zhaoyunfengntzx-maker/fpga-smr-encoder/deliverables/submission/photos/README.md

# 作品实物照片（报名系统第 6 / 7 项）

- **拍摄**：2026-11-03 20:02（Asia/Shanghai），手机直出；原图在仓库根目录 `照片/`。
- **处理**：按 EXIF 方向转正（`04` 原图为横向存储 + 方向标签 6，已转成 6048×8064 竖幅）、
  去除全部元数据（无 GPS / 机型 / 时间戳等）、JPEG 质量 90 重编码；四张均保留原分辨率，均 ≤ 10 MB。
- **匿名**：画面内无学校、院系、姓名、学号等信息；「正点原子 / ALIENTEK / HSEDA / NAN YA」
  为器件与开发板丝印，属技术描述。
- **用途**：报名系统第 6 项「作品全貌图（JPG/PNG，≤10 MB，×1）」、第 7 项
  「开发板重要角度照片（JPG/PNG，≤10 MB，≤4 张）」。

| 文件 | 拍的是什么 | 分辨率 | 大小 | 对应表单 | SHA-256 |
|---|---|---|---|---|---|
| `01_overview_full.jpg` | **作品全貌**：转台夹具（电机 + 联轴器 + SMR 传感头）、模拟前端与驱动板、AD9238 扩展板 + FPGA 板、7 英寸屏、示波器、上位机；桌面整体一景 | 8064×6048 | 7,222,120 B / 6.89 MB | 第 6 项 | `F6A81D40E63537F802C36E7D8EA9781AE0E28D6D3E759FB11FD3573F5005B7B9` |
| `02_board_adc_frontend.jpg` | **ADC / 模拟前端**：AD9238 双通道 12-bit 扩展板（SMA `CH1` / `CH2`、AD8130 差分放大、2.0 V 基准与去耦），叠插在 FPGA 板上，可见 `J6` 排针与 5 V 供电 | 4032×3024 | 2,346,047 B / 2.24 MB | 第 7 项 ① | `AC152A91AAE1D8A08DE3BFBF29F463F2F030487DF8F7769E14C130B4BBF6582F` |
| `03_board_front.jpg` | **FPGA 板正面**：「达芬奇_Lite」丝印、`RGB_LCD` 排线座、`J5` / `J6` 排针、`JTAG`、`USB_UART`、SD 卡座、以太网口（ATK91131A）、NAN YA DDR3 | 4032×3024 | 1,974,279 B / 1.88 MB | 第 7 项 ② | `C673B01C8EED0D9B58C3C8125B8E3833688FA4285391FB1B8CACD225A268D446` |
| `04_board_screen.jpg` | **屏与触摸**：7 英寸 1024×600 面板与板卡同框，屏上为 **P1 总览** 实时页面（读数见下） | 6048×8064 | 9,238,822 B / 8.81 MB | 第 7 项 ③ | `B5C65D8A6B158C1BF400CDA201EDA9C603385E8691513DD0F899C4A209F331EF` |

四张即第 7 项要求的全部角度（正面 / ADC 与模拟前端 / 屏与触摸），名额上限 4 张已满足，
不再补拍其他角度。

## 屏上读数（`04` 现场快照，P1 总览）

| 字段 | 读数 |
|---|---|
| 输入频率 | 22.30 kHz（正常） |
| 倍频分频 | ×64 ÷1（等效倍率，正常） |
| 转速 | 653.1 RPM（正常） |
| 角度 | −32.6 DEG |
| 方向 / 累计转数 | CCW / 3015 REV |
| ABZ / UVW 指示 | A 有效、B / Z 未点亮，状态正常 |
| POS | 0X 14DA25DA |

自洽性检查：22.30 kHz ÷ 2048（电周期/圈）× 60 = **653.3 RPM**，与屏上 653.1 RPM 相差 0.03%，
说明频率与转速出自同一路 sin/cos 计数，不是分别写死的数。

> 口径提醒：以上只是拍摄当天的**屏上快照**，用来证明照片是真实上电现场；报告里的转速指标
> 以 v90 的 Z 频率判据为准（**457–459 rpm**），既不引用旧版电周期折算读数，也不把这张照片的 653.1 RPM 当指标。

## 报告里怎么用

`deliverables/figures/` 下另有四张按报告版面缩放的同源图（`photo_overview.jpg`、
`photo_adc_frontend.jpg`、`photo_board_front.jpg`、`photo_screen_p1.jpg`），供
`design_report.docx/pdf` 正文 3.1 与 3.2.2 的照片引用；上传报名系统时用本目录的原分辨率版本。
