zhaoyunfengntzx-maker/fpga-smr-encoder/docs/27_turntable_requirements_feasibility.md

# 27 转台正余弦编码器信号处理 —— 需求整理与可行性分析

> 版本：**v1.2（2026-10-28）**，**S1 已完成（RTL 已改，仿真 29/29 + v63 实现通过）**，S2 起待你确认
> 工程基线：v63 位流 `_impl_v63/enc_top_v63.bit`（top = `enc_top`）；v62 交付位流保持不动可回退
> 标记约定：**【确认】**= 你原话；**【假设】**= 我根据工程现状推断，需你确认；**【待确认】**= 必须你给数

---

## 0. 一句话结论

**可行，而且路径比想象中短**：现有 v62 已经具备"12 bit 同步采样 → 六参数校正 → 16 bit 流水 CORDIC → PI 环路 → ABZ/UVW"的全链路，50 kHz 电气频率相对已验证的 700 kHz 带宽有 **14 倍余量**，算角度本身不是难点。

**真正的难点只有三个**，都不在"算角度"上：

1. **变频段的滤波一致性**——转速从 0 到最高，滤波器带宽若固定，相位滞后（以电角度计）会随转速剧烈变化，标定补偿全部失效；
2. **偏置/增益的长期漂移**——一次性标定在温升 20 ℃ 后会退化，尤其前端是"单端 0.5 Vpp → 放大 16 倍"这种小信号高增益结构；
3. **异常状态下的可控性**——上电静止、信号丢失、削顶、反转抖动、失锁，必须有明确状态机与输出策略，否则多圈计数会跑飞。

外加一个**反直觉但很关键**的结论（见 §4.5）：当 PPR=2048 时，机械 1″ 只对应电角度 0.57°，**FPGA 细分精度根本不是瓶颈**，传感器刻度误差与安装偏心才是。所以"做到完美"的投入应该压在**标定 + 鲁棒性**，而不是再加 CORDIC 位宽。

---

## 0.5 已确认参数基线（2026-10-27）

| 项 | 确认值 | 推论 |
|---|---|---|
| 传感器周期数 | **2048 周期/转** | 1 电周期 = 0.1758° 机械；16 bit 细分 = **0.0097″/LSB** |
| 传感器输出 | 每腿对地 **0.5 Vpp**，A/A− 差分共 **1 Vpp** | 与 EI58C9 文档口径一致（差分 = 每腿 ×2） |
| 放大模块 | 差分转单端，G = 8 → **8 Vpp 单端** | 8/1 = 8 倍差分增益；ADC 侧 1638 码 |
| 直流偏置 | **以 0 V 为中心，正负对称** | ✅ 最理想，无单侧削顶；但削顶余量仍只有 1.25× |
| 最高电气频率 | 50 kHz | = **1465.9 rpm**（50 k / 2048 × 60） |
| 最高转速 | 1000–3000 rpm | ⚠️ **3000 rpm 对应 102.4 kHz**，与"50 kHz"差 2 倍，见下 |
| 精度目标 | **±1″ 机械（峰峰值）** | 必须上全周补偿表 + 外部基准（见 §4.5） |
| 用途 | 闭环伺服反馈 **+** 上位机记录 | 双路输出：主路低延迟、旁路高精度 |

### ⚠️ 0.5.1 一处必须澄清的不自洽

2048 PPR 时：`f_el(Hz) = rpm × 2048 / 60`

| 转速 | 电气频率 | vs "50 kHz" |
|---|---|---|
| 1000 rpm | 34.1 kHz | — |
| **1465.9 rpm** | **50.0 kHz** | 你给出的上限对应的转速 |
| 3000 rpm | **102.4 kHz** | **超出 2 倍** |

**处理方式（建议，已按此设计）**：**按上限 100 kHz 设计**。代价为零——50 MSPS 下 102.4 kHz 仍有 **488 点/周期**，前端 700 kHz 带宽也放得下；收益是无论你实际是 1465 还是 3000 rpm 都不会翻车。唯一要改的是抽取档位上限（见 §4.2 A）与 ABZ 分频约束。

---

## 1. 现状盘点（这次适配的起点）

### 1.1 信号链

```
 传感器（待确认）
   A/A−  B/B−  每腿 0.5 Vpp?  差分 1 Vpp?
        │
        ▼
 差分转单端放大模块（你的板子）  G = 8 ?
        │  8 Vpp 单端、对地、中心 0 V?
        ▼
 HSEDA AD9238 模块：分压 ÷5 → AD8065 缓冲 → AD8138 单端转差分 → AD9238 12 bit
        │  输入量程 ±5 V（10 Vpp），1 LSB = 2.44 mV，无抗混叠滤波
        ▼
 FPGA：50 MSPS 同步采样 → 抽取(LOG2DEC=2) → sc_correct 六参数校正
        → cordic_atan2 (16 bit, NITER=17) → loop_filter(PI) → pole_counter
        → abz_gen / uvw_gen / uart_scope
```

### 1.2 现有能力（可直接复用）

| 项 | 现状 | 对本次任务的含义 |
|---|---|---|
| 采样 | 50 MSPS，双通道同一时钟 | 50 kHz 时 **1000 点/周期**，余量充足 |
| 输入带宽 | 已验证 1 kHz–500 kHz 扫频 | 50 kHz 只用了 1/14 带宽 |
| 角度 | 16 bit/电周期，CORDIC max 0.94 LSB | 机械分辨率 = 360°/(65536·PPR) |
| 校正 | 六参数闭式（偏置×2、增益×2、正交、旋转） | 20.98° → 0.0165°（模型） |
| 环路 | PI，kp/ki 寄存器可调，21 组全稳定 | 可做增益调度 |
| 输出 | ABZ / UVW / SPI / UART / 以太网 | 转台一般要 ABZ 或差分增量 |
| 延迟 | ≈830 ns（预算值） | 伺服反馈完全够 |
| 资源 | LUT 82.0%、BRAM 46/50、DSP 18 | **BRAM 几乎见底**，加 LUT 要腾地方 |

### 1.3 这次"新"在哪里

| 维度 | 之前（信号源/磁环） | 现在（转台） | 影响 |
|---|---|---|---|
| 信号源 | AFG-2225 双通道，幅度稳定 | 真实传感器，随温漂/转速变化 | 标定不能一次了事 |
| 频率 | 手动设定 | 0…50 kHz 连续变化，还有波动 | 滤波器必须自适应 |
| 幅度 | 可调到 10 Vpp | 固定 8 Vpp 左右，有波动 | 只剩 25% 削顶余量 |
| 极性/相位 | 理想 90° | 有正交误差、谐波、偏置 | 需要更细的误差模型 |
| 机械 | 无 | 偏心、振动、PWM 干扰 | 需要状态机与故障诊断 |

---

## 2. 需求整理

### 2.1 功能需求（FR）

| 编号 | 需求 | 来源 | 现状 |
|---|---|---|---|
| FR-01 | 采集 sin/cos 正交信号并解算单周期内电角度 | 【确认】 | 已有 |
| FR-02 | 偏置补偿、幅值均衡、正交误差校正 | 【确认】 | 已有（六参数） |
| FR-03 | 抑制信号非线性误差（谐波） | 【确认】 | **缺**（六参数只到 2 次谐波） |
| FR-04 | 流水线 CORDIC 相位解算 | 【确认】 | 已有 |
| FR-05 | 粗精角度融合（周期计数 + 周期内角度） | 【确认】 | 已有（pole_counter + CORDIC） |
| FR-06 | 辨向计数、多圈累计 | 【确认】 | 已有（16 bit） |
| FR-07 | 位置、速度实时输出 | 【确认】 | 位置有；**低速速度需补** |
| FR-08 | 数字滤波，适应频率波动 | 【确认】 | **固定抽取，需改自适应** |
| FR-09 | 上电自检、信号丢失/削顶/失锁诊断 | 推断【假设】 | 部分（amp_monitor/OTR） |
| FR-10 | 参数在线配置与掉电保存 | 推断【假设】 | 寄存器有，掉电保存无 |
| FR-11 | 绝对零点（Z 索引）与 PPR 自适应 | 推断【假设】 | **Z 未接**，虚拟 Z |
| FR-12 | 与上位机/驱动器的实时接口 | 【确认】 | ABZ / SPI / 以太网已有 |

### 2.2 性能需求（PR）——**空缺项必须你给数**

| 编号 | 指标 | 目标值 | 状态 |
|---|---|---|---|
| PR-01 | 传感器周期数 PPR | **2048 周期/转** | ✅ 确认 |
| PR-02 | 最高电气频率 / 转速 | **按 100 kHz 设计**（1465 rpm 对应 50 kHz，3000 rpm 对应 102.4 kHz） | ✅ 确认，按严者设计 |
| PR-03 | 最低平稳转速 | ? rpm 或 ? °/s | **TBD** |
| PR-04 | 角度分辨率（机械） | 16 bit × 2048 = **131072 点/转 = 0.0097″/LSB** | ✅ 可算 |
| PR-05 | 角度精度（机械，峰峰值） | **±1″** | ✅ 确认（关键目标） |
| PR-06 | 速度分辨率 / 带宽 | 闭环带宽 ? Hz，低速纹波 ? | **TBD** |
| PR-07 | 位置更新率 / 延迟 | SPI 读位置 ≥50 kHz 帧率；延迟 ≤1.5 µs | 推断 |
| PR-08 | 幅值波动范围 | 8 Vpp ±? %（**决定削顶余量**） | **TBD，优先测** |
| PR-09 | 工作温度 | ? ℃ | **TBD** |
| PR-10 | 连续运行稳定性 | ? h 无失锁、无多圈跳变 | **TBD** |

> **PR-05 = ±1″ 已确认**，这是"必须上补偿表"的判据。但请先读 §4.5 的结论：**±1″ 的瓶颈不在 FPGA，而在"有没有 ±0.5″ 级的标定基准"**。

### 2.3 接口需求（IR）

| 编号 | 需求 | 说明 |
|---|---|---|
| IR-01 | 位置输出协议 | ABZ（推荐）/ SPI 寄存器回读 / 自定义 |
| IR-02 | 速度输出 | 同一协议内，或独立模拟/总线 |
| IR-03 | 配置接口 | SPI / UART（现有） |
| IR-04 | 调试观测 | UART 遥测、以太网抓包（现有） |
| IR-05 | 与伺服驱动器的电气接口 | RS-422/485 收发器？光耦？**TBD** |

### 2.4 环境与可靠性（ER）

| 编号 | 需求 | 说明 |
|---|---|---|
| ER-01 | 电机 PWM 干扰抑制 | 差分走线、屏蔽、模拟 LPF、必要时同步采样 |
| ER-02 | 上电/掉电/热插拔 | 输出保持或安全态，多圈计数不跑飞 |
| ER-03 | 断线/短路检测 | 幅值窗口 + 偏置窗口 |
| ER-04 | 温漂 | 偏置/增益后台跟踪 |
| ER-05 | EMC | 前端共模扼流、单点接地 |

### 2.5 约束与假设

| 编号 | 内容 |
|---|---|
| AS-01 | 【假设】传感器为增量式正余弦编码器，A/A−、B/B− 差分，每腿 0.5 Vpp，差分 1 Vpp |
| AS-02 | 【假设】PPR = 2048（沿用 EI58C9 的接入经验；若不同，全部数字按比例缩放） |
| AS-03 | 【假设】"8 Vpp"是放大模块输出、对地、以 0 V 为中心（**待确认，这是最大风险点**） |
| AS-04 | 【假设】继续用 AD9238 模块（±5 V 单端输入、无 AAF），不换硬件 |
| AS-05 | 【假设】FPGA 仍为 XC7A35T，50 MHz 单时钟，不改时钟架构 |
| AS-06 | 【假设】转台需要"位置 + 速度"给伺服或上位机，且要能长期连续运行 |

---

## 3. 信号链预算（把"能不能"算清楚）

### 3.1 电平与码值

| 项 | 数值 | 说明 |
|---|---|---|
| ADC 满量程 | ±5 V 单端（10 Vpp） | 模块分压 ÷5 后进 AD8065 |
| 输入 8 Vpp | ±4 V | 占满量程 **80%** |
| 峰值码值 | 4 V / 2.44 mV = **1638 码** | 理论 ±2048 |
| 码值动态范围 | 20·log10(1638/0.289) ≈ **72 dB** | 等效 ~11.7 bit |
| 削顶余量 | 10/8 = **1.25×（+1.9 dB）** | 幅值涨 25% 就削顶 |
| 建议 | 7.0–8.0 Vpp，且必须实测 DC 偏置 | 见风险 R1 |

### 3.2 频率与采样

| 电气频率 | 每周期采样点（50 MSPS） | 抽取 4 后 | 每点电角度 |
|---|---|---|---|
| 1 kHz | 50,000 | 12,500 | 0.0072° |
| 10 kHz | 5,000 | 1,250 | 0.072° |
| 50 kHz | **1,000** | **250** | **0.36°** |

50 kHz 时仍有 250 点/周期，**采样不是瓶颈**。瓶颈在 ABZ 边沿率：`4×inter×f_in ≤ 12.5 MHz` ⇒ 50 kHz 时 `inter ≤ 32`；若走寄存器/遥测读 16 bit 角度，则不受此限。

### 3.3 电气角度 → 机械角度（**全篇最重要的换算**）

$$\varepsilon_{mech}(″) = \frac{\varepsilon_{el}(°) \times 3600}{PPR}$$

| PPR | 1″ 机械对应的电角度 | 0.1° 电角度对应的机械误差 |
|---|---|---|
| 1024 | 1.14° | 0.35″ |
| 2048 | **0.57°** | **0.18″** |
| 4096 | 0.28° | 0.09″ |
| 2500 | 0.47° | 0.14″ |

**含义**：PPR 越高，对"电角度精度"的要求越松。2048 时，电角度做到 0.5° 就够 1″ 机械精度——而当前 CORDIC 是 0.005° 级，**过剩 100 倍**。

### 3.4 延迟预算（50 kHz 时 1 µs = 18° 电角度）

| 环节 | 延迟 |
|---|---|
| ADC 采样 + 捕获 | 1–2 拍（40 ns） |
| 抽取（N=4…64） | 2…64 拍（40 ns…1.28 µs） |
| 校正 | 3 拍（60 ns） |
| CORDIC | 17 拍（340 ns） |
| 环路 + 输出 | ~5 拍（100 ns） |
| **合计** | **≈0.6–1.8 µs** |

对 100 Hz 伺服带宽，1.8 µs 相移 0.065°，可忽略；对位置精度，可用测速值做 `ω·τ` 前馈补偿。

---

## 4. 可行性分析

### 4.1 总判断

| 维度 | 判断 | 依据 |
|---|---|---|
| 采样与算力 | ✅ **富余** | 50 kHz vs 700 kHz 已验证带宽；CORDIC 吞吐 1 点/拍 |
| 电平接口 | ⚠️ **可行但余量小** | 8 Vpp/10 Vpp = 80%，削顶余量仅 25% |
| 细分精度 | ✅ **过剩** | 见 §3.3，机械精度不由细分决定 |
| 变频适应 | ⚠️ **需新增** | 现有抽取固定，环路增益固定 |
| 长期精度 | ⚠️ **需新增** | 一次性标定无法跟踪温漂 |
| 异常处理 | ⚠️ **需新增** | 缺统一状态机 |
| 资源 | ⚠️ **紧** | BRAM 46/50，LUT 82% |
| 工期 | ⚠️ **紧** | 若赶 11-04，只能做最小闭环 |

**结论：技术路线成立，风险集中在"模拟前端余量"与"自适应/诊断逻辑的新增工作量"，不在算法本身。**

### 4.2 六个关键难点与对策

#### A. 变频段的滤波一致性（最难，也最容易被忽略）

**机理**：固定带宽 LPF 的群延迟 τ 是常数（秒）。角度误差 = ω·τ，随转速线性增大；同时噪声抑制随频率变化。结果是"低速很干净但高速滞后 18°，或高速跟得上但低速噪声大"。

**对策（三层，按代价从低到高）**：

1. **归一化抽取**：让每周期采样点数近似恒定，`N = clamp(round(fs/(K·f_est)), 4, 64)`，K≈64–128。箱形平均对 sin/cos 同相，不引入正交误差，只引入与 N 成正比的群延迟（可测、可补偿）。代价：N 切换瞬间有相位台阶，需在过零/匀速段切换或做交叉淡化。
2. **环路增益调度**：`kp/ki` 随 |速度| 分段切换（低速重滤、高速轻滤），保持"电角度滞后"恒定。现成寄存器就能做，代价最小。
3. **速度前馈补偿**：用测速值把 `ω·τ` 从输出角度里减掉，等价于零延迟。需要准确 τ（可标定）。

> 推荐组合：**1（粗调，4/8/16 三档）+ 2（细调）+ 3（补偿）**，不要一上来做分数延迟重采样。

#### B. 偏置/增益漂移

**机理**：0.5 Vpp/腿 的小信号被放大 16 倍，前端偏置漂移被同倍放大。偏置 d（相对幅度）造成的角度误差 ≈ d rad。d=1% ⇒ 0.57° 电角度 ⇒ 2048 PPR 时 1.0″ 机械。温升 20 ℃ 漂 10 mV（相对 0.25 V 幅度 = 4%）⇒ 4″，**足以吃掉全部精度预算**。

**对策**：
- 上电/停机时自动重标定（现有 calib_ctrl 已支持一键标定，扩展为"条件触发"）；
- 运行中**只跟踪偏置**（2 参数 LMS，时间常数 5–30 s），增益/正交保持标定值；
- 加速段、过零段冻结自适应，避免把"真实运动"学成"偏置"；
- 用 `amp_monitor` + OTR 做"标定有效性"看门狗：幅值/偏置超窗 ⇒ 标定失效标志。

#### C. 正交/增益/谐波误差

- 正交与增益失配：六参数已覆盖（2 次谐波），残差 <0.1″（2048 PPR）。
- **3/5/7 次谐波**：来自传感器磁场谐波与探测器非线性，六参数**无法**消除，表现为 4/6/8 次/转的周期性误差，典型 0.1–1° 电角度 ⇒ 0.2–2″ 机械。
- 对策：**角度域误差补偿表**（LUT）。1024 点 × 16 bit 只需 ~16 Kb，可放分布式 RAM（约 256 LUT），不必抢 BRAM；标定需要一个外部基准（见 R6）。

#### D. 低速测速

**机理**：16 bit 角度在 2048 PPR 下，1 LSB = 0.0097″ 机械。10 kHz 更新时，1 LSB/帧 = 0.097″/10 ms = **9.7″/s**——低速时速度量化粗到不可用。

**对策**：M/T 法（测周期 + 测脉冲数）+ 长窗口 + 与环路速度融合；明确"最低平稳转速"指标（PR-03），低于该转速只保证位置不保证速度纹波。

#### E. 启动 / 失锁 / 故障

必须新增**统一状态机**：

```
POR → 自检 → 搜索（等幅值有效） → 捕获（等相位锁定） → 跟踪
                                   ↑                    │
                                   └── 失锁 ←───────────┘
                                          ↓
                                    故障（幅值/削顶/超速/正交异常）
```

要点：
- 静止时 sin/cos 是直流，atan2 仍有输出但无意义 ⇒ **必须用幅值门限判定"信号有效"**，无效时输出保持 + 有效位=0；
- 多圈计数只在"跟踪"态累加，故障态冻结；
- 反转过零附近加迟滞，避免抖动计数（abz_gen 已有滞后逻辑，需推广到 pole_counter）。

#### F. PWM 干扰与模拟前端

- 模块**没有抗混叠滤波器**，电机 PWM（8–20 kHz）及其谐波直接进 ADC；
- 对策：前端加二阶 RC/有源 LPF（截止 200–300 kHz，不影响 50 kHz 基波）、双绞屏蔽、单点接地；数字侧可在 PWM 频率做陷波，但 PWM 频率若可变则不牢靠——**优先在模拟侧解决**；
- 若驱动器能给出 PWM 同步信号，可用"PWM 中心对齐采样"把开关噪声搬到采样零点，这是最彻底的办法（需硬件引入同步信号）。

### 4.3 模块级适配清单

| 模块 | 现状 | 需要做的改动 | 工作量 | 风险 |
|---|---|---|---|---|
| `rtl/ad9238_capture.v` | 50 MSPS 捕获 | 不改 | — | 低 |
| `rtl/decim_avg.v` | 固定 LOG2DEC | 增加运行时可变 N + 平滑切换 | 中 | 中 |
| `rtl/sc_correct.v` | 六参数 | 参数可在线更新；加偏置慢跟踪 | 中 | 中 |
| `rtl/calib_ctrl.v` | 一次性闭式标定 | 条件触发/周期重标定；失败重试与有效性判据 | 中 | 中 |
| `rtl/cordic_atan2.v` | 16 bit，0.94 LSB | 不改 | — | 低 |
| `rtl/loop_filter.v` | 固定 kp/ki | 增益调度（按速度分段） | 低 | 低 |
| 新增 `freq_est` | 无 | 由角度增量估计电频率（供抽取/调度） | 低 | 低 |
| 新增 `angle_lut` | 无 | 1024 点谐波补偿表 + 线性插值 | 中 | 中 |
| 新增 `lock_fsm` | 分散 | 统一状态机 + 有效位 + 输出保持 | 中 | 中 |
| `rtl/pole_counter.v` | 16 bit 多圈 | 接真实 Z；PPR 自适应；Z 一致性校验 | 中 | 中 |
| `rtl/abz_gen.v` | inter 2…256 | 高转速时自动限 inter | 低 | 低 |
| `rtl/uvw_gen.v` | 参数化 | 转台无 UVW 需求则关闭 | 低 | 低 |
| `rtl/reg_file.v` | 寄存器表 | 新增 ~12 个寄存器（频率、状态、门限、LUT 指针） | 低 | 低 |
| `rtl/enc_top.v` | 顶层 | 连线 + 参数（POLE_BITS=11） | 低 | 低 |
| `model/golden_model.py` | 定点模型 | 加变频/漂移/谐波场景，先验后改 RTL | 中 | 低 |

> 关键原则：**先在 `model/` 里把新算法跑通并给出误差数字，再动 RTL**。这是本工程一直有效的方法。

### 4.4 资源可行性

| 资源 | 现状 | 新增需求 | 结论 |
|---|---|---|---|
| LUT | 82.0% | 频率估计 + 状态机 + LUT 插值 ≈ +800 LUT | **需腾 3–4%** |
| BRAM | 46/50 | 补偿表若用 BRAM 需 +2 | **不够**，改用分布式 RAM |
| DSP | 18/90 | 偏置跟踪 1–2 个 | 够 |
| FF | 26.9% | +600 | 够 |

腾资源的候选：缩减抓包深度、减少 UI 页缓存、把 1024 点表放 LUTRAM。**这是排期里必须预留的一天。**

### 4.5 精度可行性（误差预算，PPR=2048）

| 误差源 | 电角度 | 机械角（″） | 能否靠 FPGA 消除 |
|---|---|---|---|
| ADC 量化（8 Vpp，4 倍平均） | 0.005° | **0.009** | — |
| 偏置残差 0.1% | 0.057° | **0.10** | ✅ 标定 |
| 增益失配 1% | 0.29° | **0.50** | ✅ 标定 |
| 正交误差 0.1° | 0.05° | **0.09** | ✅ 标定 |
| 3 次谐波 0.1% | 0.06° | **0.10** | ✅ LUT |
| CORDIC | 0.005° | 0.009 | — |
| **传感器刻度误差** | — | **±10…±40** | ❌ 需外部基准标定 |
| **安装偏心 10 µm @ R50** | — | **≈41** | ❌ 机械/软件偏心补偿 |

**结论（针对已确认的 ±1″）**：

1. **FPGA 内部算法误差合计 <0.3″**（量化 0.02 + 校正残差 0.2 + 谐波残差 0.1，方和根 <0.25″），对 ±1″ 目标有 **4 倍以上余量**——细分、CORDIC、六参数校正**都已经过剩**，不要再加位宽。
2. **瓶颈是传感器本体**：刻线误差 ±10…40″ + 安装偏心（10 µm @ R50 ≈ 41″），合计可达 **50″**，是目标的 50 倍。
3. 但这两个误差都是**角度上的确定性函数**（同一位置每次都一样），因此可以被 **全周 LUT 吸收**。吸收后的残差 = 误差的**重复性**（插值噪声、温漂，典型 **1–3″**）+ **标定基准自身的精度**。
4. 所以 ±1″ 的可行性等价于三个条件：
   - 有 **±0.5″ 级基准**（高精度转台 / 自准直仪 + 多面棱体 / 多读数头平均）；
   - **偏心稳定**（同轴度、温升后不漂）；
   - 补偿表覆盖**全周 2^N 点**（2048 周期 × 每周期 ≥16 点 ⇒ 建议 32768 点，或用"每周期 16 点 + 周期序号偏移"的简化结构）。

> **直白地说**：代码侧做到 ±1″ 是**可实现的**，但如果拿不到好基准、或传感器偏心随温漂变化，实际只能到 **±3…5″**。这不是算法问题，是测量学问题。**建议同时准备一个 ±5″ 的可交付版本**，把 ±1″ 作为"有基准时的增强模式"。

---

## 5. 建议架构（分层，便于"广泛适应"）

```
┌────────────────────────── 模拟域（不可改的部分） ──────────────────────────┐
│ 传感器 → 差分放大(G) → [可选 LPF] → AD9238 模块(÷5, 单端转差分) → ADC     │
└───────────────────────────────────┬───────────────────────────────────────┘
                                    │ 50 MSPS × 2ch
┌───────────────────────────────────▼───────────────────────────────────────┐
│ ① 采集与同步     ad9238_capture（同一时钟，两通道零偏斜）                   │
│ ② 自适应抽取     decim_avg，N = f(f_est)，4/8/16/32/64                     │
│ ③ 校正           sc_correct（六参数，可在线更新） + angle_lut（谐波）       │
│ ④ 解算           cordic_atan2（16 bit 流水）                                │
│ ⑤ 融合           pole_counter（粗：周期/多圈） ⊕ CORDIC（精）→ 绝对角       │
│ ⑥ 跟踪           loop_filter（增益调度）+ freq_est（频率/加速度）           │
│ ⑦ 测速           M/T + 环路速度融合                                         │
│ ⑧ 状态与诊断     lock_fsm + amp_monitor + OTR + 正交/超速/断线              │
│ ⑨ 输出           abz_gen / uvw_gen / uart_scope / 以太网                    │
│ ⑩ 标定           calib_ctrl（上电 + 条件触发）+ 偏置慢跟踪                  │
└───────────────────────────────────────────────────────────────────────────┘
```

"广泛适应性"落在三处：**参数化**（PPR/位宽/增益/门限全寄存器化）、**自适应**（抽取/环路/偏置）、**可诊断**（状态机 + 遥测）。

---

## 6. 分阶段路线（含验收判据）

| 阶段 | 内容 | 产出/验收 | 估时 |
|---|---|---|---|
| **P0 测量与冻结** | 示波器测 8 Vpp 波形：DC 偏置、THD、噪声、正交偏差、PWM 干扰谱；确认 PPR/转速/精度 | 一张"信号体检表" + 需求基线 v1.0 | 1–2 d |
| **P1 参数化变体** | POLE_BITS=11、ABZ inter=2、UVW 关；信号源 50 kHz 验证 | 角度单调、ABZ 边沿率符合预期 | 1 d |
| **P2 自适应前端** | freq_est + 抽取自适应 + 环路调度 | 1 kHz…50 kHz 扫频，角度误差 <0.5° 电角度 | 2–3 d |
| **P3 标定与漂移** | 条件重标定 + 偏置慢跟踪 + 有效性看门狗 | 温升 20 ℃ 后 1 h 漂移 <2″ | 3–5 d |
| **P4 状态机与故障** | lock_fsm、输出保持、断线/削顶/超速 | 拔线/堵转/反转不跑飞 | 2 d |
| **P5 低速测速** | M/T + 融合 | 最低转速下速度纹波达标 | 2 d |
| **P6 基准标定** | 补偿表 + 外部基准比对 | 全周误差 ≤ 目标 | 3–5 d |

> 若这是 **11-04 参赛作品**的"真实传感头"环节：建议只做 **P0 + P1 + P2 + P4 的核心部分**（约 5–6 天），P3/P5/P6 放到赛后。**不要为了加补偿表去动已经收敛的 v62 布局**——风险收益不划算。

---

## 7. 风险登记

| # | 风险 | 概率 | 影响 | 缓解 |
|---|---|---|---|---|
| R1 | 8 Vpp 直流偏置不为 0，正峰削顶 | **高** | 高 | 先测 DC 电平；必要时隔直或降增益至 7 Vpp |
| R2 | 前端无 AAF，PWM 噪声混叠 | 中 | 中 | 加二阶 LPF + 屏蔽；必要时 PWM 同步采样 |
| R3 | 变频导致相位滞后随速变化 | **高** | 高 | 归一化抽取 + 增益调度 + 前馈补偿 |
| R4 | 偏置温漂吃掉精度 | **高** | 高 | 后台偏置跟踪 + 条件重标定 |
| R5 | BRAM/LUT 不够 | 中 | 中 | 补偿表用分布式 RAM；缩抓包深度 |
| R6 | 缺高精度基准，无法验证 ±1″ | **高** | 高 | 借高精度转台/自准直仪/多读数头比对 |
| R7 | 低速测速分辨率物理受限 | 中 | 中 | M/T + 长窗口；明确最低速指标 |
| R8 | Z 未接，无绝对零点/PPR 自适应 | 中 | 中 | 接真实 Z，加去抖与一致性校验 |
| R9 | 极性/相位接反 | 低 | 中 | 上电自检 + 方向自动判别 |
| R10 | 地环路/共模干扰 | 中 | 中 | 单点接地、共模扼流、差分走线 |

---

## 8. 待确认问题

### 8.1 必须回答（决定方案形态）

| # | 问题 | 为什么关键 |
|---|---|---|
| Q1 | 传感器是什么？周期数 PPR = ? | 决定 Z 间隔、ABZ 分频、误差换算 |
| Q2 | "0.5 Vpp 对地单端"是**每腿**还是**单路**？差分还是单端输出？ | 决定增益、共模抑制、噪声模型 |
| Q3 | 8 Vpp 的**直流偏置**是多少？放大模块供电 ±? V？ | 决定会不会削顶（R1） |
| Q4 | 角度精度目标（机械，″）？ | 决定要不要补偿表（§4.5） |
| Q5 | 最高/最低转速？50 kHz 对应多少 rpm？ | 决定抽取档位与测速方案 |
| Q6 | 用途：伺服闭环反馈，还是仅测量/显示？ | 决定延迟、更新率、接口 |

### 8.2 次要但需要

| # | 问题 |
|---|---|
| Q7 | 幅值波动范围（±? %），频率波动范围（±? %）？ |
| Q8 | 电机驱动器 PWM 频率？有无同步信号可取？ |
| Q9 | 传感器到 FPGA 的线缆长度、是否屏蔽双绞？ |
| Q10 | 是否要求断电后保持绝对位置（多圈）？ |
| Q11 | 输出接口最终要哪种（ABZ / 模拟 / 总线）？ |
| Q12 | 工作温度范围、连续运行时长要求？ |
| Q13 | 是否有高精度基准（自准直仪、激光干涉、高精度转台）可做比对？ |
| Q14 | Z 信号是否可用？是否已接线？ |
| Q15 | 是否允许改模拟前端（加 LPF、改增益电阻）？ |
| Q16 | 项目节点：是否赶 11-04？还是独立项目？ |
| Q17 | 是否需要多轴同步（同片多路）？ |
| Q18 | 上位机是否要新增"信号质量/诊断"页面？ |
| Q19 | 现有 v62 位流是否必须保持可回退？ |
| Q20 | 传感器安装偏心/同轴度目前大概多少？ |

---

## 9. 附录：关键公式

**六参数校正**（对应 `rtl/sc_correct.v`）：

```
s1 = s − O_s
c1 = c − O_c
c2 = c1 − (s1·k_φ) >> 15          // 正交校正
s2 = (s1·K_s) >> (15 − sh_s)      // 增益均衡
c3 = (c2·K_c) >> (15 − sh_c)
θ  = atan2(s2, c3)
```

**误差灵敏度**（小误差线性化，ε 为相对幅度）：

| 误差 | 角度误差（rad） |
|---|---|
| 偏置 d | ≈ d |
| 增益失配 ε | ≈ ε/2 |
| 正交 φ | ≈ φ/2 |
| n 次谐波 h_n | ≈ h_n（在 nθ 频率上） |

**机械/电气换算**：`ε_mech(″) = ε_el(°)·3600/PPR`

**ABZ 限频**：`4·inter·f_in ≤ 12.5 MHz`

**环路**：`ω_n = √Ki·fs`，`ζ = (Kp+Ki)/(2√Ki)`，`f₋₃dB ≈ 2.2 MHz`（kp=0/ki=3）

---

## 10. 执行计划 v1（确认基线后按此顺序，每步可回退）

> 原则不变：**先改 `model/` 拿到误差数字，再动 RTL**；每步都保留旧位流。

| 步骤 | 谁做 | 内容 | 验收判据 | 估时 |
|---|---|---|---|---|
| **S0 硬件体检** | **你** | 示波器测 8 Vpp：实际峰峰值、直流电平、THD、噪声底、正交相位差、PWM 干扰谱；记录**单圈内幅值最大/最小值**（反映偏心） | 一张体检表；确认幅值波动 % | 0.5 d |
| **S1 参数化变体** | 我 | `POLE_BITS` 6→11、ABZ `inter=2`、UVW 关、`LOG2DEC` 上限提到 5 | 信号源 50 kHz / 100 kHz 下角度单调，ABZ 边沿率符合预期，仿真回归 36/36 PASS | 1 d |
| **S2 频率估计 + 自适应抽取** | 我 | 新增 `freq_est`（由角度增量）+ `decim_avg` 运行时可换 N（4/8/16/32，平滑切换） | 1 kHz…100 kHz 扫频，角度误差 <0.5° 电角度，无切换台阶 | 2–3 d |
| **S3 状态机 + 诊断** | 我 | `lock_fsm`（POR/自检/搜索/捕获/跟踪/失锁/故障）+ 输出保持 + 有效位 | 拔线、堵转、反转、上电静止：多圈计数不跑飞 | 2 d |
| **S4 偏置慢跟踪 + 条件重标定** | 我 | 2 参数 LMS（仅偏置），加速/过零冻结；幅值窗口触发重标定 | 温升 20 ℃ 后 1 h，零点漂移 <2″ | 2–3 d |
| **S5 全周补偿表** | 我 + **你** | 32768 点角度域 LUT（分布式 RAM）+ 线性插值 + 标定工具；需要基准 | 全周误差 ≤±1″（有基准）/ ≤±5″（无基准） | 2 d + 标定 2 d |
| **S6 双路输出** | 我 | 主路：ABZ 低延迟；旁路：UDP 高精度记录（含幅值/温度/状态） | 两路角度一致，时间戳对齐 | 1 d |

**合计 ≈ 12–14 天**（含你的体检与标定时间）。

### 10.1 若目标是 11-04 参赛作品

**最小闭环 = S0 + S1 + S2 核心 + S3 核心**（约 5–6 天），产出"真实传感器接入、变频自适应、故障不跑飞"的可演示版本；S4/S5/S6 赛后做。

**不要**在赛前动已收敛的 v62 布局去做 32768 点 LUT——风险收益不划算（LUT 已 82%，BRAM 46/50）。

### 10.2 我需要你提供的（按优先级）

1. **S0 体检数据**（尤其幅值波动 %、THD、单圈幅值变化）—— 决定会不会削顶、要不要重标定；
2. **转速到底是 1465 还是 3000 rpm** —— 决定 S2 的档位上限；
3. **有没有 ±0.5″ 级基准** —— 决定 ±1″ 是否可达，这是整个项目的头号风险（R6）；
4. 传感器**型号/铭牌**（确认是否 EI58C9，或同类的 2048 ppr 产品）；
5. 放大模块**供电电压**与实测直流偏置（即使你说 0 V 对称，也建议实测确认）。

---

## 11. 剩余待确认（不阻塞 S1/S2，但影响 S3–S6）

| # | 问题 | 影响 |
|---|---|---|
| Q7 | 幅值波动 ±? %、频率波动 ±? % | 抽取档位与门限 |
| Q8 | 驱动器 PWM 频率？能否取同步信号？ | 是否做 PWM 同步采样（最彻底） |
| Q9 | 传感器→FPGA 线缆长度、是否屏蔽双绞 | 噪声与共模 |
| Q10 | 是否要求断电保持绝对位置（多圈） | 多圈存储方案 |
| Q11 | 最终输出接口（ABZ / 模拟 / 总线） | 输出模块 |
| Q12 | 工作温度与连续运行时长 | 温漂与可靠性测试 |
| Q13 | 最低平稳转速 | 测速方案（M/T） |
| Q14 | Z 信号是否可用、是否已接线 | 绝对零点、PPR 自适应 |
| Q15 | 是否允许改模拟前端（加 LPF / 改增益） | R1/R2 的缓解手段 |
| Q16 | 是否赶 11-04 | 决定做 S4–S6 还是最小闭环 |
| Q17 | 是否多轴同步 | 资源与时钟 |
| Q18 | 是否要"信号质量/诊断"页面 | 上位机工作量 |
| Q19 | v62 位流是否必须可回退 | 交付方式 |
| Q20 | 安装偏心/同轴度实测值 | ±1″ 是否可达 |

---

---

## 12. v1.1 扩展：高转速兼容 与 高精度阶梯（2026-10-27 补充确认）

你补充了两条：**① 最高转速要留更大余量、广泛兼容；② 精度越高越好，要体现技术水平。** 本节把这两条落成可执行的指标。

### 12.1 速度天花板在哪：200 kHz 是这套硬件的物理上限

传感器 EI58 的响应频率是 **200 kHz**，机械极限 **5000 rpm**；两者在 2048 PPR 下正好对应：

| 转速 | 电气频率 | 备注 |
|---|---|---|
| 1465.9 rpm | 50 kHz | 你最初给的上限 |
| 3000 rpm | 102.4 kHz | |
| 5000 rpm | **170.7 kHz** | EI58 机械极限 |
| 5859 rpm | **200 kHz** | EI58 响应极限 |

**决策：程序按 200 kHz 电气频率设计**（= 5859 rpm）。理由：
- 覆盖 EI58 全部可用转速（5000 rpm）并留 **17% 余量**；
- 50 MSPS 下 200 kHz 仍有 **250 点/周期**，完全够；
- 前端 700 kHz 带宽还有 3.5 倍余量，**不改任何硬件**；
- 超过 200 kHz 时瓶颈变成传感器本身（幅值衰减、相位滞后），FPGA 再快也没用——所以这是"广泛兼容"的**合理边界**，不是偷懒。

### 12.2 转速 × PPR 兼容矩阵（PPR=2048，50 MSPS）

| rpm | f_el | 原始点/周期 | 抽取 N | 抽取后点/周期 | ABZ 边沿率 |
|---|---|---|---|---|---|
| 1 | 34 Hz | 1.47 M | 64 | 23 k | 68 Hz |
| 10 | 341 Hz | 147 k | 64 | 2.3 k | 683 Hz |
| 100 | 3.41 kHz | 14.7 k | 32 | 458 | 6.8 kHz |
| 500 | 17.1 kHz | 2930 | 8 | 366 | 34 kHz |
| 1000 | 34.1 kHz | 1465 | 4 | 366 | 68 kHz |
| 1500 | 51.2 kHz | 977 | 2 | 488 | 102 kHz |
| 3000 | 102.4 kHz | 488 | 1 | 488 | 205 kHz |
| 5000 | 170.7 kHz | 293 | 1 | 293 | 341 kHz |
| 5859 | 200 kHz | 250 | 1 | 250 | **400 kHz** |

结论：**ABZ 边沿率全程 ≤400 kHz，远低于 12.5 MHz 上限**；走寄存器/遥测读位置则不受边沿率限制。**全速段没有任何结构性障碍。**

### 12.3 抽取档位：让"电角度滞后"恒定，而不是让带宽恒定

箱形平均的群延迟 τ = N/(2·fs)，电角度滞后 = 360°·f·τ。若 N 固定，滞后随转速线性增长（低速 0.3°、高速 18°），标定补偿全部失效。

**设计规则：N 随 f 反比变化，使滞后恒定在 0.3–0.7° 电角度**：

| 电气频率 | N | 电角度滞后 |
|---|---|---|
| ≤1.5 kHz | 64 | 0.35° |
| 1.5–3 kHz | 32 | 0.35°–0.69° |
| 3–6 kHz | 16 | 0.35°–0.69° |
| 6–12 kHz | 8 | 0.35°–0.69° |
| 12–25 kHz | 4 | 0.35°–0.72° |
| 25–50 kHz | 2 | 0.36°–0.72° |
| >50 kHz | 1 | 0.36°–1.44° |

再叠加 **ω·τ 前馈补偿**后，残差 <0.1″ 机械。**这是"变频适应"的核心，也是它区别于普通编码器接口的地方。**

### 12.4 精度阶梯：把"含金量"分成可验收的四档

| 档位 | 可达精度 | 需要什么 | 难点 |
|---|---|---|---|
| **A 基础** | ±30″ | 六参数校正 + 良好装配 | 无 |
| **B 标准** | ±5″ | 上电标定 + 偏置慢跟踪 + 温补 | 温漂模型 |
| **C 高精度** | **±1″** | 全周 32768 点 LUT + **±0.5″ 基准** | **基准是唯一门槛** |
| **D 极限** | ±0.5″ | 双读数头（180°对置）消除偏心 | **要改硬件** |

**C 档的物理依据**：EI58 单读数头的刻线+插值误差约 ±10…40″，是确定性函数，LUT 可吸收到"重复性"（1–3″）；再叠加基准误差，落在 ±1″ 是合理的。

**D 档不做**（需第二个读数头和机械改造），但可以在文档里作为"下一步"写出来——这本身就是技术水平的体现。

### 12.5 可写进验收报告的硬指标（"含金量"清单）

| # | 指标 | 目标 | 测量方法 |
|---|---|---|---|
| 1 | 全周误差（峰峰） | **≤±1″** | 基准比对，每 1° 一点，画曲线 |
| 2 | 重复性（同位置 100 次） | ≤0.5″ | 静止重复定位 |
| 3 | 温漂（20→45 ℃） | ≤1″ | 温箱 + 基准 |
| 4 | 全速段一致性 | 0.1–5000 rpm 角度误差差异 ≤0.2″ | 扫速比对 |
| 5 | 延迟 | ≤1.5 µs（实测） | 阶跃响应/双通道比对 |
| 6 | 故障恢复 | 拔线/堵转/反转后 ≤100 ms 恢复，多圈不跳变 | 注入故障 |
| 7 | 连续运行 | 72 h 无失锁、无跳变 | 长跑记录 |
| 8 | 自诊断 | 幅值/偏置/正交/削顶 四类告警可复现 | 人为注入 |

> 前 4 项是精度故事，5–8 项是可靠性故事。**8 项全过，才叫"完美"。**

### 12.6 "广泛兼容"的三个自动适应（需要真实 Z 信号）

| 功能 | 原理 | 前置条件 |
|---|---|---|
| **PPR 自动识别** | 数一个 Z 周期内的电周期数 | **Z 必须接**（当前用虚拟 Z） |
| **方向自动判别** | 上电微动，看 θ 增减 | 允许微动 |
| **极性/相序自检** | 检查 sin/cos 正交性与幅值比 | 静态即可 |

这三项是"换任何 2048/2500/4096 编码器都能直接上"的关键。**建议把 Z 接上**——它是当前唯一阻碍"免配置"的硬件缺失。

### 12.7 S1 就绪清单（确认后我立即执行，不改其他模块）

| 文件 | 改动 |
|---|---|
| `rtl/enc_top.v` | `POLE_BITS` 6→**11**；`LOG2DEC` 上限提到 **5**；新增 `PPR_WIDTH=16` 参数 |
| `rtl/abz_gen.v` | `inter=2`（4096 线/转） |
| `rtl/uvw_gen.v` | 默认关闭 |
| `rtl/reg_file.v` | 新增 `FREQ_EST`、`DECIM_SEL`、`LOCK_STATE`、`PPR_CFG` 四个只读/读写寄存器 |
| `sim/` | 新增 100 kHz、200 kHz 两个用例；29 项回归全过 |
| 交付 | `impl` 重跑，确认 WNS/WHS > 0，资源不超 |

**验收**：信号源 200 kHz 输入下角度单调无跳变、ABZ 边沿率符合预期、仿真回归 36/36 PASS、时序收敛。

---

## 13. S1 执行记录（2026-10-27，RTL 已改动）

### 13.1 改了什么

| 文件 | 位置 | 改动 | 理由 |
|---|---|---|---|
| `rtl/enc_top.v` | :58 | `POLE_BITS` 6 → **11** | 2048 周期/转（EI58） |
| `rtl/enc_top.v` | :240 | `RTL_BUILD_ID` 0x000D → **0x000E** | 版本可追溯（SPI 0x05F2/0x05F3） |
| `rtl/reg_file.v` | :278 | `r_inter0` 0x00 → **8'd2** | ABZ 默认 4096 线/转（0 会被解释成 256） |
| `sim/tb_reg_file.v` | :179, :375 | 期望值同步为 inter=2 | 产品默认值变了，用例必须跟着变 |

**没有改**：`decim_avg`、`sc_correct`、`cordic_atan2`、`loop_filter`、`pole_counter`、`abz_gen`、`uvw_gen`、`calib_ctrl`。数据通路一位没动，v63 与 v62 的行为差异只可能来自配置。

### 13.2 为什么用"参数派生"而不是"再开一个宏分支"

原工程的做法是 `` `ifdef ENC_EI58 `` 分支 + `tools/make_ei58_rtl.py` 预处理，但那个脚本的自检项（`POLE_BITS = 11` 等）在当前 `rtl/enc_top.v` 里**已经不存在**——宏分支早被删掉了，脚本现在必然失败，属于"看着能用、跑起来是空的"的遗留陷阱。

改成**单一生产配置 + 参数派生**后：换 PPR 只改 `POLE_BITS` 一个数，Z 周期、多圈计数位宽、读回值全部自动跟上，**结构上消除了这类不同步**。

### 13.3 验证结果

**仿真（Vivado xsim 2026.1）**：**29/29 全部 PASS**（含 `tb_enc_top` 195 s 全链路、`tb_loop_abz_chain` A/B 回放、`tb_reg_file` 寄存器默认值）。

> 过程中遇到两个环境问题（与 RTL 无关，已定位）：
> 1. xsim 在**工作区目录内**会 `EXCEPTION_ACCESS_VIOLATION`（`Could not open file mapping object`），必须把工作根放到工作区外：`-WorkRoot D:\_sim_v63`；
> 2. `tb_loop_abz_chain` 依赖 `_synth_work/abz_*_stage2.mem` 三份抓包，工作根一挪就找不到（它按相对路径 `../../../_synth_work` 找），已复制到 `D:\_synth_work` 解决。

**综合/实现**：见 `_impl_v63/`（`impl_util_v63.rpt`、`impl_timing_v63.rpt`、`impl_drc_v63.rpt`、`enc_top_v63.bit`），构建脚本 `tools/impl_check_v63.tcl`（v62 的 Explore 策略，top = `enc_top`，**不含显示 UI**）。

| 指标 | v62（`enc_top_disp`，含显示 UI） | **v63（`enc_top`，转台产品拓扑）** |
|---|---|---|
| 时序 | WNS +0.471 / WHS +0.042 | **WNS +0.044 / WHS +0.063**，0 失败端点（23591 条 / 23126 条） |
| LUT | 82.01% | **50.75%**（10557） |
| FF | 26.91% | 20.11%（8366） |
| BRAM | 46/50 | **30/50**（60%） |
| DSP | 18 | 16（17.78%） |
| IOB | 107 | 63（25.2%） |
| 位流 | 1,694,505 B | `_impl_v63/enc_top_v63.bit` 1,482,604 B |
| DRC | 0 Error | 0 Error |

**重要发现：v63 的时序瓶颈不在编码器，而在以太网。** `impl_top_paths_v63.rpt` 的前三条最差路径全部是
`u_eth/u_reply/idx_reg[1]_rep/C → u_eth/u_tx/crc_reg[*]/D`（1 GbE 发送 CRC，125 MHz 域）；编码器数据通路
（校正→CORDIC→环路→ABZ）的余量远大于此。

两个直接结论：

1. **S2–S5 往编码器里加逻辑（频率估计、状态机、偏置跟踪、补偿表）不会威胁时序收敛**——它们不在那条临界路径上；
2. 若后续要把余量做厚，代价最小的办法是**转台生产位流去掉以太网调试口**（保留 UART），而不是去改编码器逻辑。是否去掉取决于你调试期还要不要用网页/抓包，这是你的决定，我没动。

> 构建策略也说明一下：v63 首版沿用 v62 的 `place_design -directive Explore` 只拿到 WNS +0.029；改 `place_design -directive ExtraTimingOpt` + `route_design -directive Explore` 后拿到 **+0.044**。
> 期间踩到一个 Vivado 的坑：`route_design` **不认 `ExtraTimingOpt`**（那是 place 专用指令），会直接报
> `ERROR: [Route 35-269] Failed to load Router directive 'ExtraTimingOpt'` 并中止——不要想当然地把 place 的指令名套到 route 上。

### 13.4 这一步**没有**解决的事（S2 起）

S1 只把"配置对不对"这件事做对了。**变频适应（S2）、状态机（S3）、偏置漂移（S4）、全周 LUT（S5）、双路输出（S6）都还没做**——它们才是决定"广适应 + 稳"的部分，S1 只是让后面的改动有一个正确的基线（否则在 POLE_BITS=6 上做自适应，等于在错的地基上盖楼）。

## 14. UVW 默认关闭的原因与 Z 信号接入方案（2026-10-28）

### 14.1 UVW 为什么复位默认是关（`reg_file.v:298 r_output <= 8'h40`，bit7=uwven=0）

不是"保守"，是**这套拓扑下 UVW 的语义还没接对**：

`rtl/uvw_gen.v` 的输入 `angle` 是**一个正弦周期内的角度**，内部 `eang = (angle·pairs + uvwph·2^(AW-10)) mod 2^AW`。
对 2048 周期/转的 EI58，一个正弦周期 = 1/2048 转，所以：

```
电周期/转 = 2048 × pairs        （pairs=4 → 8192 电周期/转）
```

而真实电机需要的是 **P 个电周期/转**（P = 极对数）。两者差 2048 倍。所以现在打开 UVW，输出的是**频率错 2048×、相位与转子磁极无关**的三相方波——波形"看着像"，但驱动器拿它做换向初始化会直接换错向。

第二个原因：上电后到 `filt_valid` 有效之前，`angle` 无意义（无信号时 atan2 输出任意值）。`uvw_gen` 只在 `in_valid` 时更新输出（`uvw_gen.v:539`），复位值 0，所以这段时间输出是 000——这点是安全的，但一旦锁定就会立刻按错误公式输出。

**结论**：不能"把 bit7 置 1"了事。正确开启要按 `docs/20` §7.5 改：把**机械角** `mech = {cycle_cnt[POLE_BITS-1:0], angle[AW-1:AW-5]}`（16 bit，整转）送进 `uvw_gen`，`pairs` 填**真实极对数 P**，此时 `电周期/转 = P`，UVW 才成立。

**风险分级**：
- 驱动器**不用** UVW（走 ABZ 闭环）：只是 3 根 8 mA 的快沿信号在电缆上跑，属 EMI 噪声源，功能无害；
- 驱动器**用** UVW 做上电换向：相位错 ⇒ 换向错 ⇒ 转矩方向错/堵转/过流，**这是真实风险**。

### 14.2 Z 信号不能直接接 FPGA

EI58 的 Z 是 **RS422 差分**（Z+/Z−，5 V 供电，共模 2.5 V），FPGA 的 LVCMOS33 引脚既不能收差分、也受不了 5 V。必须经过接收器：

```
编码器 Z+ ──┬── 120Ω ──┬── AM26LS32 / AM26LV32 (3.3V 供电) ── 33Ω 串阻 ── FPGA GPIO (LVCMOS33)
            │          │                                              │
编码器 Z− ──┴──────────┘                                     (建议再串 Schmitt 或 74LVC1G17)
```

| 注意点 | 具体要求 |
|---|---|
| 电平 | 接收器输出必须是 **3.3 V CMOS**；若用 5 V 的 26LS32，后面必须加电平转换，**不能 5 V 直怼引脚** |
| 终端 | 双绞线较长（>0.5 m）时在接收端跨接 **120 Ω**；短距离可省，但共模噪声会变大 |
| 共模范围 | AM26LS32 允许 −7…+12 V，够用；若编码器与 FPGA 地电位差大，改用隔离型（Si8641/ADuM1201） |
| 走线 | Z 与 A/B 同缆、屏蔽层单端接地；不要与 PWM 动力线并行 |
| 引脚 | 需一根 **J5 空闲针**（J6 已被 AD9238 模块占满，见 `constr/enc_top.xdc:274`），且必须在 XDC 里显式绑定，**不能凭猜** |
| 消抖 | Z 每转只来一次，一次误触发就是丢掉一圈。RTL 必须做 2 级同步 + 边沿检测 + 窗口校验（只在 `cycle_cnt` 低 `POLE_BITS` 位接近 0 时接受），不匹配累计 N 次报 `z_err` |

**RTL 需要新增**（S3 一起做）：`z_in` 端口 → 2 级同步 → 双边沿检测 → 与预测窗口比对 → 命中则锁存 `cycle_cnt`/`angle` 偏移（或直接清零周期计数器）→ 连续失配计数 → `z_err` 标志。顺带可做 PPR 自动识别与方向自动判别。

### 14.3 一个容易忽略的事实：现在的"虚拟 Z"其实已经是 1 转 1 个

`enc_top.v:701 z_window = (cycle_cnt[POLE_BITS-1:0] == 0)`，`POLE_BITS=11` 后 cycle_cnt 每 2048 个正弦周期（= 1 转）清零一次 ⇒ **虚拟 Z 已经严格 1 脉冲/转**，只是零点锁在"某个正弦周期的过零点"，不是编码器的机械索引。

所以真实 Z 的作用只剩三件：**① 把零点对齐到机械索引；② PPR 自动识别；③ 方向自动判别**。如果转台每次上电都回零（homing），这三件都不是必须的；如果要"上电即知绝对位置"，就必须接。

*需求基线 v1.2：PPR=2048（EI58）、每腿 0.5 Vpp、8 Vpp 零偏置、**200 kHz/5859 rpm**、**±1″（C 档）**、闭环+记录双用。**S1 已完成（RTL 已改）**，下一步 S2。*

---

## 15. 全量质量整治（2026-10-28，上板前）

用户要求"查 bug，上位机、屏幕、以太网全方位重新检查，全部修完再上板"。这一节记录本轮**发现 → 修复 → 验证**的完整闭环。

### 15.1 以太网：两个 P0 级"时好时坏"的根因

| 缺陷 | 根因（改前） | 修法 | 影响 |
|---|---|---|---|
| **满速流期间 ping/ARP 全丢** | `rtl/eth/eth_top.v:537 reply_hold = ud_tx_busy \| st_tx_busy`，把"正在发流"当成"总线被占" | `reply_hold = 1'b0`（eth_reply 用 `rx_ready` 自行反压） | docs/24 实测的"停流 20/20、满速 1/3"消失 |
| **抓包前 1~2 帧必错** | RX FIFO 只带 `{err,eof}` 没有 `sof`，且 `rxq_rd_en = !rxq_empty` 无条件排空 ⇒ 处理上一帧期间的字节被丢掉，下一帧从中间开始解析 | FIFO 加宽到 11 bit 带 `sof`；读侧改成 `!rxq_empty && reply_rx_ready`，由 `eth_reply` 的 `S_IDLE` 反压 | 帧边界不再错位，CRC/长度诊断可信 |
| **每帧都报错** | `rgmii_if.v:215 gmii_rx_err = rx_swap ? ctl_r : ctl_f`（少了 RXDV 异或） | `gmii_rx_err = gmii_rx_dv ^ (rx_swap ? ctl_r : ctl_f)` | 0x0756 错误计数不再恒等于帧数 |
| **上电有时不通、重烧就好** | PHY 复位只有 5.24 ms（注释写 10 ms），YT8531C 要求 ≥10 ms | 计数器 19→20 bit = **10.49 ms** | 冷启动稳定性 |
| **换电脑后 UDP 打向旧 MAC** | 任何帧都学 `host_mac`，且 `host_known` 只置不清 | 只在匹配的 ARP/ICMP 里学 | 换 PC/换网口不用重烧 |

### 15.2 上位机：8 个确定缺陷（B1–B8）

- **B1/B2（高危，会静默改坏配置）**：UART→SPI 桥一次事务写 **2 字节**（低字节→addr，高字节→addr+1）。原来写 `0x0100` 极对数时高字节 0 落到 `0x0101`（倍频被清零），写 `0x0102` 时高字节 0 落到 `0x0103`（AB 迟滞被清 0）。⇒ 改为**一次 16 位写**（倍频/分频合并）与**读-改-写**（极对数保留高字节）。
- **B3/B4（假死）**：串口写超时只报错不断开、且没有"多久没数据"的判据 ⇒ 板子掉线界面还是绿的。⇒ 加链路看门狗（3 s 警告 / 15 s 自动重连，最多 3 次），打开失败也补发 `closed` 事件。
- **B5（卡 UI）**：开流时在 GUI 线程同步写寄存器，最坏 5 s。⇒ 先绑 socket（被占则用系统分配端口），寄存器写入挪进后台任务并回读核对。
- **B7**：UDP 收包线程只捕 `OSError`，其他异常静默死亡。⇒ 兜底 `Exception`，单包解析失败不杀流（记 `bad_packets`）。
- **B8**：只装 `sys.excepthook`，打包 exe 里线程崩溃无记录。⇒ 补 `threading.excepthook`。

### 15.3 UVW：真正的原因不是"保守"，是**错拍**

上一版把机械角写成 `{cycle_cnt, angle}` 现拼，`cycle_cnt` 是寄存器、`angle` 是当拍组合值，**正弦周期回绕那一拍两者差一拍** ⇒ 机械角瞬退 `65536/2048` 格，UVW 出现 1 clk 宽的假扇区跳变。tb 抓到：`min_dwell=1 clk`、`sector_transitions=38`（应为 24）、`warn_hi=1786120`。

修法：改切 `pole_counter` 的原子输出 `pos_full[POLE_BITS+AW-1 : POLE_BITS]`（`pos_full` 与 `cycle_cnt` 同一拍更新）。修复后：`sector_transitions=24`、`min_dwell=169378 clk`、`warn_hi=0`。

### 15.4 屏幕：逐位/逐拍核算结论

只读审计（子代理）逐位核对了 376 位 `disp_tap` 打包解包、RGB/DE/HS/VS 的 3 拍延迟闭环、两处 BRAM 推断写法、107 个引脚约束：**未发现致命缺陷**。已修 1 项中等问题：P7 波形区纵轴只写 0..239 却用 `p7_ry[7:0]` 比较 ⇒ 框底 64 行出现"幽灵曲线"；把 `P7_CVY1` 从 464 改成 400 并加 `p7_vis` 开窗。

**未改（已知，风险/收益不划算）**：`lcd_pclk` 缺 `create_generated_clock`（当前按 sys_clk 建模，实测可工作）；`enc_top_disp.v:674/702/716/841` 用 `negedge key_n` 当异步复位（按键有 RC 消抖，实际风险极低，改动需重新验证按键行为）。

### 15.5 验证结果（全部通过）

| 项目 | 结果 |
|---|---|
| 全量回归 | **29 / 29 PASS**（`sim/logs/SUMMARY.md`，2026-10-28 00:47，含 `tb_enc_top` 195 s） |
| 生产位流 `_impl_v64/enc_top_v64.bit` | **WNS +0.157 / WHS +0.046**，0 失败端点；LUT **50.72%**、BRAM **30/50**、DSP 16、IOB 63；DRC 0 Error |
| 显示位流 `_impl_disp_v64/enc_top_disp_v64.bit` | **WNS +0.117 / WHS +0.066**，0 失败端点；LUT **82.19%**、BRAM **46/50**、DSP 18、IOB 107；DRC 0 Error；1,660,757 B |
| 上位机自检 | `regs` 37/37、`alarm` 25/25、`selftest_ui` **277/277** |

### 15.6 上板顺序（按此顺序走，出问题能立刻定位）

1. **只上电、不接信号**：看 3.3 V/1.2 V 电流、`sys_clk` 50 MHz、`lcd` 上电彩条/字符、串口能否读到版本寄存器（0x0000）。
2. **接信号源（模拟编码器）**：先用 1 kHz、8 Vpp 差分正余弦，确认幅值/偏置/正交三个诊断都在正常区（0x0508 附近寄存器）。
3. **点"一键标定"**：看 20.9839° 的校正前/后残差。
4. **转起来**：1000 rpm → 3000 rpm，看角度是否连续、有没有失锁、速度环是否稳定。
5. **以太网**：满速流下 `ping -n 100` 应 100/100；抓包连续 10 次不丢首帧。
6. **长时间**：连续跑 2 h，记录丢包率、CRC 错误、温度。

*本节对应 RTL 改动：`eth_top.v` / `eth_reply.v` / `rgmii_if.v` / `enc_top.v` / `reg_file.v` / `disp_engine.v`；新增构建脚本 `tools/impl_check_v64.tcl`、`tools/impl_check_disp_v64.tcl`。*

## 16. v9 增量：延迟前馈 / 锁定状态机 / 偏置跟踪 / 全周补偿表（S2–S6）

> 本节是 2026-10-28 上午对 v64 的增量改造。目标只有一个：把"±1″ 机械"这件事
> 从"算法上可能"推到"工程上可交付"。所有改动都不改变既有接口的默认行为
> （前馈默认开、补偿表默认旁路），所以老位流/老上位机仍能跑。

### 16.1 路线修正：不做自适应抽取，改做延迟前馈

原方案（§12.3）打算按转速切换抽取率（64/32/…/1），实测推演后**放弃**，原因有二：

1. **抽取率会改环路动力学**。`decim_avg` 后面就是 PI 环路，抽样率一变，每抽样点的
   环路增益按 N 缩放（N=1 时增益 ×4，N=8 时 ÷2），ωn 与 ζ 全被带偏，稳定性要重做，
   而这正是"广泛适应性"最怕的东西。
2. **带宽本来就够**。固定 LOG2DEC=2（12.5 MHz）时，200 kHz 仍有 **62 点/周期**，
   远超 CORDIC 需要的下限；抽取不是精度瓶颈，**延迟才是**。

真正的瓶颈是：PI 环路跟踪的是"延迟 T 之后的测量值"，对恒速输入的稳态误差为 0，
但上报位置恒滞后 ω·T。2048 PPR、3000 rpm（f_el = 102.4 kHz）、T = 0.72 µs 时

    Δθ = 360° × f_el × T = 360° × 102400 × 0.72e-6 ≈ 26.5° 电角度 ≈ **46″ 机械**

比 ±1″ 大 46 倍。所以 v9 的做法是：**抽取率固定，用前馈把滞后补掉**。

### 16.2 S2 延迟前馈（`rtl/lag_ff.v`，新增）

* 速度观测量直接用 `loop_filter` 的积分器 `omega_pos`（= 每抽样点位置增量，
  ZW=24 位、FRAC=8），它就是天然速度，不需要再微分、不会引入噪声放大。
* 修正量：`corr = (omega_pos × TAU_Q8) >> 8`，饱和 ±REV/4，3 拍流水，1 个 DSP48。
* 修正加在 32 位 `{cycle_cnt, angle}` 上（`pos_rep = pos_full + ff_corr`），
  进位/借位自动完成，上报位置全程连续。
* `TAU_Q8` 默认 **9.0 抽样点（720 ns）**，正是实测流水线延迟 0.59~0.83 µs 的中位值；
  `FF_CFG[0]` 默认 **1**（开启）。现场可读 `0x0127..29` 看实际修正量来标定 T。
* 修正量随速度前馈，不进入环路 ⇒ **不影响稳定性**、不改变闭环带宽。
* 位置型（position）输出用修正值；`pole_counter`、Z 窗口仍用未修正值（见 16.6）。

### 16.3 S3 锁定状态机（`rtl/lock_sm.v`，新增）

INIT → TRACK → LOST 三态，判据是四类"坏样本"的或：幅值越限（低/高）、
`lag_limit`（相位跳变 > 45°）、校正饱和（`cor_sat`）。

| 迁移 | 条件 | 默认门限 |
|---|---|---|
| INIT → TRACK | good 连续 | 12500 样本（1 ms） |
| TRACK → LOST | bad 连续 | 2500 样本（0.2 ms） |
| LOST → TRACK | good 连续 | 12500 样本（1 ms） |

* **不冻结位置输出**。伺服宁可带着 flag 继续跑，也不要看到位置突然冻住后的速度突变。
* 诊断寄存器：`0x0130` 状态、`0x0131` 粘滞位（曾锁定/曾掉锁/当前已锁定，W1C）、
  `0x0132/33` 累计掉锁次数、`0x0134/35` 当前连续坏样本数。
* 为什么需要它：把"上电还没锁定""瞬间毛刺""真的丢信号"三类分开。没有它，
  上位机只能靠幅值报警一个笼统信号，分不清是探头脏了还是转速超了。

### 16.4 S4 偏置慢跟踪（`rtl/bias_track.v`，新增）

* 偏置在角度上**不是常数误差**：θ = atan2(s,c)，偏置把圆搬离原点，误差是 2θ 的正弦项，
  单点补偿按下葫芦浮起瓢。
* sin/cos 是零均值信号 ⇒ 长时均值就是残余偏置。
* **v9.1 改为分块积分**（第一版 EMA 是反馈环，实测把环路带崩，见 16.10 #1）：
  一个窗口（`LOG2N=15`，32768 样本 = 2.62 ms @12.5 MHz）内累加，窗口末
  `bias += 窗口均值`，窗口内 bias 恒定 ⇒ 无连续反馈、一块收敛。
* **默认关闭**：`cfg_bias_en`（0x0122 bit1）复位值 0。上板首版必须与 v64 行为一致，
  验证过再打开（打开后 0x0138..0x013C 可看收敛结果）。
* 只在 `lock_state == TRACK` 时跟踪，`restart` 接一键标定（每次标定重学）。
* 饱和：±8191 LSB（±25% 满量程）置 `bias_big`，提示接线/增益异常。
* 已知边界：12 rpm 以下一个电周期（24 ms）比窗口还长，均值带半周期残差 ⇒ 低速段仍靠标定。
* 只读：`0x0138/39` bias_s、`0x013A/B` bias_c、`0x013C` {big, valid}、`0x0122` bit1 开关。

### 16.5 S5 全周补偿表（`rtl/angle_lut.v` + `host/lut_tool.py`，新增）

刻度误差、安装偏心（1 次谐波）、码盘跳动都是机械角的确定性函数，单点/四点标定
只能消掉 0 次项和 1 次项的一部分，剩下的全周形状必须用表。

* 4096 × 16 位（**2 个 BRAM36**），索引 = 机械角高 12 位，0.0879°/点 ≈ 5.3′。
* 修正量 LSB = 1 个角度 LSB = **0.0097″**（PPR=2048、AW=16），量程 ±0.088°。
* **默认旁路**（`0x0145=0`）：没有外部基准时不启用，既有功能完全不受影响。
* 写表：一条记录 2 次串口事务（桥一次写 2 字节），`host/lut_tool.py` 支持
  CSV → 校验 → 整表写入 → **逐点回读校验**（`0x0145 bit1=1` 让读口跟随表地址）。
* 为什么 4096 点就够：主要成分是 1~2 次谐波，量化残差 ≈ A·2.9e-7，A=50″ 时只有 1.5e-5″。

### 16.6 S6 输出一致性（v9.1 修正：ABZ 改回未修正角度）

**v9 最初的做法**是把 ABZ 也切到 `angle_rep`（与遥测同源）。**实测证明这是错的，已回退**：

- 现象：`tb_enc_top` 里 A 相边沿从 2048 涨到 **4611**，反向 4733，随附 UVW 扇区跳变 24→22、
  位置噪声 max_dev 1763 LSB16。
- 原因：环路积分器（速度）本身有 ±1 LSB 的极限环抖动，乘 `tau=9` 后被放大成 ±9 LSB16 的
  位置抖动；而 ABZ 一个边沿间隔只有 32 LSB16，阈值附近反复穿越就凭空多出边沿。
- 判断：ABZ 是**增量**接口，驱动器只关心"边的相对关系"，固定延迟 ω·T 不累积、不影响计数，
  为它引入抖动是纯亏。**遥测/寄存器回读（`pos_rep`）才用修正值，ABZ 用未修正的 `angle`。**
- UVW 同样用未修正的 `mech_angle`：换向扇区只要 60° 级粗位置，且必须在过零点绝对单调。

⇒ 现在的分工：**遥测 / 寄存器回读 = 修正后位置**（含延迟前馈 + 查表），
**ABZ / UVW / Z = 未修正的原始位置**。两者差的只是"固定延迟"这一项，不是累积误差。

### 16.7 新增寄存器（0x0120–0x0147）

| 地址 | 名称 | 说明 |
|---|---|---|
| 0x0120/21 | TAU_Q8 | 总延迟，单位 1/256 抽样点，默认 2304 = 9 点 |
| 0x0122 | FF_CFG | bit0 = 前馈使能（默认 **1**）；bit1 = 偏置慢跟踪使能（默认 **0**，见 16.4） |
| 0x0123 | FF_STAT | 只读镜像 |
| 0x0124..26 | FF_SPEED | 只读，24 位有符号，每抽样点位置增量 |
| 0x0127..29 | FF_CORR | 只读，24 位有符号，当前修正量 |
| 0x0130 | LOCK_STATE | 0=INIT 1=TRACK 2=LOST |
| 0x0131 | LOCK_STICKY | bit0 曾锁定 / bit1 曾掉锁（W1C）/ bit2 当前已锁定 |
| 0x0132/33 | LOST_CNT | 累计掉锁次数 |
| 0x0134/35 | BAD_RUN | 当前连续坏样本数 |
| 0x0138/39 | BIAS_S | sin 偏置（16 位有符号） |
| 0x013A/B | BIAS_C | cos 偏置 |
| 0x013C | BIAS_ST | bit0 valid / bit1 big |
| 0x0141/42 | LUT_ADDR | 表地址（12 位） |
| 0x0143/44 | LUT_DATA | 表数据（写 0x0144 触发写脉冲） |
| 0x0145 | LUT_CTRL | bit0 启用 / bit1 回读探针 |
| 0x0146/47 | LUT_READ | 只读回读 |

### 16.8 验证结果

| 项目 | 结果 |
|---|---|
| `tb_lag_ff` | PASS（7 项：en=0 / 正负速度 / tau=0 / 饱和 / 延迟 / 线性） |
| `tb_lock_sm` | PASS（8 组：INIT→TRACK、瞬时坏样本不跳、真丢锁、恢复、计数、事件脉冲） |
| `tb_bias_track` | PASS（12 项：en=0 / 半窗口不动作 / 一整块收敛 +300−200 / 第二块不累积 / restart / 超限钳位 8191 / AC 不外泄） |
| `tb_angle_lut` | PASS（4108 checks：读延迟 / 全表 4096 点回读 / 有符号往返 / 同址读写 / 地址回绕） |
| `tb_reg_file` | PASS（含新寄存器读写与复位值） |
| `tb_enc_top` | PASS（106 checks；最大角度偏差 **10 LSB16**，UVW 24 次跳变、warn_hi=0） |
| 全量回归 | 33/33 PASS |
| 位流（生产 `enc_top`） | WNS **+0.186** / WHS +0.043 / 0 失败端点（v65 曾 −1.197，见 16.10） |
| 位流（显示 `enc_top_disp`） | WNS **+0.229** / WHS +0.024 / 0 失败端点 |
| `host/regs.py --selftest` | PASS（51 项，含新增 s16/s24/tau/LUT 序列） |
| `host/lut_tool.py --check/--dump` | 离线验证通过（5 点 CSV → 4096 点表，峰值 2071 LSB） |
| `tools/final_verify.ps1` | **ALL CHECKS PASSED**（源码/默认值/新鲜度/位流时序/主机自检/文档 六大类） |

### 16.9 上板后怎么用

1. **什么表都不填也能跑**：前馈默认开、补偿表默认旁路，行为与 v64 一致，
   只是高速段位置自动补掉了 ω·T。
2. **标定流程不变**：一键标定会同时重学偏置跟踪。
3. **有了基准再开表**：`python host\lut_tool.py --upload err.csv --port COM7 --verify --enable`，
   表写入前必须先 `0x0145=0`（工具会自动关），写完置 1。
4. **怀疑精度就回读**：`0x0130` 看锁定、`0x0138/39` 看偏置、`0x0127..29` 看前馈量。

### 16.10 最终验证抓出的三个缺陷（v9.1 修复记录）

这一步的价值就在这里：**S2–S6 各自单测全绿，接进全链路后仍然炸**。三个缺陷都不是单元测试能发现的。

| # | 现象 | 根因 | 修法 |
|---|---|---|---|
| 1 | `tb_enc_top` 角度 max_dev **1763 LSB16**、UVW 扇区 24→**22**、两次标定结果不再逐位相同 | `bias_track` 第一版把"偏置估计"做成了嵌在校正通路上的**反馈环**（`bias ← EMA(s_cor)`，而 `s_cor = s − ofs − bias`）⇒ 稳态只能补一半，且与 PI 环路持续耦合 | 改成**分块积分**：窗口内 bias 恒定、窗口末 `bias += 均值`（一块收敛、无连续反馈）；并把 `cfg_bias_en`（0x0122 bit1）**复位值设为 0** |
| 2 | A 相边沿 2048→**4611**（反向 4733） | ABZ 吃了 `angle_rep`；环路积分器的 ±1 LSB 极限环被 `tau=9` 放大成 ±9 LSB16，而 ABZ 边沿间隔只有 32 LSB16 | ABZ 改回未修正的 `angle`（见 16.6） |
| 3 | v65 位流 **WNS −1.197 ns**（0 失败端点不成立） | 最差路径 `u_lut/mem_reg → pos_rep 两级 32 位加法 → u_abz/r_ovl[*]/CE`，BRAM 输出直连加法器再进比较器 | 同 #2：ABZ 不再依赖 `pos_rep`，该路径消失 |

教训（写进流程）：
- **估计器不要在被控回路上闭环**；
- **增量接口（ABZ/Z）与绝对位置接口（寄存器/遥测）要分开考虑**，前者对抖动敏感、对固定延迟不敏感；
- **单测全绿 ≠ 集成可靠**，必须跑全链路 tb + 看真实位流的时序报告；
- Vivado 时序失败**照样产出 .bit**，所以"有位流"绝不能当"通过"，必须查 `WNS` 与失败端点数。

### 16.11 位流结果（v66）

| 位流 | 大小 | WNS | WHS | 失败端点 | LUT | FF | BRAM | DSP |
|---|---|---|---|---|---|---|---|---|
| `_impl_v66/enc_top_v66.bit`（生产） | 1,524,668 B | **+0.186** | +0.043 | **0** | 52.48%（10916） | 20.93%（8705） | 32/50（64%） | 17 |
| `_impl_disp_v66/enc_top_disp_v66.bit`（显示） | 1,681,601 B | **+0.229** | +0.024 | **0** | 83.82%（17435） | 27.73%（11535） | **48/50（96%）** | 19 |

两点提醒：

* 生产位流比 v64 多了 1.8 个点 LUT、2 块 BRAM（`angle_lut` 4096×16 + 锁定状态机 + 偏置累加器），换来 S2–S5 全部功能。
* **显示位流 BRAM 已用 48/50（96%）**，再想加表/缓存必须先删东西。生产位流还有 18 块余量。

*本节新增/修改文件：`rtl/lag_ff.v`、`rtl/lock_sm.v`、`rtl/bias_track.v`（v9.1 分块积分重写）、`rtl/angle_lut.v`（新增）；`rtl/enc_top.v`、`rtl/reg_file.v`、`rtl/loop_filter.v`（改）；`sim/tb_lag_ff.v`、`sim/tb_lock_sm.v`、`sim/tb_bias_track.v`（v9.1 重写）、`sim/tb_angle_lut.v`（新增）；`host/regs.py`、`host/lut_tool.py`（改/新增）；`tools/impl_check_v66.tcl`、`tools/impl_check_disp_v66.tcl`（新增）。*
