zhaoyunfengntzx-maker/fpga-smr-encoder/docs/20_EI58C9_encoder_integration.md

# EI58C9.25-2048SC5N4 正余弦编码器接入指南

> 适用工程：`C:\Users\zhaoy\Desktop\FPGA`（达芬奇-lite XC7A35T + AD9238 双通道模块）
> 编码器：EI58C9.25-2048SC5N4，5 V 供电、1 Vpp 正余弦（差分输出；**本机实测每腿 1 Vpp、差分 2 Vpp**）、2048 周期/转、每转一个 Z、C/D 磁极信号
> 目标：把编码器的 sin/cos 送进 AD9238 的 CH1/CH2，经 FPGA 细分后输出 ABZ，并给出可复现的配置与验收步骤

> **2026-10-20 修正（重要）**：本文早期版本写“每腿 0.5 Vpp → G=8”，这是**错的**。差分放大器看到的是 `A+−A−`，其 Vpp 是每腿 Vpp 的 **2 倍**：每腿 0.5 Vpp → 差分 1 Vpp → **G=4**；每腿 1 Vpp → 差分 2 Vpp → **G=2**；G=8 只适用于每腿 0.25 Vpp。以 §1.1 和 §4 的“实测后选增益”表为准。
>
> **2026-10-21 本机实测**：示波器 AC 档测得 **A 与 A− 各 1 Vpp**（反相），即**每腿 1 Vpp、差分 2 Vpp**。因此本机应使用 **G=2**（10 kΩ/20 kΩ），输出 2.5 V ± 2 V；**不要用 G=4 或 G=8**，否则削顶。AC 档看不到 2.5 V 直流偏置是正常的，请再用 DC 档确认共模约 2.5 V。

---

## 0. 结论速览

| 项目 | 结论 |
|---|---|
| 能不能直接接？ | 能“转”，但精度很差：单腿 0.5–1 Vpp → ADC 只有 ±102–204 码（约 7.7–8.7 bit 有效），角度噪声约 0.15–0.3°。只适合先验证接线/相位。 |
| 推荐前端 | 每通道一个 **5 V 单电源、2.5 V 基准的差分放大器**，输出 2.5 V ± 2 V（4 Vpp）直流耦合进 CH1/CH2。**本机实测每腿 1 Vpp → 用 G=2**（10 kΩ/20 kΩ）；若别的编码器每腿 0.5 Vpp 才用 G=4，每腿 0.25 Vpp 才用 G=8。约 819 码幅度（10.7 bit 有效），角度噪声可到 0.02–0.03°。 |
| 是否要改 RTL | **要**。2048 周期/转必须把 `POLE_BITS` 从 6 改成 11；否则 Z 每 1/32 转一次。本仓库已加 `ENC_EI58` 变体，默认 v13 构建不受影响。 |
| ABZ 配置 | `inter=2`（每正弦周期 8 个边沿，4096 线/转、16384 边沿/转），**不要用默认 256**（会触发限频）。 |
| UVW | **关闭**。现有 `uvw_gen` 的 `pairs` 是“每个正弦周期内的电周期数”，对 2048 周期/转的编码器无法表示电机极对数；本编码器不适合直接产生 UVW。 |
| 真实 Z / C / D | 暂不接。虚拟 Z 上电位置任意；需要绝对零点/换相时再加 GPIO 与 RTL。 |
| 供电 | 整板 5 V 只从 USB Type-C 串口口进；编码器 150 mA + ADC 模块约 400 mA + 板载，建议 **带电源的 USB Hub（5 V/2 A）**，不要用普通 USB2 口。 |

---

## 1. 编码器接口核对

### 1.1 说明书关键参数

| 参数 | 值 | 对本项目的影响 |
|---|---|---|
| 型号 | EI58C9.25-2048SC5N4 | 2048 个正弦周期/转 |
| 供电 | DC 5 V ±5%，≤150 mA | 与 FPGA 板同 5 V；加 PTC/去耦 |
| 输出 | 正余弦 A/A−、B/B−；零位 Z/Z−；磁极 C/C−、D/D− | A/B 进 ADC；Z/C/D 暂不接 |
| 幅值 | 1 Vpp±0.2（本机实测每腿 1 Vpp） | **本机 A、A− 各 1 Vpp → 差分 2 Vpp → 用 G=2** |
| 直流偏置 | 2.5 V ±0.2 V | 在 ADC ±5 V 量程内，可直接 DC 耦合 |
| 响应频率 | 200 kHz | 5000 r/min 时基波 170.7 kHz，前端带宽要 >1 MHz |
| 脉冲数 | 2048 p/r | 一个正弦周期 = 1/2048 转 |
| 轴孔 | Φ9.25 mm 锥形轴 1:10 | 电机轴需匹配锥度；M5 锁紧、M10 顶出 |
| 最高转速 | 5000 r/min | 对应 170.7 kHz；ABZ inter=2 时 1.36 MHz 边沿 |
| 工作温度 | −20…+120 °C | 光学器件，注意防尘/防油 |

> **1 Vpp 的口径**：同系列网页写的是 “1 Vpp differential”，但这张说明书只写“输出幅值 1 Vpp±0.2”“直流偏置 2.5±0.2 V”。**本机 2026-10-21 实测 A、A− 各 1 Vpp（AC 档、反相）**，说明这台机器的“1 Vpp”是**每腿幅值**，不是差分幅值；差分 A−A− 为 **2 Vpp**。因此用 **G=2**，不是 G=4/G=8。
> AC 档看不到直流偏置是正常的；请切到 **DC 档**确认 A、A− 的共模约 2.5 V（若为 0 V，见 §10 风险 1 的处理）。

### 1.2 接线表（以线色为准，针号仅作核对）

| 线色 | 插座针号 | 信号 | 接到 |
|---|---|---|---|
| 红 | 9 | +5 V | J5-1（经 0.5 A PTC） |
| 蓝 | 7 | 0 V | J5-2/4（GND） |
| 绿 | 5 | A（Sin+） | 调理板 CH1+ |
| 白/绿 | 6 | A−（Sin−） | 调理板 CH1− |
| 灰 | 8 | B（Cos+） | 调理板 CH2+ |
| 白/灰 | 1 | B−（Cos−） | 调理板 CH2− |
| 黄 | 3 | Z | 暂不接（可预留） |
| 白/黄 | 4 | Z− | 暂不接 |
| 棕 | 11 | C | 暂不接 |
| 白/棕 | 10 | C− | 暂不接 |
| 黑 | 12 | D | 暂不接 |
| 白/黑 | 13 | D− | 暂不接 |
| 壳 | — | Shield | 屏蔽层，FPGA 端单点接 GND |

> 针号来自说明书表格；如果电缆是 DB15/航空插头，先用万用表蜂鸣档把“线色—针号”对一遍。红/蓝之间应有几 kΩ～几十 kΩ（不是 0 Ω）；A/A−、B/B− 之间是两路运放输出，不要用电阻档去“找配对”。

---

## 2. 为什么不能直接接

AD9238 模块的 SMA 输入是 **±5 V（10 Vpp）**，1 LSB ≈ 2.44 mV：

| 接法 | 单腿幅度 | ADC 码幅度 | 有效位（相对 12 bit 满量程） | 角度量化噪声（1 个正弦周期内） |
|---|---|---|---|---|
| 直接单端（每腿 0.5 Vpp） | 0.5 Vpp（±0.25 V） | ±102 码 | 约 7.7 bit | 0.5/102 rad ≈ 0.28°，4 倍抽取后约 0.14–0.2° |
| 直接单端（每腿 1 Vpp） | 1 Vpp（±0.5 V） | ±204 码 | 约 8.7 bit | 0.5/204 rad ≈ 0.14°，4 倍抽取后约 0.07–0.1° |
| 差分放大 G=4（每腿 0.5 Vpp） | ±2 V（4 Vpp） | ±819 码 | 约 10.7 bit | 0.5/819 rad ≈ 0.035°，4 倍抽取后约 0.02° |
| 差分放大 G=2（每腿 1 Vpp） | ±2 V（4 Vpp） | ±819 码 | 约 10.7 bit | 同上 |

- 直接把 A 接 CH1、B 接 CH2、0 V 接 SMA 外壳，**能出角度**：2.5 V 偏置在 ADC 的 ±5 V 量程内，不需要隔直/搬移。但只用了一条腿，丢掉了差分共模抑制，幅度也只有满量程的 1/20。
- 把 A/A− 分别接 CH1/CH2 再数字相减，每腿仍只有 102–204 码，差值 204–408 码，还是 8–9 bit 量级，而且浪费一个通道，不推荐。
- 电机 PWM 干扰大时，单端接法的噪声会直接进 ADC；差分放大 + 双绞屏蔽线是必要的。

---

## 3. 方案 A：先验证（不焊板，10 分钟）

目的：确认编码器供电、相位、转向、ABZ 极性，不追求精度。

1. 断电，红→J5-1、蓝→J5-2/4；A→CH1 SMA 芯线、B→CH2 SMA 芯线、0 V→SMA 外壳；A−/B− 悬空（**不要短接到 0 V**）。
2. 上电（先 FPGA，后编码器 5 V），用手慢转电机，示波器看 CH1/CH2：
   - 直流约 2.5 V；
   - 交流约 1 Vpp/腿（本机实测；差分 2 Vpp）；
   - 两路相位差约 90°；
   - 转向改变时，A/B 的超前/滞后关系反转。
3. 烧默认 v13 位流，写 `0x0101=0x0002`、`0x0109=0x0040`，看 UART 角度是否随转动单调变化、ABZ 是否有输出。
4. 预期：角度能出，但抖动大、Z 每 1/32 转一次（v13 的 `POLE_BITS=6`）。**只用于验证接线，不作为最终精度**。

> 注意：不要用杜邦线把 SMA 芯线接到 5 V/2.5 V 电源；不要带电插拔编码器；A/A− 是输出，不能短接。

---

## 4. 方案 B：差分调理板（推荐）

### 4.1 指标

| 项 | 目标 |
|---|---|
| 输入 | 差分 ±1 V（每腿 1 Vpp，本机）；每腿 0.5 Vpp 时差分 ±0.5 V；每腿 0.25 Vpp 时差分 ±0.25 V |
| 增益 | **G=2（1 Vpp/腿，本机实测，默认）**；G=4（0.5 Vpp/腿）；G=8（0.25 Vpp/腿），换电阻 |
| 输出 | 2.5 V ± 2.0 V（4 Vpp），DC 耦合，源阻抗 <100 Ω |
| 带宽 | >1 MHz（170 kHz 基波 + 谐波） |
| 共模抑制 | >60 dB（DC–100 kHz） |
| 电源 | +5 V（J5-1），<20 mA |
| 基准 | 2.5 V（TL431），不需要负电源 |

### 4.2 电路（每通道，标准四电阻差分放大器）

```
                 +5V
                  │
        ┌─────────┴─────────┐
        │  U1A  OPA2350     │
 A+ ──R1──┬── (+)           │
          │                 │
         R2                 │
          │                 │
REF 2.5V ─┴─────────────────┤
                            │
 A− ──R3──┬── (−)           │
          │                 │
         R4                 │
          │                 │
          └──── OUT ────────┘── R5 100Ω ── CH1 SMA
```

- 连接关系：`A+ → R1 → 运放同相端`，`同相端 → R2 → REF 2.5V`；`A− → R3 → 运放反相端`，`反相端 → R4 → 输出`。
- `R1 = R3`，`R2 = R4`；`G = R2/R1`；`Vout = G·(A+ − A−) + 2.5V`。
- **G=2（每腿 1 Vpp，本机实测，默认）**：`R1=R3=10 kΩ`，`R2=R4=20 kΩ`（G=2.00），0.1%。
- G=4（每腿 0.5 Vpp）：`R1=R3=10 kΩ`，`R2=R4=40.2 kΩ`（G≈4.02），0.1%。
- G=8（每腿 0.25 Vpp，不常用）：`R1=R3=4.99 kΩ`，`R2=R4=39.2 kΩ`（G≈7.86），0.1%。
- **注意**：`A+−A−` 的 Vpp 是“每腿 Vpp”的 **2 倍**（两腿反相）；上面的 G 是对差分电压的增益，不要再把每腿 Vpp 直接乘 G。
- 第二通道把 A+/A− 换成 B+/B−，输出到 CH2；U1B 用同一片 OPA2350。
- `R5=100 Ω` 串联到 SMA，SMA 端可加 100 pF 到地（截止约 16 MHz），抑制高频噪声。

### 4.3 2.5 V 基准

```
+5V ── R7 1k ──┬── TL431 阴极 ── 2.5V（到 U1 的 REF）
               │
             100nF
               │
GND ───────────┴── TL431 阳极
```

- TL431 的 REF 脚接阴极，阴极电流约 2.5 mA（1 kΩ 从 5 V 拉）。
- 2.5 V 节点加 100 nF；如果 TL431 离运放远，再并 10 µF。
- 也可以用 LM4040-2.5、ADR4525 等；不要用 10 k/10 k 分压直接当基准（内阻 5 kΩ，会被 R2 的电流拉偏）。

### 4.4 BOM（两通道）

| 位号 | 值 | 数量 | 说明 |
|---|---|---|---|
| U1 | OPA2350UA | 1 | 双运放，RRIO，38 MHz，2.7–5.5 V；备选 OPA2320/AD8608 |
| R1,R3,R1',R3' | 10 kΩ 0.1% | 4 | G=2（本机）/G=4 共用；G=8 时换 4.99 kΩ |
| R2,R4,R2',R4' | 20 kΩ 0.1% | 4 | **G=2 本机默认**；G=4 换 40.2 kΩ；G=8 换 39.2 kΩ |
| R5,R6 | 100 Ω | 2 | 输出串联 |
| R7 | 1 kΩ | 1 | TL431 偏置 |
| D1 | TL431 | 1 | 2.5 V 基准 |
| C1–C4 | 100 nF | 4 | 运放/基准去耦 |
| C5,C6 | 10 µF | 2 | 5 V 去耦 |
| F1 | 0.5 A PTC | 1 | 编码器 5 V 保护 |
| J1,J2 | SMA 座 | 2 | 到 AD9238 CH1/CH2 |
| J3 | 2×3 排针 | 1 | +5 V/GND/两路输出 |

> 若想一块板兼容 G=2/4/8：R1/R3 用 10 kΩ（G=2/4）或 4.99 kΩ（G=8）；R2/R4 用 2×3 排针选 20 kΩ（G=2，本机）/40.2 kΩ（G=4）/39.2 kΩ（G=8）。

### 4.5 增益选择步骤

1. 先按方案 A 接好，电机 60 r/min，示波器测 A 对 0 V 的 Vpp。
2. Vpp ≈ 1.0 V → 装 G=2（本机）；Vpp ≈ 0.5 V → 装 G=4；Vpp ≈ 0.25 V → 装 G=8。
3. 上电测 CH1 输出：应为 2.5 V ±2 V（4 Vpp），无削顶；若只有 2 Vpp，检查电阻/焊接；若削顶，减小增益。
4. 想精确调到 4.0 Vpp：把 R2 换成 10 kΩ 电位器 + 固定电阻，调到 4.0 Vpp 后量出阻值换固定电阻；不要长期用电位器（温漂）。

### 4.6 装配/接地

- 调理板放在 FPGA 板旁边，SMA 短线（<30 cm）到 AD9238 模块；编码器线用双绞屏蔽线，A/A−、B/B− 各自双绞。
- 屏蔽层在编码器端接外壳；FPGA 端通过 100 nF + 1 MΩ 接 GND（高频接地、直流隔离），避免两端硬接形成地环路；若干扰大再在 FPGA 端直接接 GND。
- 调理板 +5 V 从 J5-1 取、GND 从 J5-2/4 取；不要从编码器端另拉电源。
- 编码器 5 V 端加 100 nF + 10 µF；PTC 0.5 A；可选 SMAJ5.0A TVS。
- 编码器 0 V、调理板 GND、FPGA GND 必须同一点；不要用电机驱动器的大电流功率地做参考。
- 电机相线/驱动器输出与编码器线分开走，交叉时 90°；编码器线加磁环。

### 4.7 现成的 AD8130 差分模块能不能直接用？

**结论：默认 10 倍不能直接接；输入勉强够，输出一定削顶。**

| 项 | AD8130 模块 | 你的编码器/ADC | 判断 |
|---|---|---|---|
| 输入 | 差分，范围 ±10.5 V / G；G=10 时 ±1.05 V | 差分 2 Vpp = ±1 V | 名义上刚好，余量只有 0.05 V；1 Vpp±0.2 的容差到 ±1.2 V 就超 |
| 增益 | 默认 **10 倍**（可定制） | 需要 **2 倍** | 大 5 倍 |
| 输出 | 最大 21 Vpp（±10.5 V），单端 | AD9238 输入 ±5 V（10 Vpp） | 2 Vpp×10=20 Vpp，超一倍；±5 V 供电时更早削顶 |
| 电源 | **±5 V～±12 V 双电源** | FPGA 板只有 +5 V | 还要另做 −5 V；两个通道要两个模块 |
| 输出偏置 | 模块 REF 决定，需实测 | ADC 可接受 0 V 或 2.5 V 中心 | 接之前必须量输出直流，确保在 ±5 V 内 |

> **2.5 V 直流偏置算不算进输入范围？** 不算“差模”，但算“共模”。AD8130 的输入共模范围是 **±10.5 V**、CMRR 94 dB（dc–100 kHz），2.5 V 共模既不会占用 ±1.05 V 的差模范围，也不会被放大到输出（只留很小的共模误差）。但它必须落在共模范围内——2.5 V 对 ±10.5 V 是够的。模块表里的“最大输入只能 ±2.5 V”应理解为**差模**上限，不是每脚对地电压；如果厂家实际把它定义成“每脚对地绝对电压 ≤2.5 V”，那 2.5 V 共模加 0.5 V 摆幅到 3.0 V 就超了，这时要 AC 耦合或把共模降到 2.5 V 以下，接之前用示波器/万用表确认输出不饱和。
>
> 对 **AD9238 单端输入**则不同：2.5 V 偏置会直接把码中心抬到约 **0xC00（3072）**，`sc_correct` 的偏置校准会把它减掉；只要 2.5 V±0.5 V 在 ±5 V 内就不会削顶。若用 §4 的差分放大器，2.5 V 是共模，被差分级抑制，输出中心由 REF 2.5 V 决定，与编码器偏置无关。

- **能用的情况**：让厂家把增益改成 **2 倍**（或自己改增益电阻），并用 **±5 V** 供电，输出 4 Vpp、偏置在 ±5 V 内——这时它可以当差分转单端前端，每通道一个模块。
- **不想改增益的临时办法**：在模块输入端加 **5:1 差分衰减**（2 Vpp→0.4 Vpp，×10→4 Vpp）。但衰减网络会引入失配/噪声，且仍要 ±5 V 双电源，不如直接按 §4 搭 G=2。
- **推荐**：还是用 §4 的 4 电阻 G=2 差分放大器（单 +5 V、2.5 V 基准、10 kΩ/20 kΩ），输出 2.5 V±2 V，正好进 AD9238；AD8130 模块留给别的宽带差分场景。

---

## 5. FPGA 侧硬件连接

| 连接 | 位置 | 说明 |
|---|---|---|
| 编码器 +5 V | J5-1（+5 V） | 经 0.5 A PTC；J5-1 与 J5-3（VCCIO_B15）不是同一网络，别接错 |
| 编码器 0 V | J5-2/4（GND） | 与调理板共地 |
| 调理板 +5 V/GND | J5-1 / J5-2/4 | 同上 |
| CH1 | AD9238 模块 J1 SMA | 模块插在 J6 |
| CH2 | AD9238 模块 J2 SMA | 模块插在 J6 |
| AD9238 模块 | J6（2×26） | 模块针 1=+5 V、2/4/5=GND；J6-1=+5 V、J6-3=VCCIO_B16 |
| ABZ 输出 | J5-5/6/7（H20/G20/M21） | 3.3 V LVCMOS；长线加 26LS31 差分驱动 |
| UVW 输出 | J5-8/9/10（L21/N22/M22） | 本方案关闭 |
| SPI/UART | J5 其余脚 / USB Type-C | 2 Mbaud 遥测与寄存器 |
| JTAG | 另一个 USB Type-C（FT232） | 烧录 |

- 上电前 **J9、J10 都拨到 3.3 V**；J5-3/J6-3 是 VCCIO，不是电源输出。
- AD9238 模块的模拟输入走 SMA，不要用杜邦线飞线到 SMA 芯线；万用表量 SMA 芯线对地约 4 kΩ（模块内部分压），不是 50 Ω。
- 整板 5 V 只从 USB Type-C 串口口进；编码器 150 mA + ADC 模块约 400 mA + 板载，普通 USB2 口 500 mA 不够，用带电源 Hub。

---

## 6. 寄存器配置

### 6.1 上电后的最小配置

| 地址 | 写入值 | 作用 |
|---|---|---|
| `0x0101` | `0x0002` | `inter=2`，同时写 `0x0102=0x00`（`div=1`） |
| `0x0109` | `0x0040` | `abzen=1`、`uvwen=0`；同时写 `0x010A=0`（Z 相位默认） |
| `0x0405` | `0x0001` | 清状态/OTR 锁存 |
| `0x0502` | `0x0001` | 启动一键标定；同时写 `0x0503=0`（`CALIB_N` 低字节 0 视为 64） |

命令示例（COM 口按实际改）：

```powershell
python tools/uart_spi.py --port COM7 write 0x0101 0x0002
python tools/uart_spi.py --port COM7 write 0x0109 0x0040
python tools/uart_spi.py --port COM7 write 0x0405 0x0001
python tools/uart_spi.py --port COM7 write 0x0502 0x0001
```

> SPI 包模式一次写 `addr` 和 `addr+1` 两个字节，低字节在 `addr`、高字节在 `addr+1`。所以：
> - 写 `0x0101=0x0002` 会自动把 `0x0102` 写成 0（正好是 div=1）。
> - 写 `0x0502=0x0001` 会把 `0x0503` 写成 0（`CALIB_N` 低字节 0 视为 64，没问题）。
> - 想同时设 Z 宽度和输出使能，可写 `0x0108=0x4001`（`0x0108=1`，`0x0109=0x40`），但默认 Z 宽度 4 也能用。
> - 这些寄存器是**易失**的，每次断电后要重写；`r_output` 复位值已经是 `0x40`（ABZ 开、UVW 关），只有 `inter` 复位是 256；不想每次手工写，可把 `reg_file.v` 的 `r_inter0/r_inter1` 复位值改成 `0x02/0x00`（只对 EI58 变体），或让上位机连接时自动写。

### 6.2 关键只读/状态寄存器

| 地址 | 含义 | 正常值/判据 |
|---|---|---|
| `0x0404` | 实时状态：bit0 OTR、bit2 lag_limit、bit3 inclim、bit5 amp_low\|amp_high | 标定后 `0x00` |
| `0x0405` | W1C 锁存状态 | 写 1 清除；bit0 同时清 ADC OTR |
| `0x0530–0x0533` | `STAT_AMP_SQ`（s²+c²，Q2.30） | 标定后约 `0x51EBxxxx`（0.8 幅度，约 1.37e9） |
| `0x0534–0x0535` | 周期计数 | 随转动递增，2048/转 |
| `0x0536–0x0539` | `STAT_POS`（`{cycle,angle}` 32 位小端） | 随转动单调（换向时递减） |
| `0x053A` | flags：bit0 lag_limit、bit1 amp_low、bit2 amp_high、bit3 OTR、bit4 calib_done、bit5 calib_busy（bit7:6 保留） | 标定后 bit4=1、bit5=0、bit1/2=0 |
| `0x05F2` | `RTL_BUILD_ID` | 默认 v13=`0x000D`；EI58 变体=`0x0100` |

### 6.3 标定前 `amp_low` 亮是正常的

- 前端输出调到 4 Vpp 时（本机每腿 1 Vpp 用 G=2），ADC 幅度 819 码 → 归一化 0.4。
- 默认 `AMP_LOW_SQ = 0.6²`，所以标定前 `amp_low` 会亮；一键标定会把数字增益归一到 0.8，标定后 `amp_low` 自动清除。
- 如果标定后仍亮：检查前端增益/接线；不要用“改低 `AMP_LOW_SQ`”来掩盖，除非只是临时调试。

---

## 7. RTL 适配：2048 周期/转

### 7.1 为什么必须改

| 参数 | 默认（64 周期/转磁环） | 2048 周期/转编码器 | 不改的后果 |
|---|---|---|---|
| `POLE_BITS` | 6 | **11** | 虚拟 Z 每 64 周期一次 = 1/32 转一次（每转 32 个 Z） |
| ABZ `inter` | 256（默认） | **2** | 边沿率 175 MHz，限频/丢步 |
| UVW `pairs` | 4 | 关闭 | 每个正弦周期 4 个电周期，完全错误 |

- 2048 周期/转 × 16 位角度 = **2²⁷ = 134,217,728 计数/转**，分辨率 0.0000027°；但实际精度由模拟前端/编码器决定，不是这个数字。
- 16 位周期计数器在 2048 周期/转时只能记 32 转，正好覆盖 16 位计数范围。

### 7.2 本仓库已做的改动（`ENC_EI58` 变体）

`rtl/enc_top.v`：

```verilog
`ifdef ENC_EI58
    parameter integer POLE_BITS = 11,
`else
    parameter integer POLE_BITS = 6,
`endif
...
localparam integer CYCLE_BITS = 16;
...
`ifdef ENC_EI58
    localparam [15:0] RTL_BUILD_ID = 16'h0100;
`else
    localparam [15:0] RTL_BUILD_ID = 16'h000D;
`endif
```

- 默认构建（不定义 `ENC_EI58`）仍然是 `POLE_BITS=6`、`RTL_BUILD_ID=0x000D`，与 v13 行为一致。
- EI58 变体（`ENC_EI58` 分支展开后）是 `POLE_BITS=11`、`0x0100`。

### 7.3 构建 EI58 变体位流

Vivado 2026.1 的非工程模式不支持 `read_verilog -define`（会报 `'-define' is only supported when is_compile_unit_mode is enabled`）。因此先用 Python 把 `ifdef` 展开成一份独立 RTL，再综合：

```powershell
python tools/make_ei58_rtl.py
$env:Path = 'D:\Vivado\2026.1\Vivado\bin;' + $env:Path
vivado -mode batch -nolog -nojournal -source tools/impl_check_ei58.tcl
```

- `make_ei58_rtl.py` 把 `rtl/*.v` 复制到 `_synth_work_ei58/rtl_ei58/`，并展开 `enc_top.v`、`reg_file.v` 里的 `ifdef`；脚本自带自检（POLE_BITS=11、0x0100）。
- `impl_check_ei58.tcl` 读这份预处理 RTL，不再需要 `-define`。
- 2026-10-20 已在本机 Vivado 2026.1 构建通过：`_synth_work_ei58/enc_top_ei58.bit`，1,463,572 B；时序约束全部满足；LUT 9755/20800、FF 7579、BRAM 34/50、DSP 16。
- 输出：`_synth_work_ei58/enc_top_ei58.bit`（不覆盖 v13 的 `_synth_work/enc_top.bit`）。
- 烧录后读 `0x05F2` 应为 `0x0100`；默认 v13 为 `0x000D`。
- 如果 Vivado 报 `.Xil` 无法创建（本机沙箱/完整性级别问题），在 `_synth_work_ei58` 之类的可写目录里运行，或参考 `tools/impl_check_ei58.tcl` 顶部注释设置 `HOME/APPDATA`。

### 7.4 如果不改 RTL

- ABZ 的 A/B 仍能输出（每个正弦周期 4×inter 个边沿），速度环/位置环可以用。
- Z 每 1/32 转一次（v13），不能当每转零点。
- 只适合“先转起来”的验证，不建议作为比赛最终方案。

### 7.5 UVW 为什么不能直接用

`uvw_gen` 的输入是 **一个正弦周期内的角度** `angle`，内部：

```verilog
eang = (angle * pairs + uvwph * 2^(AW-10)) mod 2^AW;
```

即 `pairs` 是“每个正弦周期内产生几个电周期”。对 2048 周期/转的编码器，一个正弦周期 = 1/2048 转；若电机有 P 对极，每转需要 P 个电周期，折算到每个正弦周期是 `P/2048`，不是整数。

正确改法（可选，本次未启用）：

1. 用完整位置 `pos_full = cycle_cnt*2^AW + angle`（整转 2^(POLE_BITS+AW)）。
2. 取机械角 `mech = pos_full[POLE_BITS+AW-1:POLE_BITS]`（16 位）。
3. 把 `mech` 送 `uvw_gen`，`pairs=P`（电机极对数）。

这会改变默认 64 周期/转 demo 的 UVW 行为，需同步改测试台；本方案先把 `uwven=0` 关掉，用 ABZ 给驱动器。

### 7.6 真实 Z（可选）

- 编码器 Z/Z− 是差分，先经 26LS32/AM26LV32 接收成 3.3 V，再进 FPGA 备用 GPIO。
- RTL 需要：同步器、边沿检测、在第一个 Z 上锁存 `cycle_cnt`/`angle` 偏移；或者用 Z 清零周期计数器。
- 本次不做；虚拟 Z 上电位置任意，驱动器回零时需要找零/回零动作。

---

## 8. 上电、标定、验收

### 8.1 上电顺序

1. 断电，检查 J9/J10=3.3 V；万用表测 J5-1 对 J5-2/4 不短路；SMA 芯线对地约 4 kΩ（模块）。
2. 只给 FPGA 上电（USB），确认 LED0/LED1 状态；再给编码器 5 V（编码器 5 V 最好串一个拨动开关/跳线，先上 FPGA 再合上；没有开关就整机一起上电，不要带电插拔）。
3. 示波器看 CH1/CH2：2.5 V ±0.1 V 直流、4 Vpp ±0.2 V、90°±2°、无削顶。
4. 电机低速匀速（60–300 r/min），按 KEY0 或写 `0x0502=0x0001`；等 LED3 灭，读 `0x053A` bit4=1、bit5=0。
5. 读 `0x0404=0x00`；读 `0x0530` 的 `amp_sq` 约 1.3–1.4e9。
6. 转一圈：ABZ 边沿 16384±2（inter=2），Z 1 个/转（EI58 变体），`STAT_POS` 单调。
7. 接驱动器：ABZ 经 26LS31 转差分。

### 8.2 验收表

| 项 | 判据 |
|---|---|
| 5 V 电流 | <0.9 A（含 ADC 模块/编码器） |
| CH1/CH2 直流 | 2.5 V ±0.1 V |
| CH1/CH2 幅度 | 4 Vpp ±0.2 V，无削顶 |
| 相位 | 90°±2° |
| `0x0404` | `0x00` |
| `0x053A` | bit4=1（done）、bit5=0（busy）、bit1/2=0（amp） |
| `amp_sq` | 1.3–1.4e9 |
| ABZ 边沿/转 | 16384±2（inter=2） |
| Z/转 | 1（EI58 变体） |
| 静态角度噪声 | <0.02°（读 `0x0536–39` 1 s，std <约 4 LSB） |

### 8.3 标定注意

- 标定必须在电机匀速转动时做；静止会 `truncated`/`win_bad`。
- 64 个周期 = 1/32 转；60 r/min 时约 31 ms，300 r/min 时约 6 ms，足够。
- 标定后数字增益归一到 0.8；如果模拟幅度只有 0.4，数字增益 ×2，量化噪声也 ×2，不会凭空增加有效位——所以前端增益仍要够。
- 标定后如果 `amp_low` 仍亮，先查前端/接线，不要只改门限。

---

## 9. 故障排查

| 现象 | 可能原因 | 处理 |
|---|---|---|
| 上电无角度/全 0 | 编码器没供电、A/B 没进 ADC、ADC 模块没插好 | 测 J5-1 5 V、CH1/CH2 2.5 V、J6 是否插紧 |
| 角度不随转动 | A/B 接反/只接了一路、SMA 芯线断 | 示波器看两路正弦；交换 A/B 试 |
| 角度方向反 | A/B 相位顺序反 | 交换 A/B，或设 `0x0109` bit3 `abzdir` |
| LED0 亮（OTR） | 前端削顶/过幅 | 减小增益，测输出是否超过 4.8 Vpp |
| LED1 亮（amp） | 幅度不在 0.6–1.2 | 标定前 0.4 属正常；标定后仍亮查增益/接线 |
| LED2 亮（limiter） | `inter` 太大 | 写 `0x0101=0x0002` |
| Z 每 1/32 转一次 | 用的 v13 默认位流（POLE_BITS=6） | 烧 EI58 变体（`0x05F2=0x0100`） |
| 标定 done 但不稳定 | 电机速度波动/振动 | 低速匀速，检查联轴器/锥轴锁紧 |
| 5 V 掉电/复位 | USB 供电不足 | 带电源 Hub/2 A 适配器 |

---

## 10. 风险与边界

1. **1 Vpp 口径**：本机实测每腿 1 Vpp → 用 **G=2**；G=4 用于 0.5 Vpp/腿，G=8 只用于 0.25 Vpp/腿。用错增益会削顶或浪费量程。
2. **单 5 V 运放摆幅**：输出最大约 0.1–4.9 V，即 2.5 V ±2.4 V；不要指望用满 ADC 的 ±5 V。想要更高有效位，需要 ±5 V 运放电源（如 A0505S-1W）和更大增益，但本编码器 10.7 bit 已够。
3. **5 V 电流**：编码器 150 mA + ADC 400 mA + 板载，普通 USB2 口不够；劣质 Hub 会掉压/复位。
4. **UVW 不可用**：不要拿 UVW 去驱动电机；用 ABZ 或驱动器自身的霍尔/编码器换相。
5. **虚拟 Z 不可重复**：上电位置任意；需要绝对零点必须加真实 Z 输入和 RTL。
6. **锥轴安装**：M5 锁紧、M10 顶出；不要敲击、不要拉电缆；轴向/径向负载 ≤20 N；连接片要柔性，避免轴承预紧。
7. **光学器件**：IP40，防尘/防油/防冷却液；电缆出口做应力释放。
9. **高速**：5000 r/min 时基波 170.7 kHz；前端带宽、线缆长度、驱动器输入滤波都要检查；ABZ inter=2 时 1.36 MHz 边沿，长线用差分驱动。
10. **构建风险**：EI58 变体只加 `ifdef`，默认 v13 不变；但烧录前先备份 v13 位流，确认 `0x05F2` 再上电机。

---

## 11. 附录

### 11.1 快速命令卡

```powershell
# 读 ID / 版本
python tools/uart_spi.py --port COM7 read 0x05F0
python tools/uart_spi.py --port COM7 read 0x05F2

# 配置：inter=2, ABZ on, UVW off
python tools/uart_spi.py --port COM7 write 0x0101 0x0002
python tools/uart_spi.py --port COM7 write 0x0109 0x0040

# 清状态 + 标定
python tools/uart_spi.py --port COM7 write 0x0405 0x0001
python tools/uart_spi.py --port COM7 write 0x0502 0x0001

# 看状态/幅度/位置
python tools/uart_spi.py --port COM7 read 0x0404
python tools/uart_spi.py --port COM7 read 0x0530
python tools/uart_spi.py --port COM7 read 0x0532
python tools/uart_spi.py --port COM7 read 0x0536
python tools/uart_spi.py --port COM7 read 0x0538
```

> `uart_spi.py read` 每次只读 16 位；32 位量（`amp_sq`、`STAT_POS`）要读 `addr` 和 `addr+2` 两次，低 16 位在 `addr`、高 16 位在 `addr+2`（小端）。

### 11.2 与默认 64 周期/转 demo 的差异

| 项 | 默认 demo | EI58 编码器 |
|---|---|---|
| 周期/转 | 64 | 2048 |
| `POLE_BITS` | 6 | 11 |
| 虚拟 Z | 1/转 | 1/转（改后） |
| ABZ `inter` | 256（演示） | 2（4096 线） |
| UVW | 可按每周期 pairs 演示 | 关闭/需改全位置算法 |
| 位流 ID | `0x000D` | `0x0100` |

### 11.3 参考资料

- 编码器同系列资料（写 1 Vpp differential、2048 cycles/rev、500 kHz；与你这张说明书的“1 Vpp”口径可能不同，以实测为准）：  
  https://www.sfencoder.com/lm5/ei58c9-25-2048-sa5n4t-weton-58mm-9-25mm-taper-hollow-shaft-sin-cos-encoder-elevator.html
- 工程内：`docs/04_wiring_checklist.md`、`docs/06_board_test_guide.md`、`docs/AD9238_module_digest.md`、`docs/01_technical_solution.md` §6.2、`rtl/SPEC_interface_contract.md`。

---

## 12. 上位机/主机适配（容易漏）

RTL 改成 2048 周期/转后，**上位机不能仍按 64 周期/转解析**：

| 位置 | 默认（64 周期/转） | EI58（2048 周期/转） | 不改的后果 |
|---|---|---|---|
| `host/encoder.py:44` `POS_BITS` | 22 | **27** | `pos_full` 每 64 周期被掩码回绕，转速/圈数尖峰 |
| `host/encoder.py:49` `Z_INDEX_PAIRS` | 64 | **2048** | Z 占空比/频率预测错 32 倍 |
| `host/abz.py:45` `Z_INDEX_PAIRS` | 64 | **2048** | ABZ 面板 Z 速率/占空比错 |
| 界面“极对数” | 4/64 | **2048** | RPM 差 512/32 倍 |

- 本工程上位机的“极对数”字段实际按 **每转正弦周期数** 使用：EI58 填 2048，才能得到机械 RPM；它不是电机极对数 P。
- 只想用外部驱动器/PLC 读 ABZ 时，可以不改上位机。
- 若要同时兼容默认 64 周期/转 demo 和 EI58，建议按 `0x05F2` 自动识别：`0x0100` → 27/2048，`0x000D` → 22/64；`host/selftest_s2.py` 里的期望值也要同步参数化。
- 本次只改了 RTL/位流，没有改 `host/`；用本项目 GUI 时先按上表改，或告诉我，我再加自动识别。

---

**一句话**：本机每腿 1 Vpp（差分 2 Vpp），焊 **G=2**（10 kΩ/20 kΩ）差分板把输出抬到 4 Vpp；烧 `ENC_EI58` 变体（`POLE_BITS=11`），写 `0x0101=0x0002`、`0x0109=0x0040`，低速标定；ABZ 4096 线/转，UVW 关闭。
