zhaoyunfengntzx-maker/fpga-smr-encoder/docs/29_lowsig_sensor_v67.md

# 29 · v67 小信号传感器适配版（200–300 mVpp / 64 周期每转）

> **状态口径**：`[构建签核]` + `[仿真]`；**未上板**。
> **构建号**：`RTL_BUILD_ID = 0x000F`；上板读 `0x0000` 应为 `0x000F`。
> **适用硬件**：手搓正交 sin/cos 传感器，200–300 mVpp、以 0 V 为中心、64 个电周期/机械圈；AD9238 模块按
> “方案 B”改造（去 ÷5.02 衰减 + AD8138 差分增益 4.16×）。
> **不适用**：v62/v66 的 ±5 V / EI58C9 前端；`rtl/` 原文件与 `deliverables/data/v62|v66/` 的位流 **均未改动**。
>
> 配套：`docs/28_board_bringup_checklist.md`（v66 上板清单）、`deliverables/data/v67/`（本版证据）、
> `deliverables/data/README.md` §2.0b（逐文件 SHA256）。

---

## 0. 一句话

传感器只有 200–300 mVpp，改造后前端把信号放大到 ADC 满量程的 **41.6%–62.5%**；旧版默认数字增益
1.0 会把 200 mVpp 判成 `amp_low`（< 0.60 FS），`lock_sm` 停在 INIT。v67 把默认增益预置为 **1.5**、
把极对数改为 **64 周期/转**、ABZ `inter` 改为 **32**，让板子上电即可进幅值窗、锁定、再一键标定到 0.8 FS。

---

## 1. 为什么必须单独一版

| 项 | 旧版（v62/v66） | 200 mVpp 时 | 300 mVpp 时 |
|---|---|---|---|
| ADC 差分幅度 | 2 Vpp 满量程 | 0.832 Vpp = **41.6% FS** | 1.248 Vpp = **62.4% FS** |
| `amp_monitor` 判据 | 默认窗 [0.60, 1.20] FS | 0.416 **< 0.60 ⇒ amp_low 恒真** | 0.624 在窗内 |
| `lock_sm` | 需要 `amp_ok` | 停在 **INIT**，不锁定 | 可进 TRACK |
| 标定 | 可启动（不受 lock 门控） | 算出的增益约 1.92 | 约 1.28 |

关键点：**标定累加的是校正前 `s_dec/c_dec`**，所以标定结果与默认增益无关；默认增益只决定“上电到标定之前”
能不能锁定。把默认增益设成 1.5 后：

- 200 mVpp → 0.416 × 1.5 = **0.624 FS**（> 0.60，可锁定）
- 300 mVpp → 0.625 × 1.5 = **0.9375 FS**（< 1.0，16 bit 不饱和）
- 取 1.6 时 300 mVpp 到 1.0 FS，再高 1% 就削顶；1.5 留 6% 余量。

---

## 2. 硬件前提（方案 B，用户已实施）

| 位置 | 旧值 | 改造后 | 作用 |
|---|---|---|---|
| R13 | 4.02 kΩ 串联 | **短接**（建议保留 49.9–100 Ω 串阻） | 去掉 ÷5.02 衰减 |
| R15 | 1 kΩ 对地 | **不焊** | 同上，第一级增益 = 1 |
| AD8138 `Rg`（两只，两通道共 4 只） | 499 Ω | **120 Ω**（0.1% 薄膜） | 差分增益 `Rf/Rg = 499/120 = 4.16×` |
| AD8138 `Rf` | 499 Ω | 不动 | — |

- 输入必须以 **0 V 为中心**；任何直流偏置都会被 4.16× 放大，直接吃掉量程甚至饱和。
- 不削顶最大输入：`2 Vpp / 4.16 = 481 mVpp`（对 300 mVpp 有 1.6× 余量）。
- 输出每臂围绕 1.65 V，约 1.03–2.27 V；输入共模 `VCOM/NG = 0.32 V`（AD8138 规格内）。
- 上电自检：短路输入 → 2048 ± 10 码；300 mVpp → 约 **2556 码峰峰**（62.4% FS）。
- 噪声预算：输出约 27 nV/√Hz、RTI ≈ 6.5 nV/√Hz；300 mVpp 预计 SNR 58–60 dB、ENOB ≈ 10.5；
  AD8065 `Vos` 约 1 mV × 5.16 ≈ 5 mV ≈ 10 码。
- 分辨率：ADC 1 LSB = 2 V / 4096 = **488 µV**（差分）；折合 SMA 端 **117 µV**。

---

## 3. 信号预算

ADC 差分满量程 2 Vpp = 4096 码；`amp_sq` 是校正后 `s²+c²` 的 Q30 值（1.0 FS ↔ `2^30`）。

| 输入 (mVpp) | ADC 差分 (mVpp) | %FS | ADC 码峰峰 | ×1.5 后 %FS | `amp_sq` (×2^30) | 上电锁定 | 标定后 |
|---:|---:|---:|---:|---:|---:|---|---|
| 200 | 832 | 41.6% | 1704 | **62.4%** | 0.39 | TRACK | 0.80 FS |
| 250 | 1040 | 52.0% | 2130 | **78.0%** | 0.61 | TRACK | 0.80 FS |
| 300 | 1248 | 62.4% | 2556 | **93.6%** | 0.88 | TRACK | 0.80 FS |

> 200 mVpp 是下限：默认 1.5 只比 `amp_low` 门限高 4%。若实测传感器低于约 195 mVpp，见 §7 的处置。

---

## 4. 与 v66 的 4 处 RTL 差异

生成器 `tools/make_lowsig_rtl.py` 把 `rtl/*.v`（25 个）与 `rtl/eth/*.v`（8 个）复制到
`_synth_work_lowsig/rtl_lowsig/`，**只在副本上**做 4 处替换；`rtl/` 原文件逐字节不变：

| # | 文件 | v66 | v67 | 为什么 |
|---|---|---|---|---|
| 1 | `enc_top.v` | `POLE_BITS = 11` | **`= 6`** | 64 电周期/机械圈；机械角取 `pos_full[21:6]`；Z 每 64 个电周期一个 |
| 2 | `enc_top.v` | `RTL_BUILD_ID = 0x000E` | **`0x000F`** | 独立构建号，主机/上板可区分 |
| 3 | `reg_file.v` | `GAIN_S/GAIN_C = 32768`（1.0） | **`49152`（1.5）** | 上电即落在默认幅值窗，见 §1 |
| 4 | `reg_file.v` | `INTER0 = 8'd2` | **`8'd32`** | 64 周期/转 × 2×32 = **4096 个 A 沿/圈**（2048 PPR），与 `sim/tb_enc_top.v` 的 `POLEBITS_TB=6` + `0x0101=0x0020` 配置一致；若沿用 2，A 沿/圈只有 256，ABZ 会粗 16 倍 |

**保持 v66 默认值不变**的项（因此上位机不用改）：

- `AMP_LOW_SQ = (0.60)²·2^30`、`AMP_HIGH_SQ = (1.20)²·2^30`（`0x0520–23` / `0x0524–27`）
- 标定目标 `REF = 0.80 FS`，标定窗口 `CALIB_N = 64` 个电周期（64 周期/转 ⇒ **1 整圈**），
  `ARM_TMO = 1 s`
- 滤波 `FILT_K = 0x1A`（kp=2 / ki=3）、`bias_track` 默认关（`0x0122` bit1=0）、LUT 默认旁路
- UVW `pairs = 4`（`0x0100` 默认 4；这是**电机极对数**，不是 64 周期/转；不用 UVW 就写 `0x0109 = 0x40` 关掉）
- Z 宽度 `z_width = 4`（实际 5 个边沿步）

---

## 5. 构建签核

> 重建：2026-10-29 10:32–10:36（`inter=32` 版）。Vivado 2026.1，`xc7a35tfgg484-2`。

| 项 | 结果 | 证据 |
|---|---|---|
| 位流 | `_impl_lowsig/enc_top_lowsig.bit` · **1,504,428 B** · @2026-10-29 10:36:27 · SHA256 `80842AC24266393B122A954B664509807B9FF35CCFF1A6AA23A6091EB3DED2AB` | `deliverables/data/v67/` |
| 时序 | **WNS +0.282** / TNS 0.000 / **0 失败 / 24,630 端点**；WHS **+0.046** / 0 失败 / 24,165；WPWS +0.264 / 0 失败 / 8,987；`All user specified timing constraints are met.` | `impl_timing_lowsig.rpt:141-144` |
| 资源 | LUT **10,924 / 20,800 = 52.52%**（logic 10,744 + mem 180）、FF **8,705 = 20.93%**、BRAM **32 / 50 = 64%**、DSP **17 / 90 = 18.89%**、IOB 63 = 25.20% | `impl_util_lowsig.rpt` |
| DRC | **0 Errors / 0 Critical Warnings**；45 条 Warning：DPIP-1×12、DPOP-1×16、DPOP-2×17（均为 DSP 未流水建议） | `impl_drc_lowsig.rpt` |
| 布线 | 18,584 条可布线网 **18,584 全部布通、0 routing errors** | `impl_route_lowsig.rpt` |
| 位流算术 | `Bitstream compression saved 5,502,336 bits`；17,537,696 − 5,502,336 = 12,035,360 bit = 1,504,420 B + 8 B 头 = **1,504,428 B**；偏移 260 处 sync word `AA 99 55 66` | 日志 + 字节检查 |

> ⚠ 构建日志仍停在 `Bitgen Completed Successfully`：Vivado 在收尾阶段不退出（v66 同款现象），
> 位流与全部报告已落盘、哈希/长度自洽，作业由外部终止。`tools/impl_check_lowsig.tcl` 末尾已有
> `puts "IMPL_CHECK_LOWSIG_DONE"` + `exit`，但本机 Vivado 2026.1 仍偶发不响应；**不要**把“作业还在跑”
> 当成“没构建完”，以位流时间戳/哈希和报告为准。

---

## 6. 仿真验证（`[仿真]`）

`sim/tb_lowsig.v` 对 **变体 RTL** 跑 5 组场景，**35 checks 全过**（`sim/logs/tb_lowsig.log`，15 s）：

| 场景 | 激励 | 关键结果 |
|---|---|---|
| T1 | 200 mVpp，默认 1.5 | `r_gain_s/c = 49152`、`r_inter0 = 32`、`cfg_inter = 32`、`amp_ok=1`、`amp_low=0`、`cor_sat=0`、`lock_state=TRACK`、`amp_sq ≈ 0.39·2^30` |
| T2 | 300 mVpp | TRACK、不饱和、`amp_sq ≈ 0.88·2^30` |
| T3 | 250 mVpp | TRACK、`amp_sq ≈ 0.61·2^30` |
| T4 | 200 mVpp 一键标定 | `calib_done=1`、`res_gain_s/c ≈ 63076`（1.925）、`res_shift_s/c = 0`、标定后 `amp_sq = 687,355,610`（0.64·2^30 = 0.8 FS）、TRACK |
| T5 | 强制 A/B：1.0 ↔ 标定值 | 1.0 时 `amp_sq = 185,493,776`、`amp_low=1`、非 TRACK；写回 63076 后 `amp_low=0`、TRACK |

说明：

1. **标定结果 63076 与默认 1.5 无关**：标定累加的是校正前信号（200 mVpp = 0.416 FS），
   `gain = 0.8 / 0.416 = 1.923`，Q1.15 即 63076；默认增益只影响标定前的锁定。
2. `[enc_top] ERROR: 速度为正但延迟修正量为负` 是 `lag_ff` 在仿真 24.4 kHz 电频率下的符号抖动
   （3 拍延迟 vs 速度估计），只影响上报位置（遥测），不影响 ABZ/UVW/锁定。目标手转 64–128 Hz
   时 ω 小 200–380 倍，预期不触发；上板低速复核（§7）。
3. T1 等 30 个电周期（> `GOOD_N = 12500` 抽样 = 1 ms）才判 TRACK；T5 释放 `force` 后显式写回标定值，
   因为 xsim 的 `release` 不会把“只由时序 always 偶尔赋值”的 reg 回填旧值（等价上位机重写系数）。

---

## 7. 上板步骤（建议顺序）

> 先按 `docs/28` 的通用步骤做电源/串口/网口，再接传感器。v67 没有单独的 `final_verify` 分支；
> 关键判据是 `0x0000 = 0x000F`、`0x0101 = 32`、`0x0130 = 1`。

1. **读版本**：`0x0000` 应为 **`0x000F`**；`0x0101` 应为 **32**（`inter`）。
2. **UVW 先关或核对**：读 `0x0100` = 4（默认 pairs）；若驱动器不用 UVW，写 `0x0109 = 0x40` 只留 ABZ；
   若用 UVW，必须把 `0x0100` 改成电机真实极对数。
3. **接传感器 / 短路自检**：输入短路时读 ADC 码应 2048 ± 10；接 300 mVpp、0 V 偏置时约 2556 码峰峰。
   - 若读回明显偏离 2048（例如 >2100 或 <1990），先查传感器直流偏置/隔直，不要急着标定。
4. **上电锁定**：`0x0130` 应为 **1（TRACK）**；`0x0131` 的 `amp_low/amp_high` 位应为 0；
   `0x0514/15` 默认 `0xC000`（49152）。
5. **一键标定**：先让传感器转起来（≥1 圈），再写 `0x0502`；`ARM_TMO = 1 s` 等第一个周期脉冲，
   窗口 64 个电周期（64 周期/转 ⇒ 1 圈）。手转 1 圈/秒时约 2 s 完成。
   - 完成后读 `0x0514/15`：在 **200 mVpp 标定**约 **63076**（1.925）、在 **250 mVpp** 约 **50400**（1.54）、
     在 **300 mVpp** 约 **41943**（1.28）；`0x051A` 的 shift 应为 0；`amp_sq` 约 0.64·2^30（0.8 FS）；`0x0130` 仍为 TRACK。
   - ⚠ **标定幅值决定增益，幅值变化会重新越窗**：一键标定把"当前幅值"归一到 0.8 FS。若在 200 mVpp 标定
     （gain≈1.92），之后信号升到 300 mVpp 就是 1.2 FS，会削顶/触发 `amp_high`；若在 300 mVpp 标定
     （gain≈1.28），降到 200 mVpp 会掉到 0.53 FS、触发 `amp_low`。传感器幅度随间隙/位置变化时，
     **在约 250 mVpp 的中位幅值标定**：200–300 mVpp 对应 0.64–0.96 FS，全窗可用；
     或者不跑一键标定、保留默认 1.5（不做偏置/相位校正，精度取决于传感器本身）。
6. **ABZ**：A 沿 **4096/圈**、Z **1 个/圈**（`inter=32`、64 周期/转、`div=1`）。
   - ⚠ 低速 Z 宽度：`Z_TIMEOUT = 4096 clk`，电周期频率低于 **59.6 Hz** 时 Z 脉宽会被截短；
     64 周期/转 ⇒ 低于约 **0.93 转/秒** 时出现。驱动器只取 Z 边沿则无影响；要保宽度需改大 `Z_TIMEOUT`
     （v67 未改，沿用 v66）。
7. **削顶/OTR**：输入超过 481 mVpp 会削顶；`0x0405` bit0 写 1 可清 sticky OTR。若 OTR 反复置位，
   先降输入，不要只清标志。
8. **200 mVpp 仍报 amp_low**：说明模拟增益偏低或传感器 <195 mVpp。可临时把 `0x0514/15` 写到
   **1.55–1.6**（例如 50790 / 52429）再锁定；**不要超过 1.6**，否则 300 mVpp 会削顶。
   长期方案是把 `AMP_LOW_SQ` 降到 0.55² 或复核 Rg 焊接。

---

## 8. 风险与限制（如实登记）

- **未上板**：本版只有构建签核 + 仿真，没有板级实测；`docs/28` 的验收步骤必须走一遍。
- **时序余量**：`inter=32` 重建版 WNS **+0.282** / WHS +0.046、0 失败；重建前（`inter=2` 版）WNS 仅 +0.060。
  两者实现策略相同，差异来自 RTL 改动后的布局布线；未逐路径归因。若后续再改 RTL，WNS 变负不得当交付。
- **模拟增益容差**：Rg/Rf 各 1%，加上传感器幅度离散；200 mVpp 默认 1.5 只有 4% 门限余量。
- **直流偏置**：DC 耦合，传感器若有 offset 会被 4.16× 放大；必要时隔直/AC 耦合或先做偏置标定。
- **小信号噪声/量化**：300 mVpp 预计 ENOB ≈ 10.5；200 mVpp 更低。模型工况 G（20% FS）残余
  0.3131° 是保守值，本版 41.6%–62.5% FS 应更好，但未实测。
- **`lag_ff` 高速告警**：仿真 24.4 kHz 下出现符号抖动；目标 64–128 Hz 预期不触发，上板需在 64/128 Hz
  各查一次 `0x0124–26` 与 `0x0127–29`，确认无 ERROR 刷屏。
- **UVW 默认开**：`pairs=4` 是 v66 默认，不是本传感器参数；不确认就先 `0x0109=0x40` 关掉。
- **只有生产位流**：v67 没有做显示版；需要屏上 UI 时再按 `disp/enc_top_disp.v` + `ENC_DISP_TAP` 复制一版，
  本轮不承诺。

---

## 9. 复现

```powershell
# 1) 生成变体 RTL（不改 rtl/ 原文件）
python tools\make_lowsig_rtl.py

# 2) 仿真（变体目录）
powershell -NoProfile -ExecutionPolicy Bypass -File tools\run_sim.ps1 `
  -Only tb_lowsig -RtlDir _synth_work_lowsig\rtl_lowsig

# 3) 综合/实现/位流（约 10 分钟；Tcl 末尾已加 exit）
powershell -NoProfile -ExecutionPolicy Bypass -File tools\run_vivado.ps1 `
  -Tcl tools/impl_check_lowsig.tcl -LogFile _impl_lowsig/vivado.log -Tail 60
```

产物：

- `_impl_lowsig/enc_top_lowsig.bit`
- `_impl_lowsig/impl_timing_lowsig.rpt` / `impl_util_lowsig.rpt` / `impl_drc_lowsig.rpt` / `impl_route_lowsig.rpt`
- `_synth_work_lowsig/VARIANT_INFO.txt`（源 git、生成时间、4 处补丁）
- 入库副本：`deliverables/data/v67/`

---

## 10. 变更记录

| 日期 | 变更 |
|---|---|
| 2026-10-29 | 新建。方案 B 硬件（4.16×）已由用户实施；v67 生成器 4 处补丁（POLE_BITS/ID/GAIN/INTER0）；`tb_lowsig` **35 checks PASS**；重建位流 1,504,428 B（SHA256 `80842AC2…D2AB`），WNS **+0.282**，LUT 52.52%，DRC 0 Error。 |
