zhaoyunfengntzx-maker/fpga-smr-encoder/deliverables/submission/intro_and_keywords.md

# 作品简介（提交系统可直接粘贴）

**作品名称：基于FPGA的细分编码器**

本作品面向伺服驱动、数控转台与机器人关节对高分辨、抗污染位置反馈的需求，用一片 AMD Artix-7 35T FPGA 独立完成正余弦细分全信号链：双通道 12 bit 同步采样（每通道 50 MSPS，片内 ÷4 抽取与数字滤波）→ 偏置/增益/正交相位/残余位移六参数闭式校正 → 17 级全流水 CORDIC 相位解算 → II 型 PI 跟踪与增量展开 → 16 位绝对角度（16 bit/电周期），再由同一片 FPGA 并行输出 ABZ+Z、UVW、SPI 从站、UART 2 Mbaud 遥测与 1 GbE UDP，并驱动 1024×600 触摸屏诊断界面。全链路 41.5 拍、约 830 ns 的确定性延迟（设计值），适合高刚性速度环。

关键设计：六参数由一阶/二阶矩一次解算，免迭代、免查找表、免上位机试凑；Z 索引发生器用 45° 布防窗口（出 Z 后撤防，离开 ≥1/8 圈重新布防），保证停位抖动下每转严格一个 Z；正反向 UVW 用对称宽基分支消除 0/5 扇区回绕吞并；多圈计数以无符号差分零扩展累加，消除跨半量程符号扩展死锁；细分比 2…256、分频、迟滞、限频、极对数、相序、极性与输出使能全部运行期寄存器可配。

验证口径：仿真两套共 57 个测试台全部通过（`sim/` 37/37、`disp/` 20/20）；真机以 2048 周期/转磁环闭环，Z 频率 7.62/7.65 Hz ⇒ **457–459 rpm**（每转 1 个 Z），UVW 六态计数均衡（5174/4761/4423/4776/4763/4786），`lock` 稳定于 0x0301；60 s 长跑 597,886 帧 / 9,964.8 fps 不丢帧；板级角度内部一致性 offset 1.76°、RMS 0.71°、max 2.88°（`angle_vs_sc`，与外部基准无关联，不作绝对精度主张）。资源 10,978 LUT（52.78%）、32/50 BRAM、17 DSP，WNS +0.199 ns / 0 失败端点；生产位流 1,504,220 B（SHA-256 `A89512A5…`，`BUILD 0x0019`），显示位流 1,688,245 B（17,090 LUT = 82.16%、WNS +0.221，已固化 Flash，冷启动通过）。全部结论以“建模—位精确仿真—构建签核—真机判据”的证据链交付，配套 323 条 SHA-256 证据与一条命令签核。

## 关键词（5–8 个）

**磁编码器**、**正余弦细分**、**CORDIC**、**六参数闭式校正**、**ABZ/UVW 输出**、**SPI 从站**、**FPGA**

## 三个创新点（供报名表“创新关键词”栏引用）

1. **闭式自校准**——六参数一阶/二阶矩一次解算（1 个窗口 ≈64 个电周期），椭圆→单位圆，免迭代、免查找表、免上位机试凑；20 轮一键标定 20/20 一致、参数幂等。
2. **多协议高速输出适配**——ABZ+Z（边沿率 ≤12.5 MHz、f_AB ≤3.125 MHz、最小边沿 80 ns）、UVW（1…32 极对）、SPI 从站（≤12.5 MHz，32 位数据包）、UART 2 Mbaud 遥测、1 GbE UDP（28,672 点抓包）并行输出，全部参数运行期可配。
3. **FPGA 正余弦高精度细分**——面向 SMR/TMR/AMR/光电/旋变等正交信号源的通用细分引擎；17 级全流水 CORDIC（max 0.9375 LSB / RMS 0.3229 LSB，`[仿真]`）＋六参数闭式校正（复合畸变 20.9839°→0.0165°，`[仿真]`）；16 bit/电周期（2048 周期/转下机械 LSB 0.0097″）。
