zhaoyunfengntzx-maker/fpga-smr-encoder/deliverables/figures/fig1_system_architecture.pdf

## a Sensor front end

### 2048 cycles/rev

b

## FPGA — one 50 MHz clock domain

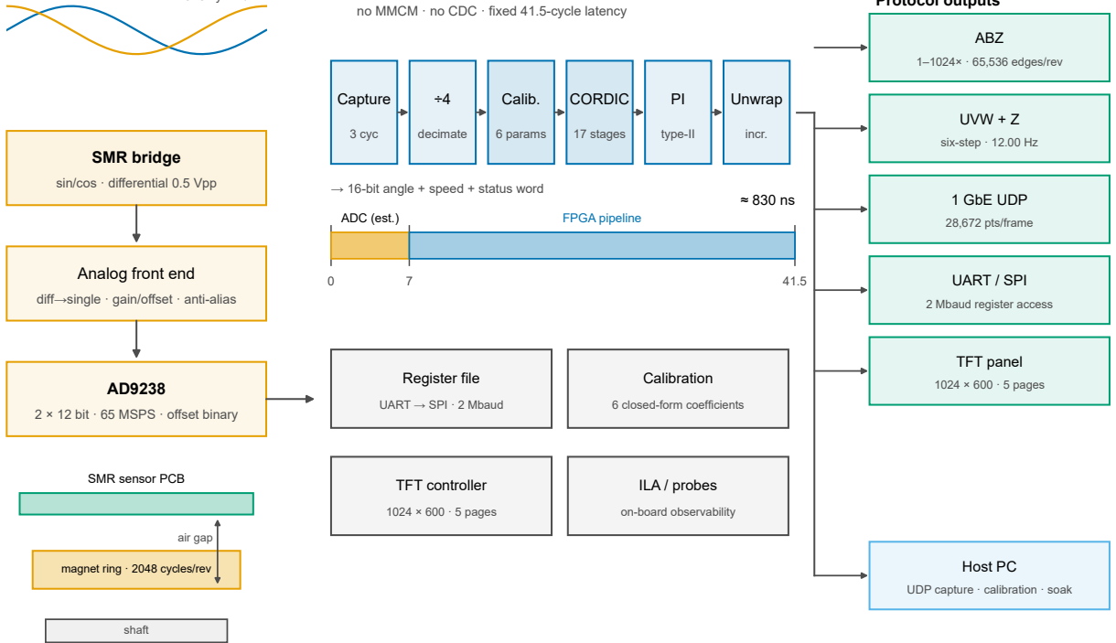
[picture p18: figure]
SMR bridge; sin/cos · differential 0.5 Vpp; Analog front end; diff→single · gain/offset · anti-alias; 2 × 12 bit · 65 MSPS · offset binary; SMR sensor PCB; magnet ring · 2048 cycles/rev; shaft; air gap; Capture; 3 cyc; decimate; Calib.; 6 params; CORDIC; 17 stages; type-II; Unwrap; incr.; → 16-bit angle + speed + status word; ADC (est.); FPGA pipeline; Register file; UART → SPI · 2 Mbaud; Calibration; 6 closed-form coefficients; TFT controller; 1024 × 600 · 5 pages; ILA / probes; on-board observability; ABZ; 1–1024× · 65,536 edges/rev; UVW + Z; six-step · 12.00 Hz; 1 GbE UDP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

### no MMCM · no CDC · fixed 41.5-cycle latency

c

## Protocol outputs
