zhaoyunfengntzx-maker/fpga-smr-encoder/deliverables/figures/fig_mech.pdf

stator (non-magnetic)

bearing | bearing

shaft

hub

magnet ring
2048 cycles/rev

SMR sensor PCB
SMR
air gap
