zhaoyunfengntzx-maker/fpga-smr-encoder/deliverables/figures/fig_pipeline.pdf

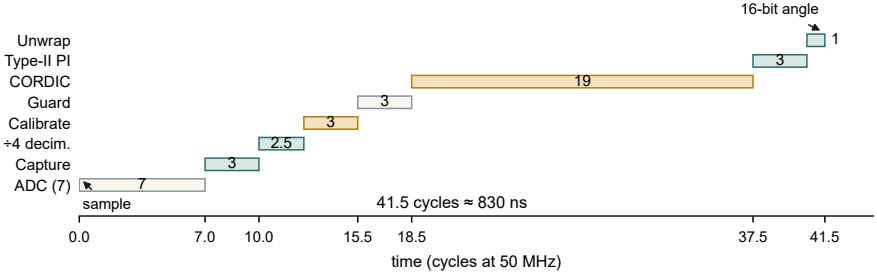
[picture p36: figure]
time (cycles at 50 MHz); ADC (7); Capture; ÷4 decim.; Calibrate; Guard; CORDIC; Type-II PI; Unwrap; sample; 16-bit angle; 41.5 cycles ≈ 830 ns
