zhaoyunfengntzx-maker/fpga-smr-encoder/deliverables/data/v90/README.md

# v90 · 交付归档（2026-11-04）

**当前交付基线**：Z 停位喘振修复（`z_index_gen`）+ 显示 UI 收敛（P2 中线预触发、三档/AUTO 时基；P7 页整页删除；P1 标定按钮删除）。

## 与 v74 的差异

| 项目 | v74 | v90 |
|---|---|---|
| `RTL_BUILD_ID` | v74 期构建号 | **`0x0019`** |
| Z 索引脉冲 | 一次出多沿（停位喘振可达 3 kHz） | `z_index_gen`：出 Z 撤防、离开 ≥1/8 圈重布防；板上严格 **1 个/转** |
| UVW | v74 版（板级验证） | **同 v74**（`e_uw`+`K=4` 去抖版在板上冻结，已回退） |
| 显示 | P7 标定页 + P1 标定按钮 | P7 整页删除、按钮删除（标定走 KEY0 / 串口 `0x0502`） |
| P2 波形 | 自由扫描 | 预触发环形缓冲 + 中线对齐 + `AUTO` 时基 |

## 构建签核

| | 生产 | 显示（带屏，**已固化 Flash**） |
|---|---|---|
| 位流 | `enc_top_v90.bit` 1,504,220 B | `enc_top_disp_v90.bit` 1,688,245 B |
| SHA256 | `A89512A506F9DE366863AC0C6BE2F740E453B32C35C6864D0D256D9C8F827125` | `69FE313C45C3F36D39307CE0948C6D0AB191183397E2408E694588FC5F81BAD4` |
| WNS / 失败端点 | +0.199 ns / 0（24,691） | +0.221 ns / 0（33,365） |
| WHS / 失败端点 | +0.017 ns / 0（24,226） | +0.049 ns / 0（32,900） |
| LUT | 10,978 = 52.78% | 17,090 = 82.16% |
| BRAM | 32/50 | 45.5/50 = 91% |

## 板上实测（2026-11-04）

- `check_v70.py COM4 3`：`RTL_BUILD=0x0019`、10.6 kfps、`r` 峰值 **0.845–0.850 FS**、UVW 六态 `{5174,4761,4423,4776,4763,4786}`（523 次/3 s）、`lock=0x0301`、`stat_flags=0x0000` ⇒ PASS
- `z_rate.py`：**7.62 / 7.65 Hz ⇒ 457–459 rpm**（每转 1 个 Z）
- `angle_vs_sc.py`：offset 1.76°、**RMS 0.71°**、max 2.88°、`|err|>5°` 0.03%
- Flash 固化 + 断电冷启动：屏正常进 P1、`RTL_BUILD=0x0019`、Z/UVW 正常
- 屏 4 页逐页人工核对（2026-11-04）：P1 四卡数值/单位不重叠且 `Z计数` 递增；P2 三档 + `AUTO` 波形左右连续、标记在中线；P4 上半 A/B 各 4 周期、下半 U/V/W 60° 台阶 + Z 竖标；P6 参数与 `S0C0` 回读一致；裸指触摸与 KEY1 翻页正常，P7 页确认不存在 ⇒ **通过**

## 验收判据

**唯一判据表**：`docs/39_acceptance_criteria_v90.md`（含 A/B/C/D/E 五类、实测值、免判项与口径说明）。

## 复现

```powershell
python tools\make_v90_rtl.py
vivado -mode batch -source tools\impl_check_v90.tcl
vivado -mode batch -source tools\impl_check_disp_v90.tcl
```
