zhaoyunfengntzx-maker/fpga-smr-encoder/7inch_UI_design_report.md

# 7 英寸 1024×600 FPGA 触摸屏编码器面板 — UI/UX 设计研究报告

> 前提：1024×600、16:9、~170 dpi（≈6.0" 对角）、GT911 电容触摸、无 GPU、手写光栅（矩形/线/1-bit 字形/少量颜色）。
> 全文所有 px 均按 170 dpi 换算：**1 px = 0.1494 mm；1 pt = 170/72 = 2.361 px**。

---

## 1. 信息架构：密集仪表盘如何拆到 1024×600

### 1.1 五种导航模式对比（针对 7" 仪器）

| 模式 | 优点 | 代价 / 7" 仪器风险 | 本设备适用性 |
|---|---|---|---|
| (a) 首页瓦片 → 详情页 | 一屏总览、层级自然；瓦片本身就是状态卡片（兼做显示） | 需要"返回"，深度 >2 层后迷路；首页占一次点击 | ★★★★★ |
| (b) 常驻标签栏 | 全局可达、零记忆成本、位置固定 | 占 56–72 px 高；>5 个标签文字必须缩短；一行标签无法表达层级 | ★★★★ |
| (c) 侧边栏 + 内容 | 竖排文字/图标空间大，适合横屏；不挤压纵向内容 | 占 80–96 px 宽（约 8–9% 像素）；手写渲染要维护两块区域 | ★★★★★（横屏首选） |
| (d) 轮播/滑动翻页 | 全屏内容、零 chrome；手势爽 | **隐藏导航**，仪表场景用户不接受"看不见入口"；手写渲染需处理滑动阈值/回弹；无动画易显突兀 | ★★（只作页面内子视图） |
| (e) 常驻主页 + 覆盖式下钻 | 采集永不离屏、故障上下文不丢失 | 覆盖层必须半透明或"局部替换"，1-bit 渲染做半透明代价高；覆盖层叠多层后返回混乱 | ★★★（只用于弹窗/确认/设置抽屉） |

### 1.2 顶层目的地数量与深度

- 顶层目标数：**4–5 个**（超过 5 个，图标+2 字中文标签在 80 px 宽的竖栏里开始认不出）。本设备实测最自然的切分就是 4 类：**总览 / 波形 / 逻辑 / 设置**，外挂 1 个"系统"溢出项。
- 深度：**≤ 2 层**（首页 → 页 → 页内子视图 Tab 或弹窗）。第 3 层（页 → 弹窗 → 子弹窗）在仪器上必然出错。
- 硬性落地规则：**常驻唯一入口**（侧栏或底栏，二选一，绝不同时用）＋**页内用 Tab 而非新页面**（子视图切换不产生返回栈）。

### 1.3 推荐方案（附理由）

**推荐：左侧垂直导航栏（80 px）＋ 总览页瓦片（3×2）＋ 页内顶部 Tab，设置用通栏右侧状态区（不是独立一级页面）。**

理由：
1. **横向像素过剩、纵向像素稀缺**。1024×600 是 1.71:1 的宽屏，所有"用高度换宽度"的导航（底栏 64–72 px）都要按比例砍内容；竖栏 80 px 只吃掉 7.8% 宽度，却释放全部 600 px 高度。
2. **首页瓦片必须是实时数据卡，不是纯入口按钮**。仪器用户 90% 的时间只看总览：频率/倍频/转速/方向/计数/ABZ 状态 6 项刚好 3×2 铺满，用户不进任何二级页就能完成日常巡检。这同时解决了"仪表盘太挤" —— 挤的不是总量，而是**同屏并列的粒度**。
3. **页内 Tab 优于新页面**。波形页的"模拟双通道 / XY 李萨如 / 缩放"是同一数据源的三种看法，用 Tab（高 40 px、3 个等宽段）切换，无返回栈，用户不会迷路。
4. **设置不是一级页面，而是"当前值的编辑态"**。倍频 2..256、分频 1..8 应该在总览页就直接可点数值 → 弹出编辑面板（stepper + 滑条 + 键盘 + 应用/取消），而不是"进设置页找到第 4 行"。危险动作（清零、清锁存故障、恢复默认）集中到"系统/维护"页，与常规浏览物理隔离。

---

## 2. 屏幕预算的硬数字（1024×600 @170 dpi）

### 2.1 触摸目标

| 项 | px | pt | mm | 说明 |
|---|---|---|---|---|
| 绝对最小（仅限非关键、间距充足） | **40** | 17 | 6.0 | 只有 `±` 微调这类旁边无邻居的才可用 |
| 推荐最小触摸目标 | **48** | 20.3 | 7.2 | 对齐 Material 3 的 48 dp 最小目标 |
| 首选主目标（按钮/列表行/导航项） | **56–64** | 24–27 | 8.4–9.6 | 手指+手套+振动工况 |
| 关键/危险动作目标 | **72–96** | 30–41 | 10.8–14.3 | "清零""清除锁存故障""应用" |
| 目标之间最小间隙 | **≥ 8**（理想 12） | 3.4/5 | 1.2/1.8 | 防误触，比目标本身更重要 |
| 字距最紧的相邻目标（如 6 通道按钮列） | 56 宽 × 64 高 | — | 8.4×9.6 | 不允许再密 |

（依据：Material 3 accessibility 规定最小触摸目标 48×48 dp 且目标间距 ≥8 dp；Microsoft 桌面触摸指南给 9 mm/0.35"≈34 px 的通用最小值作为下限参考。）

### 2.2 文字尺寸（1-bit 字形，建议 DejaVu Sans Mono Bold 光栅化）

| 角色 | px | pt | 行高 px | 用途 |
|---|---|---|---|---|
| 值 XL（Display） | **72–96** | 30–41 | 96–112 | 单值全屏：转速 / 输入频率 |
| 值 L（CardValue） | **48** | 20.3 | 56 | 卡片主数值（推荐统一 48） |
| 值 M（TableValue） | **28–32** | 12–13.5 | 36 | 六状态表、统计表数字 |
| 正文 | **20** | 8.5 | 28 | 说明、设置项、单位旁的备注 |
| 次级 / 单位（caption） | **16** | 6.8 | 20 | 单位、参数名、轴刻度 |
| 极小（仅状态栏/页脚） | **14** | 5.9 | 18 | 固件版本、时间；**不要低于此** |

> 1 pt 在这个屏上等于 2.36 px，所以"8pt 字"= 19 px，已经是可读下限。手臂距离（50–70 cm）下 ≥16 px 才不费眼；**正文一律 ≥20 px**。等宽字形保证数字不跳动（见 §3）。

### 2.3 一屏能放多少卡片 / 字段

- 卡片网格：**3 列 × 2 行 = 6 张**，卡片 305×264 px，间距 12。这是"每张卡还能放大字"的上限。
- 若卡片只放 1 个值+1 单位+小标题：可做到 4 列 × 2 行 = 8 张（卡 224×264，值降到 40 px）——**不推荐**，扫码式浏览还行，读数要费眼。
- 纯数值表：**6 行 × 4 列**（行高 28–30 px，字号 20 px）或 **5 列**（列宽 ~224 px）是舒适上限；>6 行必须分页或滚动。
- 总览页字段预算：**6 个大值 + 6 个标签 + 1 条状态条 + 1 个迷你逻辑条**。超过就是"挤"。

### 2.4 安全边距与 chrome

| 元素 | 数值 |
|---|---|
| 屏幕外边距 | **12 px**（最小），推荐 **16 px** |
| 卡片内边距 | **16 px**（左右），顶部 14 px |
| 卡片内基线间距 | 6–8 px |
| 状态栏（常驻顶部） | **高 44 px**：左 16 起页标题 20 px；右侧三个 32×32 状态点 |
| 左侧导航栏 | **宽 80 px**，竖直排列 4 项，每项 **80×88 px**（图标 32 px ＋ 标签 14 px） |
| 页面标题（内容区顶部） | 高 **44 px**（标题 24 px 左对齐，右侧放 1 个主操作按钮） |
| 底部安全区 | 最后一行卡片底距屏底 ≥ **12 px** |
| 内容区尺寸（推荐版式） | **x=80..1024（944 宽），y=44..600（548 高）** |

---

## 3. 排版与颜色

### 3.1 让数字"一眼可读"

1. **必须是等宽/tabular 字形**。比例字体会让 111 比 888 窄一半，实时刷新时整行抖动 —— 在实时仪表上这是最廉价也最致命的业余感。1-bit 字体首选 DejaVu Sans Mono Bold / IBM Plex Mono SemiBold。
2. **小数位固定**：`1500.00`、`0.00`，禁止 `1500`→`1500.5` 造成宽度跳变。数值宽度不足时左补零或固定字符格（如 `_600.00` 右对齐）。
3. **数字右对齐、单位左对齐紧跟**，一组"数字+单位"整体居中于卡片；多卡片纵向堆叠时统一右边界（用网格列对齐，不靠目测）。
4. **大值 + 小标签**：值 48 px，单位 16 px，标签 16 px（全大写或加字距）。三者的对比度梯度就是层级，不需要边框。
5. **单位放在值右侧而不是标签里**：`1500.00 rpm` 优于 `转速(rpm) 1500.00`；单位用次级色，不与数字争视线。
6. **只在必要时用科学计数/前缀**（k、M），并让前缀成为独立字符格，避免宽度跳变。
7. **轴刻度、通道名用 16 px 且只标关键刻度**（0 / 半程 / 满量程 + 当前缩放级别），别画满刻度网。

### 3.2 颜色数量与语义色板

**总共 5 种颜色 + 2 级灰**：背景、卡片、正文、次级文字、强调蓝、警告黄、故障红。（1-bit 字体下"颜色"只是字色的 3–4 个取值。）

**深色主题（暗室/机柜，推荐默认）**

| 语义 | HEX | 用途 |
|---|---|---|
| 背景 | `#0E1621` | 页面底 |
| 卡片面 | `#16202C` | 卡片填充（仅比背景亮 4%，靠 1 px `#243447` 描边分隔） |
| 描边/分隔 | `#243447` | 1 px 线、图表网格 |
| 正文 | `#E8EDF2` | 值、标签 |
| 次级文字 | `#94A3B8` | 单位、轴刻度、说明 |
| 强调蓝 | `#4C8DFF` | 可交互、选中、当前 Tab |
| 正常绿 | `#34D399` | 信号 OK、已应用 |
| 警告黄 | `#FFB020` | 待应用、超限、接近阈值 |
| 故障红 | `#FF4D4F` | 锁存故障、通信失败 |
| 禁用 | `#4A5568` | 不可用控件 |

实测对比度：正文/背景 ≈ **15.7:1**，次级/背景 ≈ **7.1:1**，蓝/背景 ≈ **6.4:1**，黄/背景 ≈ **11.1:1**，红/背景 ≈ **5.2:1**，绿/背景 ≈ **9.5:1**。

**浅色"冷静蓝"主题（明亮车间）**

| 语义 | HEX |
|---|---|
| 背景 | `#F2F5F8` |
| 卡片面 | `#FFFFFF` |
| 描边 | `#D6DEE7` |
| 正文 | `#16202C`（对比度 ≈ **14.8:1**） |
| 次级文字 | `#5A6875`（≈ **5.6:1**） |
| 强调蓝 | `#1E5FAF`（≈ **7.2:1**，用于文字/描边） |
| 交互填充蓝 | `#2F7BE0`（仅作色块，白字在其上 ≈ **4.6:1**，只用于 ≥20 px 粗体） |
| 警告 | `#8A5A00` 文字 / `#F5A623` 填充 |
| 故障 | `#C0272D` 文字 / `#E5484D` 填充 |

**明亮环境的关键结论**：TFT 亮度恒定，环境光越亮，**对比度越低**。深色主题在强光下会"发灰、看不清"（暗部被环境反射光抬起）；**白底黑字的浅色主题在车间强光下实际可读性更好，也更省背光功耗（透射式 LCD 驱动白色像素耗电更低）**。反过来，深色主题在机柜/暗室/夜间更好、更不刺眼。
→ 落地建议：**两套主题都做（成本只是两张调色表 + 一个开关），默认浅色；检测到环境光或用户手动切到深色**。别只做深色。"冷静蓝"的正确用法是：**低饱和蓝灰做背景和描边（`#F2F5F8`/`#D6DEE7`），高饱和蓝只做交互态和选中态**；不要把大面积 `#4C8DFF` 铺在亮环境里 —— 蓝是全色域中亮度最低的色相，强光下最先"洗白"。

### 3.3 不用颜色也能区分正常/警告/故障（1-bit 渲染尤其重要）

四重冗余，缺一不可：
1. **形状/字形**：正常 `●`，警告 `▲`，故障 `✖`。字形本身就能区分。
2. **文字**：状态栏/卡片永远带中文词：`正常` / `警告` / `故障` / `已锁存`。**禁止纯色块表示故障**。
3. **反转视频（reverse video）**：故障行整行红底白字（1-bit 下就是矩形填充 + 反色字，渲染成本 1 个矩形）。这是最有效的"余光可见"手段。
4. **闪烁**：仅用于**未确认的锁存故障**，2 Hz，且**必须可关闭**（用户设"闪烁告警：开/关"）。闪烁会干扰读数，且部分用户对闪光不适。

补充：色盲（约 8% 男性红绿色觉异常）在"红/绿"上完全失效 —— 所以绿/红**永远**要配字形和文字。对比度目标：正文 ≥ 4.5:1（WCAG AA），**关键实时读数 ≥ 7:1**（WCAG AAA），触摸目标无对比度要求但边框与底色要能分辨。

---

## 4. 触摸仪器的交互规则

### 4.1 什么必须先确认

**必须二次确认（不可逆 / 打断测量 / 危险）**
- 清除锁存故障（清完无法回看，且可能掩盖根因）
- 计数器/累计转数清零
- 恢复出厂设置、写入/擦除预设
- 修改会打断闭环控制或引起机械动作的倍频/分频（若该参数在线生效且驱动轴）
- 关闭报警输出/使能

**不需要确认（可逆、无副作用）**
- 切换页面、切换 Tab、切换图表缩放
- 临时改动尚未"应用"的编辑值（在弹窗里改，未点应用前没有副作用）
- 视图类开关（网格、游标、通道显隐）

**确认控件本身的设计**：确认对话框的主按钮文案必须**描述动作**（`清除故障` 而不是 `确定`），危险按钮放**右侧或下侧**、用故障色、与取消按钮间距 ≥ 16 px；标题写"要做什么"，正文写"后果"，例如"清除锁存故障？将无法查看本次故障记录"。

### 4.2 直接操作 vs 模态对话框

- **直接操作优先**：视图切换、缩放、通道显隐、Tab —— 点了就变，无对话框。
- **模态仅用于 3 类**：危险确认、数值编辑（需要键盘/滑块）、错误详情。**波形页弹出模态时必须保持波形在背景继续绘制**（模态只遮住下半部分或做半透明遮罩），仪器用户不能接受"弹窗挡住了正在看的信号"。
- **绝不用模态做常规设置**。设置项直接内联在"设置"页，改完即生效或点行尾"应用"。
- **禁止模式（mode）**。不要有"配置模式 vs 运行模式"这种全局状态让界面换一套含义 —— 用户会在错误模式里做错误操作。若必须有"标定模式"，用**整屏颜色反转 + 顶部通栏警示条**把它显式化，并自动超时退出（如 5 分钟）。
- 平台依据：Apple HIG 明确"模态要克制使用、只在必须打断用户时用"（Layout / Modality / Buttons / Tab bars 章节）；Material 3 的 accessibility 与 "Confirmation & acknowledgement" 模式给出了最小触摸目标、破坏性动作用色与确认文案的规则。

### 4.3 整数"倍频 2..256"用什么控件（步进 / 滑条 / 键盘）

4096 是 2..256 的**14 个 2 的幂**，加上常用整数，这是**分段离散步进**的典型场景，不是连续滑条场景。

**结论：步进器为主 + 离散滑条为辅 + 数字键盘为兜底 + 长按加速。**

- **步进器（`− 64 +`）**：点 `+` 走预设档位 `2,4,8,10,16,20,32,40,64,80,100,128,200,256`。单次 72×72 px 按钮，值显示 64 px 在中间。
- **长按加速**：按住 `+`/`−` > 400 ms 进入连发（100 ms/次），> 1.2 s 进入粗调（档位跳 2 级）。这是把 14 档压缩成两次操作的唯一办法。
- **离散滑条**（可选，视高度）：仅当档位 ≤ 14 且轨道 ≥ 600 px 时可用 —— 14 档 / 600 px = 43 px 一档，勉强可控；**256 档连续滑条在这个屏幕上不可用**（每档 < 4 px，手指精度约 ±8 px）。滑条必须**吸附到档位**并显示刻度。
- **数字键盘**：值区域可点击 → 弹 3×4 键盘（键 72×64 px，含 `取消`/`清空`/`确认`）。**只在知道确切的用户会用**，但它必须存在（工程师要"直接输 100"）。
- 滑条在手指上的可用性要点：**拇指 44×44 px 以上、轨道 ≥ 8 px 高、命中区扩展到轨道上下各 16 px**、拖出轨道范围不丢焦点、松手立刻生效（或松手才提交，见下）。Material 3 把滑条分为 continuous（主观强度）与 discrete（明确档位）：本设备倍频属于 **discrete**，必须吸附 + 显示数值标签。

### 4.4 立即生效于硬件的值怎么写

推荐**两阶段提交 + 回读确认（two-phase commit + readback）**：

1. 用户改值 → 界面进入 **pending**：值用警告黄显示，旁边小字 `待应用`，并出现 `应用`（72 px 高，强调蓝）与 `取消` 两个大按钮。**此时硬件未动**。
2. 点 `应用` → 发命令 → 状态胶囊变 `应用中…`（蓝色）。FPGA 回读寄存器，**显示实际生效值**而不是用户输入值。
3. 200–300 ms 内回读到期望值 → 值转正文色，胶囊变 `已应用 ✓`（绿），2 s 后淡出。
4. 回读不符/超时 → **自动回滚显示回读值**，胶囊变 `失败 ✖`（红），附可点开的错误码（如 `E03 参数越界`）。**不要弹模态阻塞**，用状态条内的常驻错误项 + 状态栏红点。
5. 若参数在线生效且会影响轴运动，则第 3 步前插入二次确认。

反例（必须避免）：改一下立刻下发、失败后界面仍显示用户想要的理想值 —— 这是仪器软件最常见的信任杀手。

### 4.5 成功/失败、撤销

- **成功**：状态栏/卡片内的**内联状态胶囊**（不是弹窗），文字 + 字形 + 颜色三重编码。2–3 s 自动消失，但**"已应用"的最终值永久留在界面上**。
- **失败**：**持久**显示直到用户处理；同一位置不允许被下一次成功提示覆盖。
- **撤销**：对可逆操作提供 **Snackbar 式 5 s 撤销**（"已清零 · 撤销"，撤销按钮 72 px 高）。对不可逆操作**不提供假撤销** —— 改为事前确认。
- **长按（long-press）适合什么**：① 需要"防误触但不必弹窗"的高频操作（长按 1.5 s 计数清零，环形进度条填充作反馈）；② 键盘/滑条的连续加速（见 4.3）；③ 数值区域的"直接输入"入口。**不适合**：作为唯一入口的隐藏功能（长按是不可发现的），以及长按确认 + 弹窗确认叠加（双重摩擦）。

---

## 5. 值得抄的真实仪器 UI（含可偷的具体设计）

| # | 参考 | 该偷的一点 |
|---|---|---|
| 1 | Keysight《Touch Screen Revolution in Test & Measurement》应用说明 —— [文档页](https://www.keysight.com/us/en/assets/7018-04719/application-notes/5992-0470.pdf) | 大屏仪器触摸化的官方抓手清单：区分**单点电阻屏**（只能点）与**多点电容屏**（可捏合缩放/拖拽/双指），并明确"触摸应加速操作而非替代面板"。对本项目：**只用你真正实现得了的手势**，捏合缩放若 FPGA 上实现不了就不要放进说明与界面。 |
| 2 | Tektronix 5 系列 MSO（触摸示波器） —— [用户手册](https://download.tek.com/manual/5SeriesMSO-MSO54-MSO56-MSO58-MSO58LP-User-Manual-077130204.pdf) | **测量结果徽标紧贴波形边缘**、屏幕上的**垂直/水平游标**、右侧滑出设置面板、以及"所有设置项都能在屏上完成"。偷：波形页不要单独做"测量列表"，把 Vpp/频率/相位用小徽标贴在波形右下角。 |
| 3 | Rigol MSO5000 用户指南 —— [手册](https://www.batronix.com/pdf/Rigol/MSO5000_UserGuide_EN.pdf) | 密集但有序的**状态栏 + 底部菜单键 + 页签**三级结构，以及"每屏一个主图 + 一行软键"。偷：软键行（soft-key row）比一堆小按钮更好按，且天然把"当前页有哪 5 个操作"讲清楚。 |
| 4 | 专业音频（Ableton Push / Elektron） —— [Elektron 产品页](https://www.elektron.se/en/) | **一位大数字 + 极小标签**的读数风格；**步进器 + 按下旋转/长按加速**；面板上只留一个高亮色（橙/绿）表示激活。偷：值 48–72 px + 标签 16 px 的对比，和"只用一个强调色"。 |
| 5 | 汽车车机（BMW iDrive / Tesla） —— [NHTSA 车载 HMI 指南 PDF](https://www.nhtsa.gov/sites/nhtsa.gov/files/documents/812447_distractionguidelines.pdf) | NHTSA 的**分心最小化规则**：单次瞥视时长上限、任务总时长上限、**文本必须能一眼扫读**、禁止滚动文本、控制项位置固定。偷：把"用户在波形页看一眼要花多久"当作设计约束 —— 总览页 6 张卡的扫读时间必须 < 2 s。 |
| 6 | 航电（Garmin G1000 / 罗克韦尔·柯林斯） —— [G1000 手册 PDF](https://static.garmin.com/pumac/G1000_Integrated_Flight_Deck_System_Line_Maintenance_Manual.pdf) | **软键行 + 页面组（PFD/MFD/ENGINE）+ 单色高密度 + 反白告警框 + 主警示/次警示两级**。偷：两级告警（MASTER WARNING 红反白 / CAUTION 黄）与"软键行"（对应 §7 的底/顶功能行）。 |
| 7 | 医疗监护（Philips IntelliVue / Dräger） —— [Philips 说明书 PDF](https://www.philips.com/asset?identifier=4522_4522%2520-%2520M8000%2520Series%2520Instructions%2520for%2520Use) | **参数卡（parameter block）＝ 大数字 + 单位 + 可配置告警上下限 + 右对齐**，以及 IEC 60601-1-8 的**告警三属性：颜色 + 闪烁频率 + 声音可区分**。偷：每个数值条目自带"上下限"提示（超限时值的右侧出现 ▲ 或 ▼ 与限值），不靠弹窗报超限。 |
| 8 | 相机菜单（Sony α / Canon） —— [Sony 帮助指南](https://helpguide.sony.net/ilc/1930/v1/en/index.html) | **网格菜单（顶层 5–6 个色块区 + 区内 4×3 图标）替代长列表**；设置项的"当前值"直接显示在行右侧。偷：设置页用 3 列网格而不是长滚动列表，一屏放 12 项，每项行高 88 px 且右对齐显示当前值。 |
| 9 | 变频器面板（Danfoss LCP102 / ABB） —— [Danfoss LCP102 资料](https://www.ledcontrols.co.uk/variable-speed-drives/130b1107-graphic-display-lcp102.html) | 手持/面板式驱动的经典：**Hand/Off/Auto 三态显式化 + 数字大屏 + 状态行**，运行/就绪状态用大字而非图标。偷："本地/远程/停止"这类**模式**必须做成常驻可见的三段控件，而不是藏在菜单里。 |
| 10 | 可编程控制器/CNC 面板（Fanuc MPG / Siemens） —— [产品与手册页](https://www.siemens.com/global/en/products/automation/systems/cnc-sinumerik.html) | **物理/平面快捷键固定**、轴选择与倍率（×1/×10/×100）分层步进。偷：倍率类参数必须有"粗/细"两级进给，这是 §4.3 长按加速的工业先例。 |
| 11 | 工业 HMI 指南（Grundfos / Phoenix Contact / Siemens WinCC 风格指南） —— [Siemens WinCC 文档](https://support.industry.siemens.com/cs/document/109760589) | **画面上限原则**：单页元素数量控制、颜色语义化（灰=非活动、白=活动）、报警页与趋势页分离。偷：把"颜色语义表"写进项目规范并在代码里做成常量，禁止随手取色。 |
| 12 | Apple Human Interface Guidelines —— [HIG 总入口](https://developer.apple.com/design/human-interface-guidelines/) | 具体适用条目：**Layout**（页边距与可读宽度）、**Tab bars**（顶层导航 5 个上限、常驻可达）、**Buttons**（最小命中区）、**Alerts/Modality**（模态克制、破坏性动作需明确确认）、**Feedback**（每次操作必有反馈）。这些原则与大屏手机一致，可直接借用其"目标尺寸/间距/层级"的定量表格。 |

---

## 6. 反模式：让仪器界面显得业余的 8 个具体错误

1. **把桌面 Qt 多卡片仪表盘按比例缩放** → 文字缩到 8–10 px、触摸目标 < 30 px。根治：**重新做信息预算**（6 个值 + 4 页），而不是重排原布局。
2. **比例字体跑实时数字** → 数值刷新时整行左右抖动，读数时会"眼跳"。必须等宽字体 + 固定小数位。
3. **颜色当唯一状态编码**（纯绿点/红点表示正常/故障）→ 强光 + 色觉异常下完全失效。必须字形 + 文字 + 反转视频 + 可选闪烁。
4. **纯装饰性渐变/阴影/圆角/斜体** → 手写渲染里每个圆角都是几十次像素判定，且视觉上"轻浮"。仪器审美 = 平色 + 1 px 分隔线 + 对齐 + 留白。
5. **把危险动作放进常规列表**（"清零"紧挨"下一页"）→ 误触不可逆。危险动作必须：独立页面/独立区域 + 更大目标 + 颜色区分 + 二次确认 + 描述性文案。
6. **模态弹窗盖住正在采集的波形/实时值** → 用户失去上下文。模态只能占屏幕下半或做半透明遮罩，且实时数据继续绘制。
7. **没有"正在生效 / 已生效 / 失败"的收敛态**：界面显示的是用户想要的，不是硬件实际的。必须有回读与回滚。
8. **空态与异常态缺失**：无信号时显示 `0.00` 而不是 `— 无信号`；通信断开时波形停住却不提示；上电瞬间显示上次残留值。**空态/错态/加载态**三态是仪器可信度的分水岭。
   （附加第 9、10 条若还有空间：**导航入口隐藏**（滑动翻页无指示）、**同屏两个导航系统**（侧栏 + 底栏同时存在）。）

---

## 7. 具体落地方案（1024×600，像素坐标）

### 7.1 公共骨架

```
┌──────────────────────────────────────────────────────────────────────────┐  y=0
│ STATUS BAR  y=0..44                                                       │
│ [页面标题 20px]                    [信号 ●32px] [告警 ▲32px] [系统 ⚙32px]│
├────────┬─────────────────────────────────────────────────────────────────┤  y=44
│ NAV    │ PAGE TITLE  y=44..88     x=80..1024                              │
│ RAIL   │ [标题 24px]                              [主操作按钮 高40 宽160] │
│ w=80   ├─────────────────────────────────────────────────────────────────┤  y=88
│ x=0..80│ CONTENT  x=80..1024 (w=944), y=88..600 (h=512, 上/左/右留12)     │
│        │ ┌──────────┐ ┌──────────┐ ┌──────────┐                           │
│ 首页   │ │ CARD     │ │ CARD     │ │ CARD     │  卡片 300×264             │
│ 80×88  │ │ 300×264  │ │ 300×264  │ │ 300×264  │  列 x=92 / 404 / 716      │
│        │ └──────────┘ └──────────┘ └──────────┘  行 y=100 / 372           │
│ 波形   │ ┌──────────┐ ┌──────────┐ ┌──────────┐  列间距 12，行间距 8      │
│ 80×88  │ │ CARD     │ │ CARD     │ │ CARD     │  右边距 = 1024−1016 = 8   │
│        │ └──────────┘ └──────────┘ └──────────┘  底边距 = 600−636→ 见 7.2 │
│ 逻辑   │  校验: 92+300=392 +12=404；404+300=704 +12=716；716+300=1016      │
│ 80×88  │  校验: 100+264=364 +8=372；372+264=636                                │
└────────┴─────────────────────────────────────────────────────────────────┘  y=600
```

**卡片内部结构（统一模板，1 张 300×264 的统计卡）**

```
y+16   ┌ 标签 16px  #94A3B8                    ┐  ← 行高 20
y+44   │ 数值 48px  #E8EDF2 (等宽右对齐)  rpm  │  ← 值行高 56，单位 16px 次级色
y+110  │ ── 1px 分隔线 #243447 (卡内 16..284)  │
y+120  │ 次级信息 16px：如 "÷1  电气 600.00 Hz" │  ← 行高 20
y+148  │ 迷你状态条 高 24：●正常                │
       └────────────────────────────────────────┘
```

### 7.2 页面集与页数

**共 6 个页面**（4 个在导航栏，1 个由卡片下钻，1 个在状态栏 ⚙ 溢出）。

| # | 页面 | 入口 | 关键尺寸 |
|---|---|---|---|
| P1 | **总览** | 导航栏"首页" | 3×2 卡片，卡 300×264，列 x=92/404/716，行 y=100/372（右余 8 px，下余 8 px） |
| P2 | **波形** | 导航栏"波形" | 顶部 Tab 3 段（模拟 / XY / 缩放）高 40；绘图区 944×440 |
| P3 | **李萨如 XY** | P2 的 Tab | 绘图区 560×560 居中（x=232..792，y=140..600） |
| P4 | **逻辑时序 + 驻留** | 导航栏"逻辑" | 时序图 944×340（y=100..440）＋ 统计表 3 列表（y=452..600） |
| P5 | **六状态表** | P4 表格点击"展开" | 6 行 × 5 列，行高 30，列宽 188 |
| P6 | **设置 / 维护** | 状态栏 ⚙ | 3 列 × 4 项网格，项高 88；底部危险区 944×96 |

### 7.3 P1 总览页 6 张卡的字段分配

1. **输入频率** — 值 48 px `1500.00` + `Hz`；次级 `倍频 ×64  分频 ÷1`
2. **倍频 / 分频** — 值 `×64` + `÷1`（**可点，直接弹编辑面板**，这是唯一的设置热点）
3. **转速** — 值 `1800.0` + `rpm`；次级 `电气频率 1600.00 Hz`
4. **方向 / 相位** — 值 `CCW` / `+45.0°`；值用文字而非箭头颜色
5. **累计转数** — 值 `12 345 678` + `rev`（8 位数，48 px 等宽 = 8×29=232 px 宽，卡内 268 px 可容纳宽裕）
6. **ABZ / UVW 状态** — 值 `A● B● Z○` / `U V W`；底部 **迷你 6 通道逻辑条**（每通道高 16，6×16+5×4=116 px，宽 268）

> 交互：卡片 2 的整张卡可点（命中区 300×264，远大于 48 px）→ 弹出**编辑面板**（不是新页面）：`[−] 64 [+]` + 离散滑条 + `键盘` + `取消/应用`。这是"总览页也能改参数"的关键，用户不需要进设置页。

### 7.4 下钻路径（全部 ≤ 2 层）

```
P1 总览 ──点卡片2────────────→ 编辑面板(模态, 下半屏) ──应用──→ 回 P1, 值转绿
   │                              └─取消──→ 回 P1
   ├─导航"波形"→ P2 ──Tab"XY"──→ P3
   │                └─Tab"模拟"─→ 双通道 944×440，通道A y=140..340，通道B y=360..560
   │                               右下角徽标：Vpp / f / Δt / ΔV（各 88×32）
   │
   ├─导航"逻辑"→ P4 ──点表格标题"展开"──→ P5 六状态明细
   │
   └─⚙ 系统 → P6 设置 ──危险区:"清零计数""清除锁存故障""恢复默认"──→ 确认对话框
```

### 7.5 P4 逻辑页精确坐标

- 时序图外框：x=92..1004（944 宽）、y=100..440（340 高）。
- 左侧通道标签栏 x=92..180（88 宽），通道名 20 px 居中；轨迹区 x=180..1004（824 宽）。
- 6 条通道，每条 **50 px**：`A` y=112、`B` y=162、`Z` y=212、`U` y=262、`V` y=312、`W` y=362（按 40 px 间距留 10 px 视觉间隙，实际绘制按 50 均分）。
- 时间窗：显示最近 **200 ms**（在 824 px 上 = 4.12 px/ms）。
- 时间轴刻度：仅 3 处 —— 左端 `−200ms`、中点 `−100ms`、右端 `0`，16 px。
- 统计表：x=92..1004、y=452..600，表头 28 px，数据行 3 行 × 28 px（`状态` 宽 200 / `时间` 宽 400 / `占比` 宽 344），表头 `状态 | 驻留时间 | 占比 %` 16 px 次级色，数字 20 px 等宽右对齐。

### 7.6 P5 六状态表精确坐标

- 区域 x=92..1004、y=100..600。表头行 y=100..132（高 32，字号 20 加粗，底色 `#16202C`）。
- 数据 6 行 × 30 px：y=132/162/192/222/252/282（最后到 312，余下 288 px 留给"状态含义说明"与图例，不要留白）。
- 列宽：`状态` 200（x=92）、`驻留时间` 280（x=292）、`占比 %` 180（x=572）、`进入次数` 120（x=752）、`条形图` 132（x=872）。**加条形图列**：用 2 px 高的纯色矩形表示占比，比数字更快读。
- 行悬停/点击 → 高亮整行（反转视频），并在下方说明区显示该状态的含义。

### 7.7 针对手写渲染的成本控制（顺带的实现约束）

- **脏矩形 + 双缓冲**：只有值变化时重绘该卡片的数值矩形（约 200×56），全屏只在切页时重绘。
- **波形每帧只做**：清 1 个绘图矩形 + 画 1–2 条折线（N=500 点时每 2 px 取一点，用垂直短线填充，比逐点画更快）。网格线（1 px `#243447`）静态位图缓存，不重画。
- **迷你逻辑条 / 状态点**：以 8×8 字符块缓存成小位图，直接 blit。
- **字体**：只用 **1 套字族 × 4 个尺寸**（16/20/28/48），额外一个大号 72 只在需要时加载。字形表按需驻留，避免全字库占 BRAM。
- **色数**：每页最多 5 色 + 2 级灰；主题切换只需换一次调色表指针。

---

## 8. 一句话结论

把 6 个一级指标做成 3×2 卡片首页（每个值自己就是入口）、用 80 px 左侧导航放 4 个一级目标、页内一律 Tab 不下钻新页、危险动作独立成页并二次确认、所有实时数字等宽等宽、状态用"字形+文字+反转视频+可选闪烁"四重编码、硬件参数走"待应用→应用中→已应用/失败回滚"两阶段提交 —— 这样 1024×600 上 6 个值 + 4 个页面就够，既简洁又不像缩小的桌面软件。

---

### 参考来源

- Keysight,《Touch Screen Revolution in Test & Measurement》(5992-0470): https://www.keysight.com/us/en/assets/7018-04719/application-notes/5992-0470.pdf
- Tektronix 5 系列 MSO 用户手册: https://download.tek.com/manual/5SeriesMSO-MSO54-MSO56-MSO58-MSO58LP-User-Manual-077130204.pdf
- Rigol MSO5000 用户指南: https://www.batronix.com/pdf/Rigol/MSO5000_UserGuide_EN.pdf
- Material Design 3 — Accessibility（48 dp 最小触摸目标、8 dp 间距）: https://m3.material.io/foundations/accessible-design/accessibility-basics
- Material Design — Sliders（continuous vs discrete、可编辑数值）: https://m1.material.io/components/sliders.html
- Material Design — Confirmation & acknowledgement: https://m1.material.io/patterns/confirmation-acknowledgement.html
- Material Design — Navigation（导航层级与目标数量）: https://m1.material.io/patterns/navigation.html
- Apple Human Interface Guidelines（Layout / Tab bars / Buttons / Alerts / Feedback）: https://developer.apple.com/design/human-interface-guidelines/
- Apple HIG — Layout: https://developer.apple.com/design/human-interface-guidelines/layout
- Apple HIG — Tab bars: https://developer.apple.com/design/human-interface-guidelines/tab-bars
- W3C WCAG 2.1 — Contrast Minimum / Enhanced（4.5:1 / 7:1）: https://www.w3.org/WAI/WCAG21/quickref/#contrast-minimum
- Microsoft — Touch (desktop guidance，9 mm 最小): https://learn.microsoft.com/en-us/windows/apps/design/input/touch
- NHTSA — Visual-Manual NHTSA Driver Distraction Guidelines: https://www.nhtsa.gov/sites/nhtsa.gov/files/documents/812447_distractionguidelines.pdf
- Garmin G1000 手册（软键行、主/次告警）: https://static.garmin.com/pumac/G1000_Integrated_Flight_Deck_System_Line_Maintenance_Manual.pdf
- Philips IntelliVue M8000 系列说明书（参数卡与告警三属性）: https://www.philips.com/asset?identifier=4522_4522%2520-%2520M8000%2520Series%2520Instructions%2520for%2520Use
- IEC 60601-1-8 医用电气设备报警系统（颜色/闪烁/声音可区分）
- Danfoss VLT LCP102 图形显示面板: https://www.ledcontrols.co.uk/variable-speed-drives/130b1107-graphic-display-lcp102.html
- Siemens SINUMERIK / WinCC 工业 HMI 规范: https://support.industry.siemens.com/cs/document/109760589
- Sony 相机帮助指南（网格式菜单）: https://helpguide.sony.net/ilc/1930/v1/en/index.html
- Elektron 产品（专业音频读数与步进器风格）: https://www.elektron.se/en/
