zhaoyunfengntzx-maker/fpga-smr-encoder/deliverables/figures/block_diagram.png

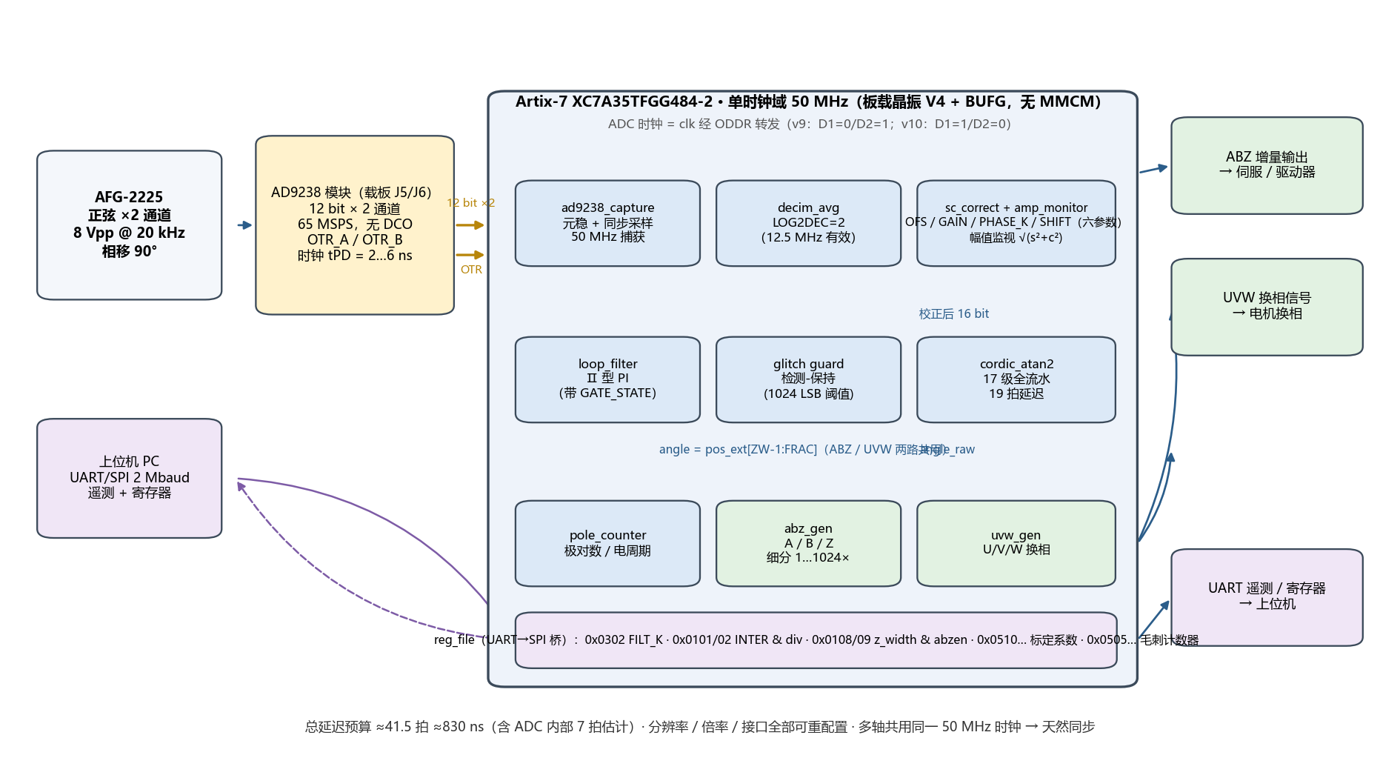
deliverables/figures/block_diagram.png
