zhaoyunfengntzx-maker/fpga-smr-encoder/deliverables/figures/capture_envelope.png

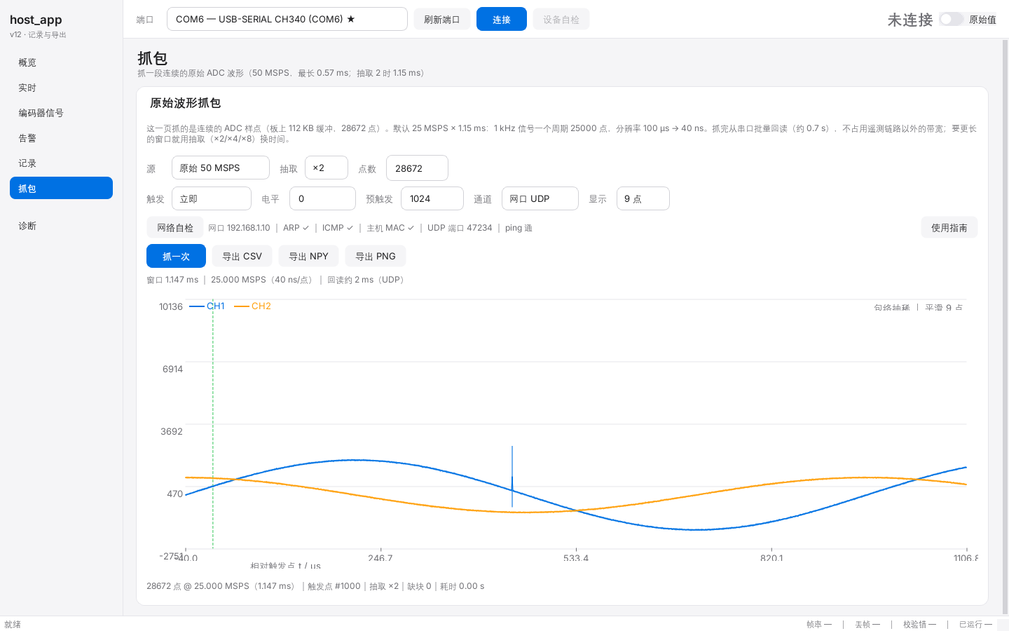
deliverables/figures/capture_envelope.png
