zhaoyunfengntzx-maker/fpga-smr-encoder/deliverables/figures/fig_abz_timing.png

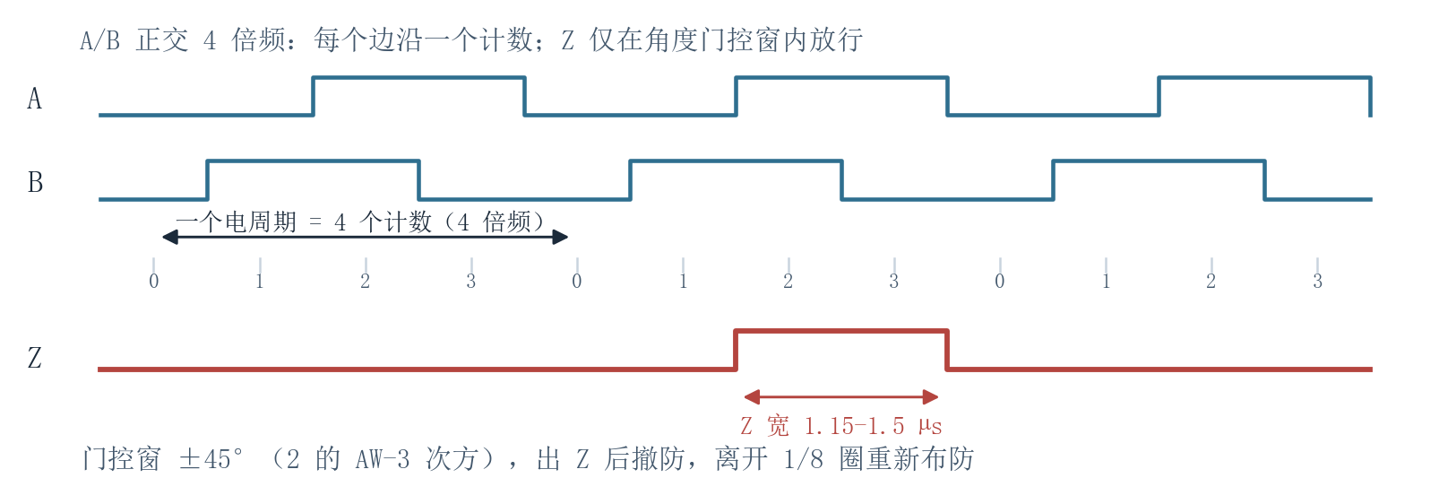
deliverables/figures/fig_abz_timing.png
