zhaoyunfengntzx-maker/fpga-smr-encoder/deliverables/figures/fig_abz_uvw.png

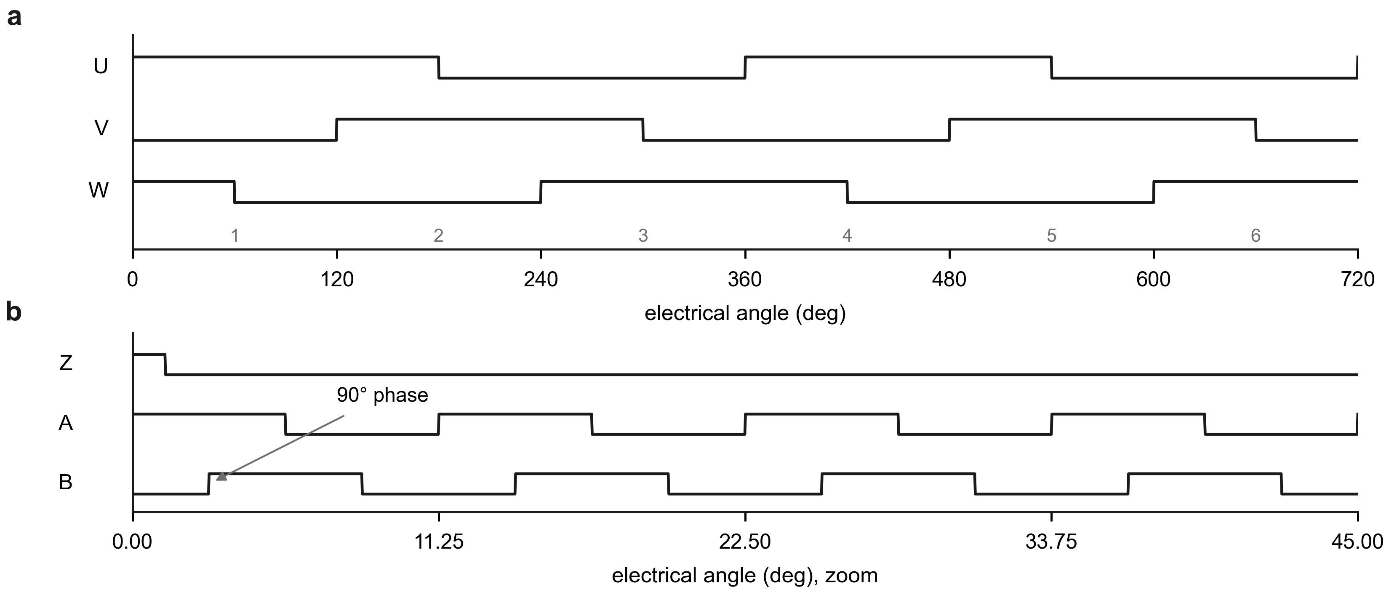
deliverables/figures/fig_abz_uvw.png
