zhaoyunfengntzx-maker/fpga-smr-encoder/deliverables/figures/fig_calib_geometry.png

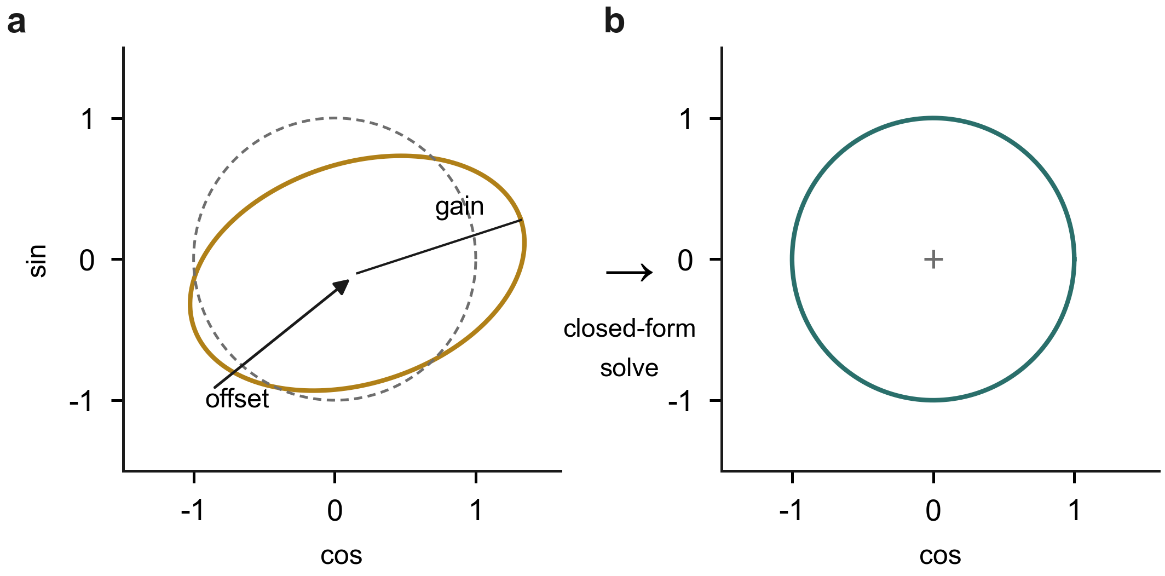
deliverables/figures/fig_calib_geometry.png
