zhaoyunfengntzx-maker/fpga-smr-encoder/deliverables/figures/fig_chain_v2.png

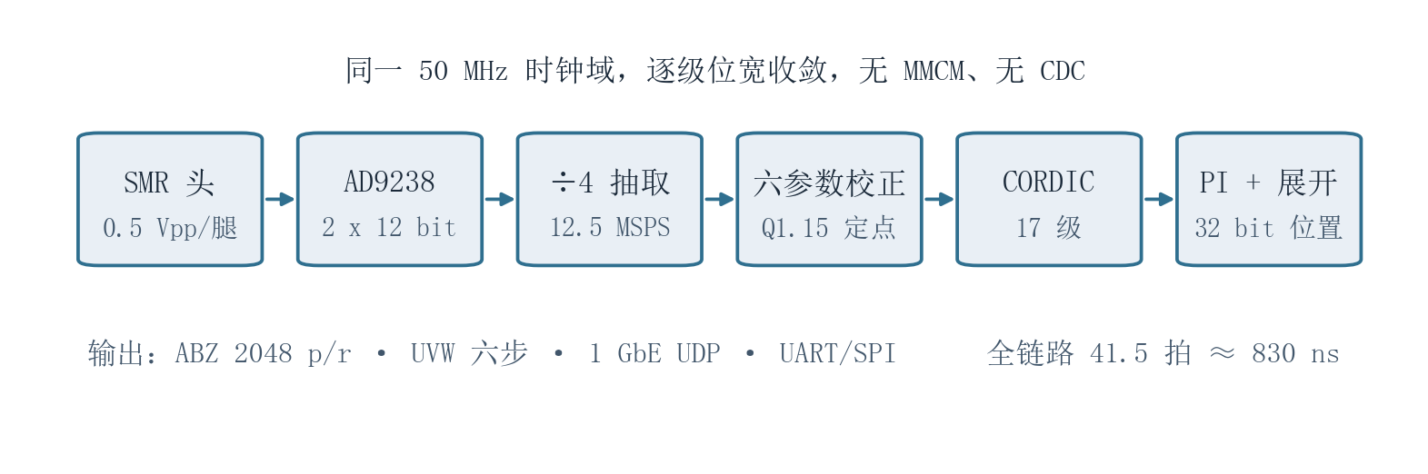
deliverables/figures/fig_chain_v2.png
