zhaoyunfengntzx-maker/fpga-smr-encoder/deliverables/figures/fig_cordic.png

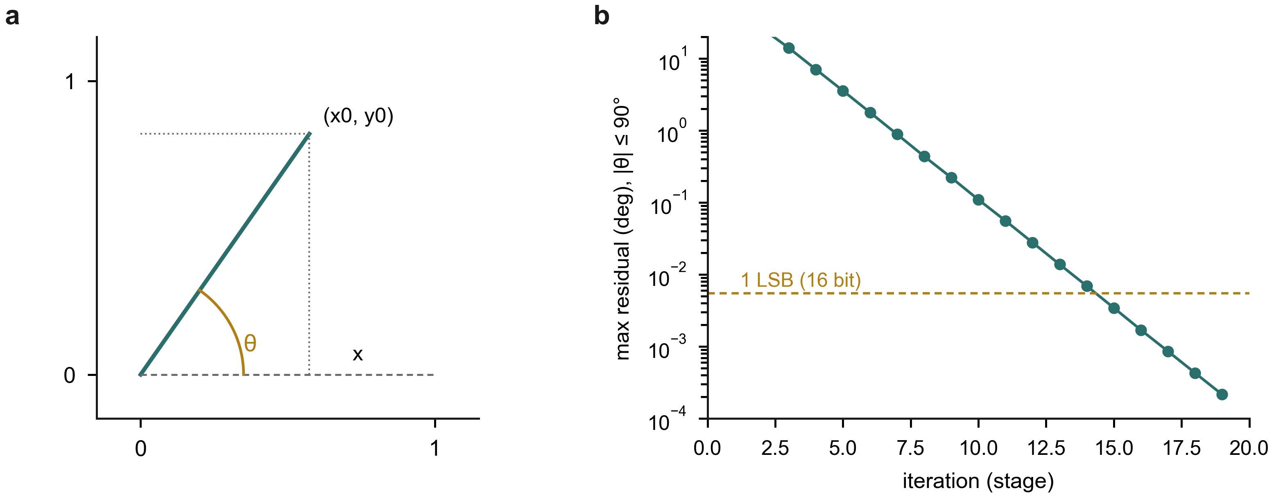
deliverables/figures/fig_cordic.png
