zhaoyunfengntzx-maker/fpga-smr-encoder/deliverables/figures/fig_cordic_pipeline.png

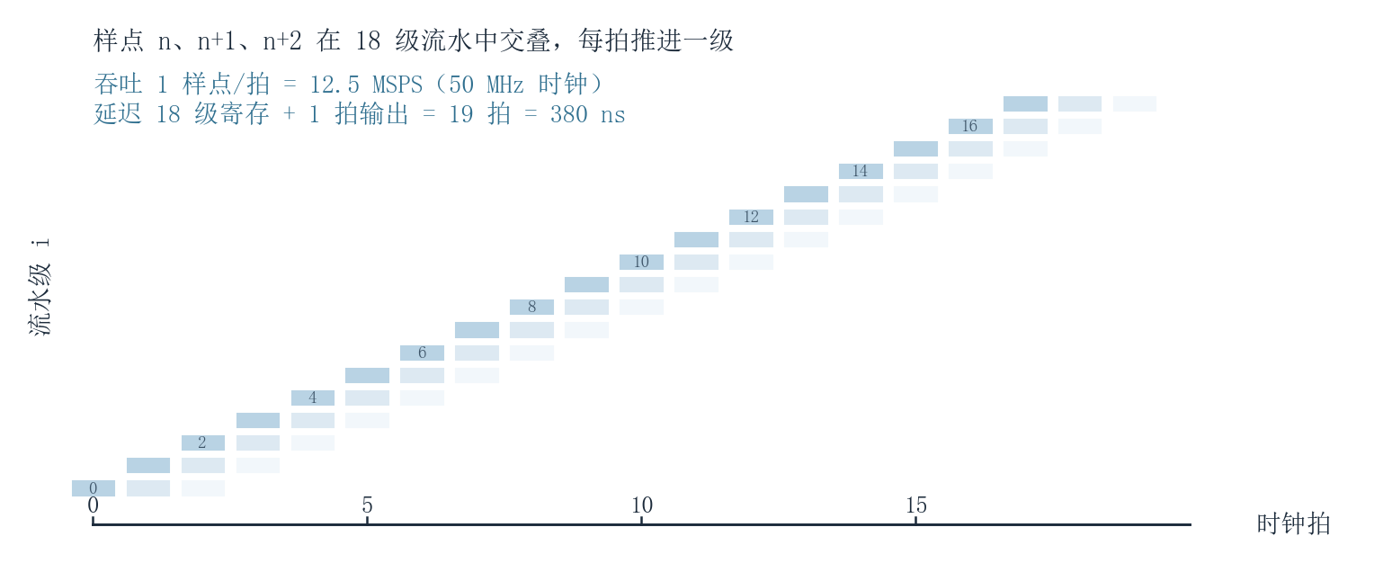
deliverables/figures/fig_cordic_pipeline.png
