zhaoyunfengntzx-maker/fpga-smr-encoder/deliverables/figures/fig_cordic_stage.png

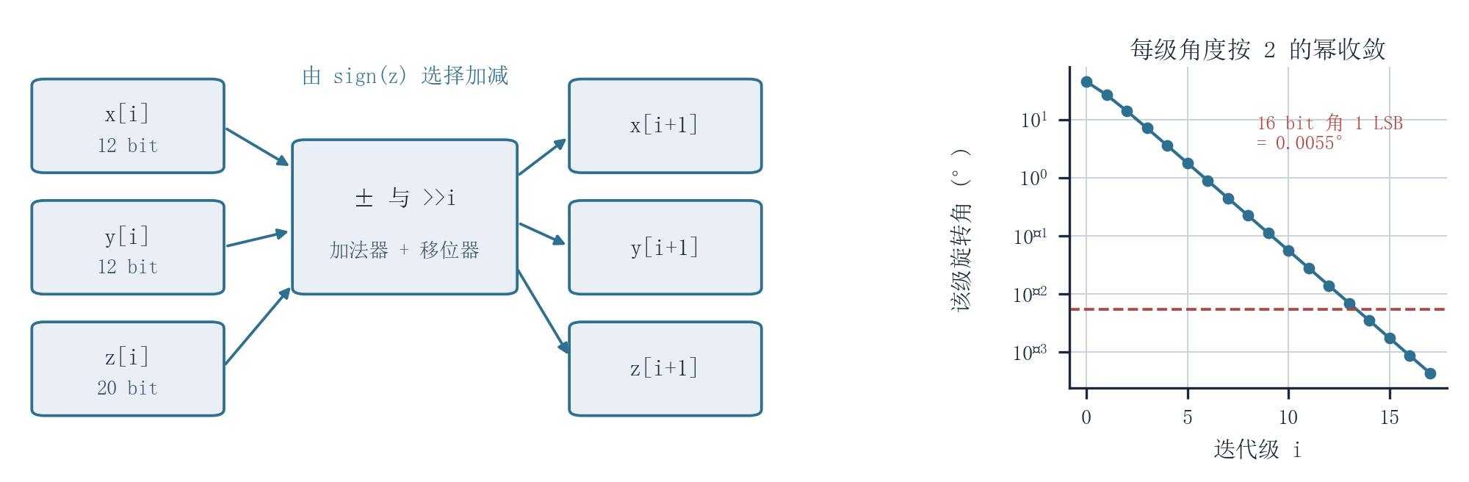
deliverables/figures/fig_cordic_stage.png
