zhaoyunfengntzx-maker/fpga-smr-encoder/deliverables/figures/fig_glitch_time.png

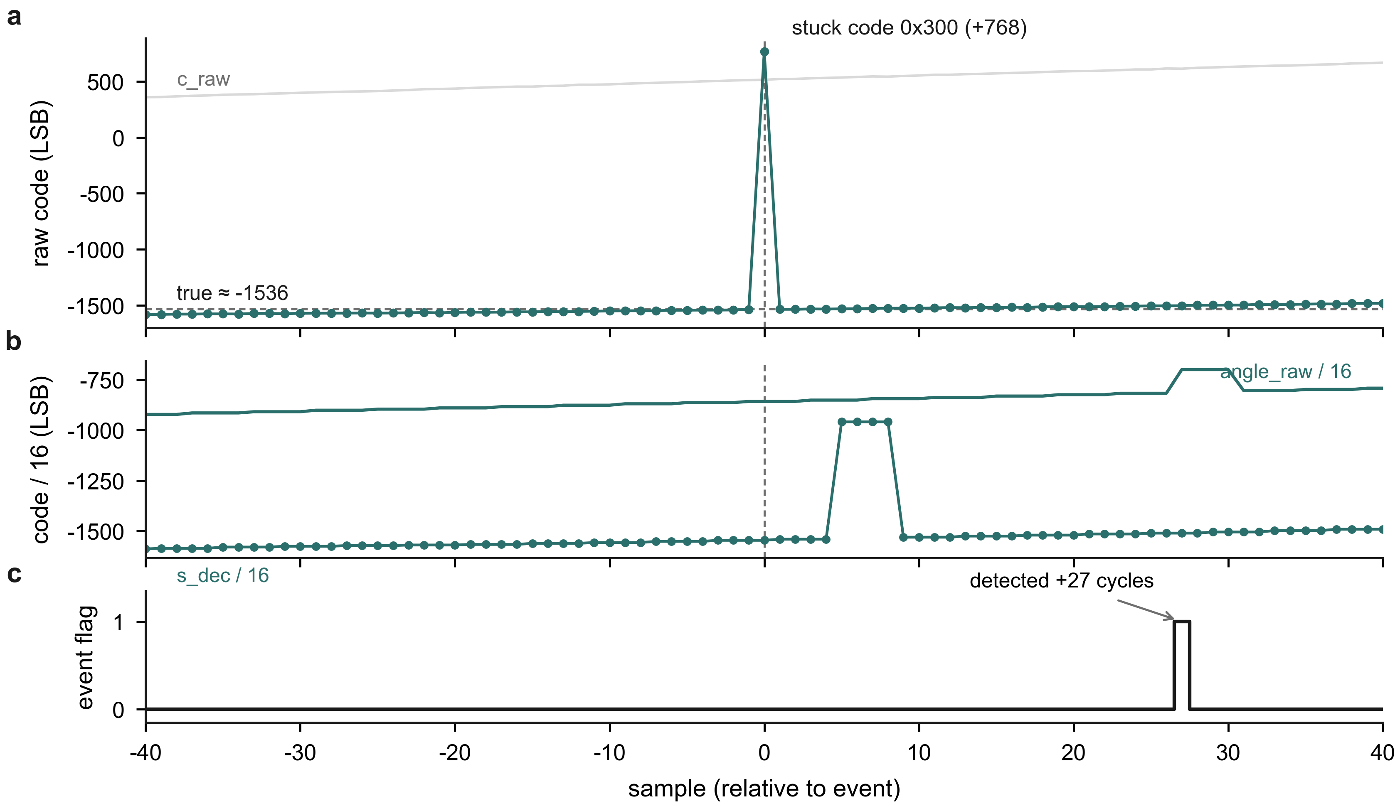
deliverables/figures/fig_glitch_time.png
