zhaoyunfengntzx-maker/fpga-smr-encoder/deliverables/figures/fig_io_topology.png

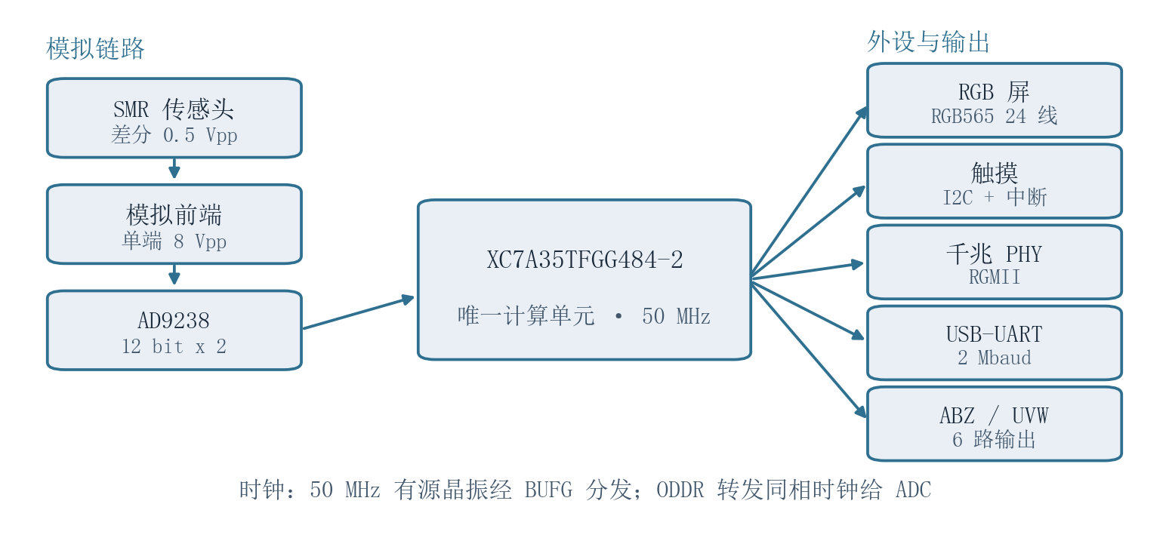
deliverables/figures/fig_io_topology.png
