zhaoyunfengntzx-maker/fpga-smr-encoder/deliverables/figures/fig_lattice.png

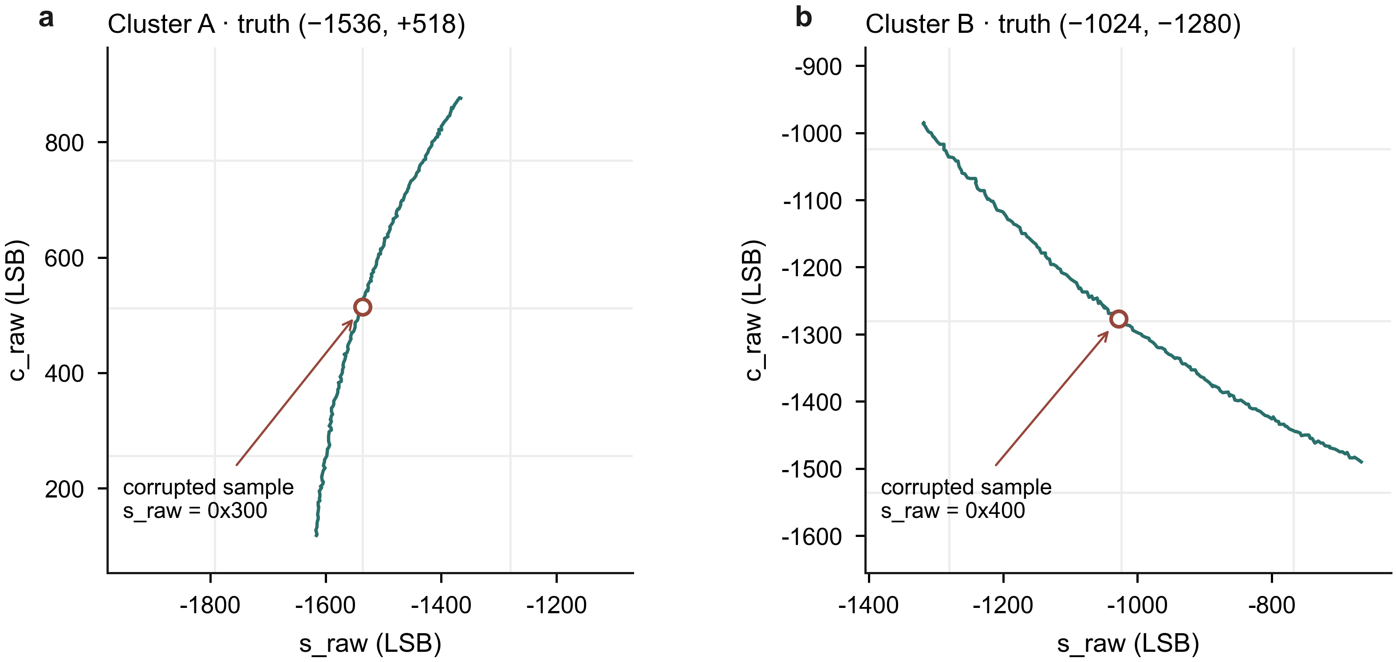
deliverables/figures/fig_lattice.png
