zhaoyunfengntzx-maker/fpga-smr-encoder/deliverables/figures/fig_loop_stability.png

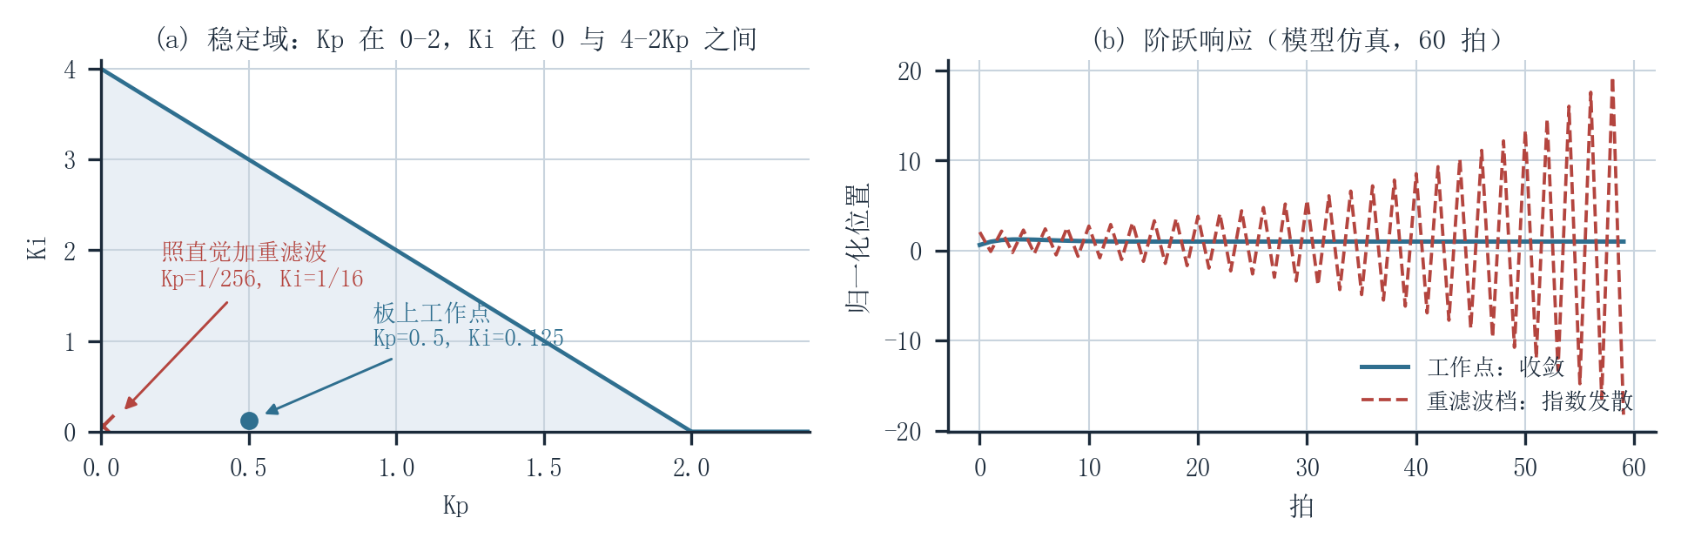
deliverables/figures/fig_loop_stability.png
