zhaoyunfengntzx-maker/fpga-smr-encoder/deliverables/figures/fig_ui_map.png

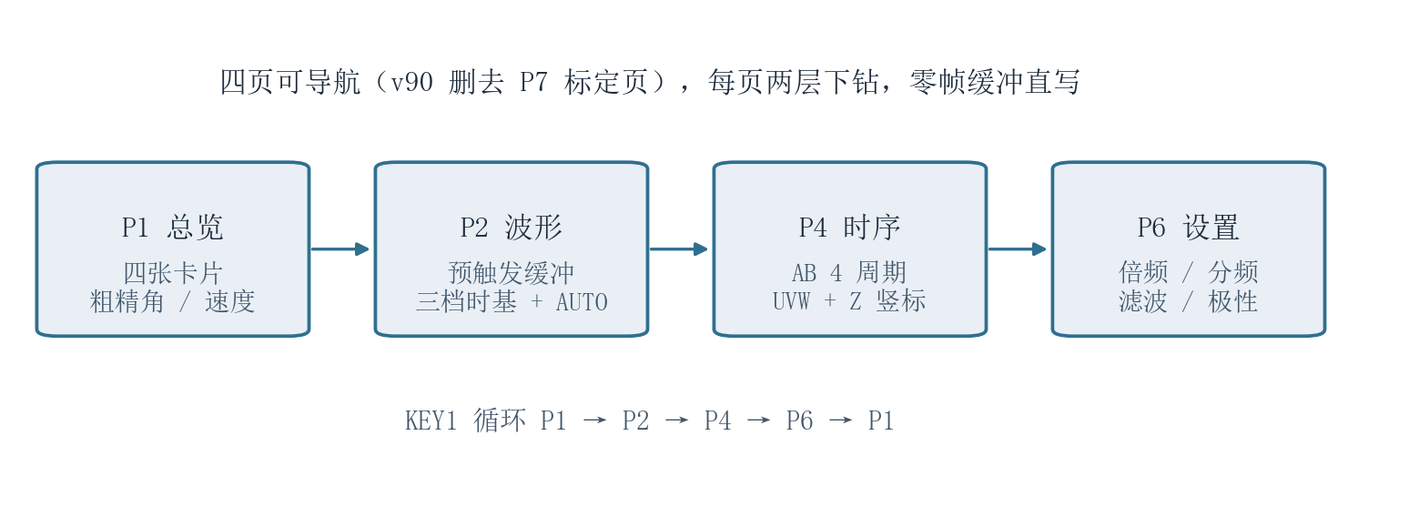
deliverables/figures/fig_ui_map.png
