zhaoyunfengntzx-maker/fpga-smr-encoder/deliverables/figures/fig_uvw_sectors.png

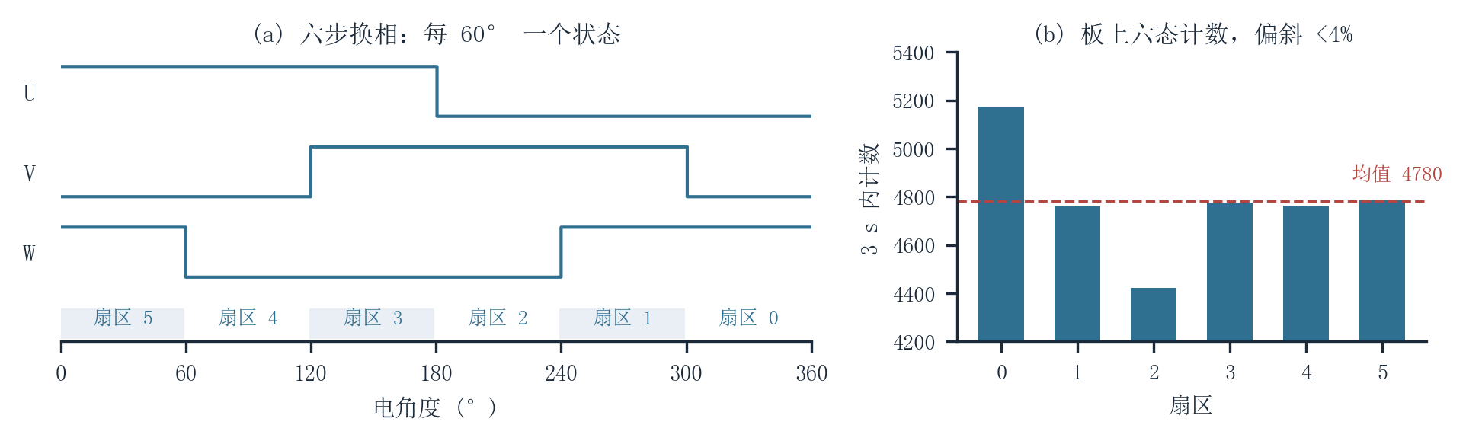
deliverables/figures/fig_uvw_sectors.png
