zhaoyunfengntzx-maker/fpga-smr-encoder/deliverables/figures/freq_1k.png

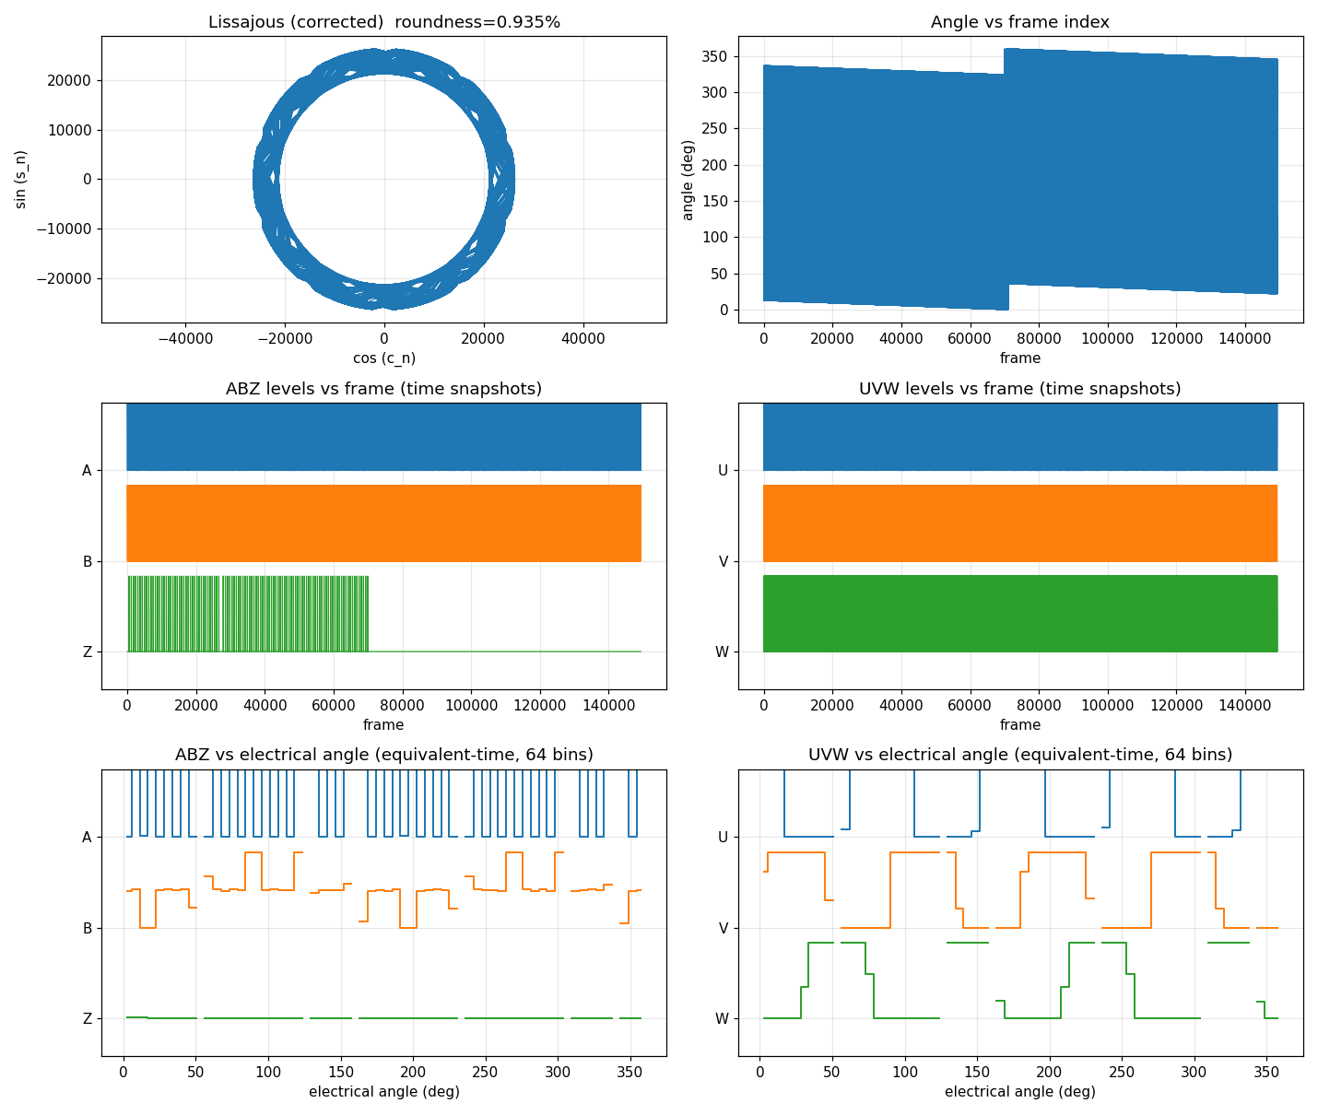
deliverables/figures/freq_1k.png
