zhaoyunfengntzx-maker/fpga-smr-encoder/deliverables/figures/freq_10k.png

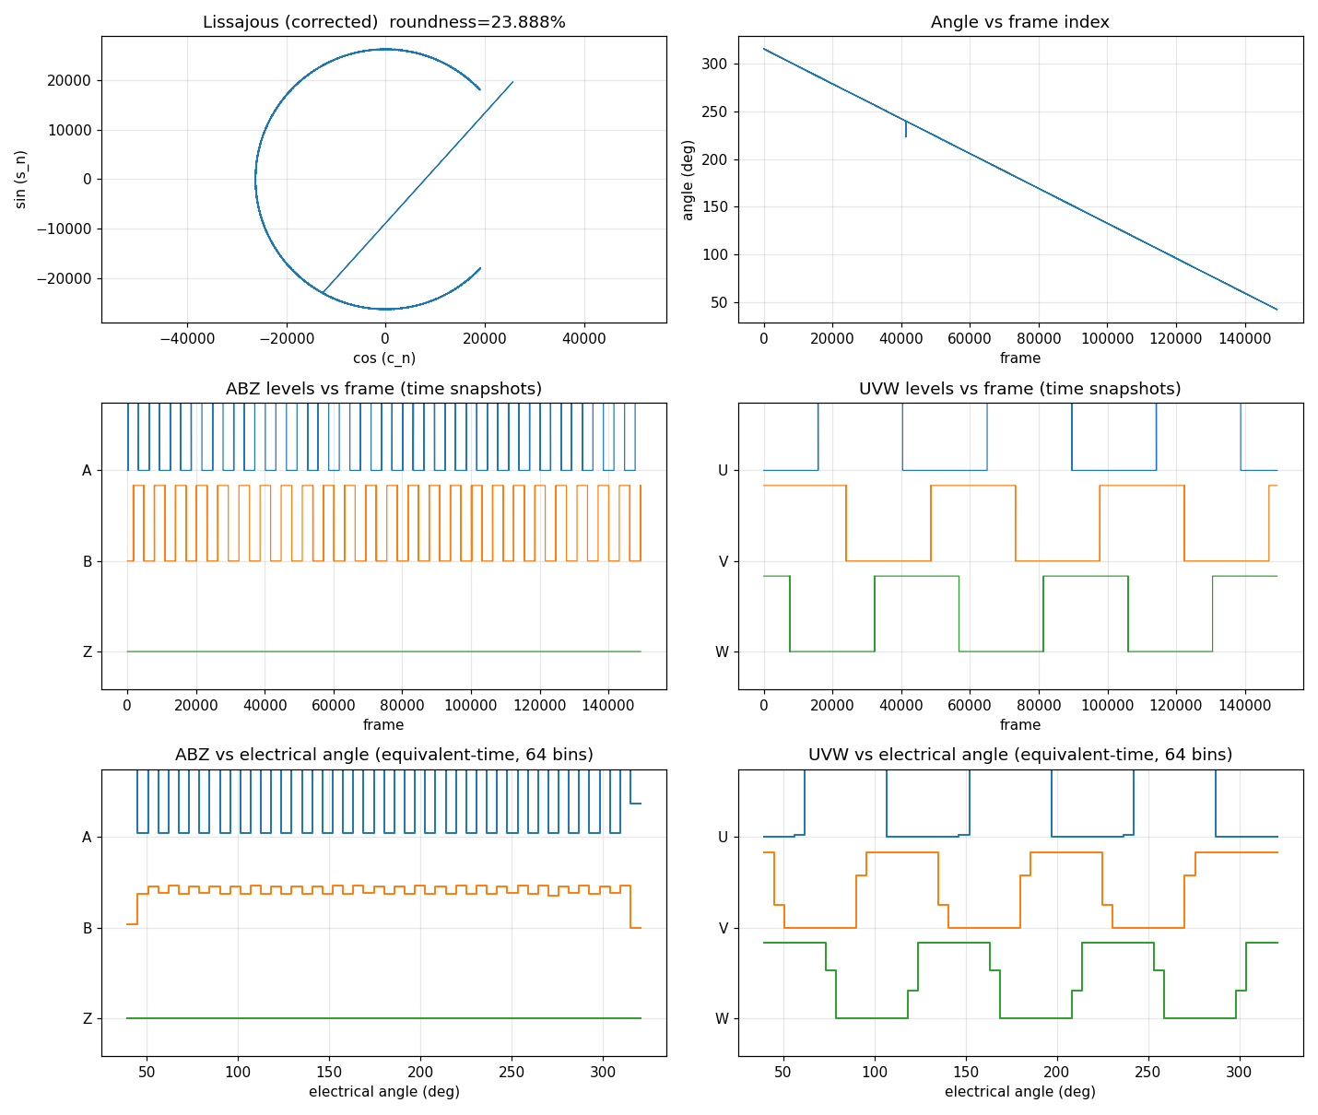
deliverables/figures/freq_10k.png
