zhaoyunfengntzx-maker/fpga-smr-encoder/deliverables/figures/freq_50k.png

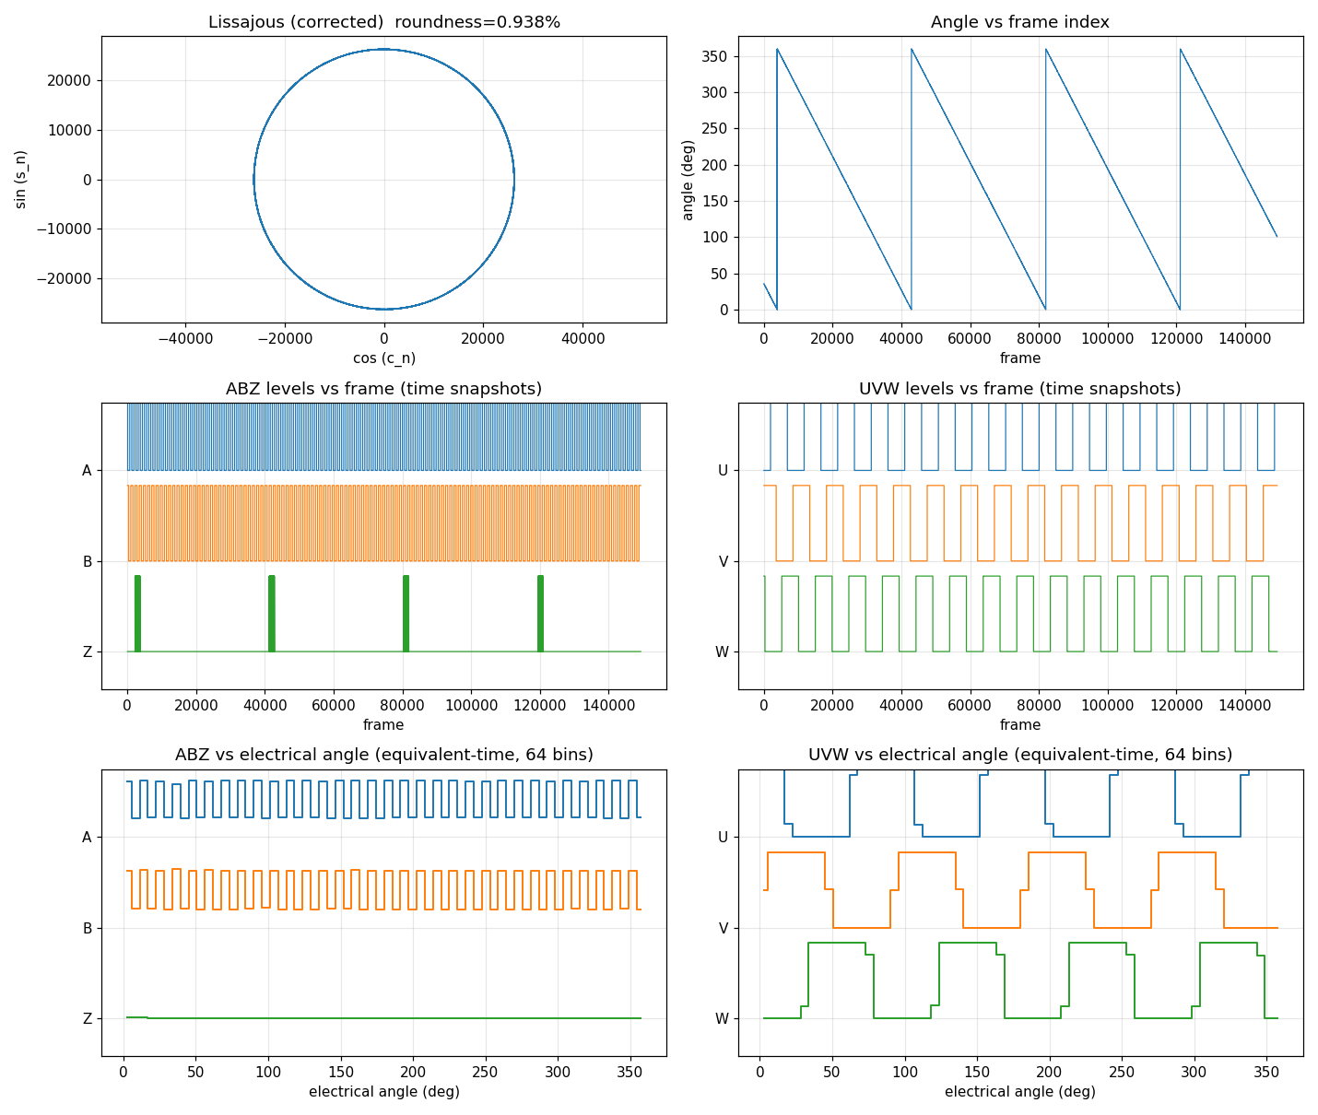
deliverables/figures/freq_50k.png
