zhaoyunfengntzx-maker/fpga-smr-encoder/deliverables/figures/freq_100k.png

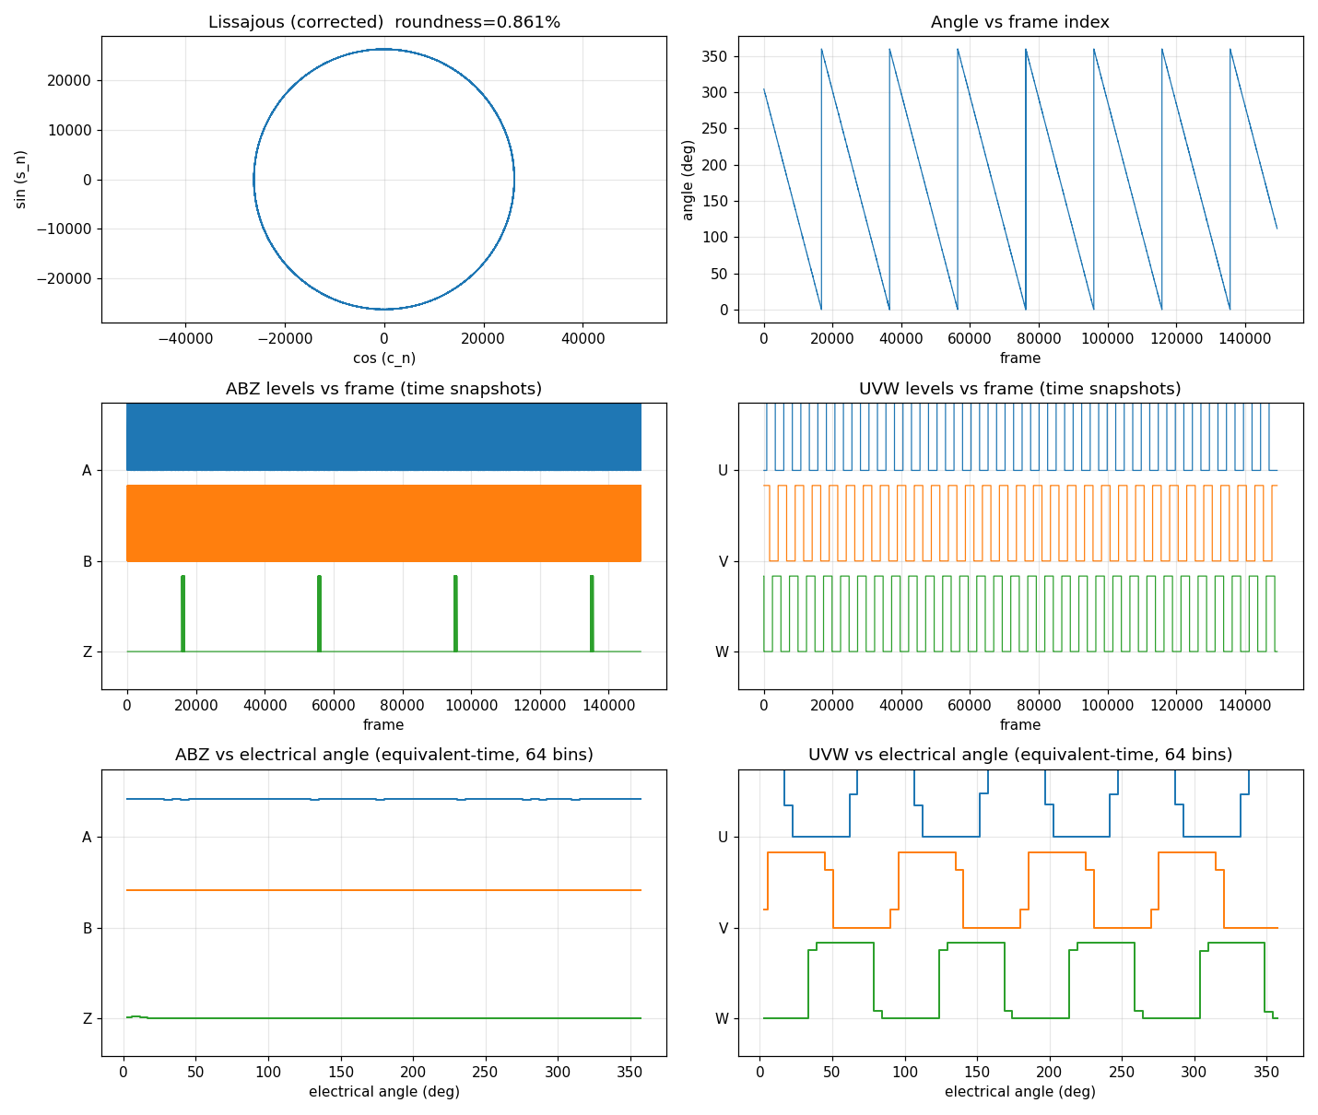
deliverables/figures/freq_100k.png
