zhaoyunfengntzx-maker/fpga-smr-encoder/deliverables/figures/freq_200k.png

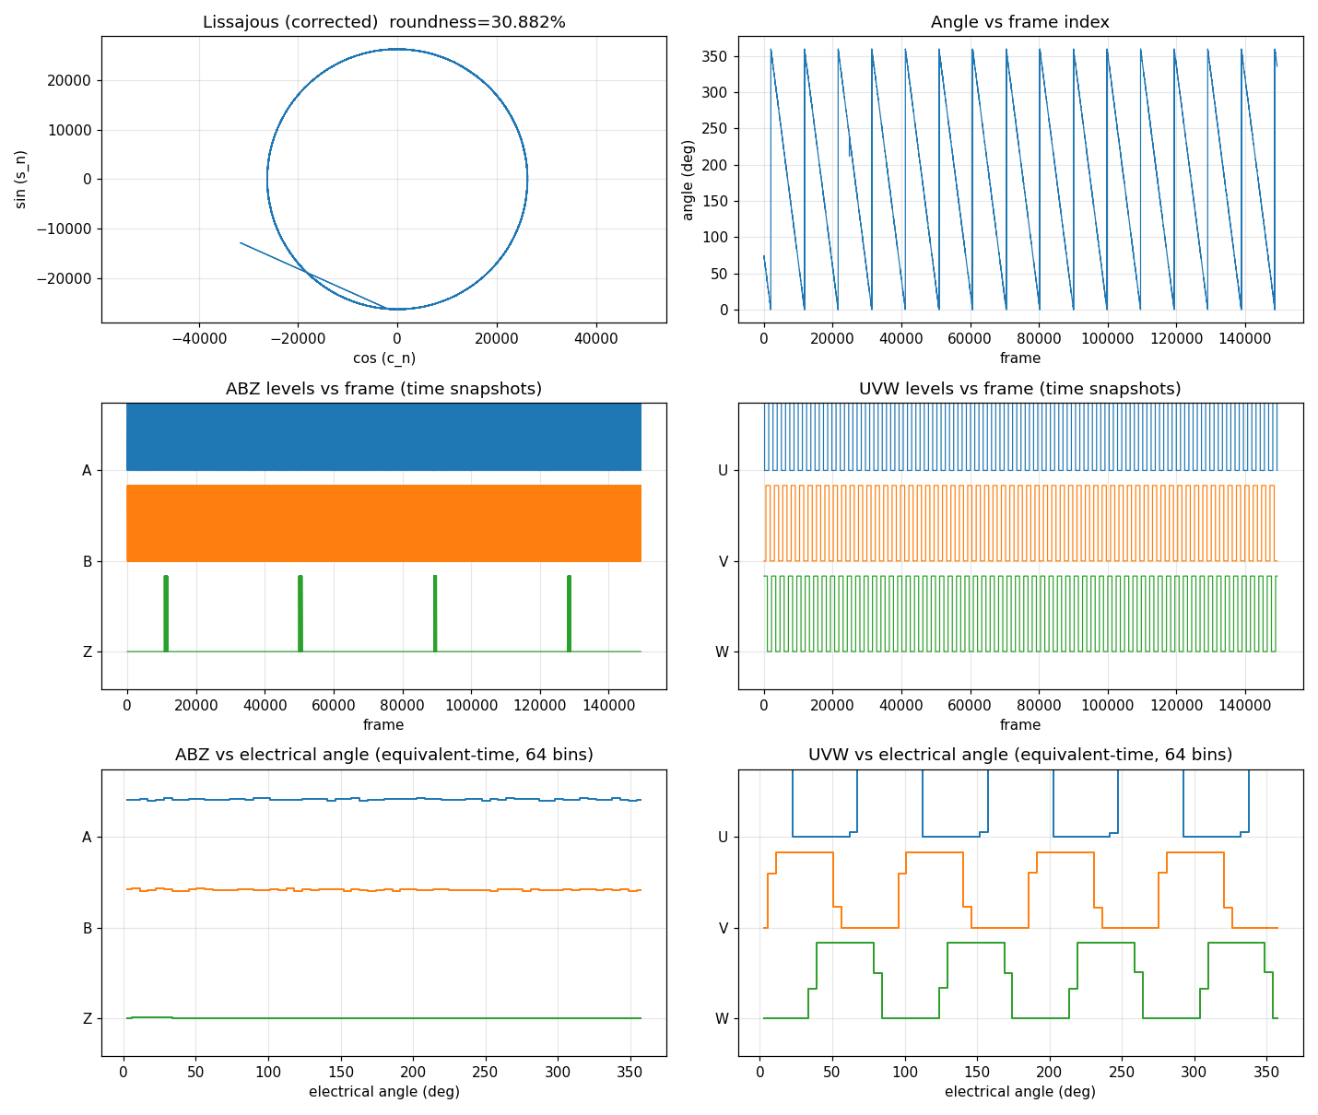
deliverables/figures/freq_200k.png
