zhaoyunfengntzx-maker/fpga-smr-encoder/deliverables/figures/freq_500k.png

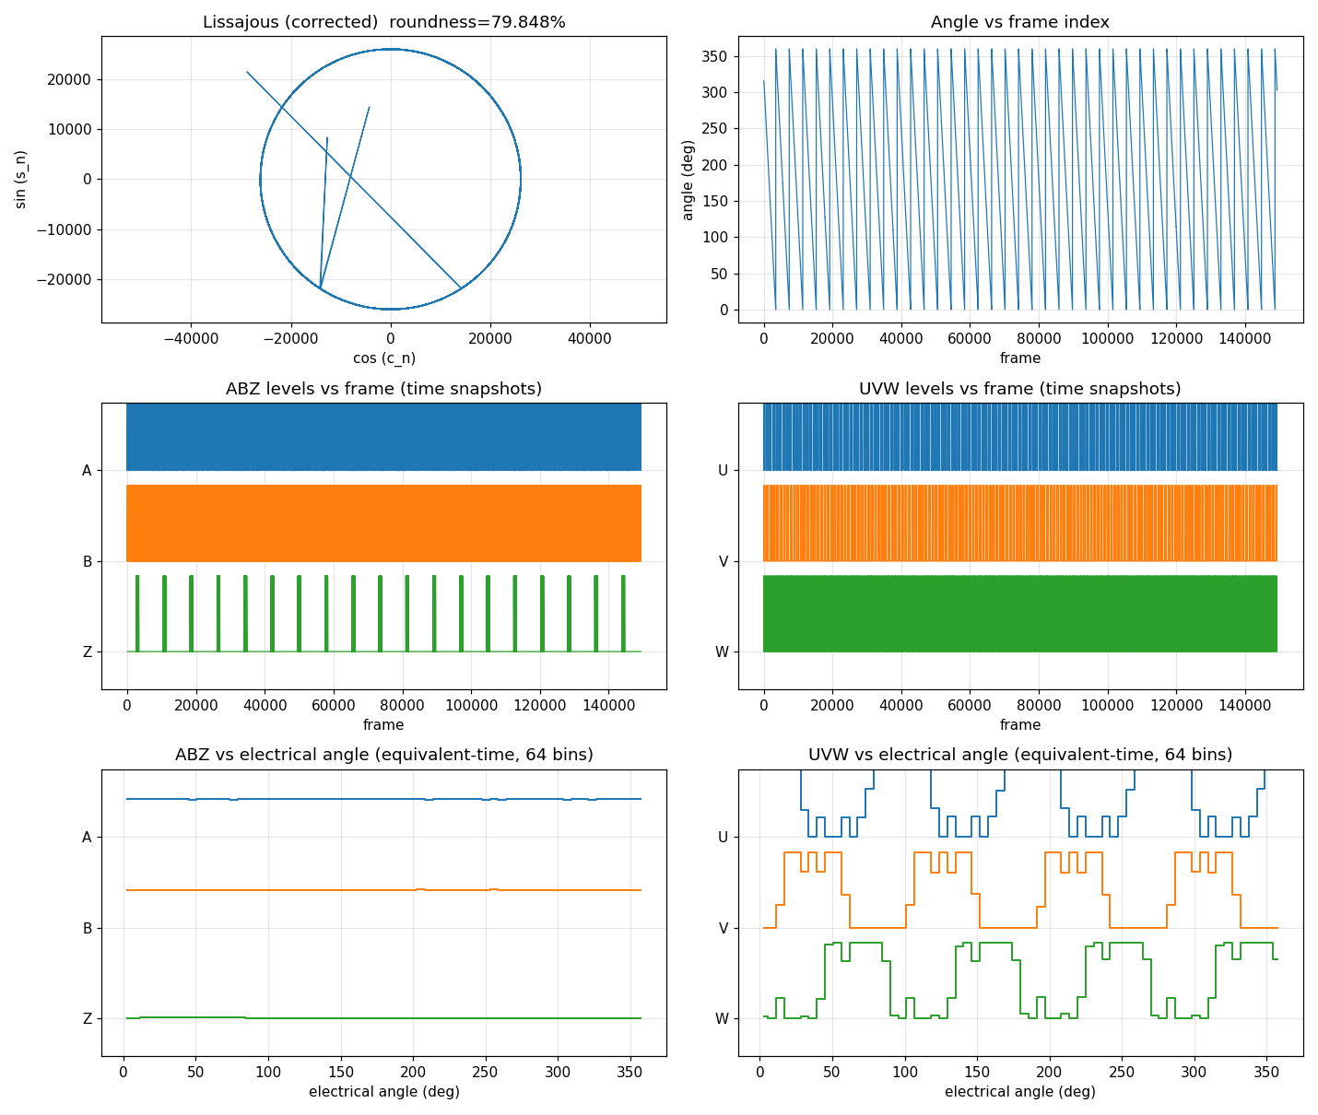
deliverables/figures/freq_500k.png
