zhaoyunfengntzx-maker/fpga-smr-encoder/deliverables/figures/ila_glitch.png

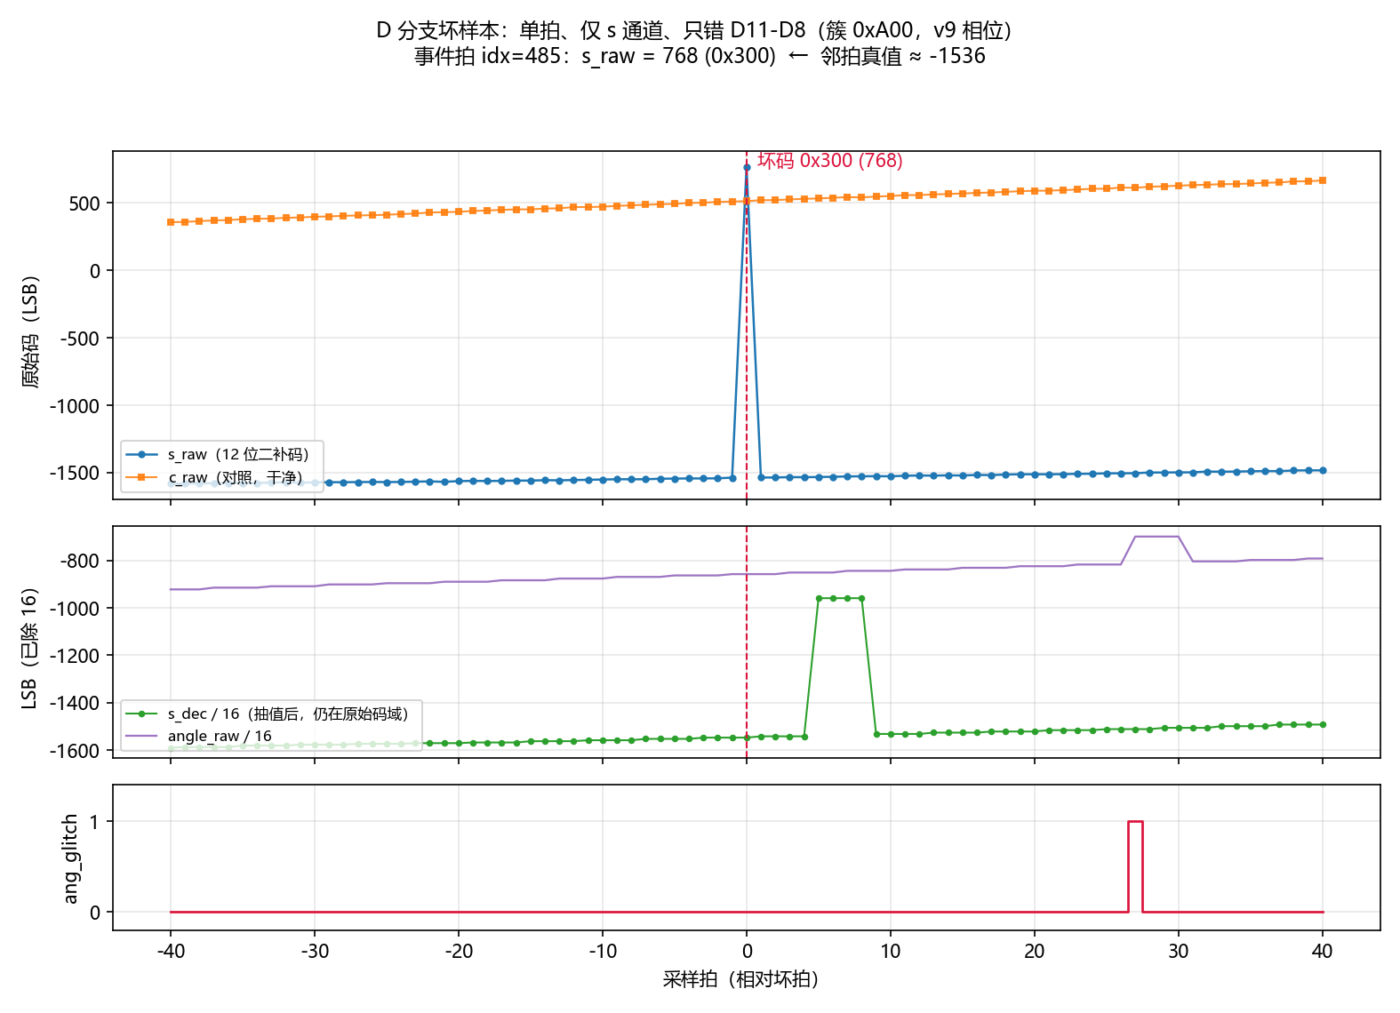
deliverables/figures/ila_glitch.png
