zhaoyunfengntzx-maker/fpga-smr-encoder/deliverables/figures/ila_glitch_g82.png

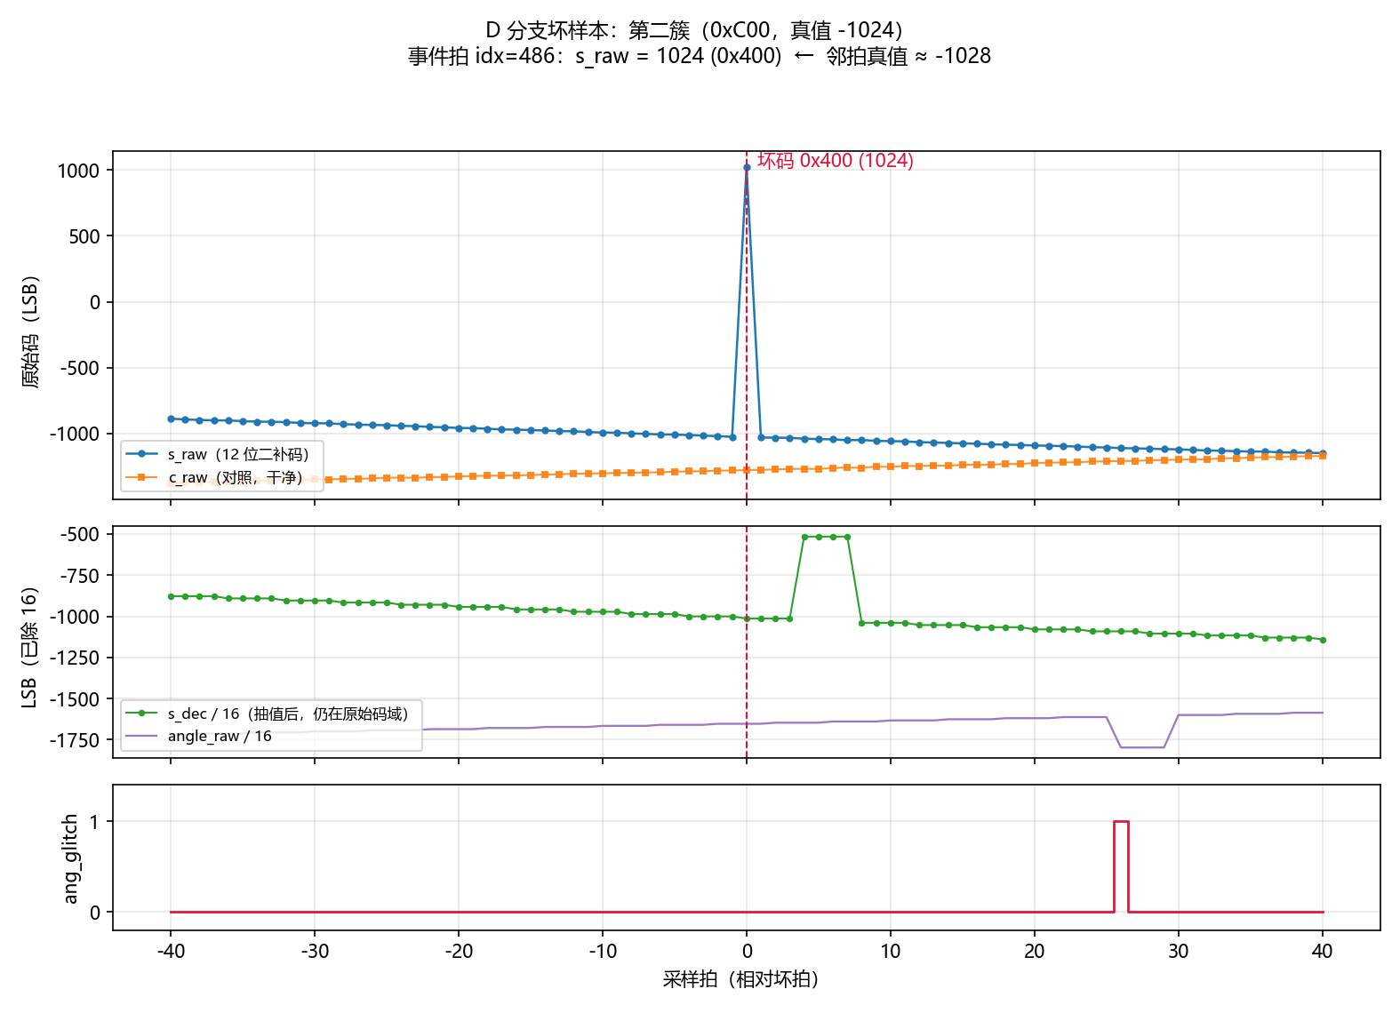
deliverables/figures/ila_glitch_g82.png
