zhaoyunfengntzx-maker/fpga-smr-encoder/deliverables/figures/ila_glitch_v9_vs_v11.png

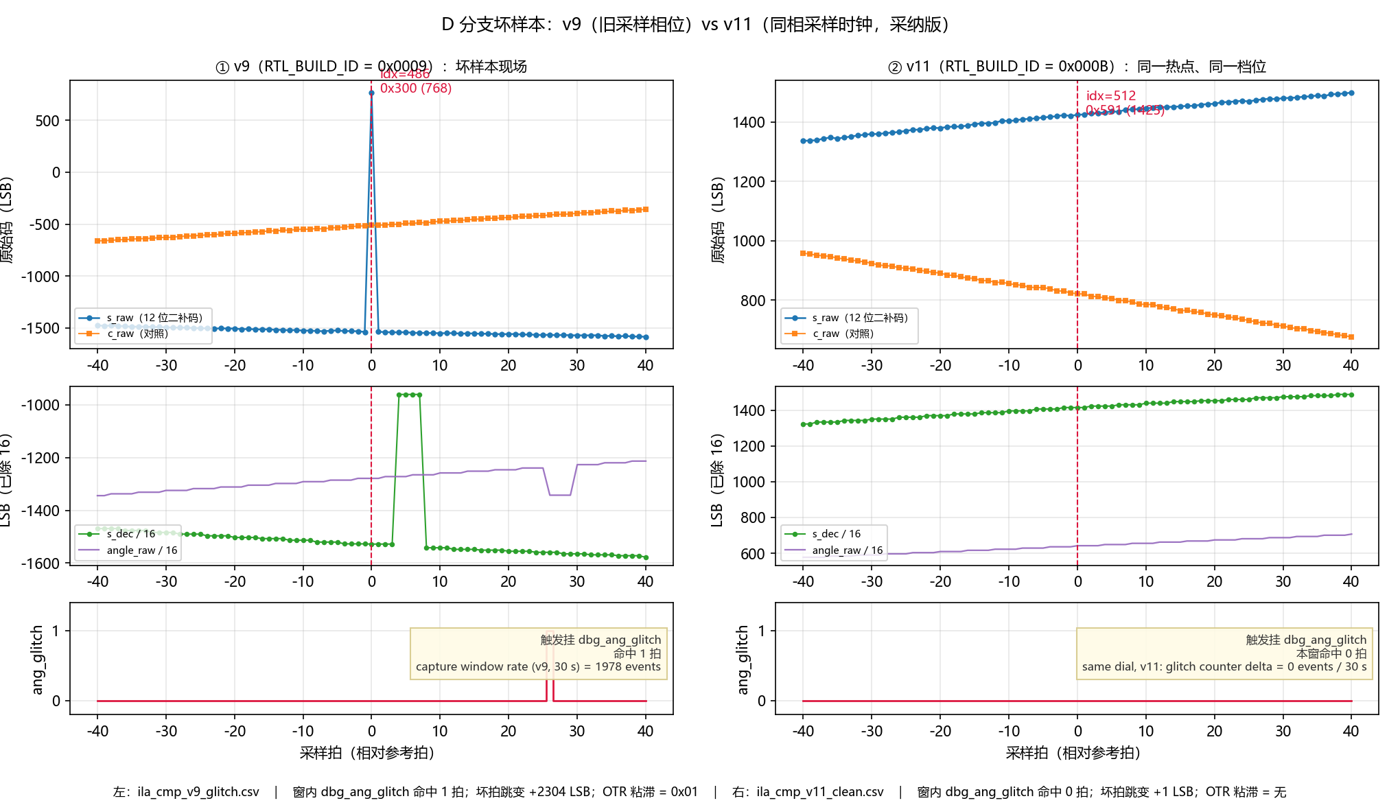
deliverables/figures/ila_glitch_v9_vs_v11.png
