zhaoyunfengntzx-maker/fpga-smr-encoder/deliverables/figures/lattice_event.png

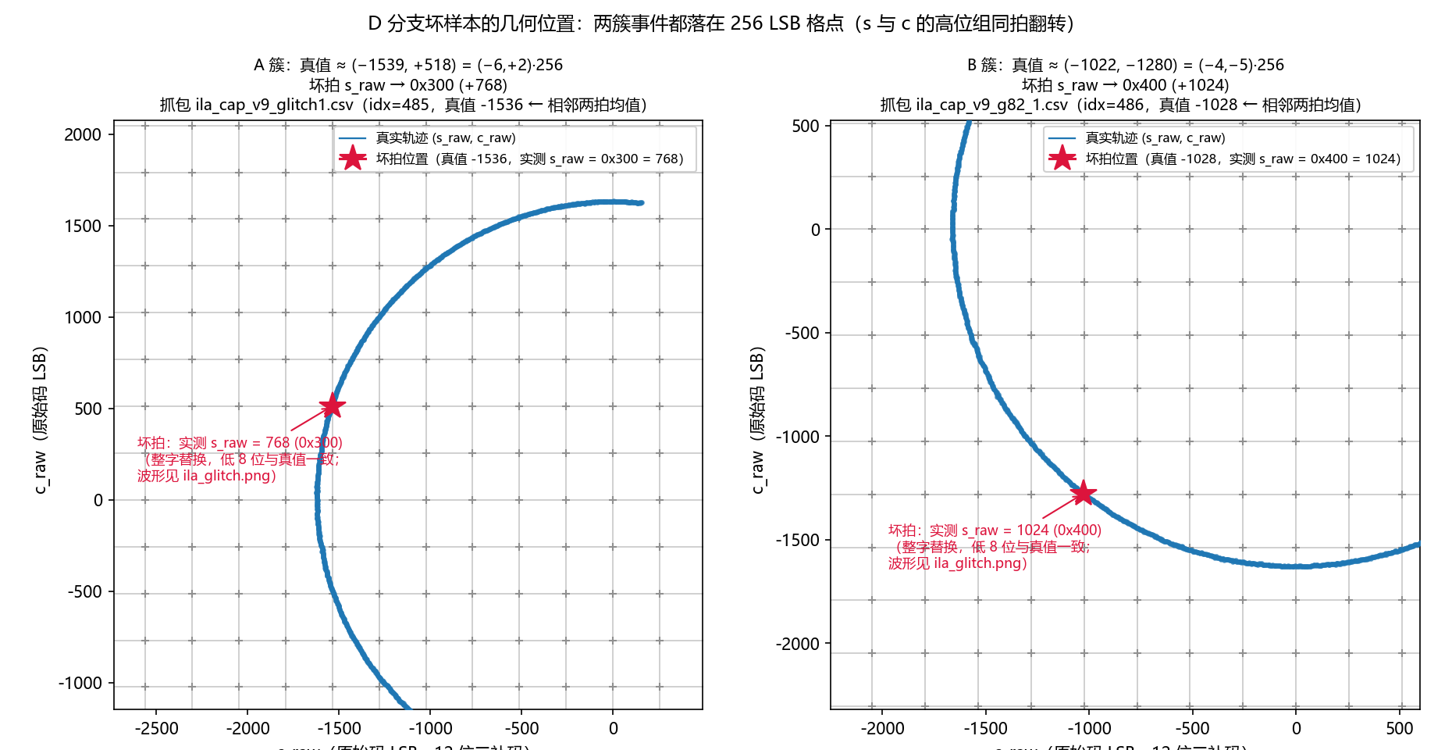
deliverables/figures/lattice_event.png
