zhaoyunfengntzx-maker/fpga-smr-encoder/deliverables/figures/lissajous_after.png

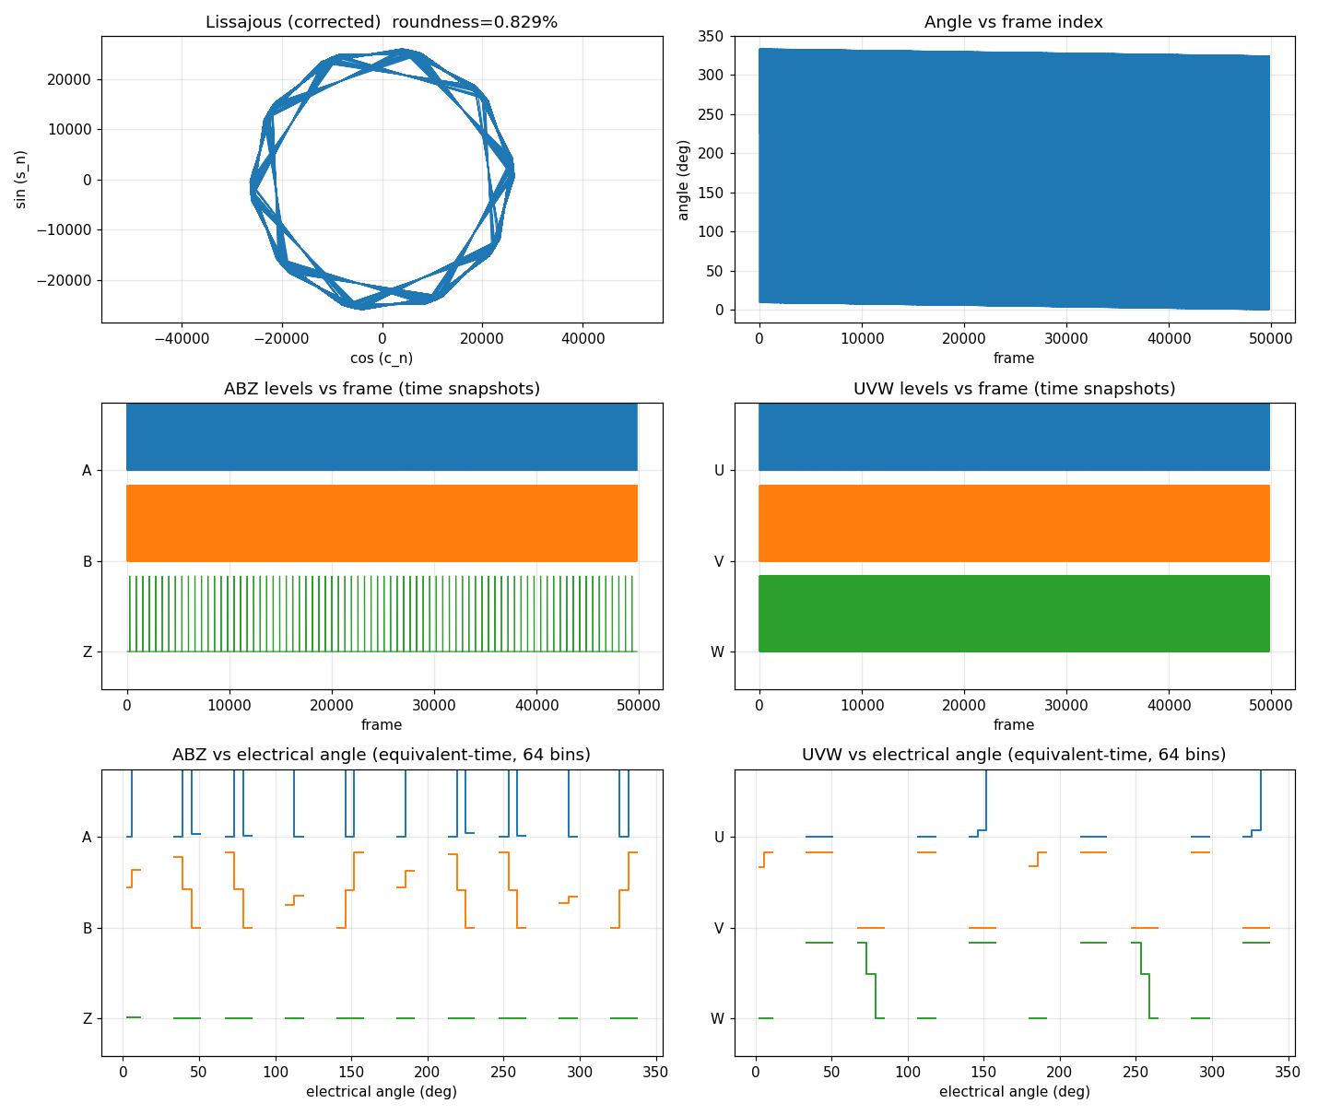
deliverables/figures/lissajous_after.png
