zhaoyunfengntzx-maker/fpga-smr-encoder/deliverables/figures/lissajous_before_distortion.png

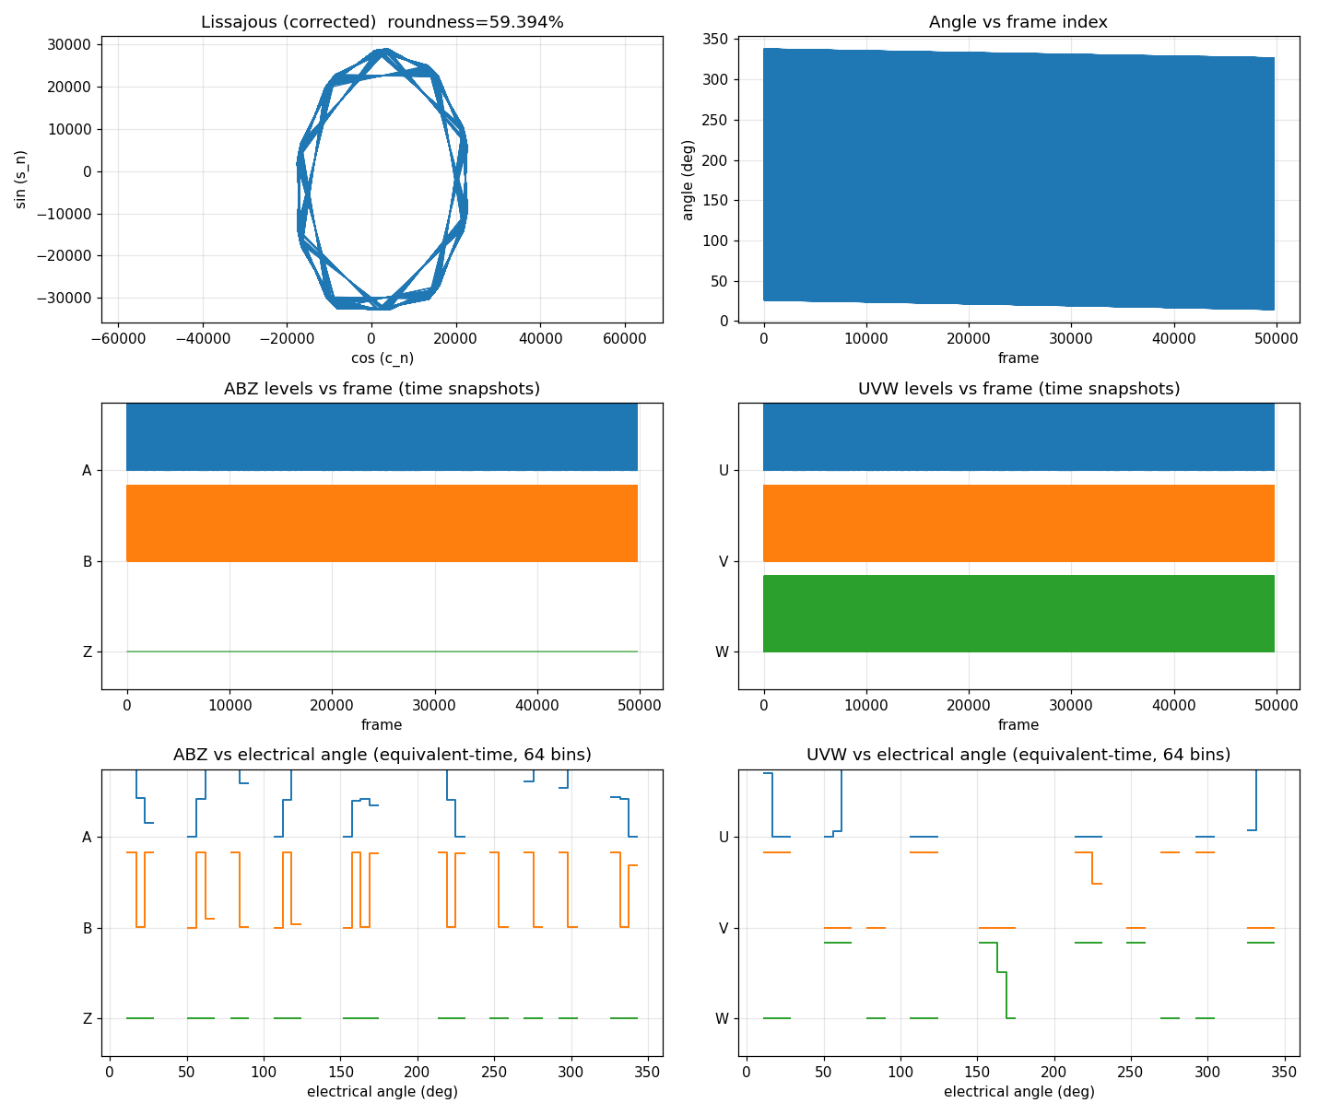
deliverables/figures/lissajous_before_distortion.png
