zhaoyunfengntzx-maker/fpga-smr-encoder/deliverables/figures/photo_adc_frontend.jpg

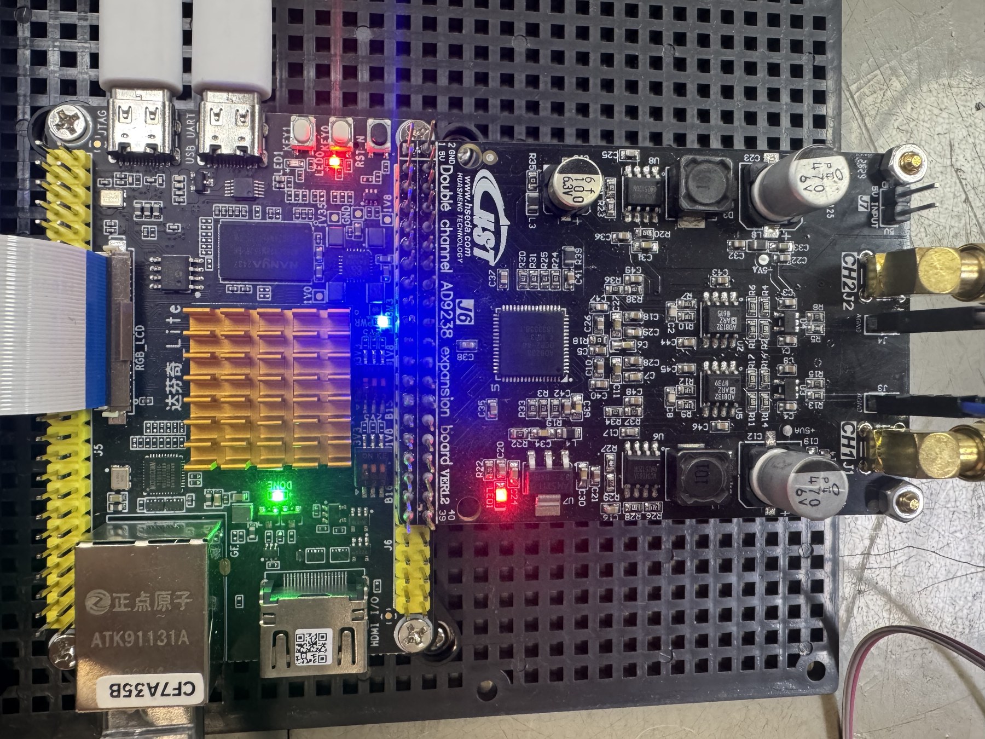
deliverables/figures/photo_adc_frontend.jpg
