zhaoyunfengntzx-maker/fpga-smr-encoder/deliverables/figures/photo_board_front.jpg

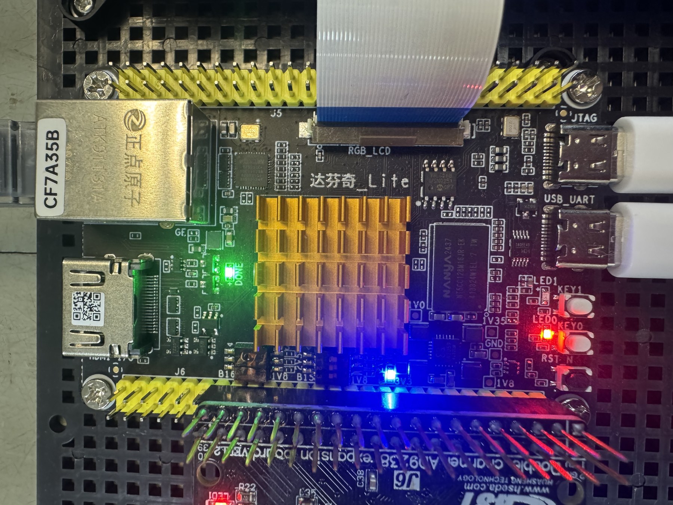
deliverables/figures/photo_board_front.jpg
