zhaoyunfengntzx-maker/fpga-smr-encoder/deliverables/figures/photo_overview.jpg

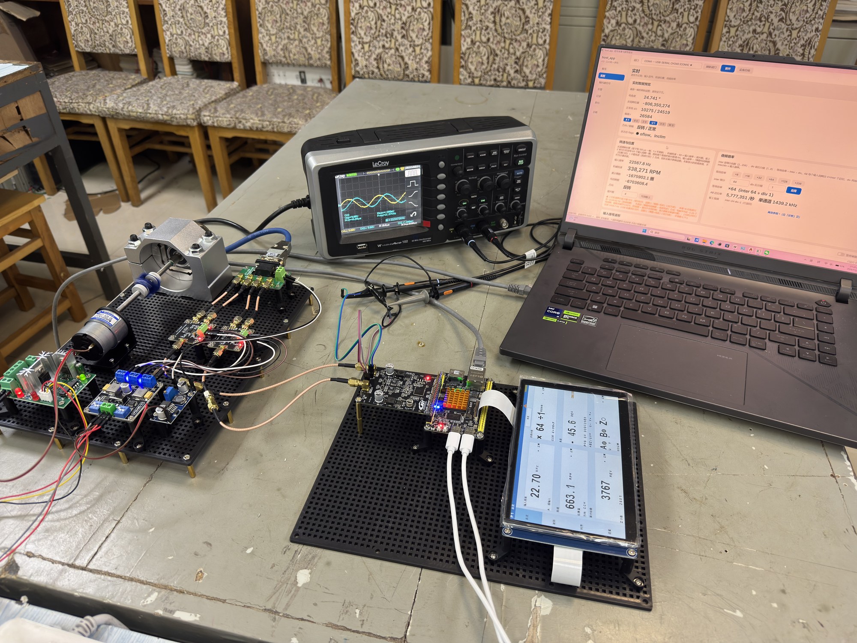
deliverables/figures/photo_overview.jpg
