zhaoyunfengntzx-maker/fpga-smr-encoder/deliverables/figures/photo_screen_p1.jpg

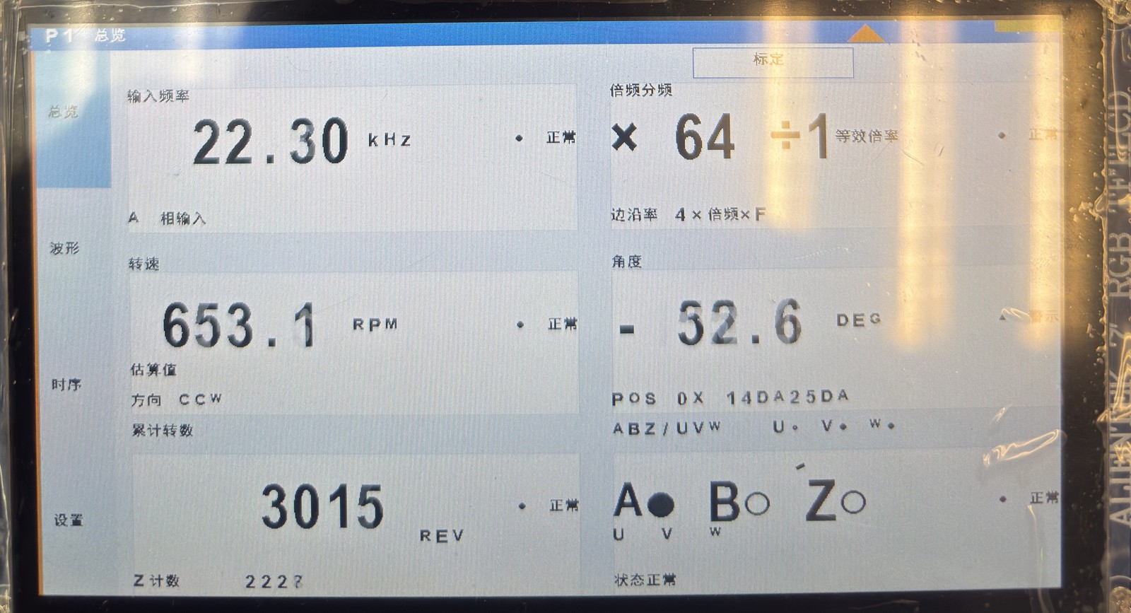
deliverables/figures/photo_screen_p1.jpg
