zhaoyunfengntzx-maker/fpga-smr-encoder/deliverables/figures/telemetry_abz_uvw.png

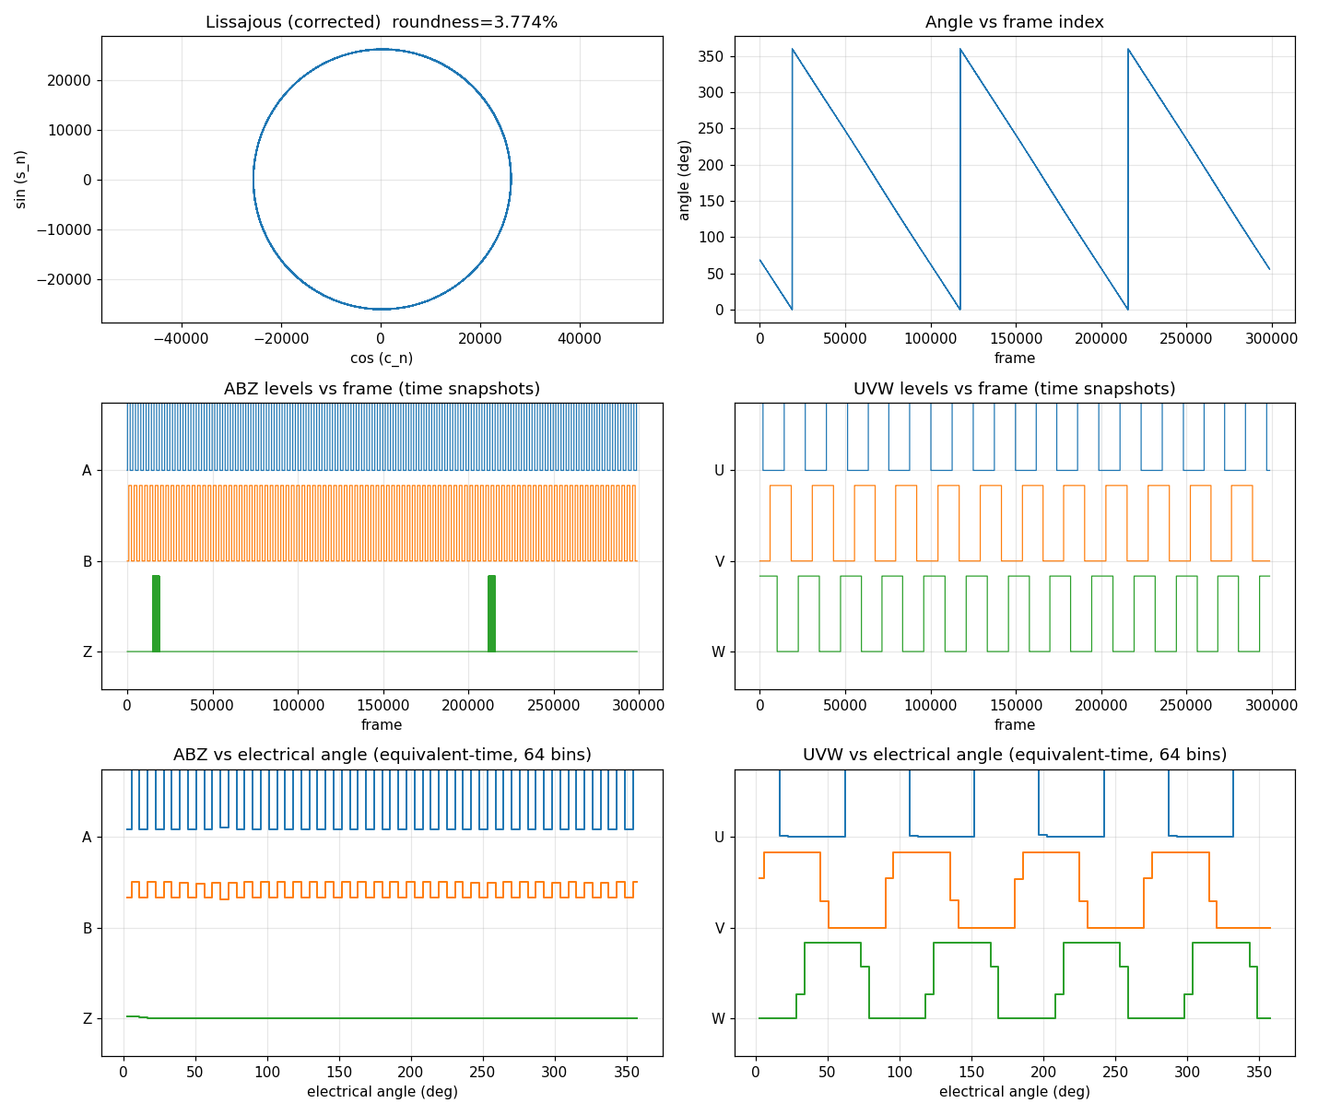
deliverables/figures/telemetry_abz_uvw.png
