zhaoyunfengntzx-maker/fpga-smr-encoder/deliverables/poster/poster_A4_EN.png

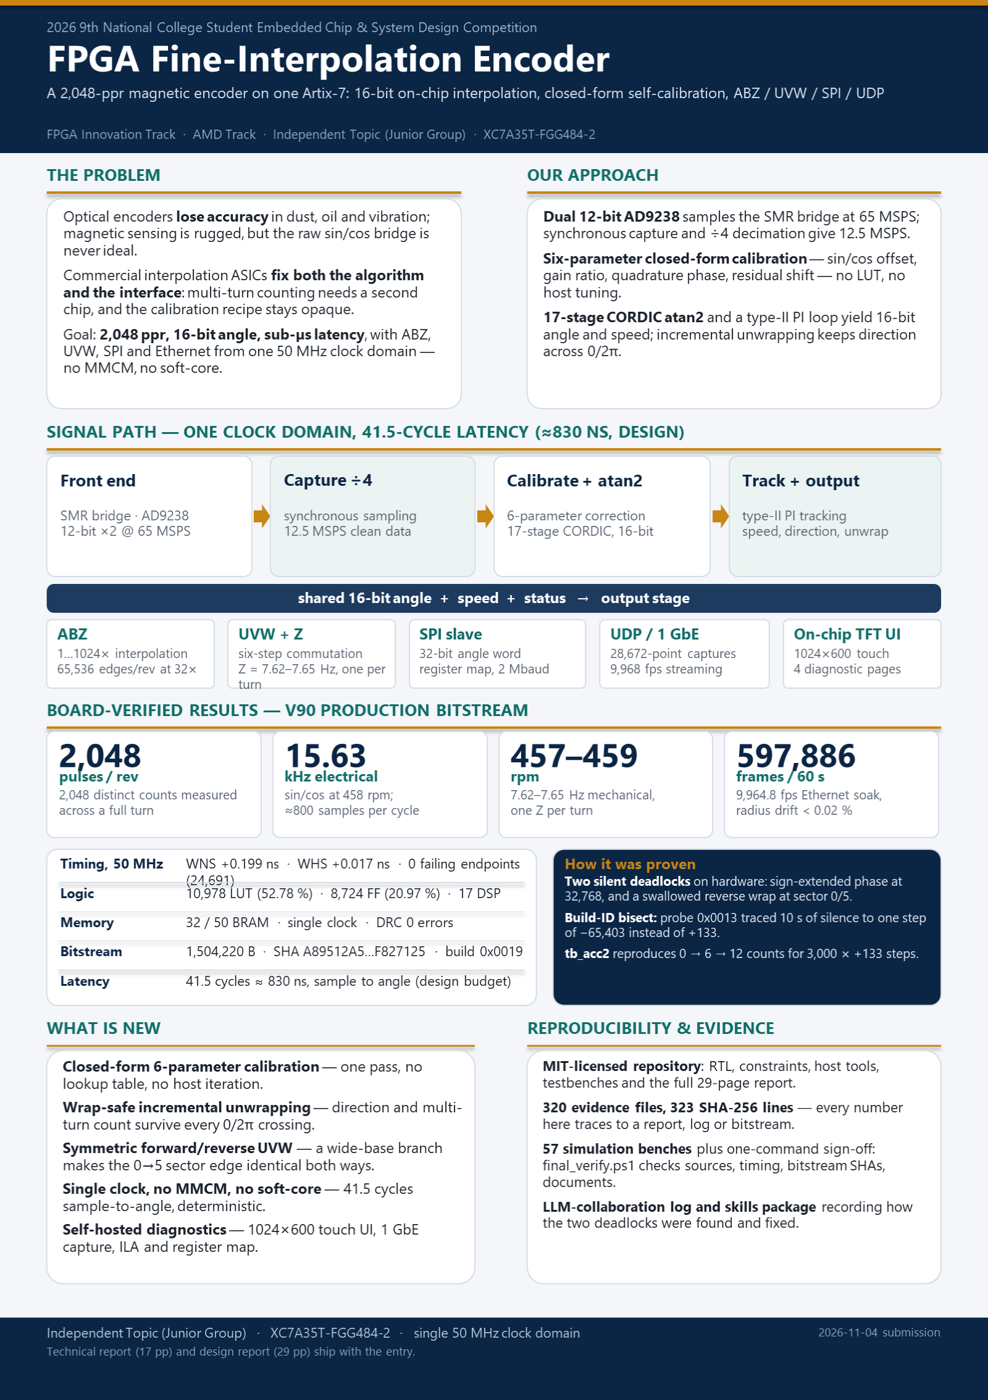
deliverables/poster/poster_A4_EN.png
