zhaoyunfengntzx-maker/fpga-smr-encoder/deliverables/poster/poster_amd_A4.png

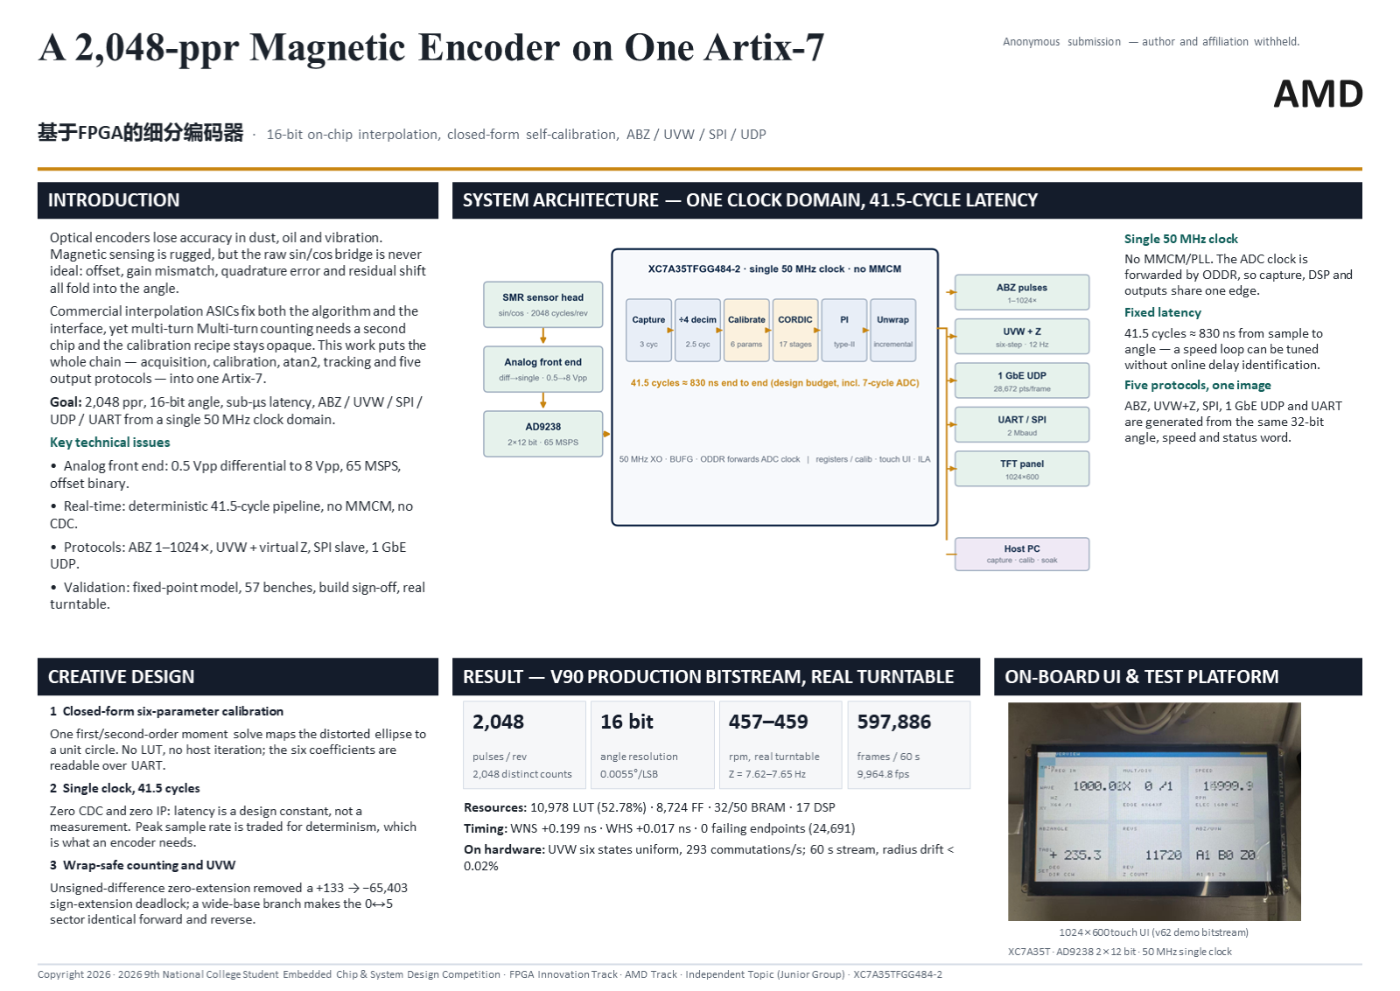
deliverables/poster/poster_amd_A4.png
