zhaoyunfengntzx-maker/fpga-smr-encoder/deliverables/poster/poster_amd_official.png

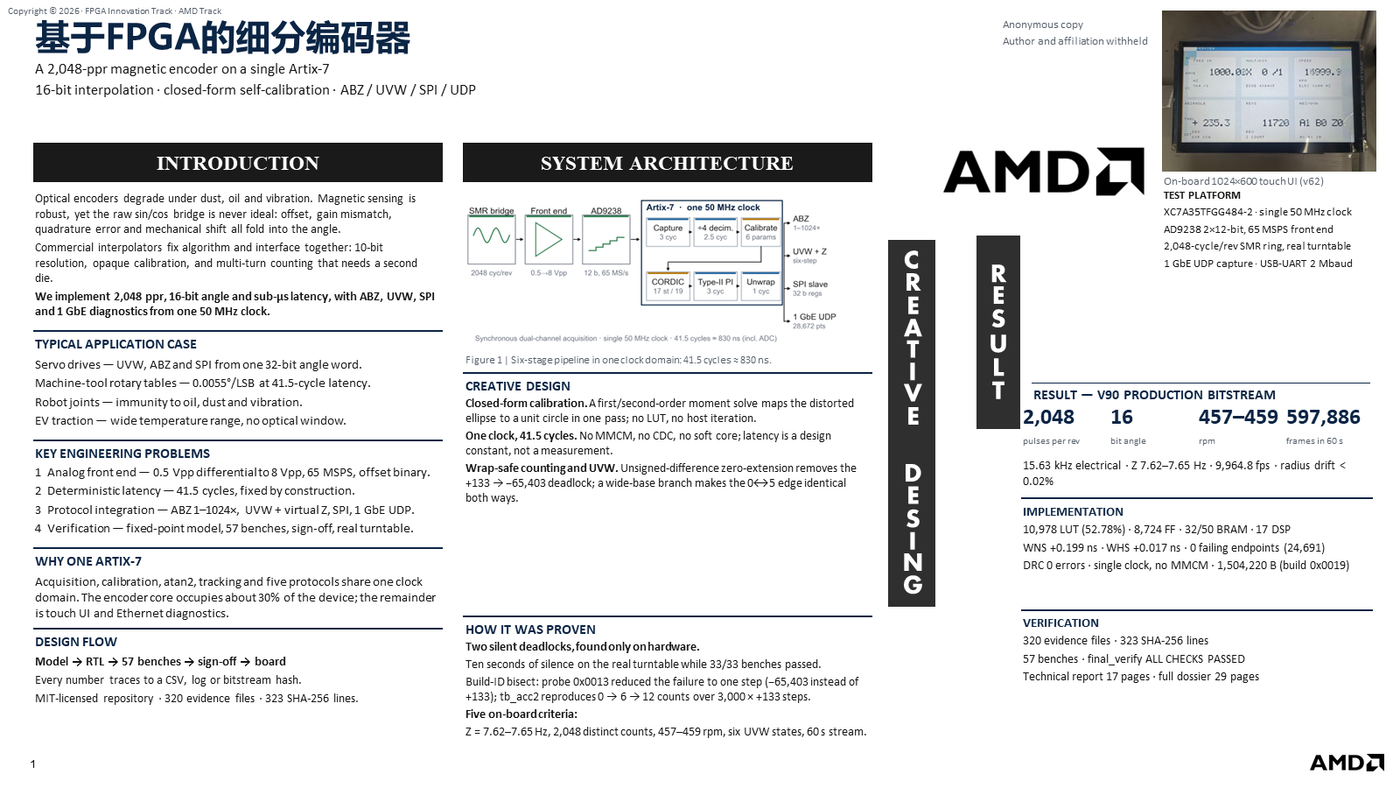
deliverables/poster/poster_amd_official.png
