zhaoyunfengntzx-maker/fpga-smr-encoder/deliverables/video/assets/card_end.png

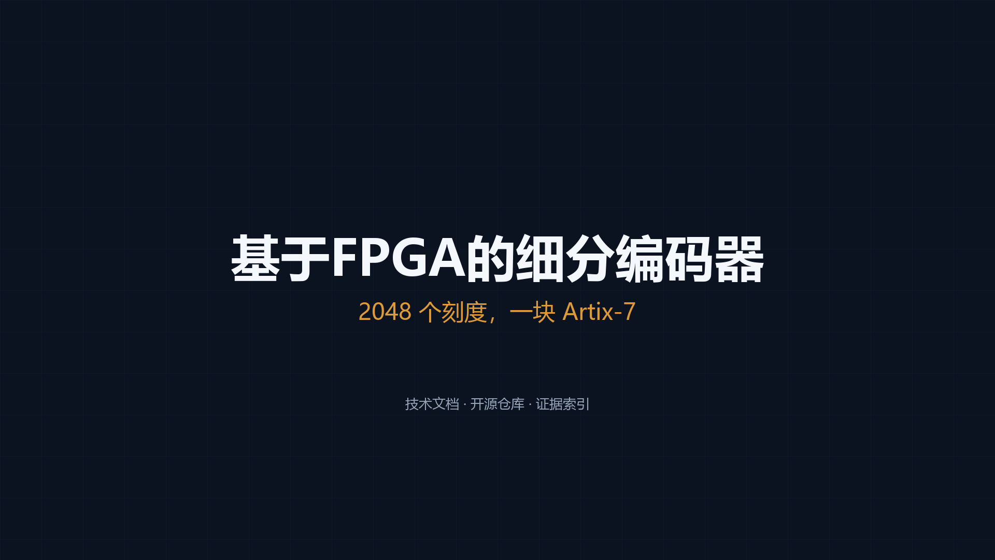
deliverables/video/assets/card_end.png
