zhaoyunfengntzx-maker/fpga-smr-encoder/deliverables/video/assets/card_title.png

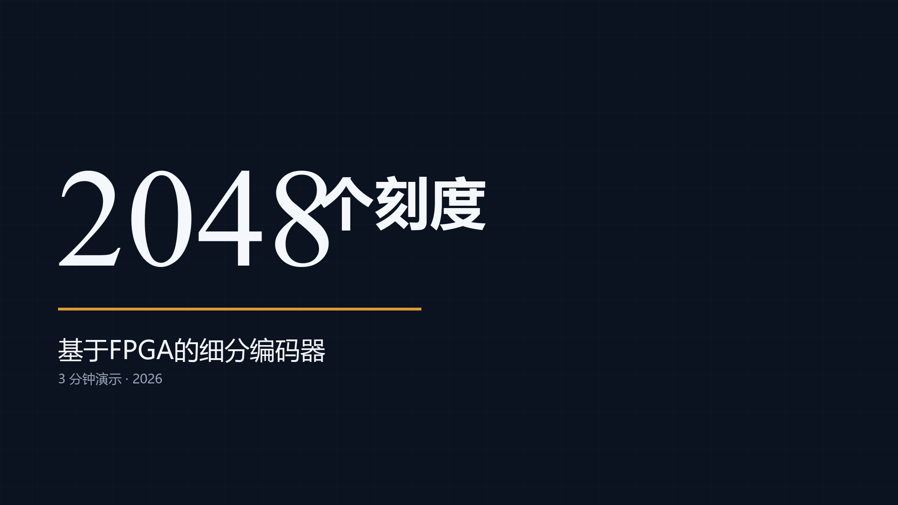
deliverables/video/assets/card_title.png
