zhaoyunfengntzx-maker/fpga-smr-encoder/docs/img/42_capture_cursor.png

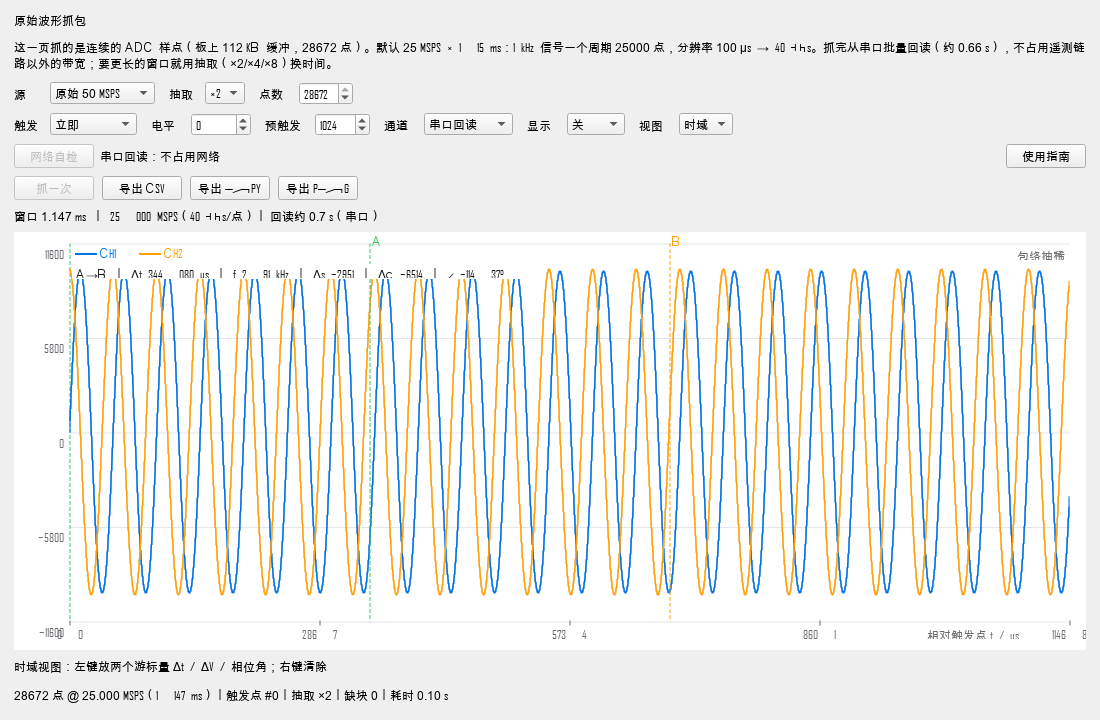
docs/img/42_capture_cursor.png
