zhaoyunfengntzx-maker/fpga-smr-encoder/docs/img/42_capture_spectrum.png

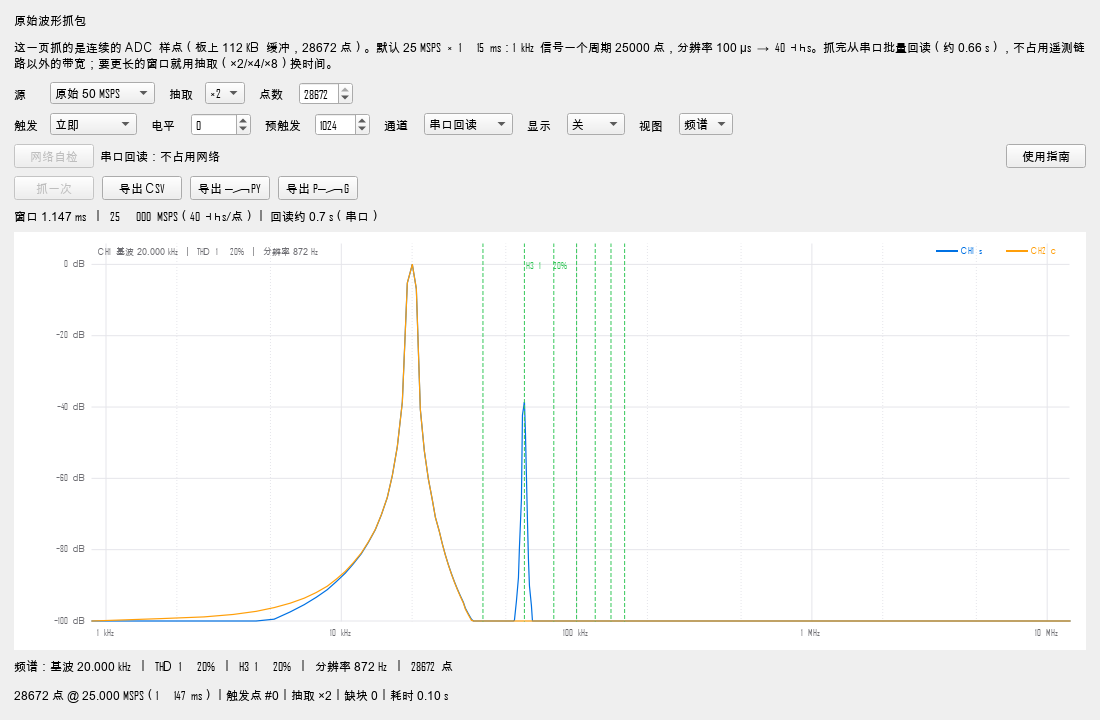
docs/img/42_capture_spectrum.png
