zhaoyunfengntzx-maker/fpga-smr-encoder/docs/img/42_diag_lut_health.png

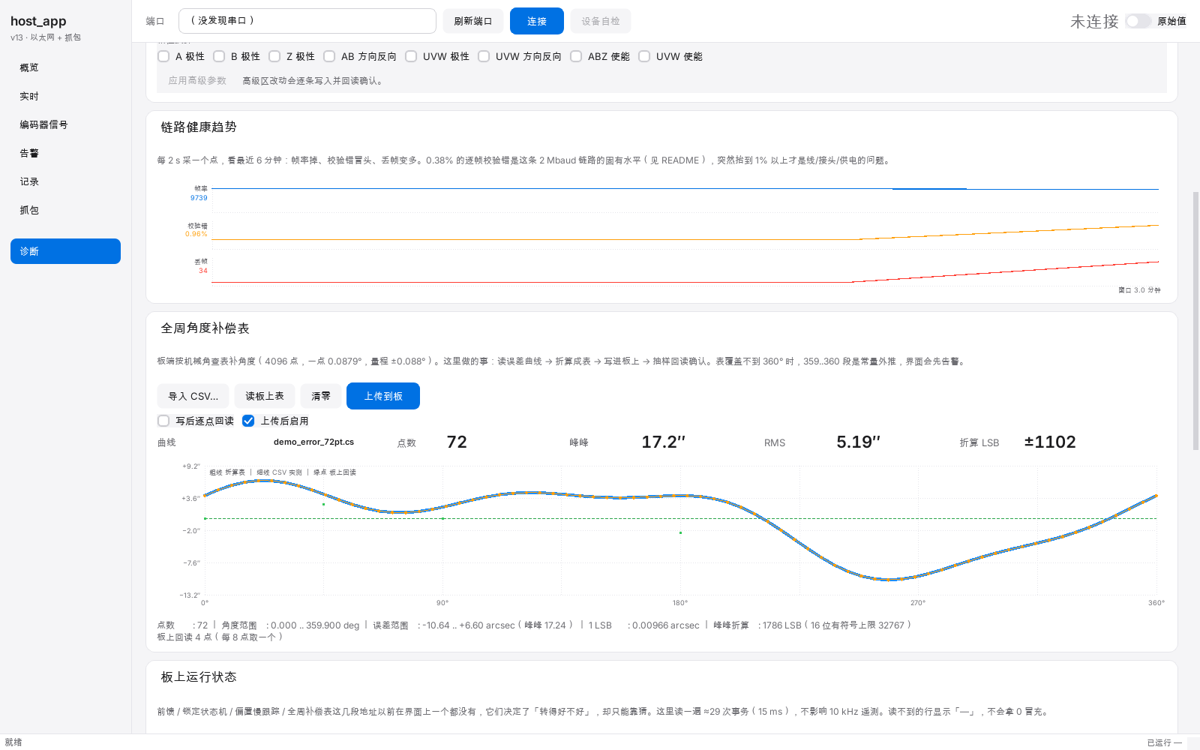
docs/img/42_diag_lut_health.png
