zhaoyunfengntzx-maker/fpga-smr-encoder/docs/img/42_diag_status.png

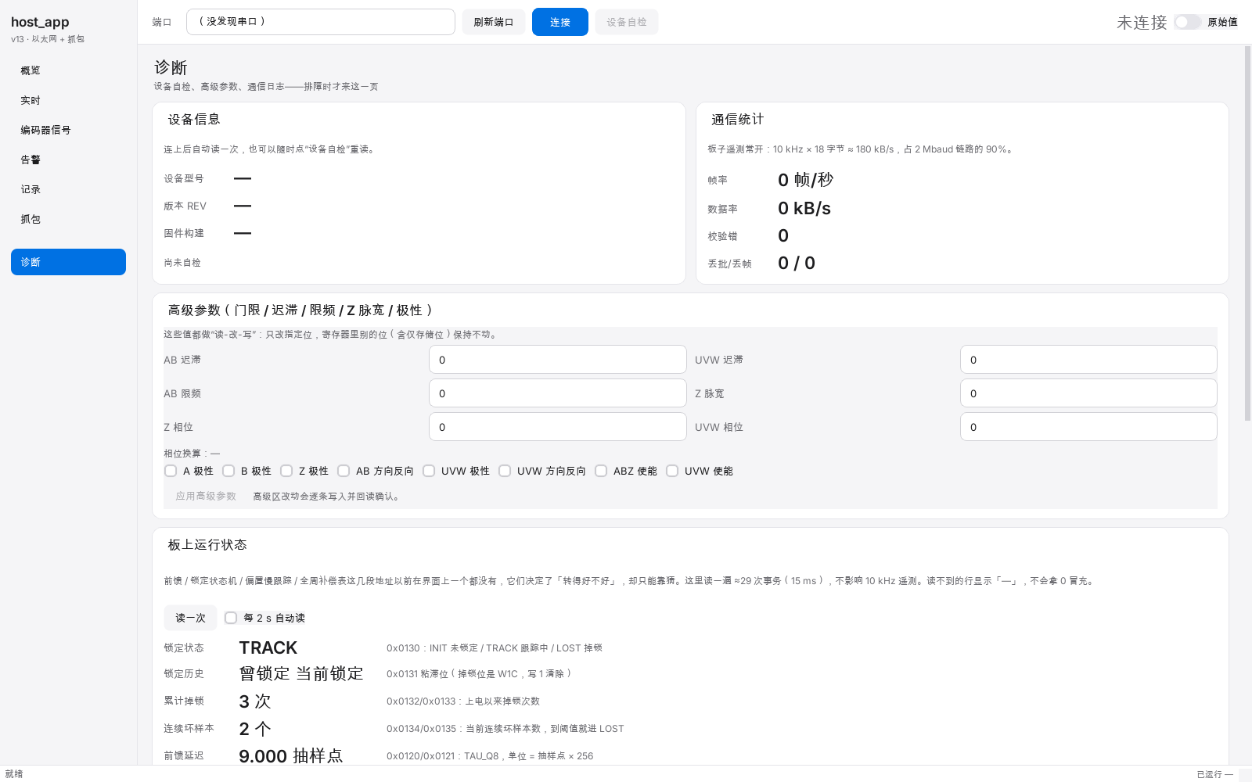
docs/img/42_diag_status.png
