zhaoyunfengntzx-maker/fpga-smr-encoder/docs/img/42_live_quality.png

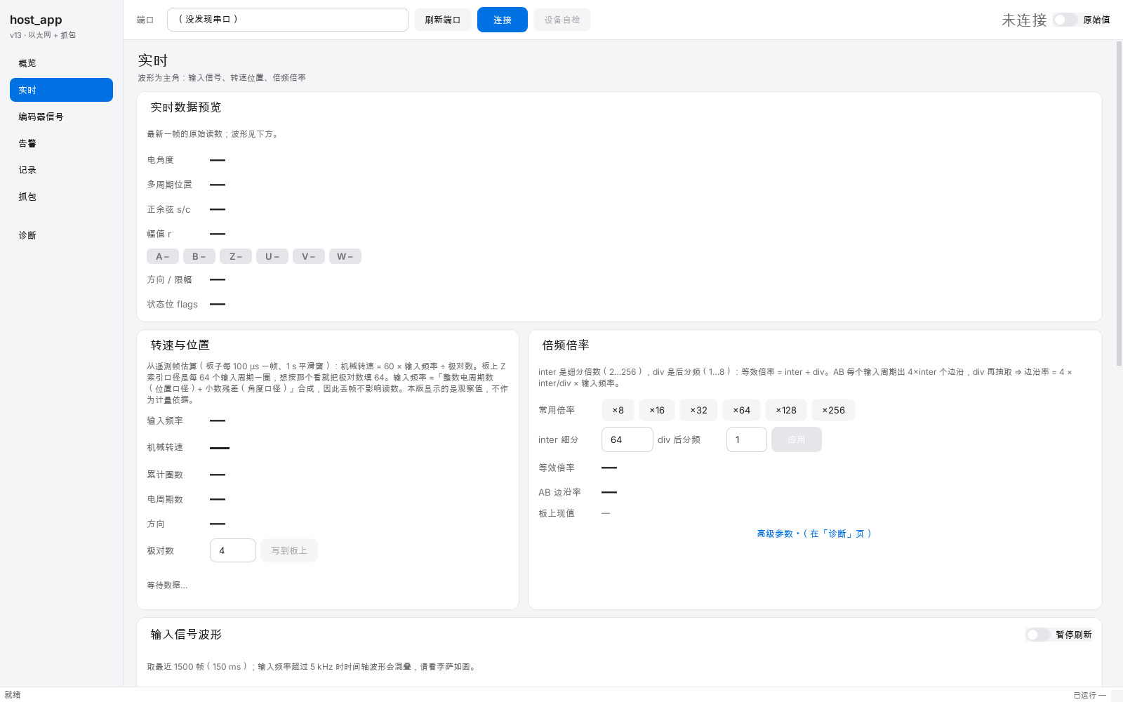
docs/img/42_live_quality.png
