zhaoyunfengntzx-maker/fpga-smr-encoder/docs/img/42_replay.png

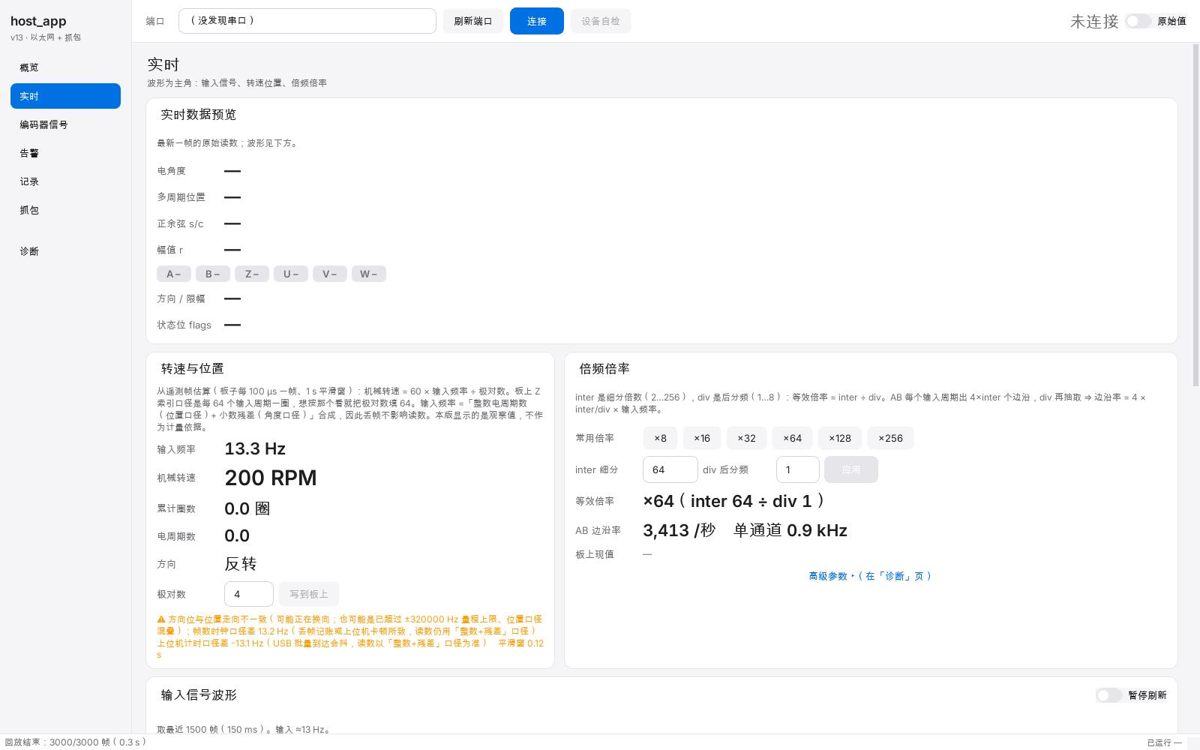
docs/img/42_replay.png
