zhaoyunfengntzx-maker/fpga-smr-encoder/docs/img/44_abz_uvw.png

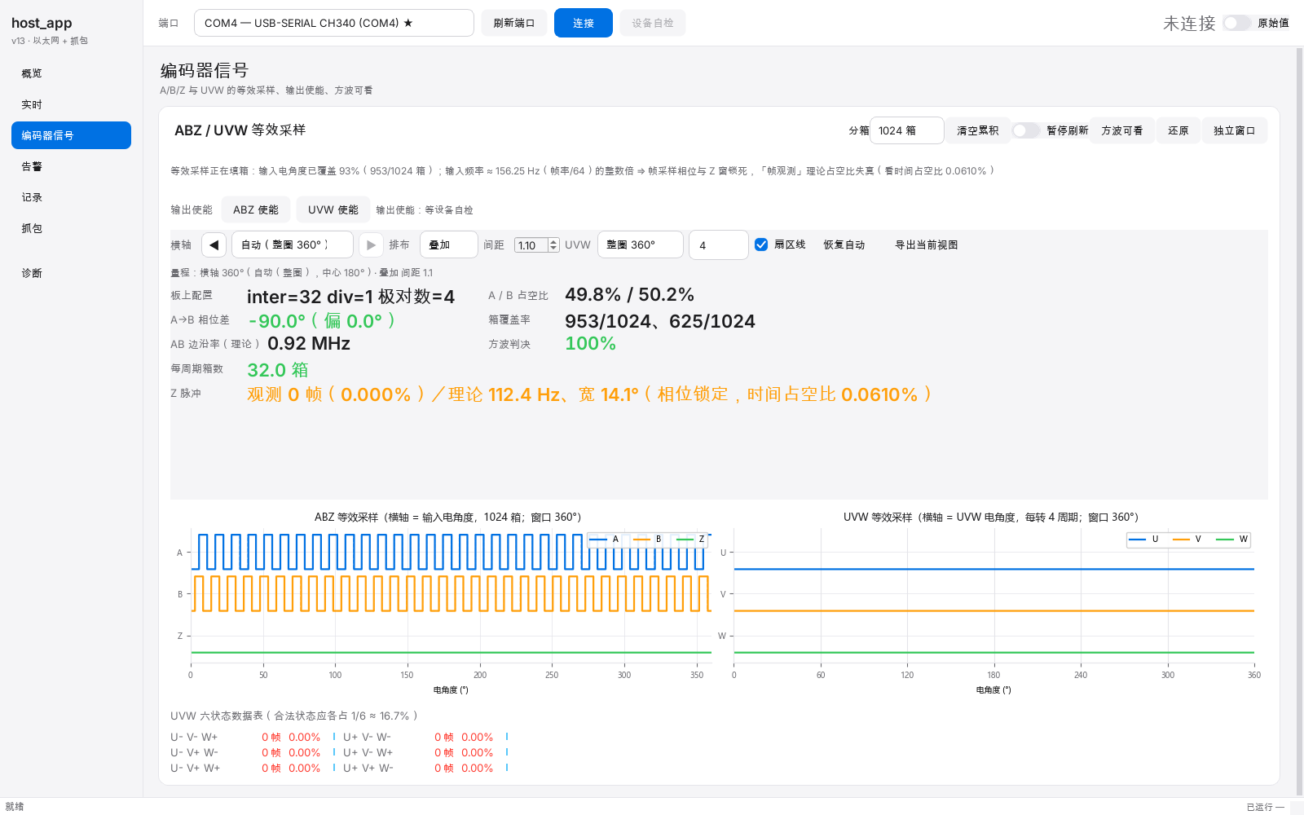
docs/img/44_abz_uvw.png
