zhaoyunfengntzx-maker/fpga-smr-encoder/docs/img/44_abz_uvw_blocks.png

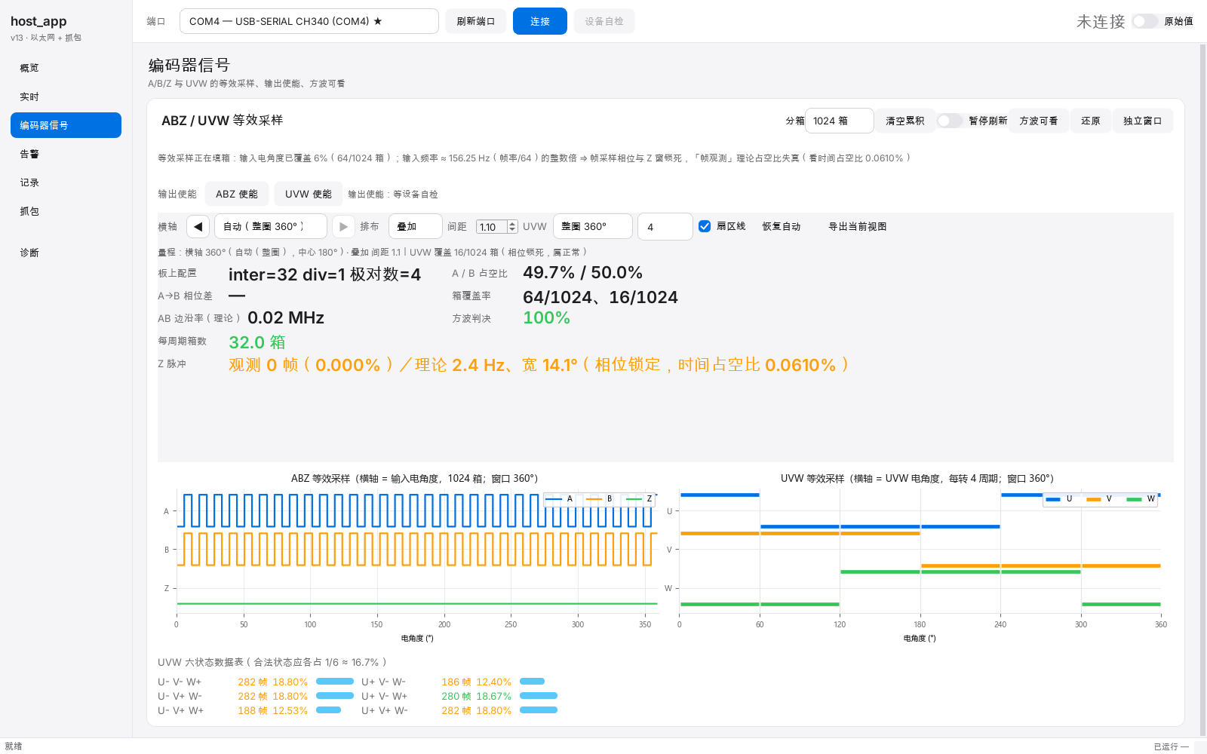
docs/img/44_abz_uvw_blocks.png
