zhaoyunfengntzx-maker/fpga-smr-encoder/docs/img/44_bias_card.png

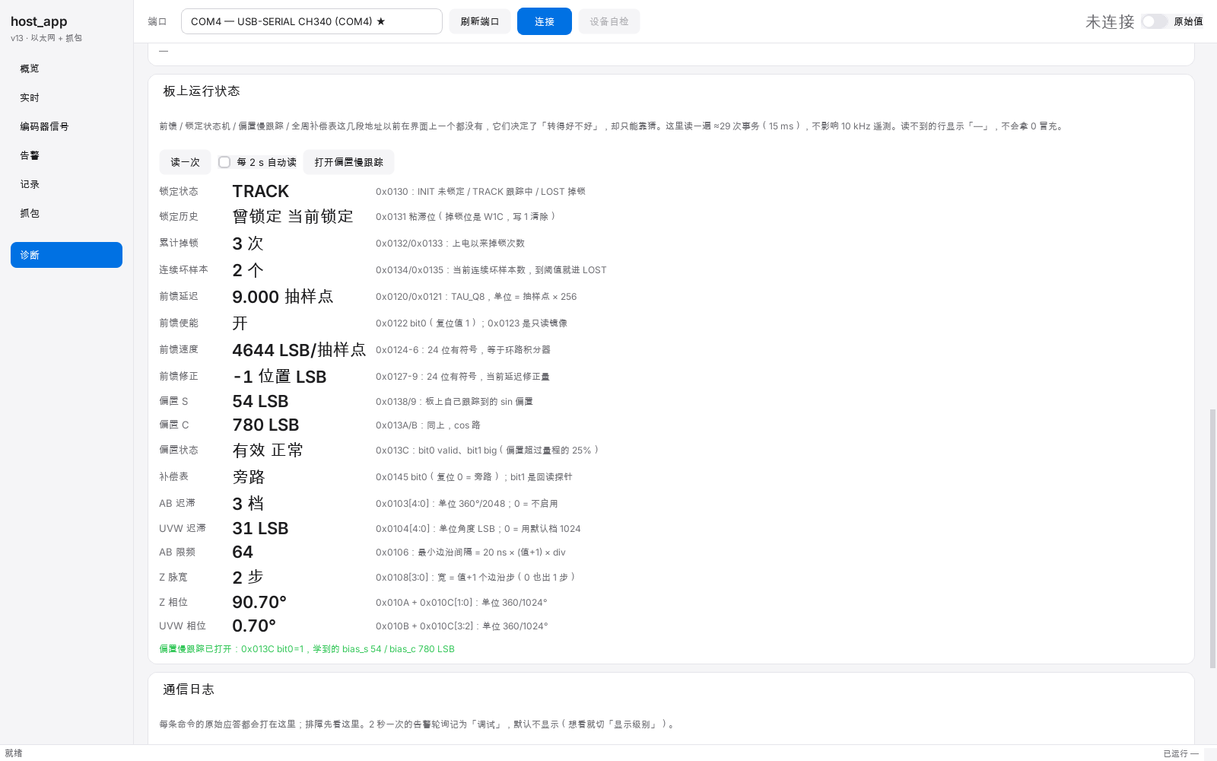
docs/img/44_bias_card.png
