zhaoyunfengntzx-maker/fpga-smr-encoder/docs/img/44_front_quality.png

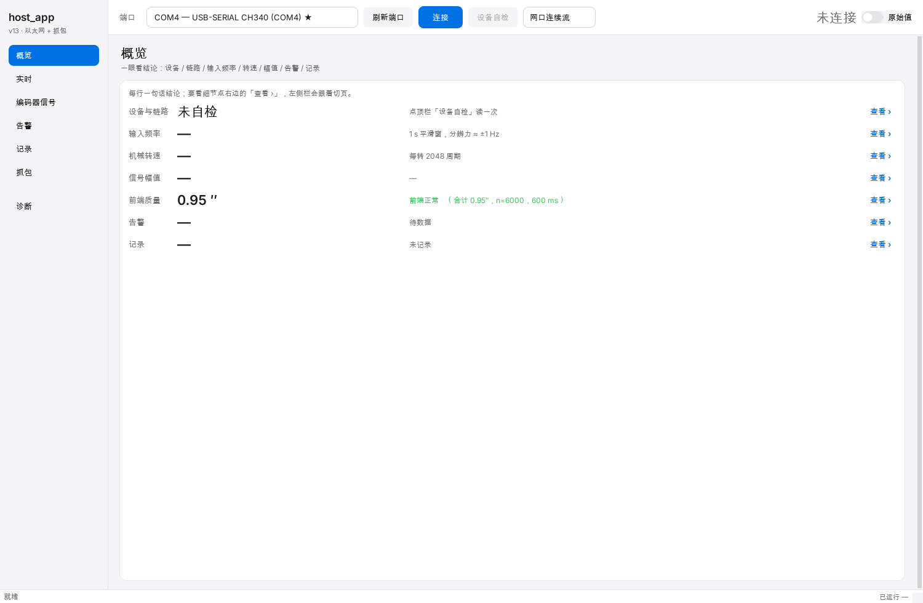
docs/img/44_front_quality.png
