zhaoyunfengntzx-maker/fpga-smr-encoder/docs/img/44_live_stable.png

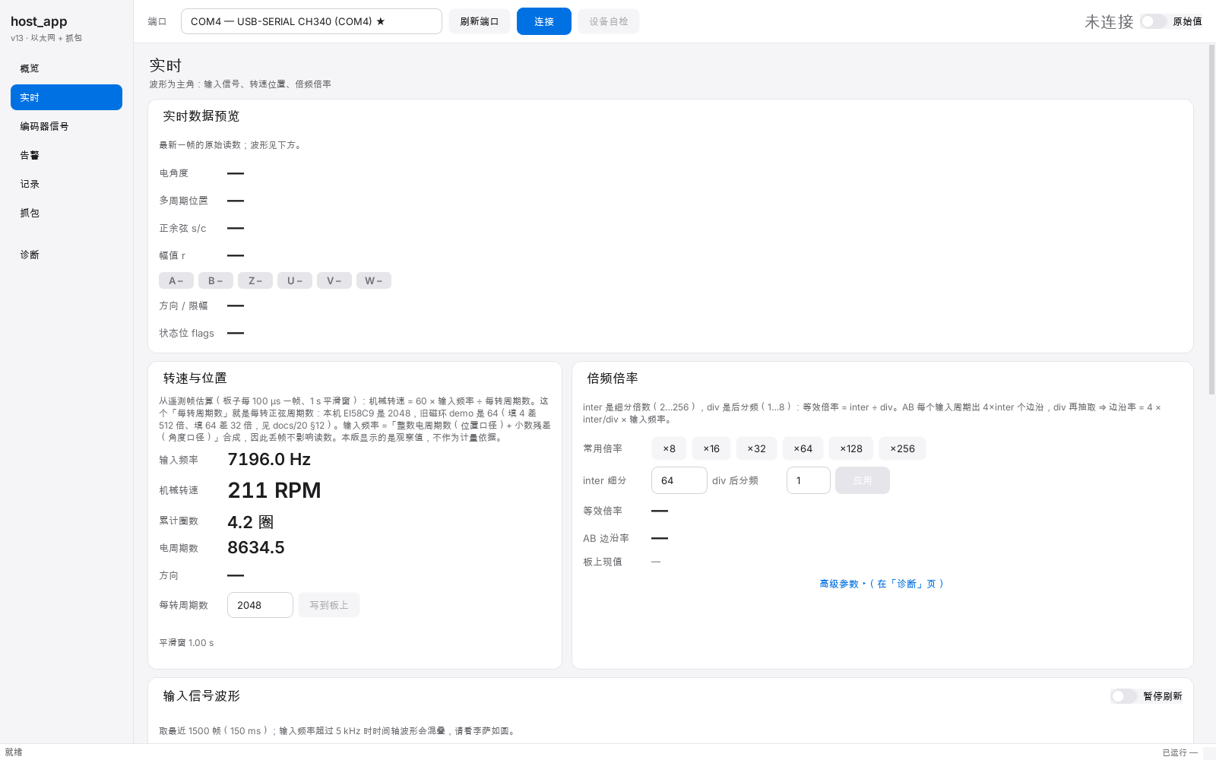
docs/img/44_live_stable.png
