zhaoyunfengntzx-maker/fpga-smr-encoder/docs/img/44_raw_wave.png

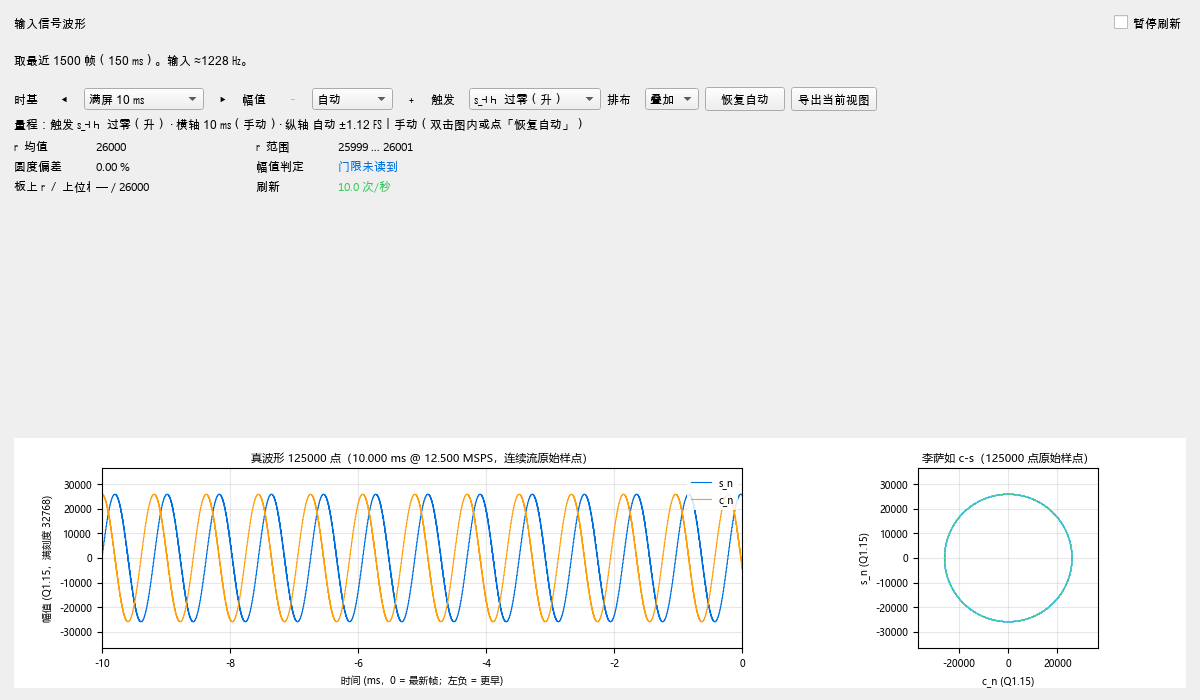
docs/img/44_raw_wave.png
