zhaoyunfengntzx-maker/fpga-smr-encoder/docs/img/44_raw_wave_ok.png

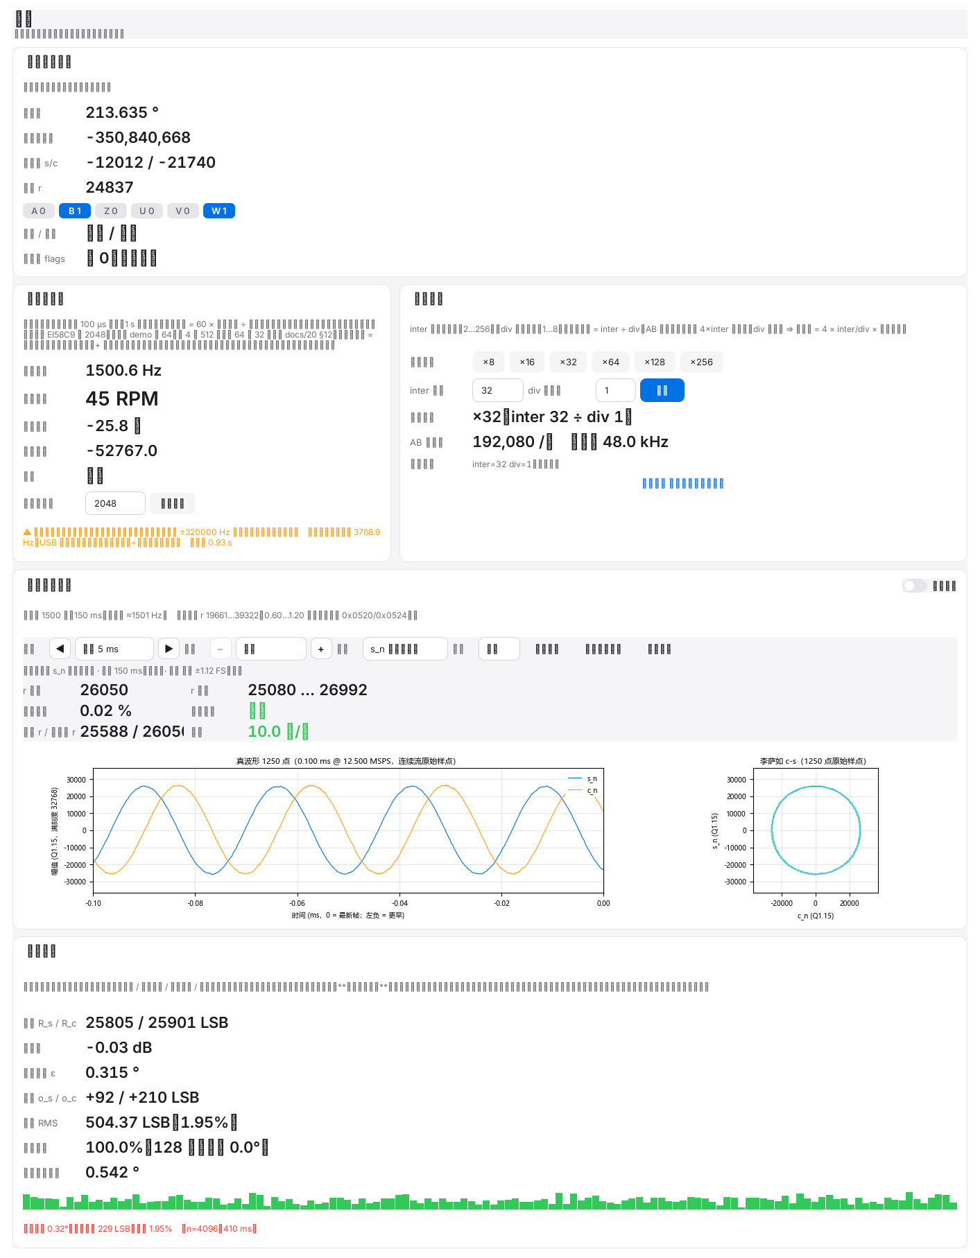
docs/img/44_raw_wave_ok.png
