zhaoyunfengntzx-maker/fpga-smr-encoder/docs/img/44_speed_card.png

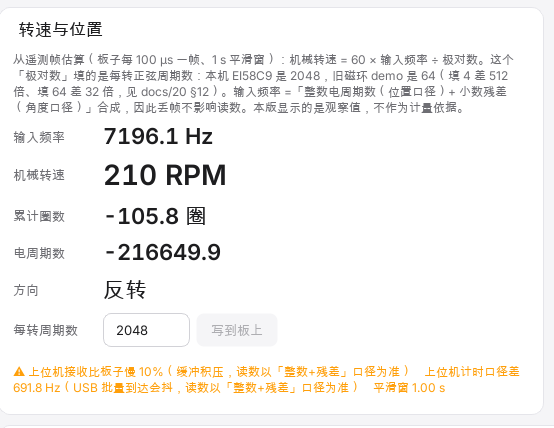
docs/img/44_speed_card.png
