zhaoyunfengntzx-maker/fpga-smr-encoder/docs/img/44_stable_report.png

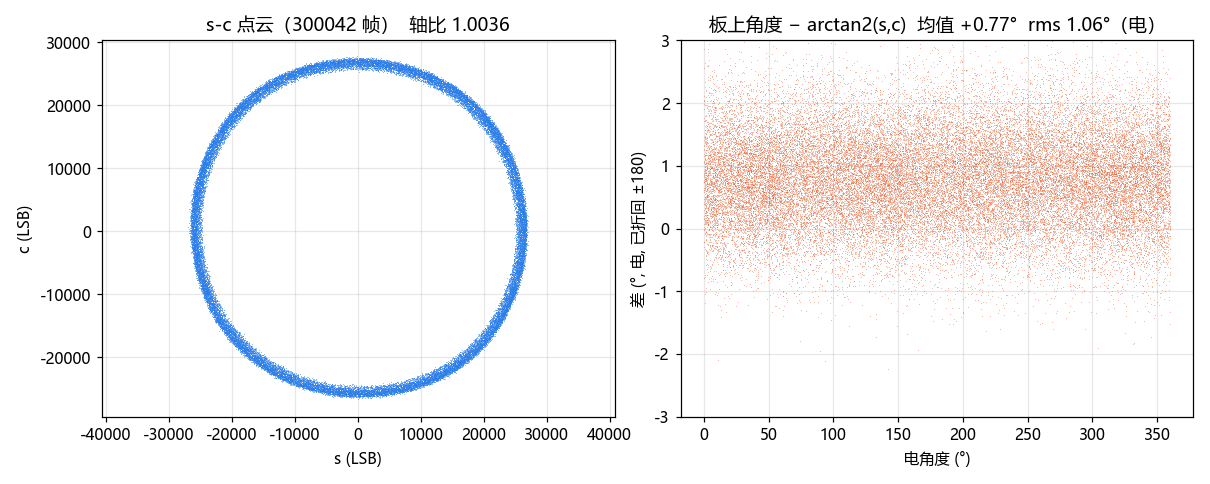
docs/img/44_stable_report.png
