zhaoyunfengntzx-maker/fpga-smr-encoder/host/_s5_soak/encoder_wave_20261013_194805.png

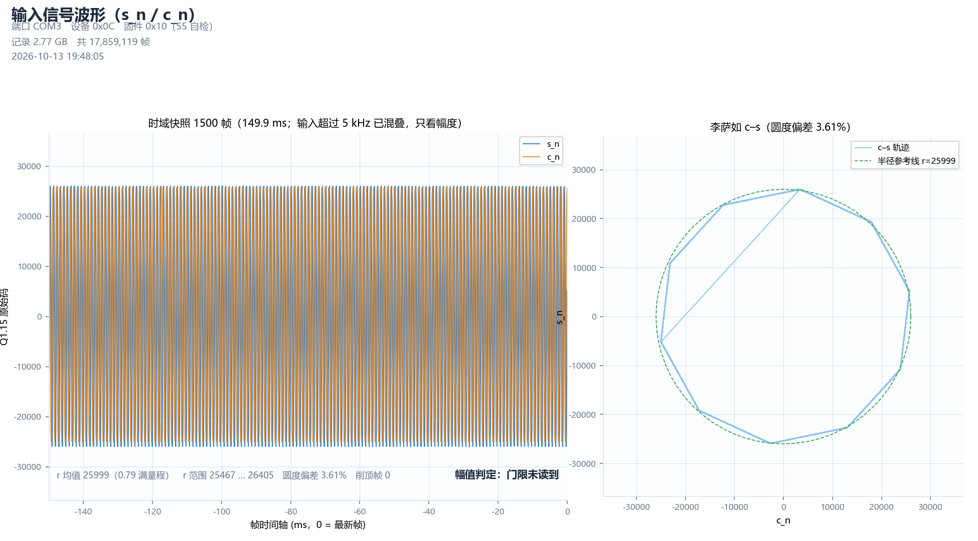
host/_s5_soak/encoder_wave_20261013_194805.png
