zhaoyunfengntzx-maker/fpga-smr-encoder/host/preview_s2.png

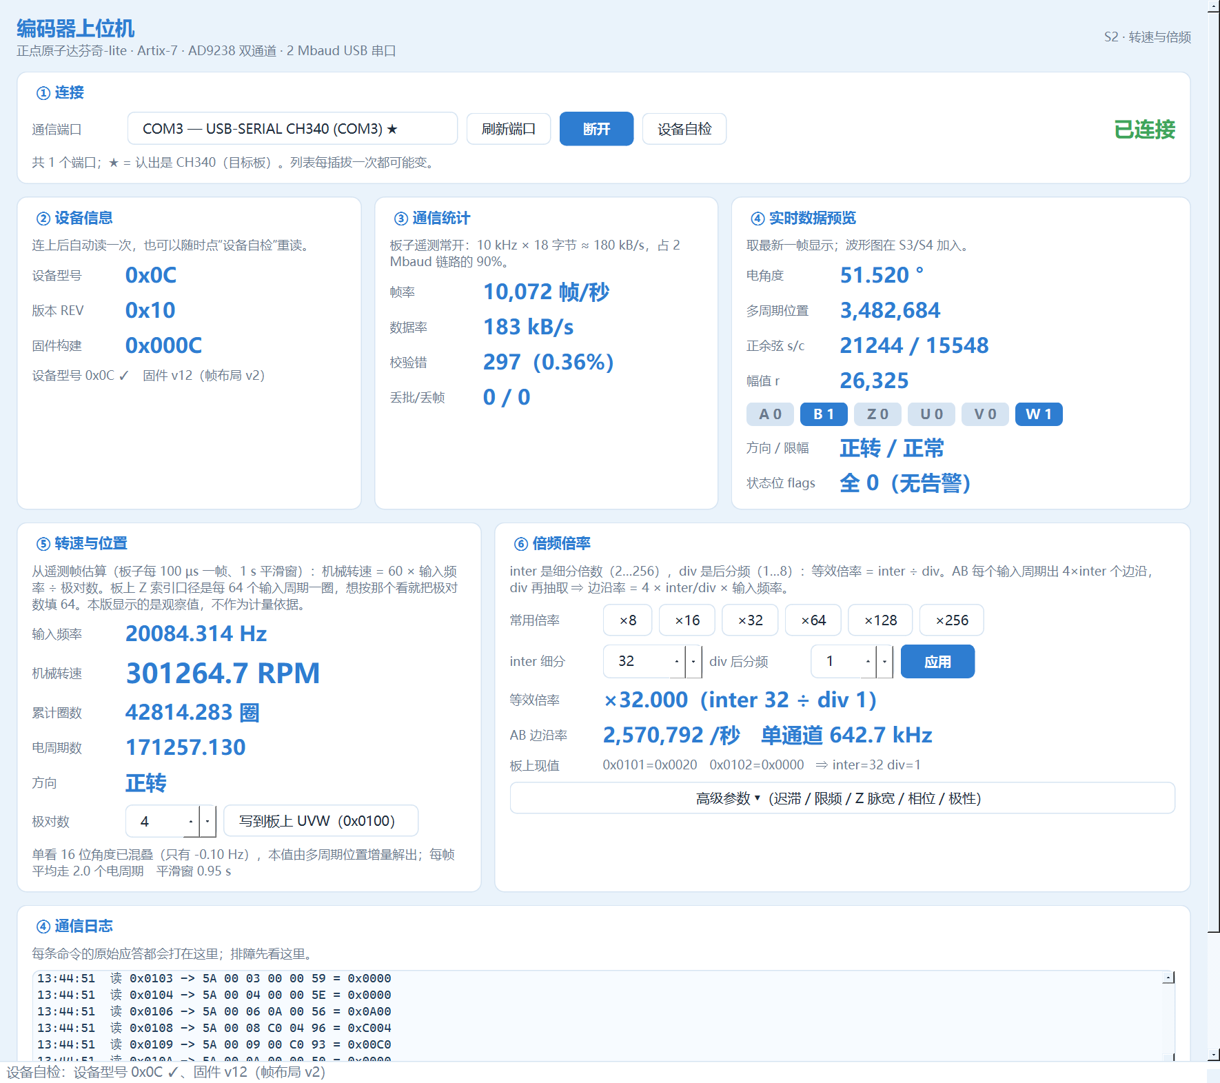
host/preview_s2.png
