zhaoyunfengntzx-maker/fpga-smr-encoder/host/preview_s3.png

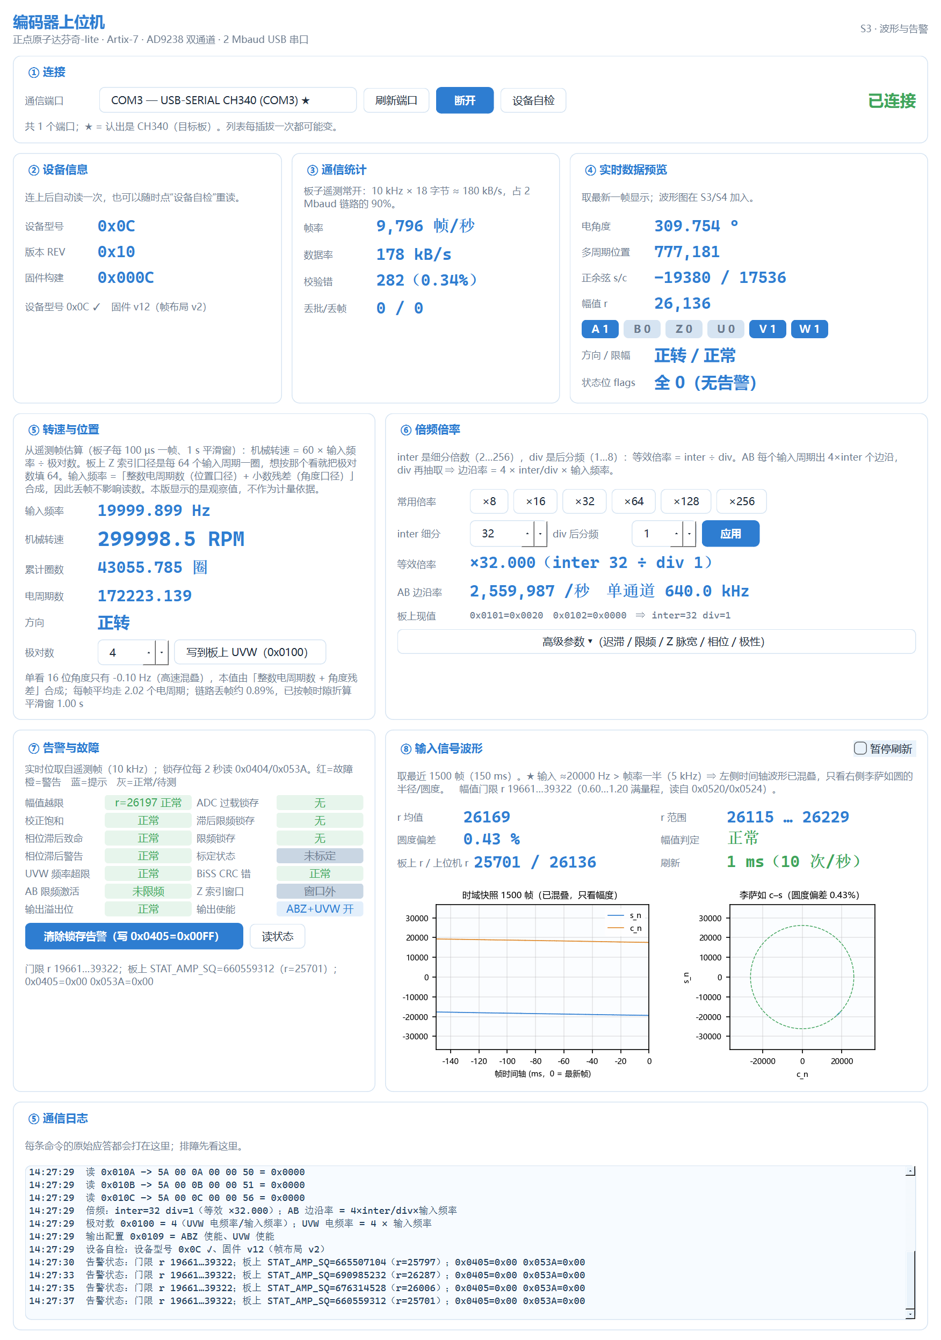
host/preview_s3.png
