zhaoyunfengntzx-maker/fpga-smr-encoder/host/preview_s4.png

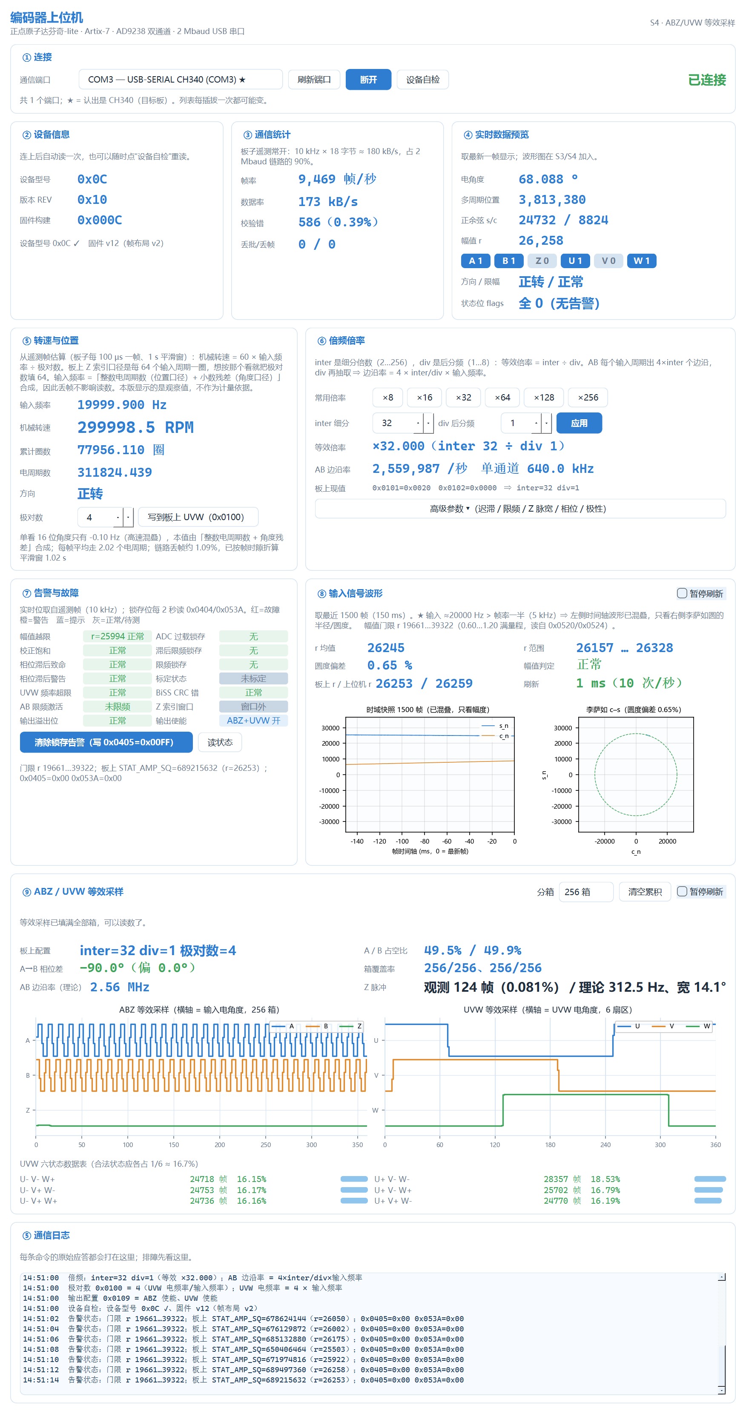
host/preview_s4.png
