zhaoyunfengntzx-maker/fpga-smr-encoder/deliverables/figures/fig_calib_steps.png

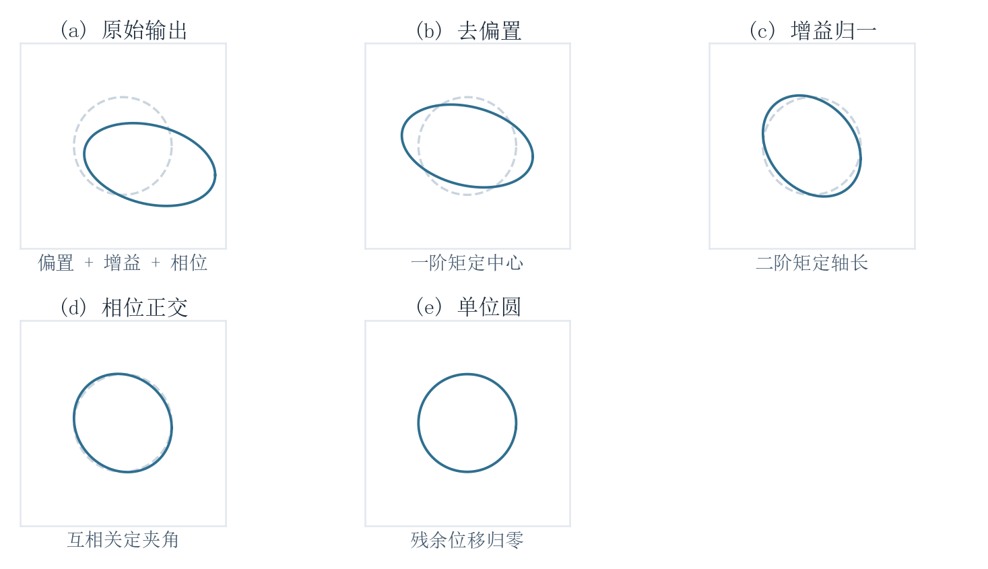
deliverables/figures/fig_calib_steps.png
