zhaoyunfengntzx-maker/fpga-smr-encoder/deliverables/figures/mech_assembly.png

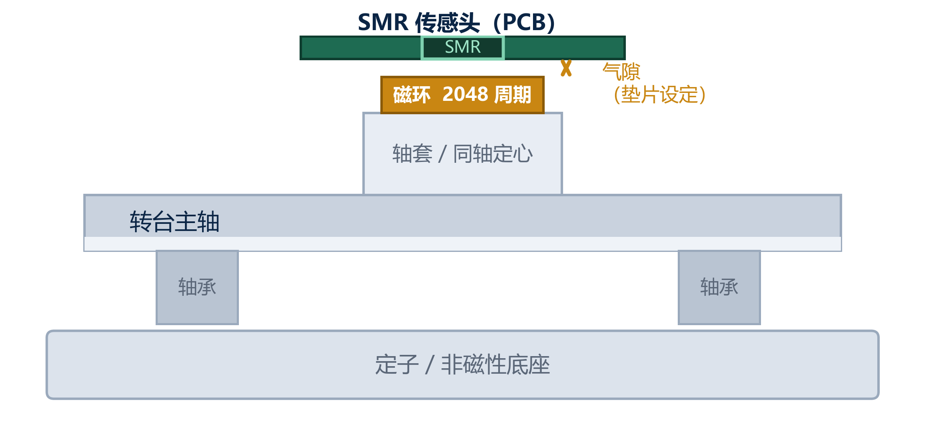
deliverables/figures/mech_assembly.png
