zhaoyunfengntzx-maker/fpga-smr-encoder/deliverables/figures/fig_verify_chain.pdf

Fixed-point model bit-exact vs RTL; RTL 24 modules + 8 eth; 57 benches; Build sign-off WNS +0.199 ns 24,691 endpoints; Board five criteria 597,886 frames

320 evidence files · 323 SHA-256 lines · one-command sign-off
