zhaoyunfengntzx-maker/fpga-smr-encoder/deliverables/figures/fig_calibration.pdf

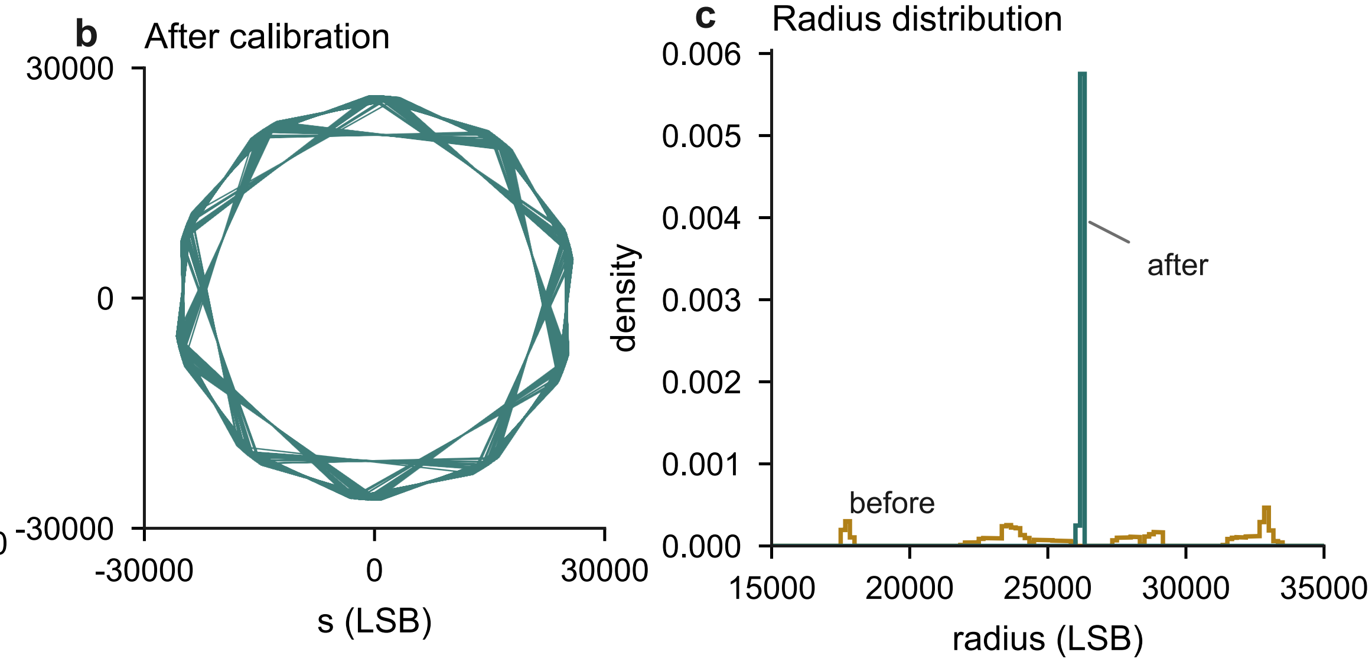
[picture p146: figure]
s (LSB); b After calibration; radius (LSB); density; before; after; Radius distribution
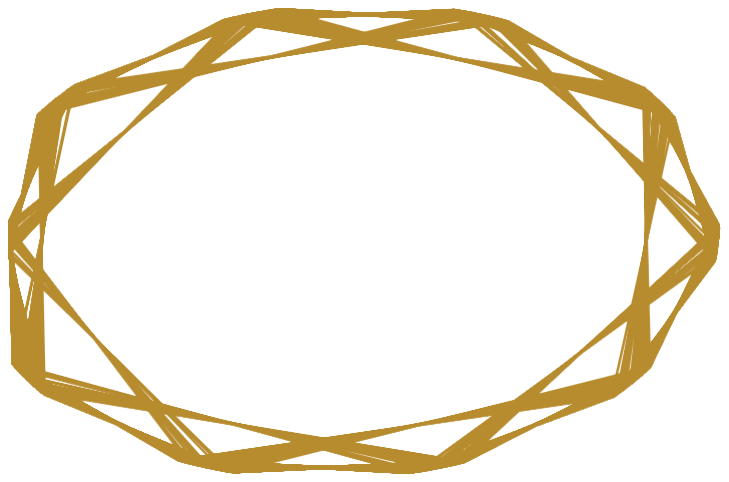
[picture p147: figure]

-30000 | 0 | 30000
| s (LSB)

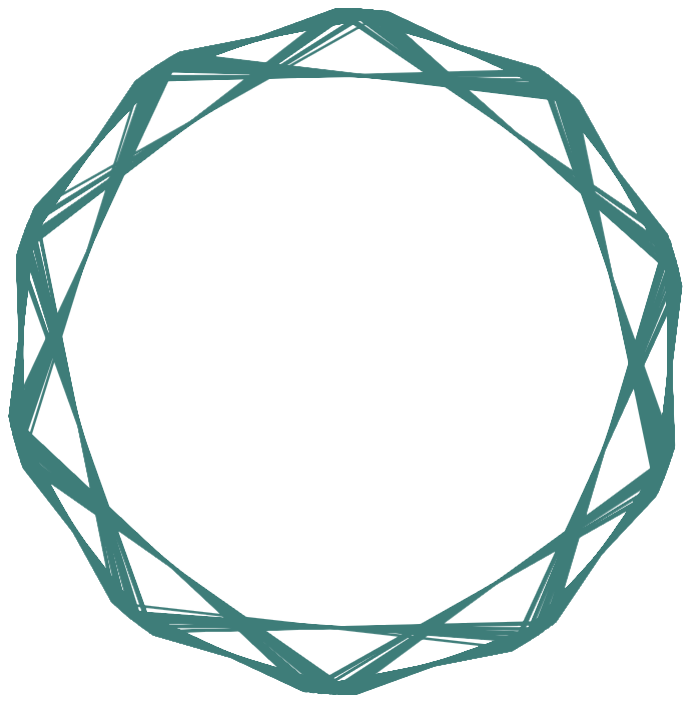
[picture p148: figure]

-30000

0

30000

c (LSB)

a Before calibration
