zhaoyunfengntzx-maker/fpga-smr-encoder/docs/15_display_touch_bringup.md

# 上板测试单：v58 五页 UI + 触摸/导航回归（原「P1 实时数值 + P8 触摸诊断」）

- 日期：________　执行人：________
- 位流（**v59，2026-10-22，本轮待烧**）：`_impl_v58/enc_top_disp.bit` —— 在 v58 五页基础上做了两件事：
  **① 总览页 3×2 → 2×3**（卡片 448×152 @ x 96/576、y 64/256/448；数值格由 64 px 压到 48 px，三行数值仍落格行 2/6/10；
  标签/单位/次级信息按 16 px 节奏重排；点卡片下钻仍是卡片 5→P7、卡片 6→P4）；
  **② 把 125M ↔ sys_clk 的 CDC 约束接进 disp 构建**（`tools/gen_merged_xdc.py` 生成 `constr/enc_top_disp.xdc` 时追加两条
  `set_max_delay -datapath_only 3.000`，与 `constr/enc_top_eth.xdc` 同一口径）—— 修之前 `clk_125_raw → sys_clk`
  132 个端点违例、WNS −1.090 ns，修之后 WNS **+0.586 ns**、`impl_timing.rpt` 设计内 0 failing。
  **必测增量**：A. 总览 6 张卡是否两列三行、文字不互相压（尤其第 3 行卡片底部）；B. 卡片点击是否仍分别跳 P7 / P4；
  C. `impl_timing.rpt` / `check_timing` 无 `clk_125_raw → sys_clk` 违例。位流大小与资源见 `_impl_v58/impl_util.rpt`。
- 历史位流（v55，8 页 → 5 页之前的最后一版）：**`_disp_work/enc_top_disp.bit`**（**1,294,005 B @ 2026-10-19 12:23:15**） —— 基础流程（`tools/impl_disp.tcl`）的最新一版，**含触摸命中判定（⑥）、P6 实时回读（⑦）、P2 输入波形页（⑧）、P3 李萨如 XY 页（⑨）、P4 ABZ/UVW 时序页（⑩）、P5 六状态表（⑪）、P7 标定与误差可视化（⑫）、内容网格右移（⑯）、上板缺陷修复（⑰）、P4 加宽 + P2 四枚徽标（⑱）、P6 设置页 3x4 + 危险区二次确认 + 状态栏三入口（⑲）、P2/P3 页内 Tab + 标题带主操作按钮 + P7 入口修正（⑳）、P4 45° 刻度 + P5 表格与占比刻度 + P7 幅值改百分比（㉑）与 触摸长按/拖拽/滑动 + 倍频编辑面板 + 回到上一次值（㉒）、字库扩容：lab 码 7→8 bit + `%` `×` `÷` 与 8 个新汉字（㉓）、面板「↩ 回到 ×N」+ 全局 ×/÷ 一致（㉔）、长按进度改真圆环（㉕）、P5 六状态表按 spec 重排：30 px 行距 / 188 px 列宽（㉖）、状态字模上屏：六卡迷你状态条 + ●▲✖ 字形（㉗）与 状态条反转视频：白字 + 状态色底（㉘）、状态字模第四重：可关闭的 2 Hz 闪烁 + P6 标题带复选框（㉙）、数字键盘兜底：12 键 + 三位七段（㉚）与 P8 按 spec §4.4 重排为「系统信息 / 自检」：设备 ID / 固件版本 / 链路统计 / 资源占用（㉛）、P8 第 ⑤ 项「自检结果」：三项 IIC 判据 + 通过 / 失败字模（㉜）与 P6 底部危险区 944×96 + 按钮 ±8 px 命中外扩（㉝）与 P4 等效采样注记按 spec §7 字面口径：「按电角度重建128箱等效采样」（14 格 + 4 个新汉字）（㉞）与 P1 两处口径注记按 spec §7 字面补齐：「估算值」+「本次上电起算」（3 + 6 格 + 4 个新汉字）（㉟）与 P5 六行状态名改汉字写法：`U高 V低 W低` …（字库 +2 字）（㊱）与危险区按钮的按下反馈：按住亮里侧 2 px 内框、在按钮内松开才弹询问态、询问态下按钮矩形不被压暗（㊲）与 P6 补齐第五行、把 spec §4.4 的「项高 88」做成字面：5 x 88 = 440（y 64..503）+ 危险区 96（504..599），标题层与数值层各走一套虚拟格网；第 5 行 = `增益S` / `增益C` / `相位修正`（Q1.15），（各 412 px、缝 16 px）（字库 +3 字）（㊴）与 **P2/P3 的 Tab 1 由 ASCII `SIM` 改成 spec 字面的「模拟」、P4 标题带按钮由 `EXPAND` 改成「展开」**（字库 +4 字：模 / 拟 / 展 / 开）（㊵）、**㊶ 面板也能改分频**（×倍频 ⇄ ÷分频八档步进、撤销标签 7 格 → 9 格）与 **㊷ 空态**（链路不可信时四个测量字段显示 `-`、四张测量卡 ✖ 故障）与 **㊸ 停摆空态**（无载波 ⇒ 四个测量字段显示 `-`、四张测量卡 ✖ 故障）与 **㊹ P8 说真话**（固件版本随位流版本、资源占用与报告一致）与 **㊺ 卡内 1 px 分隔线 + 卡 4 次级 `pos_full` 十六进制**与 **㊻ 卡 6 底部迷你 6 通道逻辑条**与 **㊼ 空态：P5 六状态表与 P2 四枚徽标逐格 `-`**、**㊽ 面板等效倍率 / AB 边沿率（右上两行）**与**㊾ 卡 6 次级行 `U● V● W○` + 主值圈字形**与**㊿ 卡片 3→P7 / 卡片 6→P4 两条下钻**与**v54 链路静默并入空态 + 清除锁存故障清 `crc_err_seen`（契约 v1.1）**与**v55 P8 固件版本号回到位流版本 `V55` + 链路失联门限口径 2 ms**。烧这一版。（**本轮基础流程过了时序**：WNS **+0.246 ns**、0 个失败端点、WHS **+0.054 ns**、LUT 14,493 = 69.68% ⇒ 交付件就是基础流程的产物，不必再走裕量恢复流程；上一轮也是基础流程（+0.505），更早一轮（㊽）因为编码器侧的慢性紧路径没过，改烧过一版裕量恢复位流，见 `DEV_STATUS.md` U-52.5 第 5 条。）**早先走裕量恢复流程（`tools/impl_disp_opt.tcl`）出过两版：1,218,077 B（2026-10-15 18:32:21，基于 ⑥ 的源码）与更早的 1,169,053 B（14:49:22，**中文界面那一轮**）。后者**不含** ④⑤⑥⑦⑧⑨⑩⑪⑫⑬⑭⑮⑯⑰⑱⑲⑳㉑㉒㉓㉔㉕㉖㉗㉘㉙㉚㉛㉜㉝㉞㉟㊱㊲㊳㊴㊵，前者只作 WNS 对照，**那两版都不要烧**（㊽ 烧的是 1,695,373 B 的裕量恢复版；㊾ 1,630,625 B、㊿ 1,667,973 B、v54 1,692,877 B 都是基础流程版）。**㊸㊹㊺㊻㊼㊽㊾ 七版 + ㊿ + v54 + v55 十版的位流大小是 1,256,105 → 1,662,845 → 1,663,533 → 1,624,145 → 1,506,873 → 1,695,373 → 1,630,625 → 1,667,973 → 1,692,877 → 1,294,005 B（v55）：v55 的"未压缩"位流同样是 2,192,225 B（= 1,294,005 B + 7,185,760 bit ÷ 8），差的只是"压缩压掉多少" —— 这一版只改了两个字形码（`V47` → `V55`），LUT 反而少 2 个（14,495 → 14,493），placer 因此走了另一条路，压缩率跟着变高，于是成了历史上最小的一版；**它不代表功能被删**，所以位流大小照样不要跨版本横比；同理，实现报告的 mtime 比构建日志末行早半小时（构建途中机器时钟被向前校正，U-28 起连着三轮如此），**判"是不是最新一版"要看大小/内容或重跑，别只看时间戳**（见 `DEV_STATUS.md` U-30.6、U-31.7、U-32.7、U-33.7、U-34.7、U-35.7、U-36.7、U-37.7、U-38.7、U-39.7、U-40.7、U-41.7、U-42.7、U-43.7、U-44.7、U-45.7、U-46.7、U-47.7、U-48.7、U-49.7、U-50.7、U-51.7、U-52.7、U-53.7、U-54.7）。**
- 顶层：`disp/enc_top_disp.v`　约束：`constr/enc_top_disp.xdc`
- 这次要回答的唯一问题：**`0x814E` 恒为 0 的历史现象，是否随 I2C 看门狗的两处修复一起消失？**

> **v58 阅读提示（2026-10-22）**：本测试单保留 2026-10-15 ～ 2026-10-19 的逐批上板记录，其中
> **§3（P8 九个数）、§4.4（P3 李萨如）、§4.6（P5 六状态）、§4.10（P2 四徽标）、§4.11（状态栏 ⚙ 三入口）、
> §4.12/§4.32（页内 Tab / 「展开」）、§4.13（P5 部分）、§4.18（P5）、§4.23/§4.24/§4.36/§4.43（P8）、
> §4.28（P5 汉字）、§4.39（P5 / P2 徽标）等小节仅作历史存档**——v58 已删除对应页面/控件，
> **不要再按这些小节判 FAIL**。v58 的必测项集中在 **§0.1**；操作步骤以 §2、§4.1、§4.3、§4.5、§4.7、§4.8
> 的 v58 标注为准。旧 8 页翻页链（P1→P2→P3→P4→P5→P6→P7→P8）已作废。

## 0. 前置条件（少一条就会误判）

| 项 | 要求 | 已确认 |
|---|---|---|
| ATK-7016 排线 | 插到底、不歪针 | ☐ |
| J9 / J10 跳线 | **两个 VCCIO 都必须拨到 3.3 V**（LCD 与 IIC 同在 Bank15，拨错则屏与触摸一起异常） | ☐ |
| 供电 | 5 V 稳定；屏背光亮 | ☐ |
| AD9238 模块 | **本测试不用**，插不插都行 | ☐ |
| 页切换按键 | **板载 `KEY1`（FPGA 引脚 Y9）**，按下接地翻页；**`KEY0`（W9）在本书设计里是全局复位，不是翻页键** | ☐ |
| 手指 | 必须裸指；隔手套/用笔尖测不出来 | ☐ |

### 0.1 v58 变更点（先读；旧 8 页步骤作废）

v58 把屏上页面从 8 页收到 **5 页**，页号保留空洞、**不重编号**：

| 页号 | 0 | 1 | 3 | 5 | 6 |
|---|---|---|---|---|---|
| 页面 | P1 总览 | P2 输入波形 | P4 逻辑时序 | P6 设置 | P7 标定 |

- **已删除**：P3 李萨如（XY，页 2）、P5 六状态（页 4）、P8 系统信息（页 7）。
- **左侧导航**：6 项×96 px → **4 项×144 px**（总览→0 / 波形→1 / 时序→3 / 设置→5）。
  `disp/hit_test.v` 的 `NAV_Y0=24`、`NAV_H=144`，四档边界 **y=24/168/312/456**。
- **KEY1 短按链**：**0→1→3→5→6→0**（跳过已删的 2/4/7），按 5 下回 P1。
- **P2**：删除 Tab 栏（模拟/XY）、四枚徽标（VPP-PC / F-HZ / DT-US / DV-PC）与底部「等效采样 100US」注记；
  波形 A 段 y=100..320、B 段 y=340..560。
- **P4**：删除「展开」按钮；波形框 y=100..596、通道行高 68 px（6 行）、轴标签行 y≈572。
- **字模**：数值 30×48（Arial Bold 原生栅格化，格 32×64）、小字 11×14（格 16×16），不再是 5×7 放大。

**5 条必测（全部通过才算 v58 上板验收）**

| # | 必测 | 操作 | 预期 |
|---|---|---|---|
| 1 | **4 档导航命中** | 在 x≈40 处依次点 y≈96 / 240 / 384 / 528；再在每档上下边界（24/167、168/311、312/455、456/599）各点一次 | 分别到 **P1 / P2 / P4 / P6**，左导航高亮跟着走；边界不串档、不翻错页 |
| 2 | **P1 大字清晰** | 看 P1 六张卡的主值（如 `1500.00`、`×64`、`1800.0`） | 30×48 笔画连续、无断笔/糊边/方块；不再有 5×7 放大的锯齿感 |
| 3 | **P4 波形填满** | 点导航「时序」进 P4 | 波形框下沿到 y=596，六行等高（68 px），轴标签在 y≈572；底部不再空出约 120 px |
| 4 | **右下角蓝线消失** | 分别停在 P2 / P4 / P6 / P7，看右下角 x≈752..1007、y≈512..560 | **0 条**残留横线/浅蓝短线；P1 卡片 6 内的六通道电平条属设计内，保留 |
| 5 | **P6 危险区仍可用** | 到 P6 底部红框危险区，按「清除锁存故障」再抬起 | 按下有内框反馈；抬起弹二次确认；`取消` 关闭、`确定` 写 `0x0405` 并回读成功 |

> 第 4 条对应 `docs/21_screen_ui_v2_requirements.md` 的 **R8**：`c6_band` 缺 `page==0` 门控，
> 旧版在 P1/P2/P3/P4/P7 右下角每页画 1–3 条 1 px 横线；v58 已加页门控。

## 0.2 v60 变更点与 10 条必测（2026-10-23）

本版解决上板后用户反馈的 7 条；完整变更表与根因在
[《22 屏幕 v60》](22_screen_ui_v60.md)。与 v59 相比可见的变化：

1. 总览右下角那几条蓝色横线**应该没了**（旧的卡 6 迷你电平条已整块删除）。
2. 总览六张卡的「✕ 故障」不再一窝蜂：**只接信号发生器时**频率/转速/角度三张卡看幅值（正常），
   「累计转数」卡看编码器链路（无激励时仍报故障，这是真的），倍频分频卡与
   ABZ/UVW 卡从不报故障。左侧那条竖带与标题带 ▲ 也分了两档：**红 = 没载波**，
   **橙 = 链路静默 / CORDIC 饱和 / 幅值超窗**（只接发生器时是橙色，
   不再一上电就红）。
3. 设置页左侧导航**四项齐全**（总览 / 波形 / 时序 / 设置）。
4. A/B/Z 右侧的圆形状态点**不再被裁掉一半**。
5. 各页数字**笔画粗细一致**（`1` 不再被拉宽）。
6. 波形页多了网格与左侧幅值刻度。
7. 时序页改成**触发式时域**：屏上图像停住不流动，横轴 `T-US 0..800`
   （100 µs/格），注记 `TRIG Z 2US/PT 428PT`。
8. 标定页参数从 6 项减到 **4 项**（OFS-S / OFS-C / GAIN-S / GAIN-C），曲线框加高。
9. 设置页标题带右侧多了 **DEMO 开关**（复选框实心 = 开）：打开后屏上六张卡切成一组
   演示值（1500.00 Hz 类），关掉回到真实遥测。它不写寄存器，重上电默认关。
10. **烧完不用再按 KEY0 了**：触摸上电顺序重排（RST 先压 200 ms），且若 1 s 内读不到
    GT911/FT，显示侧会**自动重走一次 RST/INT 脉冲**。若仍需按 KEY0 才能触，请把上电后
    第一屏的 `t9_retries` 远测值记下来。

以上十条按顺序过一遍就能判定本版是否到位；其余回归步骤（§3 / §4）仍然有效。

**本版位流**：`_impl_v58/enc_top_disp.bit`（**1,723,329 B @ 2026-10-23 00:56**），
资源 LUT **17,046 (81.95%)** / FF 11,206 (26.94%) / BRAM **46 (92%)** / DSP 18 (20%)，
时序 WNS **+0.108 ns**、WHS **+0.068 ns**、DRC 0 Errors。相对 v59 多出的 2.8k LUT
是 T7 触发式时域的 6,144 bit 分布式 RAM 与两路异步读（见 `docs/22` §7.2）。

## 1. 本次位流的时序账（已从实现报告抄录，烧录前核对）

来源：`_disp_work/impl_timing.rpt`、`impl_util.rpt`、`impl_route.rpt`

| 项 | 值 |
|---|---|
| WNS（建立） | **+0.411 ns**（20,647 端点，失败 **0**） |
| WHS（保持） | **+0.049 ns**（20,647 端点，失败 **0**） |
| WPWS（脉冲宽度） | +8.870 ns（8,602 端点，失败 0） |
| 结论 | 建立与保持**全部 MET**（失败端点 0、TNS/THS 均为 0.000） |
| 关键路径（建立） | `u_enc/u_regs/r_inter0_reg[2]/C` -> `u_enc/u_abz/r_ovl_reg[12]/D`（+0.411）（**编码器侧**） |
| 关键路径（保持） | `u_disp/u_val_format/waddr_reg[4]/C` -> `u_disp/u_p1_val_ram/mem_reg/ADDRARDADDR[8]`（+0.049）（**显示侧**） |
| 布线 | 可布网线全部布通，**0 条布线错误**；DRC **0 Errors** |
| 资源 | LUT **13,681**（65.77%）／FF 8,517（20.47%）／BRAM Tile **20.5**（41.00%）／DSP **21**（23.33%）／**IOB 94**（37.60%） |

**判据**：约束全过且失败端点为 0 ⇒ 可上板。

**S1 的字面判据**是 **WNS > +1 ns**（`docs/13_display_ui_requirements.md` 里程碑 S1）。**本版基础流程只有 +0.411 ns，按字面没达标**；但失败端点 0、TNS/THS 全 0，功能上可上板。**工具侧已经试到头了**：裕量恢复流程 `tools/impl_disp_opt.tcl` 与寄存器重定时两条路都不比基础流程好（WNS 分别 +0.582 / +0.640，基础流程 +0.631 —— 三路落在 0.058 ns 的带宽里，而同一份源码历史上相邻两次就能差 0.358 ns，属于布局噪声）；那条压时间的锥体主体是 **12 级 CARRY4 进位链**（共 29 级逻辑），重定时搬得动寄存器、搬不动进位链。要拿 > +1 ns 只剩「在编码器输出级切一刀」这一条路（会作废编码器 v12 签核），详见 `DEV_STATUS.md` 的 `U-19`。**WNS 的绝对值受布局效应支配**：最近四十五次的 LUT 是 8,726 / 8,719 / 8,719 / 8,751 / 8,871 / 9,017 / 9,131 / 9,255 / 10,023 / 10,246 / 10,268 / 10,242 / 10,851 / 11,365 / 11,474 / 11,741 / 12,170 / 12,131 / 12,182 / 12,168 / 12,516 / 12,517 / 12,564 / 12,588 / 13,531 / 13,519 / 13,406 / 13,384 / 13,384 / 13,384 / 13,384 / 13,480 / 13,527 / 13,681 / 13,681 / 14,064 / 14,004 / 14,042 / 14,047 / 14,072 / 14,147 / 14,154 / 14,435 / 14,471 / 14,466 / 14,495（最大波动 60.8%），WNS 却是 +0.890 → +0.329 → +0.547 → +0.414 → +0.467 → +0.215 → +0.438 → +0.400 → +0.273 → +0.631 → +0.456 → +0.445 → +0.543 → +0.522 → +0.485 → +0.602 → +0.250 → +0.685 → +0.607 → +0.286 → +0.763 → +0.368 → +0.473 → +0.292 → +0.587 → +0.678 → +0.678 → +0.678 → +0.741 → +0.218 → +0.411 → +0.411 → +0.411 → +0.292 → +0.601 → +0.783 → +0.218 → +0.564 → +0.438 → +0.913 → +0.308 → +0.387 → +0.666 → **+0.505**，**方向反复、单次幅度超过 0.4 ns**（㉕ 只加了一张 5,120 bit 的小表、LUT 反而少 14 个，WNS 就掉了 0.321 ns；㉖ 加了 348 个 LUT、526 个 FF 与一个 DSP，WNS 反而涨了 0.477 ns；㉗ 只加了 3 个 5×7 字形、一个 40 来行的状态机（+1 个 LUT）与 6 把写口仲裁，WNS 就掉了 0.395 ns；㉘ 只加了六段矩形比较与一层 2 bit mux（+47 个 LUT）与一处预览器同源，WNS 就涨了 0.105 ns；㉙ 只加了一段 4 bit 帧分频寄存器与一条门（+24 个 LUT）与 P6 一颗复选框，WNS 就掉了 0.019 ns；㉚ 只加了 24 行组合七段译码器、一张 12 键栅格与三位输入窗（+943 个 LUT），WNS 一分没动（前后都是 +0.454 ns）；㉛ 只把九个字段的含义换掉、加了 12 个汉字（字库 155 码）（-12 个 LUT），WNS 就掉了 0.162 ns；㊳ 给 P6 补了第五行与一整套虚拟格网（行号/格内 y 的比较器与 mux + 十几个流水寄存器），字库从 173 码加到 176 码（+47 个 LUT），WNS 就掉了 0.523 ns）；㊴ 给危险区加了第二颗按钮与一个 13 条命令的 UART 序列模块（比较器 + FSM + 17 项回读比对）、一套红 ✖ 覆盖层与第二套对话框行，字库从 176 码加到 179 码（+154 个 LUT），WNS 就涨了 0.193 ㊵ 把 Tab / 标题带按钮的 ASCII 标签换成 spec 字面的汉字（字库 +4 字：模 / 拟 / 展 / 开）（+0 个 LUT），WNS 一分没动（前后都是 +0.411 ns）；㊶ 加了面板字段切换按钮与「两字段待应用值」（+383 个 LUT），WNS 掉了 0.119 ns，而且真值是「改了三次才收住」——位拆分从串行减法链改成并行比较，才把 -2.923 ns 的 19 条失败端点清零；㊷ 只加了一根「链路不可信」的线与四个字段的空态分支（-60 个 LUT），WNS 就涨了 0.309 ns；㊸ 把「无载波」并进空态判据（只加一根幅值比较线与一个或门，+38 个 LUT），WNS 就涨了 0.182 ns；㊹ 只把 P8 的版本号与资源百分比改成单点来源（+5 个 LUT），WNS 就掉了 0.565 ns；㊺ 加了一条卡内分隔线与一个 8 格十六进制写者（+25 个 LUT），WNS 就涨了 0.346 ns；㊻ 只加了六条卡内电平线（+75 个 LUT），WNS 就掉了 0.126 ns；㊼ 只把两处空态改成三目选择（+7 个 LUT），WNS 就涨了 0.475 ns；㊽ 只加了一个复用两次的分频器、两行五格数字与两条标签（+281 个 LUT），而这一轮的交付件改走**裕量恢复流程**（同一份源码：基础流程 WNS **−0.347 ns** / 13 个失败端点，裕量恢复流程 **+0.308 ns** / 0 失败端点 —— 跨流程本就不严格可比），㊾ 只加了一个 105 行的次级行写者、两级圈字形与一张平面专属字表（+36 个 LUT），WNS 就涨了 0.079 ns，㊿ 只加了两条命中判据与两个页号赋值（-5 个 LUT），WNS 就涨了 0.279 ns，U-55 改了 rtl/ 的链路心跳计数器和一条 W1C 清位、抽头宽度 375→376、显示侧只多一个或门输入（+29 个 LUT），WNS 就掉了 0.161 ns，所以这条数不要跨版本横比；要看的是「失败端点是否为 0」。

- 基础流程 `tools/impl_disp.tcl` **故意不加任何 directive**（为了与编码器 v12 那次签核横向可比，见该文件 :62-64），本版给的是 WNS **+0.411**；要更多裕量就走**裕量恢复流程** `tools/impl_disp_opt.tcl`（`opt_design` + `place_design -directive ExtraTimingOpt` + `phys_opt_design -directive AggressiveExplore` + `route_design -directive Explore` + 再一轮 `phys_opt`），产物是 `_disp_work/enc_top_disp_opt.bit` / `opt_*.rpt`，与基础流程文件互不覆盖。两版功能等价。（**U-19 做过完整对照**：同一份源码分别走基础流程 / 裕量恢复流程 / 加重定时，WNS 是 +0.631 / +0.582 / +0.640 —— 裕量流程反而**差 0.049 ns**。这类流程只捞得回 0.1 ns 量级，不是 +1 ns 量级。）
- 压时间的路径：**建立**最差那条这一版在 `u_enc/u_regs/r_inter0_reg[2]/C` -> `u_enc/u_abz/r_ovl_reg[12]/D`（+0.411）（**编码器侧**）。**保持**这一版最差的是 `u_disp/u_val_format/waddr_reg[4]/C` -> `u_disp/u_p1_val_ram/mem_reg/ADDRARDADDR[8]`（+0.049）（**显示侧**；这条最差保持路径一直在编码器侧与显示侧之间漂，⑯⑰⑱⑲⑳㉑㉒㉓㉔㉕㉖㉗㉘㉙㉚㉛㉜㉝㉞㉟㊱㊲㊳㊴㊵㊶㊷㊸㊹㊺㊻㊼㊽㊾㊿、U-55 三十六轮里已经出现过 `u_disp/u_p2_badge`、`u_disp/u_p7_bef_ram`、`u_enc/u_cordic`、`u_disp/u_p7_aft_ram`、`u_enc/u_regs` 与 `u_disp/u_p5_view` 六种落点，㉒㉓ 连着两轮落回 `u_enc/u_cordic`，㉔ 挪到显示侧，㉕㉖ 又落回 `u_enc/u_cordic`，㉗ 落在 `u_enc/u_spi`，㉘ 落在 `u_enc/u_cordic`，㉙ 落在 `u_enc/u_bridge`，㉚ 落在 `u_disp/u_p7_view`，㉛ 落在 `u_enc/u_cordic`，㉜ 落在 `u_disp/u_p2_badge`，㉝ 落在 `u_disp/u_p7_view`，㉞ 落在 `u_disp/u_p7_view`，㉟ 落在 `u_disp/u_p7_view`，㊱ 落在 `u_disp/u_p7_view`，㊲ 落在 `u_disp/u_p7_view`，㊳ 落在 `u_enc/u_cordic`，㊴ 落在 `u_disp/u_val_format`，㊵ 落在 `u_disp/u_val_format`，㊶ 落在 `u_disp/u_p7_view`，㊷ 落在 `u_enc/u_scope`，㊸ 落在 `u_disp/u_p7_view`，㊹ 落在 `u_disp/u_p2_badge`，㊺ 落在 `u_enc/u_cordic`，㊻ 落在 `u_disp/u_p7_view`，㊼ 落在 `u_disp/u_p2_badge`，㊽ 落在 `u_enc/u_cordic`，㊾ 落在 `u_enc/u_cordic`，㊿ 落在 `u_disp/u_p7_view`，U-55 落在 `u_disp/py1_reg[2]`；㉓ 只动了字符码位宽与字库就把建立最差那条从 `r_inter0_reg[5]` 换成 `r_inter0_reg[0]`，㉔ 只加了一个 7 拍写序的小模块又把保持最差从编码器侧挪到显示侧，㉕ 只加了一张 5,120 bit 的圆环折叠表就让 WNS 掉 0.321 ns（**而那张表根本没进最差 20 条**），㉖ 加了 348 个 LUT / 526 个 FF / 一个 DSP，WNS 反而涨 0.477 ns（**P5 的新比较器同样没进最差 20 条**），㉗ 只加了 3 个 5×7 字形 / 一个状态机 / 6 把写口仲裁，WNS 就掉 0.395 ns（**六张卡的状态条同样没进最差 20 条**），㉘ 只加了六段矩形比较 / 一层 2 bit mux，WNS 就涨 0.105 ns（**状态条的反色块同样没进最差 20 条**），㉙ 只加了 4 bit 帧分频寄存器 / 一条门 / P6 一颗复选框，WNS 就掉 0.019 ns（**闪烁那一段同样没进最差 20 条**），㉚ 只加了 24 行组合七段译码器 / 一张 12 键栅格 / 三位输入窗，WNS 一分没动（**键盘那一段同样没进最差 20 条**），㉛ 只换了九个字段的含义并加 12 个汉字（+-12 个 LUT），WNS 就掉了 0.162 ns（**P8 那九个字段同样没进最差 20 条**），㉜ 只加了 2 格底栏写者与 8 个汉字（+-113 个 LUT），WNS 就涨了 0.295 ns（**自检那两格同样没进最差 20 条**），㉝ 只动了两个 y 常量与四个命中边界（-22 个 LUT），WNS 就涨了 0.091 ns（**危险区那条横条同样没进最差 20 条**）㉞ 只加了 4 个汉字字模与 14 格注记（一个 LUT 都没加）（+0 个 LUT），WNS 一分没动（**P4 那行注记同样没进最差 20 条**）㉟ 只加了两句口径注记与 4 个汉字字模（+0 个 LUT），WNS 一分没动（**P1 那两句注记同样没进最差 20 条**）㊱ 只把六行状态名的 0/1 换成两个汉字（+0 个 LUT），WNS 一分没动（**P5 那六行状态名同样没进最差 20 条**）㊲ 只加了一段按下比较、一道 2 px 内嵌框与两处 mux（+96 个 LUT），WNS 就涨了 0.063 ns（**那颗按钮的按下内框同样没进最差 20 条**）㊳ 给 P6 补了第五行与一整套虚拟格网（行号/格内 y 的比较器与 mux + 十几个流水寄存器），字库从 173 码加到 176 码（+47 个 LUT），WNS 就掉了 0.523 ns（**P6 那第五行同样没进最差 20 条**）（**那颗新增按钮与序列模块同样没进最差 20 条**）㊴ 给危险区加了第二颗按钮与一个 13 条命令的 UART 序列模块（比较器 + FSM + 17 项回读比对）、一套红 ✖ 覆盖层与第二套对话框行，字库从 176 码加到 179 码（+154 个 LUT），WNS 就涨了 0.193 ns（**那颗新增按钮与序列模块同样没进最差 20 条**）（**这 4 个新字同样没进最差 20 条**）㊵ 把 Tab / 标题带按钮的 ASCII 标签换成 spec 字面的汉字（字库 +4 字：模 / 拟 / 展 / 开）（+0 个 LUT），WNS 一分没动（**这 4 个新字同样没进最差 20 条**）—— 十八轮都是布局噪声）。无论如何：上板若出现**随机性**错误（偶发花屏、偶发计数跳变、偶发不响应），仍优先怀疑时序而不是一头扎进功能调试。
- **本版界面文字全部改成中文**（v58 导航 4 项：总览/波形/时序/设置；各页标题与卡片标签也是中文）。若屏上出现**方块/空白/错字**，先查字模而不是查接线。
- **翻页键的坑**：`key_n`（板载 KEY0 = W9）在原设计里是页计数器的**异步复位**，按它只会把页清回 P1，所以"按 KEY0 没反应"是正常的。现在板载 **KEY1（Y9）** 与 J5-29 都能翻页，KEY0 保留其复位语义。
⑭**P5 六状态表 + 驻留统计（⑪）**：新增 `disp/p5_view.v`，按 U/V/W 三位的 6 个有效组合统计**时间占比**（每拍看一次 `q_io_state[4:2]`，窗口 64 帧 = 1.09 s），每帧消隐期用一次 `fixed_div`（40 拍）算出千分比，再用双 dabble 转 BCD 写进**文字层**的空列 —— 这一页的表格行高只有 30 px，只能用 16 px 字符格（`P5_VAL` 是空表，纯文字层页）。条形图列（屏上 x = 400..899）由 `disp/disp_engine.v` 按同样 32 px 行距画，像素通路只做一次比较。两个退化状态 `BAD 000` / `111 PCT` 单列在底栏（㉓ 起前者改称 `故障 000`，见 §4.15）。**排错过程见协作记录 28/29/30**：`val_ch_raw` 的 P5 档声明了却没接驱动源（z -> X，整页像素全是 `XXXXXX`）、测试台自己把在跑的那轮渲染的 `start` 脉冲丢掉、以及顶层那块 `p5_view` 因为测试台不跑真光栅而从未启动。
⑮**P7 标定与误差可视化（⑫）**：新增 `disp/p7_view.v` 与 `disp/p7_ram.v`（128×16 双口，例化 3 次），把**编码器自己已经在算的** `stat_amp_sq`（s²+c²，`0x0530`）按电角度分 128 箱统计 min/max，每箱在屏上画成一条 4 px 宽的竖带 —— 标定正确时 s²+c² 与电角度无关（带子窄），有残余误差时随角度起伏（带子宽）。「标定前/后」两条曲线用 `calib_busy` 的**上升沿/下降沿**在屏侧分成两个 bank，不新增编码器存储、不占遥测带宽、也不新增 `caldone` 位。分箱累积放在**寄存器**里、只在换箱那一拍写回 RAM（电角度每拍走 503 计数、箱宽 512，几乎每拍换箱；读-改-写跟不上采样率）。右栏是六个标定参数的实时值。为把参数与幅值引到屏上，`disp_tap` **由 183 位加宽到 311 位**（`rtl/enc_top.v` + `disp/enc_disp_tap.v` + `rtl/SPEC_interface_contract.md` §2.2），`rtl/reg_file.v` 一行未改、`0x0540+` 记录区没有出现。**排错过程见协作记录 31/32**：dump 相少算两拍流水导致整条曲线右移一箱（而箱箱相同的测试数据看不出来），以及测试台在 `@(posedge clk)` 之后立刻读层次信号读到的是跳变前的旧值。
⑯**内容网格右移 64 px，导航栏上不再有内容**（U-20 本轮）：根因是 RTL 的三列网格比 spec §4.1/§4.3 的规定**左移了 64 px** —— 卡片原点 `32/352/672`（spec 写的是 `92/404/716`），于是 P1 的六张卡片压住导航栏右半（`bg_sel` 里 `in_card` 优先于 `in_nav`，所以卡片的底色盖掉了导航），而 `disp/val_format.v` 的字段 0（`f_col=2, f_wid=10` = 320 px）**根本塞不进 288 px 宽的卡片**（右端伸到 x=384，越过卡片右沿 x=319 整整 64 px）。现统一改成 **`96/416/736`**（96 = 导航栏 80 + 16 px 内边距）：`disp/disp_engine.v` 的 `CARD_X0/X1/X2`、`disp/hit_test.v` 的同名参数、`disp/val_format.v` / `disp/p6_view.v` / `disp/touch_view.v` 的 `f_col`（2/12/22 → 3/13/23，字段 0 宽度 10 → 9）、`disp/band_view.v` 的写入列（6/13/22 → 11/18/27）、`disp/p5_view.v` 的百分比列（15/29 → 18/32）与 `tools/gen_text_ram.py` 的 `P1/P5/P6/P8` 四个版面表（lab 列 4/24/44 → 6/26/46，val 列 2/12/22 → 3/13/23）一起改。`NAV_W` 仍是 80 px（spec §4.1 要求导航项 ≥48 px 触控宽度，不能缩）；改完 P1 上导航的有效触控宽度从 32 px 恢复到完整的 80 px。**这不是「看着不舒服」**：真光栅里 `1500.00` 的笔画一直画到 x≈412，越过了卡片右沿。**排错过程见协作记录 35/36**：测试台把「卡片中间一点」写成魔数 `(400,400)`，网格一移就 FAIL 且把人引去查命中判定；以及预览件照 spec 手抄几何、还给 P6/P8 画了 3×3 卡片墙，与 RTL 长期不一致。
⑰**上板缺陷修复：P2/P3/P4 补文字层、P5 六行错位一格、P1 三条陈旧脚注、P2 左半平线**（U-21 本轮）：上一版烧进板子后，从八张实机照片上读出四处。**A** P2/P3/P4 整页没有文字（没有页名、没有导航标签、P4 六条道没有信号名）—— 根因是 `disp/disp_engine.v` 的 `txt_page` 当初把 page 1/2/3 排除在文字层之外；现给这三页各补一块静态 lab 平面，`lab_ch_raw`/`val_ch_raw` 各加三档（val 档显式写 0，否则 P1 的六个大数字会叠上来），新增 7 个汉字（采样李萨如逻辑）⇒ 字库 44 ASCII + 83 汉字 = 127 码（上限 128，再加字必须升到 8 bit；**㉓ 正是这么做的**：lab 码升 8 bit、字库 47 ASCII + 89 汉字 = 136 码）。**B** P5 六行整体错位一格：`snap[k]` 是 uvw 码 k 的采样数，六行标签写的是码 1..6，旧代码却接 `snap[0..5]`，底栏 `BAD 000` 又用「总数减其余七项」把 `snap[0]` 算了两遍 —— 实机上「第一行 U1 V0 W0」与 `BAD 000` 同时显示 99.9（占比合计超过 100）；现改成六行 ← `snap[1..6]`、BAD ← `snap[0]`、111 ← `snap[7]`。**D** P1 三条静态脚注与实时值打架（`倍频64 分频1` vs 实时 `X256 /1`、`电气频率 1600 HZ` vs 实时 996.18 Hz、`A1 B1 Z0` vs 实时 `A1 B0 Z0`）：全删，`边沿率 4X64XF` 的 64 换成「倍频」。**F** P2 波形左半段是平线：`wave_trace` 的列扫描每个 clk 都推进，而样本只在 `de` 时更新，垂直消隐的 47,040 拍（367 列）写的是同一个冻结样本；现给 `wave_trace` 加 `de` 输入、扫描只在可见期间推进。**排错过程见协作记录 38/39**：一个与直接探针冲突的坏诊断差点让我去改一条正确的通路；以及我自己新写的测试里有一个 off-by-one（寄存的观察者晚一拍）伪装成了 DUT 的缺陷。
⑱**P4 时序图加宽到 944 px + P2 右下四枚徽标（Vpp / f / Δt / ΔV）**（U-22 本轮）：把 `U-21.7` 结尾列的「仍未做」两条做掉。**P4** 加宽**不能加箱数** —— 写口一个 clk 只写一箱、电角度每拍前进约 503 个计数，一个电气周期只够写 ~130 箱，128 箱已是采集侧上限；所以改成**读口摊箱**（轨迹区 856 px ÷ 128 箱 = 每箱 6.6875 px，箱号 = `(dx × 153) >> 10`，`153 = 128+16+8+1` 只用移位相加），`lg_edge` 也从“箱内第 0 px”改成“电平变化只落 1 px”、与箱宽解耦。内容区 x 80..1023 = 标签栏 88 px（80..167）+ 轨迹区 856 px（168..1023）；六个通道字母挪到格列 8（x 128）、`电角度` 挪到格列 6。**P2** 四枚徽标由新增的 `disp/p2_badge.v` 在显示侧自己测（量**遥测原始样本** `tap_s_n`/`tap_c_n`，不是打过 `de` 门的 `q_s_n/q_c_n` —— 后者在垂直消隐期冻结近 940 µs，会把时基糊掉），四枚统一 “dddd.d” 六格（`S = 值 ×10`，除法走 `fixed_div`、十进制走 double-dabble），每帧约 280 拍（消隐有 47,040 拍）；过零时刻取**采样区间中点** `tmid = t - (dup >> 1)`，把 100 µs 采样栅格的量化误差变成零均值 ±50 µs 抖动（取新样本那一拍会系统性偏 +50 µs）。版面按 **10 格节距**排在格列 28/38/48/58（标签在行 35 静态、数值在行 36 由 `p2_badge` 每帧覆写），最右一枚贴内容区右沿 x 1023。**资源代价如实记**：本版 LUT 10,242 → **10,851**、FF **+531**、**DSP 16 → 19**（`p2_badge` 的常数乘法 `× 1000`、`× 500_000_000` 被工具映射进 DSP48；摊箱换算本身没有 `*`）、BRAM ±0、IOB ±0。**三个真 bug 都是被判据逼出来的**：①`{BADGE_ROW, (f_col(fld) + {9'd0, p})}` 里内层是 12 位、拼接结果是 18 位，赋给 12 位 `waddr` 时丢掉高 6 位 ⇒ 四枚数值全写到第 **0** 行；②`p2_badge` 的统计窗口是“两次 `start` 之间”、且 min/max 不被 `chg` 门控 ⇒ 用例之间有残影（测试台加 `flush_case()` 空转一帧冲掉）；③同一类截断在测试台又犯一次（`wcol < F3 + 6'd6`，58 + 6 = 64 在 6 位里回卷成 0）。**排错过程见协作记录 40/41。**
⑲**P6 设置页 3x4（12 项）+ 底部危险区二次确认 + 状态栏三入口**（U-23 本轮）：把 spec §4.4 / §4.6 / §6.4 里明文的缺口补掉第一批。**P6** 从 3 列 x 3 行扩到 **3 列 x 4 行**：新增 **ABZ使能 / UVW使能 / 粗调移位** 三项，值全部取自 `disp_tap` 上**早就存在**的位（`[122]` / `[123]` / `[266:263]`，见 `rtl/SPEC_interface_contract.md` 的 311 bit 表）⇒ `rtl/` 一行未改、不新增遥测带宽；标题写成 ASCII `ABZ` / `UVW` / `SHIFT`（值 `ON` / `OFF` / `S<ss>C<cc>`），因为字库是 **44 ASCII + 83 汉字 = 127 码**、lab 层码宽只有 7 bit、只剩 1 个空位（加六个汉字要动 `disp/text_ram.v` 的 RAM 宽度与 `disp_engine.v` 的 `lab_ch_*`，本轮不做，记在 U-23.7）。**底部危险区**（x 80..1023、y 520..599；**㉝ 已改成 y 504..599 = 96 px**）画红框 + 警示三角 + `清除锁存故障` 按钮；按钮**不直接写寄存器**，先弹模态（整屏遮罩 `5A6B7A` + 红框对话框 + 标题 + `REG 0X0405` + `CANCEL` / `OK`），确认后才写 **0x0405 bit0 = 1**（W1C 清锁存）。模态**压过 `compose` 里所有层**（连触点半字准星都被遮住），模态期间策略层吞掉翻页与卡片动作 —— 被挡住的下层控件一个都不许响应，否则“二次确认”不算数。**写通道**：`disp/ui_edit.v` 参数化出 `CMD_B0` / `CMD_B1` / `VERIFY`（原来 0x0101 是 `localparam` 硬编码），再例化第二个实例（`.CMD_B0(8'h80|8'h08|8'h04)`、`.CMD_B1(8'h05)`、`.inter_enc(10'd1)`、**`.VERIFY(0)`**）：0x0405 是 W1C —— 写 1 清、清成功后回读是 0 ≠ 目标 1，原路的“逐位相等”判据必然失败并走进回滚分支，把 `{old_inter,old_div}` 又写回 `0x0101/0x0102`（顺手改掉倍频/分频）；而且 0x0405 根本不在 `disp_tap` 的 311 位上。两路写共用层内那一根 `uart_tx`/`ui_busy`，加了 mux 仲裁（W1C 优先）。**状态栏三入口**：右端 `[信号●]`（x 768）/ `[告警▲]`（832）/ `[系统⚙]`（896）都画几何图标（字库没有 信/号/告/警/系/统）；按 spec §4.1 **只有 ⚙ 是入口** ⇒ `hit_test` 的 `HIT_SYS = 5'd7` 命中后 `page <= 3'd7`（P8 的 spec 入口，此前只能靠短按 KEY1 连翻七次），`[信号]` / `[告警]` 是纯指示器、**故意不给命中编号**（分别跟触摸链路六态灯色与 `alert_col`）；⚙ 的命中区在 y 上伸到 47（状态条本体只有 24 px，单靠它撑不到 spec §6.1 的 40 px 最小触控目标）；活性灯从 `cx > 904` 挪到 `cx >= 960`（原区域与新 ⚙ 档位 864..927 重叠，而灯在 `compose` 里优先级高于文字）。**一处真陷阱**：危险区按钮的矩形（x 192..640、y 528..592）与 P1 两张 row1 卡片（col0 96..384、col1 416..704）**大面积重叠**，而 `hit_test` 刻意不认识页号 ⇒ 塞进它的矩形表无论排在卡片之前还是之后都是错的（抢 P1 卡片 / 被卡片抢走，只剩卡片之间那 32 px 的缝能点中）；改成**策略层按原始坐标 + `page == 5` 判**（`hit_x` / `hit_y` 本来就在端口上），并在 `disp/tb_hit_test.v` 加两条反向判据把这个几何事实钉住。**量具两次翻车**（都在 `disp/tb_disp_engine.v`，两次都是“量具坏了、被测件没坏”）：先用“task + `wait(de_o && ...)` / `while`”数文字像素，在**一定存在**的 P1 导航文字上都数到 0；改用 `scan_ph` 相位 + `wait (frame_done)` 划窗口，实测两次 wait 之间只隔 1 个时钟、相位窗口根本落不到整帧上 —— 最终改成**自由运行 always 每拍累加 + 用 tb 自己掌握的 `dlg_tb` 状态门控 + 用 `n_frame` 变化判帧边界**；关闭态“对话框没露头”改判**像素**（遮罩与边框），因为对话框标题与寄存器号用的正是 P6 自己放标签/数值的格行 15/17/21。**排错过程见协作记录 43/44。**
⑳**P2/P3 页内 Tab + 标题带主操作按钮 + P7 入口修正**（U-24 本轮）：把 spec §4.1 / §4.2 / §4.6 里明文写了入口、屏上却没有的缺口补掉第二批。**① 页内 Tab**（spec §4.1 「左侧垂直导航栏（80 px）+ **页内 Tab**」）：显示侧画两个 200x40 页签（`y 96..136`，`SIM` = x 96..296、`XY` = x 300..500），P2 选中左边、P3 选中右边（选中 = 白底 + 强调色描边，未选中 = 导航色底 + 网格色描边）。标签用 ASCII `SIM` / `XY` —— `模` / `拟` 不在字库（44 ASCII + 83 汉字 = 127 码、lab 层码宽 7 bit、只剩 1 个空位，同 ⑲ 的结论）。**命中刻意不进 `hit_test`**：这两个矩形完全压在 P1 卡片 01/02 上，而命中层不认识页号 ⇒ 与 ⑲ 的危险区同一条纪律，由策略层按 `hit_x` + `page ∈ {1,2}` 判。**② 标题带主操作按钮**（spec §4.2 骨架里的 `[主操作按钮 高40 宽160]`）：画在 x 660..820 / y 28..60，**命中矩形上下各外扩 4 px 到 y 24..64**以凑满 spec §6.1 的 40 px 最小触控目标；同一个矩形在 P1 上是「标定」→ P7、在 P4 上是 `EXPAND` → P5，**几何与命中编号（`HIT_TITLE_BTN = 5'd15`）跨页共用**，文字来自各页 lab 平面、策略层按 `page` 分派。**这条同时修掉了 P7 入口的语义错位**：spec §4.6 写「点卡片 3 → P7」，但 §4.5 把卡片 3 钉成「**转速**」（`P1_LAB` 的 `(5,46)` / `(13,46)` 就是 `转速` / `RPM`）—— 旧路由 `HIT_CARD_CAL = 5'd10 → P7` 于是成了点转速跳标定，本轮删掉策略层对它的消费（10 号编号保留：它同时是 P1 卡片列的几何契约，`disp/tb_hit_test.v` 钉着它）。**③ P5 的下钻入口**：spec §4.6 要「P4 → 点表格标题「展开」→ P5」，`展` / `开` 也不在字库 ⇒ 用标题带按钮 `EXPAND` 代替，**字面位置有意偏离 spec**（记在 U-24.7）；左侧导航「状态」→ P5 的旧入口保留（双路径）。**④ 反向判据**：按钮只在 P1/P4 画（`tb_page`）、Tab 只在 P2/P3 画（`tab_page`），测试台两个方向都钉（P2 上按钮位置必须是底色、P4 上页签位置必须是底色），将来若给别的页加标题带按钮，漏写 `page` 守卫会立刻被照出来。**⑤ 又一个位宽不认人**：把测试台超时从 `#1_200_000_000` 抬到 `#2_400_000_000` 时字面量**溢出成负数**，xsim 报 `[XSIM 43-3368] Negative delay … treated as 0` 并**立刻超时**（8 秒就跑完整场仿真、日志里只剩超时一行，看着像编译失败）⇒ 改成 `#1_900_000_000`。**排错过程见协作记录 45。**
㉑**P4 45° 刻度 + P5 表格与占比刻度 + P7 幅值改百分比**（U-25 本轮）：批次③「标注精修」，把三处「图上有数据、却没有标注/刻度」的地方补成 spec 要的样子（§4.4 P5 表格 / §7.1 P4 按电角度标注 / §7.3 P7 幅值百分比）。**① P4 时间轴刻度改成每 45° 一根**：旧判据 `lg_tx[6:0] == 7'd0` 是每 128 px（≈53.8°），标不出整度；改成 `p4_tx == 0/107/214/321/428/535/642/749` —— 轨迹区 856 px = **8 × 107**，正好 0°/45°/…/315°（x = 168 + 107k）。**用 8 个常量比较而不是 12 位除法**：`p4_tick` 在像素路径上，除法器要占 DSP 且引入流水延迟。文字层 `P4_LAB` 行 29 补 8 个整度数字（格列 10/16/23/29/36/42/49/56），行 27 补 `128点等效采样`（§7.1 要求图上注明口径；「按」/「箱」不在字库 ⇒ 写「点」；**㉞ 已按规范字面改成「按电角度重建128箱等效采样」**）。**RTL 的 107k 与文字层的格列是同一个契约的两处**。**② P5 从「六行数字」补成「六行表格 + 占比刻度」**：新增 `p5_frame`（外框 x 398/901、y 126/305）、`p5_rowsep`（5 条行分隔线 y = 152/184/216/248/280，落在 32 px 行距之间的 16 px 空档）、`p5_grat`（25/50/75% 竖线 x = 525/650/775，满量程 500 px = permille/2 ⇒ 0% 在 400、100% 在 900），文字层行 21 补 `0`/`50`/`100`（没有 `%` 字符，单位借表头 `PCT`）。刻度线用 **`C_SEC`（8FC4EC）而不是 `C_GRID`（D6E3F0）** —— 空槽底色 `C_TRACK = DCE9F5` 与 `C_GRID` 几乎同色，真屏上等于没画；填充条在 `with_bar` 一级（覆盖网格）⇒「填充压过刻度」也被测试台钉住。**③ 框底取 305 不取 321**：`preview_pages.py` 出来的图上才发现，框底 321 那条横线正好从文字层第 20 行的「111 PCT」（x 384..495）上穿过去 —— 文字层与绘制层是两套各写各的几何，只有叠起来看才发现 ⇒ `P5_FRAME_Y1 = P5_BAR_Y1 - 15 = 305`，框只包「六行表」、两个退化状态落成框外脚注。**④ P7 幅值改百分比**：口径必须与编码器同源 ⇒ 取 `0x0520`（下限，默认 (0.60)²）与 `0x0524`（上限，默认 (1.20)²）当分母（0.0% = 下限、100.0% = 上限、负值 = 已越下限），**屏侧不另写额定值当分母**；换算 `|mag-lo| × 1000 / (hi-lo)`（一次 `fixed_div`，一帧一次），显示 `sddd.d`（`pct_val` 是「值 ×10」的十分位定点），`hi <= lo` 时夹到 9999（屏上出现 `999.9` 而不是 X）。**⑤ 抽头 311 → 375 位**（本轮唯一动 `rtl/` 的地方）：`disp_tap` 端口 `[310:0] → [374:0]`，最高位前插 `cfg_amp_high_sq`（`[374:343]`）与 `cfg_amp_low_sq`（`[342:311]`）—— 两个字段都是 `rtl/enc_top.v:473` 早有的 wire、`rtl/reg_file.v:588-589` 的寄存器直出，**没有新增寄存器、没有改 `rtl/reg_file.v`、`[310:0]` 一位未动**（与 ⑬ 134→183、⑮ 183→311 同一套纪律）。**⑥ 量具**：`tb_pipe_align.v` 新增 ③b 段（455 行扫出 **8 根**、首根 168、末根 917，280..380 区间 **0 根** —— 旧实现会在这里留一根 x=296）；`tb_p5_page.v` 新增 12 条像素判据；`tb_p7_page.v` 新增 3b 节四例（`0.0` / `100.0` / `- 31.8` / 反置门限时 `999.9`）；六个测试台的 `disp_engine` 例化补齐两个新端口（**漏接不报错、只会让那一路变 X**）。**⑦ 又一次「量具坏了、被测件没坏」**：3b 节第一版把 318 的百/十/个位写反，xsim 报 4 条 `[FAIL] lab cell (28,12) = 0 want 11` 之类 —— 实际值恰好是设计意图 `- 31.8`。**偏离如实记在 U-25.7**：spec §4.4 的「5 列 / 行高 30 / 列宽 188」与 16 px 文字格网不可通约（188/16 = 11.75、30/16 = 1.875）⇒ 本版维持 3 个逻辑列 + 32 px 行距；「汉字状态名」受字库限制（127 码已满）本轮仍做不了。**排错过程见协作记录 46。**
㉒**触摸长按/拖拽/滑动 + 倍频编辑面板 + 回到上一次值**（U-26 本轮）：批次④「交互能力」，把 P1 卡片 2 的「点一下就改」扩成 spec §6.3 / §6.5 的编辑面板，并给命中层补上手势生命周期。**① 命中层加状态**（`disp/hit_test.v` v22）：新增 `held`（电平）/ `rel_stb`（单拍）/ `cur_x` / `cur_y`（按住期间最新合法坐标，垃圾坐标不采），**`hit_stb` / `hit_id` / `hit_x` / `hit_y` 语义一位未动**；手势时间分辨率 = 触摸 IC 约 100 Hz 的采样。**② 新模块 `disp/ui_panel.v`**：面板只占下半屏（`y 320..592`，spec §4.5 要求上半屏波形继续刷新），控件按 §6.1 尺寸 —— 两个 64×64 步进按钮（`[−]` / `[+]` 的符号**改用图形画**：16 px 字格的格心放不进 64 px 按钮的正中，差 8 px）、8 档离散滑条（64 px 一档，吸附用移位而不是除法）、三个 160×48 命令按钮。**③ 长按与拖拽**（§6.3 / §6.5）：按住步进按钮 0.6 s 起手走一档、之后每 0.2 s 一档，按住期间在按钮内画沿周长的矩形进度环；滑条按住拖动即吸附；**点按永远是入口**（§6.5：长按不得作为唯一入口）。**④ 主动「回到上一次值」**（§6.5）：`回到` 不是假记忆 —— 它把**上一次被回读确认过的值**再走一遍 `ui_edit` 的两阶段提交（写 → 回读 → 比较 → 不一致回滚），所以 BACK 也会失败、也会更新记忆（两次 BACK 互换）；没写过值时按钮压暗（`C8D2DE` / `EDF1F6`），按下不发任何字节。**⑤ CANCEL / APPLY**：CANCEL 一个字节都不发；APPLY 在「待应用 == 回读」时直接收起，否则发请求并把 `tap_div` 原样带上（本轮只改倍频、不动分频，记偏离）；事务收尾靠 `ui_state` —— 见到 `BUSY` 再离开 `BUSY` 才算一次真提交，`ST_OK` 才更新「上一次值」。**⑥ 同一字段两态**（spec §6.2 / `docs/13:267`）：`disp/val_format.v` 加 `pnl_on` / `pnl_inter` —— 面板开着时字段 1 显示**待应用值**、面板一关立刻回**回读值**；`pnl_on` 默认 0 ⇒ 老路径一位不变。**⑦ 文字层**：`P1_LAB` 只借格行 21（面板标题）与格行 34（三个按钮标签），5 条标签全部用既有字形 ⇒ 127 码位没动、`p1_lab_ram` 93 → 98 格。**⑧ 只有把像素画出来才发现的两处缺陷**：步进按钮**根本没有符号**；长按进度环画在按钮 1 px 外框上、被同色的按下态描边完全盖住 ⇒ 改成**内环**（62×62、周长 244 px、每级 4 px）。**⑨ 量具**：新台子 `disp/tb_ui_panel.v`（9 节，回归 17 → **18**）、`tb_hit_test.v` 第 9 节、`tb_val_format.v` 第 4 轮、`tb_disp_engine.v` 第 [9] 段；三处「看起来 PASS 其实没测到」—— `page` 极性写反（面板根本没开，但复位值恰好等于期望值 ⇒ 断言必须先用一条证明状态是活的）、按钮底色采样点落在标签字形上（y=552 → y=535）、反向判据不许钉页面自己的底色。**偏离如实记在 U-26.7**：数字键盘兜底没做、分频不动、进度是矩形环而不是真圆环。**排错过程见协作记录 47。**
㉓**字库扩容：lab 码 7→8 bit + 三个符号与 8 个新汉字**（U-27 本轮）：批次③ 归档时留下的三处「受字库限制做不了」（P5 汉字状态名、百分比号、§6.5 的「↩ 回到 ×8」）都卡在同一个瓶颈上 —— lab 平面字符码只有 7 bit、44 ASCII + 83 汉字 = 127 码、**只剩 1 码**。本轮先把容量解掉：`tools/gen_font_rom.py` 的 `PLANES` 里 lab 项 `idx_w` 由 **7 → 8**（上限 128 → 256），`ASCII_CHARS` 末尾追加 `%` `×` `÷` 三块手写 5x7 点阵（索引 **44/45/46**，**追加而不是插队**：0-9 与 A-Z 的索引被 `disp/val_format.v` / `disp/p2_badge.v` / `disp/p5_view.v` 的 `CH_ZERO = 6'd8` 一类常量写死），`tools/make_cn_glyphs.py` 的 `CN_ORDER` 末尾加 `正常警示故障回到` ⇒ 生成器重跑出 `disp/font_rom.v`（**47 ASCII + 89 cjk = 136 codes**、125,056 bit = 15.27 KB = 3.39 RAMB36）与 `disp/text_ram.v`（lab 8 bit / val 6 bit）。屏上立刻多出四处：P5 底栏 `故障 000 PCT`（原 ASCII `BAD`）、P5 刻度 `0%` / `50%` / `100%`、P7 `幅值` 行尾 `%`、P1 卡片 2 主值 `×64 ÷1`（`disp/val_format.v` 新增 `CH_PCT` / `CH_MUL` / `CH_DIV`，字段 1 的 `cbuf[0]` / `cbuf[5]` 从 `CH_X` / `CH_SLASH` 换成 `CH_MUL` / `CH_DIV`，对齐 spec §4.5）；面板按钮 `BACK` → `回到`。加宽只动**字符码线**（`disp/disp_engine.v` 的 `lab_ch_p1..p8` / `lab_ch_raw`、`disp/band_view.v` / `p2_badge.v` / `p5_view.v` / `p7_view.v` 的 `wdata` 与 `CH_*`；**`disp/p7_view.v` 的箱号 `bin` 仍是 7 位**）⇒ **`rtl/` 一行未改**。**顺带在预览图上发现并修掉 U-26 留下的真缺陷**：`disp/disp_engine.v` 的 `glyph_page` 只排除 P6 对话框的格位，于是面板关着时 P1 的格行 21/34（面板标题与三个按钮）照样被页面层画在卡片上 —— 而 `disp/tb_disp_engine.v` 第 [9] 段那条「面板收起后文字消失」的断言**统计本身被 `pnl_on_tb` 门控着**、是同义反复，整段看不见。修法三处：`glyph_page` 追加 `& ~(lab_bit & (page == 3'd0) & ((lrow2 == 6'd21) || (lrow2 == 6'd34)))`、测试台改成**无条件统计**（正反两侧分别判 `>0` / `==0`）、`tools/preview_pages.py` 在 P1 上把这两行抹掉。**量具**：全量回归 **19 / 19**、`tools/lint_all.ps1` **ERROR 0 / WARNING 0**、`tb_disp_engine` 单独复跑 159 s 0 errors、`preview_pages.py` 八图重出（P5 的 `故障 000 PCT` 与三个百分比、P7 的 `%`、P1 的 `×64 ÷1` 都在图上核对过）。**排错过程见协作记录 49**（一条"永远为真"的断言 + 一份抄了两遍的字符表）。
㉔**面板「↩ 回到 ×N」+ 全局 `×`/`÷` 一致**（U-28 本轮）：把 U-27.7 里"字库已经够、只是没做"的两条收口。**① 面板按钮上的动态记忆值**（spec §6.5，`docs/13_display_ui_requirements.md:289-290`）：新增 `disp/undo_lab.v` —— 「上一次值」`pnl_undo_inter`（10 bit，`disp/ui_panel.v:127`，事务成功时 `:392` 更新，**编码 `0` 当 ×256**）经 double-dabble 转三位十进制，每帧（`disp/disp_engine.v:490 vf_start = last_px_d`）用 7 拍写进 **P1 lab 平面那块自 v22 起一直写死 `.we(1'b0)` 的写口**（p2/p5/p7/p8 的 lab 分别被 `p2_badge`/`p5_view`/`p7_view`/`band_view` 占着，只有 P1 是空的 ⇒ 不用仲裁、不动取字时序）；格位 `(34,46..52)` = `↩`/`回`/`到`/`×`/百/十/个，数字**左紧贴** `×`、前导零不写，`avail=0` 时只写「回到」（与静态版面 `disp/text_ram.v:2222-2223` 同格，首帧不跳位）。**只显示倍频、不显示分频** —— 面板从头到尾都不改分频（`disp/ui_panel.v:316 req_div_code <= tap_div;`）。**② `×`/`÷` 全局一致**：`disp/p6_view.v:98` 的 `CH_X = 6'd41` / `CH_SLASH = 6'd4` 换成 `CH_MUL = 6'd45` / `CH_DIV = 6'd46`（`:246 pfx_ch`），P1 脚注 `边沿率 4X倍频XF` → `4×倍频×F`；字库补 `↩`（`tools/gen_font_rom.py` 的 `ASCII_CHARS` 末尾追加，索引 47 ⇒ **48 ASCII + 89 汉字 = 137 码**，`tools/gen_text_ram.py` 的第二份同步）；`disp/val_format.v` 删掉 v23 起没人引用的 `CH_SLASH` / `CH_X`。**③ 量具**：新增 `disp/tb_undo_lab.v`（`0→×256`、8、64、128、前导零抑制、`avail=0`、7 拍写序与 `done`/`busy`）、`disp/tb_disp_engine.v` 第 [10] 段（三例逐格字符码 + 墨量判据 ×256 = 457 px > ×8 = 341 px > 无记忆 = 193 px）、`disp/tb_font_rom.v`（137 字形）、`disp/tb_band_view.v`（`aa()` 参数 7 → 8 位：此前接 `回`(135) 被截成 7、汉字标签全印成空格）、`disp/tb_p6_view.v`（前缀期望串只能用单字节替身 `*` / `d`）；全量回归 **20 / 20 PASS**、`lint_all.ps1` **0/0**、smoke `[xsim] exit 0`。**④ 预览工具补了一张"面板开着"的图**（`_disp_work/page_p1_panel.png`）—— v23 为了"面板标签不像常显"把静态层那两行抹掉，于是模态内容在预览里根本不存在；新图要按**格矩形判交**清掉压在面板下的页面文字，并模拟 `undo_lab` 的 7 格。**排错过程见协作记录 50**（一块闲置的写口 + 一张看不见模态的预览图）。
㉕**长按进度环改真圆环**（U-29 本轮）：spec §6.5 要"长按配**环形**进度反馈"，U-26 当时如实记了偏离 —— 用的是**沿按钮周长的矩形环**，理由是"真圆环要上乘法器/CORDIC，为 0.6 s 的进度条不值当"（`DEV_STATUS.md` 的 U-26.3）。用户裁决"下一轮改成真圆环"，本轮把它改掉，而且**不加乘法器、不加 DSP、不给像素流水线加级**。**① 把"圆"钉成整数表**：新生成器 `tools/gen_ring_lut.py` 出 `disp/ring_lut.v` —— 环带 **26..30 px**（4 px 厚）、**64 扇区 × 5.625°**、12 点方向起顺时针；像素判据用"格中心 + 半格"的 4 倍缩放整数坐标（`4*i+2` ⇒ 半径比较是整数 `104² ≤ r² < 120²`）；几何关于 `x = 31.5` / `y = 31.5` 对称 ⇒ 只存 **32×32 折叠表**（`fold(i) = i[5] ? i[4:0] : (i[4:0] ^ 5'h1F)`，1024 项 × 5 bit = **5,120 bit ≈ 0.62 KB**，Vivado 推 1 个 RAMB18），扇区号由"象限 + 象限内 `k`"装配（`k` / `31-k` / `32+k` / `63-k`，用 `px2[5]`/`py2[5]` 选）。**② 取数级**：与 `font_rom_lab/val` 同形（S1 组合给地址、S2 与 `px2/py2` 汇合收数据）—— 从 `cx/cy` 到 `lcd_rgb` 只有 1 级寄存器，若在 S2 才发地址会整链错位；旧的 `pnl_ring_x0/x1/y0/y1` / `pnl_ring_d` / `pnl_ring_edge` 全部删除。**③ 生成期自检**（不是"看着差不多"）：带内 **175 项**、环带像素 **700 = 175 × 4**（折叠处处 2:1）、64 扇区每个 **9..13 px** 无空洞、与"直接算 atan2"的比对只差 **6 处**（全在 45° 对角线 `ju == jv` 上、差 1 格 —— 扇区边界正压在对角线上，而折叠坐标的 `u/v = (2ju+1)/(2jv+1)` 是有理数、`tan` 只有 45° 取到理性值；肉眼不可见，且 RTL 用的就是这份表）。**④ 量具**：新台子 `disp/tb_ring_lut.v`（1024 项 valid 与几何一致 / 带内 `k` 随角度单调 30,625 对（交叉相乘、不引除法）/ 64 扇区覆盖完整 / 黄金值 `mem[26]=5'h1F`、`mem[832]=5'h10`、`mem[528]=5'h00`、`mem[660]=5'h18` / 带内 700 == 4 × 175，另出 64×64 扇形 ASCII 图）；`disp/tb_disp_engine.v` 第 [9] 段的采样点**必须重算** —— 旧点 (200,526) 在矩形环上、在真圆环外（r ≈ 33），不重算会以"颜色不对"假失败；改成四个方向 (192,468)/(220,496)/(192,524)/(164,496)（扇区 0/15/31/47）+ 环内 (200,480) 不画，共 10 条判据。全量回归 **21 / 21 PASS**、`lint_all.ps1` **0 / 0**、smoke `[xsim] exit 0`。**⑤ 预览件**：`tools/preview_pages.py` 新增 `_disp_work/page_p1_panel_ring.png`（按住 `[−]`、进度 32/64），并且环模型与 `disp/ring_lut.v` **逐像素对过表**（`_disp_work/_ring_xcheck.py`：700 带内像素、valid 0 处不一致、扇区 0 处不一致）⇒ 预览图是表的重放，不是"另画一个圆"。**⑥ 排错记在协作记录 51**：生成器 `initial` 一行四项是非法 Verilog、折叠表"重数"想当然（183 → 175×4）、`cover` 是 SystemVerilog 关键字被 xvlog 拒（改名 `cov`）。**U-26 的那条偏离记录已作废**（U-26.3 / U-26.6 / U-26.7 三处都加了批注）。
㉖**P5 严格照 spec 重排：30 px 行距 / 188 px 列宽**（U-30 本轮）：spec §4.4 的 P5 行原文是「6 行 × 5 列，行高 30、列宽 188，含占比条形图列」，而 U-25 的实现是 16 px 文字格网下的近似（6 行 × 32 px 半格、条形区 x 400..900）。本轮按 30 / 188 严格重排：在 `disp/disp_engine.v` 里给 P5 的表格区（x 82..1022、y 128..338）加一套**页号限定**的虚拟格网 —— 行带 `r = (y-128)/30`、列带 `c = (x-82)/188`、格内 `dx = (x-82)%188`，除法用**比较器 + 减法**（30/188 不是 2 的幂）、RAM 地址在表格内取 `{8+r, 11c + dx>>4}`、表格外回落原坐标，字形 ROM 的行输入换成行带内 y、取字相位从 16 px 移相器换成 `lab_bits[15 - dx[3:0]]`；**除 P5 外七页一个像素不动**。五列语义（spec 没写，本轮自定并记在 U-30.7）：序号 / 状态（`U1 V0 W0`）/ 次数 / 占比（`dd.d`）/ 条形图。连带：`disp/p5_view.v` 的条形尺度改成 `perm × 188 >> 10`（满程 184 px、`bar_t*` 收窄到 8 位；次数走 8 个 32 位计数器 + double-dabble）、`tools/gen_text_ram.py` 的 `P5_LAB` 重排成五列表头 + 六行数据、两个退化状态从底栏挪到表格下方（行 22）、`tools/preview_pages.py` 用**同一套虚拟格网**画 P5（否则预览图会挤在 16 px 行里，那又是一张骗人的图）。新判据 `disp/tb_p5_page.v`（外框 / 4 条列线 / 7 条行线 / 5 条刻度线 / 6 个行带的文字格 / 条形槽，实测 `[ OK ]` 53 条 0 失败）。**排错过程见协作记录 52。**
㉗**状态字模上屏：六卡迷你状态条 + ●/▲/✖ 字形**（U-31 本轮）：spec §4.3 的卡片模板要求 y+148 有一条「迷你状态条（高 24）：●正常 / ▲警示 / ✖故障」，§5.2 又把它列为**状态色的四重冗余**（字形 + 中文文字 + 反转视频 + 可关闭的 2 Hz 闪烁）。本轮补的是**卡片自己的状态词**（㉒ 那轮只做了状态栏上三个用几何画的全局图标）。**spec 的 y+148 不能照抄**：本工程卡片是 288×256（列 x 96/416/736、行 y 64/336），第二排的 y+148=484 正好压在 48 px 数值字形上，所以状态条落在「数值与次级信息之下、卡片框之内」的两条空格行 —— 第一排 RAM 行 **15**（屏 y 240..255）、第二排 RAM 行 **36**（屏 y 576..591；卡底框在 591，字形 y_off=1 不压框），每卡三列格 x **6 / 26 / 46**，四格 = 字形 + 空格 + 两个汉字。实现：① `tools/gen_font_rom.py` 的 ASCII 表末尾追加三个 5×7 手写字形 **●=48 / ▲=49 / ✖=50**（51 ASCII + 89 汉字 = 140 码，既有码号一个不动 ⇒ 其余七页一个像素不动）；② 新增 `disp/stat_chip.v`（约 210 行）—— 六卡各看**自己的**位判正常/警示/故障（卡 1 `io_flags[1]`/`io_flags[0]`、卡 2 `stat[3]`、卡 3 `io_flags[7]`/`stat[5]`、卡 4 `io_flags[6]`/`stat[0]`、卡 5 `stat[2]`、卡 6 `!io_flags[4] && !io_flags[5]` 与 `io_flags[3]`），每帧 24 格的写序列与 `undo_lab` **共用 P1 的 lab 写口**（面板优先、`hold` 停拍），另外给出 `chip_st[11:0]` 供探针读；③ `tools/gen_text_ram.py` 的 `P1_LAB` 在同样格位写一份「● 正常」静态兜底（**有意的冗余**，也让「没写进去」在画面上看不出来 ⇒ 端到端判据必须改遥测 + 读 RAM，只看预览图会被骗）。新判据两处：单元测试 `disp/tb_stat_chip.v`（15 个用例：判据放在**写口**上 —— 每次写的地址与字符码、`seen[6][4]` 防「某格根本没写」、`hold` 期间写口冲突、换卡灵敏度守卫）与 `disp/tb_disp_engine.v` 的 **[11] 段**（三轮遥测 + 探针台账 + RAM 字符码 + 墨量差分）。**排错过程见协作记录 53** —— 本轮主坑是「连续赋值的灵敏度表只由实参决定」（函数体里读模块级 `cst` ⇒ 每张卡的字形格停在上一张卡的状态）与「寄存写口 + 优先权 mux 每帧静默丢一笔」（两者都靠单元测试先红才定位）。**仍未做**：§5.2 的后两重冗余（反转视频 / 2 Hz 闪烁）与把状态条推广到别的卡片（spec 的模板只覆盖 P1 六卡）。

㉘**状态字模第三重：六卡状态条反转视频（白字 + 状态色底）**（U-32 本轮）：spec §5.2 把状态色写成**四重冗余** —— 字形 + 中文文字 + **反转视频（白字反色块）** + 可关闭的 2 Hz 闪烁。㉗ 落了前两重，本轮补第三重：某张卡的状态只要不是「正常」，就把它的迷你状态条那 4 个格（**64 × 16 px**）整块反转成「状态色底 + 白字」。RTL 只动**一层 mux**（新增段 5.13，`disp/disp_engine.v:1738-1774`）：六个矩形 `scbar_c0..c5`（格行 `lrow2` = 15/36、格列 `lcol2` = 6..9 / 26..29 / 46..49，与 `disp/stat_chip.v` 的 `ROW_TOP` / `ROW_BOT` / `COL_0..2` **逐格同源**）、`scbar_sel` 从 `sc_chip_st` 取出该卡 2 bit、`scbar_inv = scbar_any && (scbar_sel != 0)`、`scbar_bg = (scbar_sel == 2) ? C_FAULT : C_WARN`，最后 `with_txt = scbar_inv ? (glyph_page ? C_CARD : scbar_bg) : (glyph_page ? txt_col : with_dz)`。**白字条件刻意用 `glyph_page`**（与文字层实际取位同源）⇒ 反转态的白字与正常态的黑字**逐像素同位置**，判据才能从「黑字归零」推出「字变白了」。新判据两处：`disp/tb_disp_engine.v` 的 [11] 段扩成**三条互相独立**的对照 —— `C_TEXT` 墨量（正常 273 px > 0、警示 **0 px**）+ 块色墨量（正常 **0 px**、警示 **762 px**，而一个反转块是 1024 px，`1024 − 762 = 262` px 正是白字墨量，与 273 px 同量级）+ 六条 `expect_px`（取样点钉在每卡**空格那一格**的中心 `格列*16+8`，与字模改动解耦）；`tools/preview_pages.py` 新增 `invert_chip_bands()`（语义与那条 mux 逐字对应）与第 **11** 张图 `_disp_work/page_p1_chip.png`（演示状态：卡 5 警示 / 卡 6 故障），主图 `page_p1.png` 仍是无色块的正常态。**排错过程见协作记录 54** —— 本轮两个坑是「像素断言忘了问模态可见性」（面板矩形 `PNL_Y0..Y1 = 320..591` 把整排第二排卡片盖住 ⇒ 轮 C 的 (760,584) 取到的是页面底色 `eaf3fb`）与「信号一反转，原来的差值判据就失去意义」（正常/警示的墨量差分改写成两条能自洽的绝对谓词）。**仍未做**：spec §5.2 的第四重「可关闭的 2 Hz 闪烁」（要动帧计数→像素的路径 + 一个可关闭的配置位与 UI 入口）。

㉙**状态字模第四重：可关闭的 2 Hz 闪烁 + P6 标题带开关**（U-33 本轮）：spec §5.2 的四重冗余到此收官 —— 字形 + 中文文字 + 反转视频 + **可关闭的 2 Hz 闪烁**。本轮补第四重：状态条一旦处于警示/故障（就是已经反色的那几张卡），就以 **1.9529 Hz** 在「反色块 + 白字」与「黑字常态」之间翻转。RTL 只多一段帧域相位（新增段 5.13，`disp/disp_engine.v`）：`blk_div` 数满 15 个帧首（`vf_start`）翻一次 `blk_ph`，半周期 = 15 × 17.0688 ms = 256.032 ms —— 14 帧会到 2.093 Hz（差 4.7%）、16 帧 1.830 Hz（差 8.5%），**15 是 58.59 Hz 帧率下最接近 2 Hz 的整数帧**（差 2.4%）；再与反转条件相与成 `scbar_blk = scbar_inv && (ui_blink_en ? blk_ph : 1'b1)`。**「可关闭」是一个显示侧偏好** `scr_blink`（`disp/enc_top_disp.v`，复位默认**开**，不进寄存器、`rtl/` 一行未改），入口是 **P6 标题带那颗「闪烁」按钮里的 16 × 16 复选框**：**实心 = 开、空心 = 关** —— 开关状态用几何表达而不是颜色，与 §5.2 那条「颜色绝不作为唯一的状态编码」是同一纪律。⚠ `ui_blink_en` 是新端口 ⇒ `disp/tb_disp_engine.v` 的例化必须补 `.ui_blink_en(t_blink)`（漏了该输入会悬空）。新判据：tb 的 [12] 段用 `expect_px` 钉住复选框的两个采样点（实心 / 空心）、强推 `blk_div`/`blk_ph` 验分频算术与「灭」相位的黑字、再用整帧墨量验「开且亮相 = 762 px 块色 / 开且灭相 = 0 px 块色 / 关 = 常亮」。**排错过程见协作记录 55** —— 本轮第一个坑是「**计数为 0 先怀疑门控**」：`[12]` 段照抄 `[11]` 段时漏了 `hold_page = 1'b1`，整帧被自动翻页带走，累加器一个像素都没数到。**仍未做**：数字键盘兜底（spec §6.3）、状态条只覆盖 P1 六卡、P8 走状态栏 ⚙ 入口（当前实现是触摸诊断页）、上板复检。

㉚**数字键盘兜底：12 键 + 三位七段 + spec §6.3 收官**（U-34 本轮）：spec §6.3 要求 `inter`（2…256）的编辑必须同时有「预设档位步进器 + 长按加速 + 离散滑条 + **数字键盘兜底**」，前三件在 U-22/U-26 已做，本轮补最后一件。面板里新增一颗 64×64 的「键盘」入口按钮（`KPB_X0/X1 = 856/920`、`KPB_Y0/Y1 = 392/456`），点进去整张面板换成 3 列 × 4 行键盘（键 44×44、步距 52 ⇒ 缝 8 px，符合 §6.1 的「最小 40 / 相邻 ≥8」）：`1 2 3 / 4 5 6 / 7 8 9 / ← 0 ↵`，右上是三位（48×80）输入窗，`[−]/[+]` 与滑条在这一层被关掉。数字用**图形**画（`glyph_pnl_sup` 把面板里的字库字形全抑制），所以先新增了 `disp/seg7.v` 这个 24 行的组合七段译码器；面板标题（lab 行 21）在键盘模式下被 `pnl_lab_cell` 的 `!pnl_kp_on` 项抑制，因为它正压在第 1 行键上。输入纪律三条：**超过 256 不接受该键**（不悄悄截断）、**首位 0 不接受**、**CANCEL 在键盘里只退一层**（先收键盘、面板还在）；而 `↵` 只把值放进「待应用」—— 写寄存器仍然必须按 APPLY，spec §6.2 的两阶段提交一个字没动。验证：新增 `disp/tb_seg7.v`（段掩码 + 亮像素总数两条独立判据）、`disp/tb_ui_panel.v` 第 9 节 33 条交互判据、`disp/tb_disp_engine.v` [13] 段像素判据；全量 **23 / 23 PASS**，`_disp_work/page_p1_kp.png` 与 RTL 同源。**排错过程见协作记录 56**（其中一条是「底排在图形之前 ⇒ 面板上只剩一片白」）。

㉛**P8 按 spec §4.4 重排为「系统信息 / 自检」：设备 ID / 固件版本 / 链路统计 / 资源占用**（U-35 本轮）：spec §4.4 把第 8 页定义成「系统信息 / 自检」，要求四类信息——**设备 ID、固件版本、链路统计、资源占用**（第五项「自检结果」留到下一轮），入口是状态栏的 ⚙（P8 的正式入口在 ⑲ 那轮已经打通）。本轮把这四项落到屏上，并且**字段的行列坐标一个都没动**：① 设备 ID = `ENCC1`（板卡型号 + C1 通道）、② 固件版本 = `V35`，两者在 `rtl/SPEC_interface_contract.md` 里**没有任何寄存器来源**（全文没有版本/序列号寄存器），所以是显示侧自报的常量字符串，写死在 `disp/touch_view.v` 里；③ 链路统计 = 显示侧到触摸 IC 的 IIC 读次数 / 无应答次数 / 超时次数（这三个计数本来就在 `touch_view` 里），底栏的 `中断电平 / 翻转 / 复位次数` 一行不动；④ 资源占用 = `LUT % / BRAM % / DSP %`，是**位流期**的事实、运行期测不出来，所以做成 `RES_LUT_PCT / RES_BRAM_PCT / RES_DSP_PCT` 三个常量（来源 = 最近一次 `_disp_work/impl_util.rpt`，归档时由 `verify_u35.py` 与实现报告逐项比对——写死的数字要有守卫）。原来的「触摸诊断」（触点 X0/Y0/触点数/0x814E）让位给规范这四项，字段宽度随之改为 `5/3/3/6/6/6/2/2/2`，`tch_num/x0/y0/status/pid` 五个端口保留不删（下一轮「自检结果」要用）。字库按纪律**只追加** 12 个汉字（系统信息设备固件版本资源占用），`disp/tb_font_rom.v` 的 `NC/NCH` 同步成 104/155。验证：`disp/tb_touch_view.v` 三轮期望值整体重写（GT911 / FT5206 / 未知型号）、`tb_font_rom` 的计数同步；全量 **23 / 23 PASS**、lint 0/0、smoke 通过；`_disp_work/page_p8.png` 与静态版面同源（P8 没有运行期绘图，预览器无需改）。**排错过程见协作记录 57**（其中一条是「加字必须同步字库台的 NC/NCH」，另一条是控制台编码把"通过"变成 `UnicodeEncodeError`）。

㉜**P8 第 ⑤ 项「自检结果」：三项 IIC 判据 + 「通过 / 失败」**（U-36 本轮）：spec §4.4 给 P8 列的五项里，最后一项是「自检结果」—— ⑪ 那轮落的 ①~④（设备 ID / 固件版本 / 链路统计 / 资源占用）已经在屏上，本轮把 ⑤ 补上。难点在于**结论是运行期的**（IIC 计数每帧都在变），而 P8 的版面是 `disp/text_ram.v` 的 `initial` 里一次成型的静态数据，改不了 ⇒ 新增第 6 个运行期写者 `disp/selftest_lab.v`（与 `undo_lab` / `stat_chip` 同一个理由）。判据只有三项，全部取自显示侧真正握着的那条链路 —— 显示 → 触摸 IC 的 IIC：**① 读次数 ≠ 0（否则是没读成功过）② 无应答 = 0 ③ 超时 = 0**，三项全真 ⇒ `通过`，否则 ⇒ `失败`；**不判** `tch_status == 0`（0x814E 不刷新的历史现象）与触点数 = 0（没手指不是故障），也不收编码器侧的协议校验位（只有电平没有计数）。结论落在 P8 **底栏（文字层格行 36）最右端**：静态标签 `自检结果` 在格 31..34，结论两个字在格 **36/37**（`通`159 / `过`160 / `失`161 / `败`162），不新开一行 —— 三条数据带（文字层 3/15/27 + 数值层 1/4/7）已经排满。它与 `band_view`（写底栏 11/18/27 列）**共用 `p8_lab_ram` 写口但列不重叠**，所以只要一层优先级 mux（`p8l_we = bv_we | sl_we`）+ 一条 `hold`；模块的 `we/waddr/wdata` 是**组合**的、`hold` 期间不写也不推进 `idx`（㉗ 记录 53 的教训）。结论的三个输入**就显示在同一页第 15 格行**，所以屏上能自己交叉验证（规范 §5.2 的加强版）。字库按纪律**只追加** 8 个汉字（自检结果通过失败），`disp/tb_font_rom.v` 的 `NC`/`NCH` 同步成 112/163。验证：新单元台 `disp/tb_selftest_lab.v` 六用例（三种失败成因 + 结论能变回通过 + `hold` 期间 `we` 必须为 0）、整机台 `disp/tb_disp_engine.v` 的 `[14]` 段四组状态（直读 `p8_lab_ram` 的 (36,36)/(36,37) + 静态标签 31..34 原样不动 + 结论区墨量 > 0）；全量 **24 / 24 PASS**、lint 0/0、smoke 通过；`_disp_work/page_p8.png` 底栏 `自检结果  失败`（fail-safe 静态占位）人眼核对通过。**排错过程见协作记录 58**（本轮的坑是「一级流水 + `wait_frames` 只等帧号变化 ⇒ 判据读到上一帧」，以及由此照出来的"假绿"）。

㉝**P6 底部危险区 944×96 + 按钮 ±8 px 命中外扩**（U-37 本轮）：spec §4.4 给 P6 写的是「3 列 × 4 项网格（项高 88）+ 底部危险区 **944×96**」，⑲ 那轮把危险区做了出来但高度只有 **80 px**（y 520..599），而且注释里写着"含触控外扩后 72 px"、**代码里的命中矩形其实一点没扩**（就是按钮画框本身）。本轮把这两处收口，**没有重排任何一个字**：96 px 靠收回第 4 项（`SHIFT`）数值格下沿那 8 px —— 数值格占 y 448..511、而它的字形只落在 459..500，所以 504..511 是**无墨迹的空白**，把 `DZ_Y0` 从 520 提到 **504** 就得到 504..599 = 96 px；按钮框跟着从 y 528..591 移到 **520..583**（仍 64 px 高），于是危险区、按钮框、警示三角（尖顶 532 / 底边 572）与按钮文字（文字层格行 34，y 544..559）**四者的中心都在 y = 552**，版面数据（`P6_LAB/P6_VAL`）一个字节没动、`disp/text_ram.v` 不重新生成。命中侧把 `disp/enc_top_disp.v` 里那四个裸数字（192/640/528/592）抽成 `DZ_HIT_X0/X1/Y0/Y1` = 画框 **±8 px**（184..647 / 512..591）⇒ 命中高度 **80 px**，落在 spec §6.1「危险动作 72..96 px」内；危险区按钮**故意不进 `hit_test`**（命中层不认识页号，延续 ⑲ 的纪律），仍由策略层按坐标 + `page == 5` 判。**回归能力是本轮最值钱的产出**：旧 `[7]` 段那 6 条判据在 80 px 与 96 px 两种几何下**都全绿**（它们钉的是区域内侧与按钮中点），所以几何改了两处也没人拦 —— 新加 12 条一律钉在"新旧几何的差"上（区上沿 504 / 503、重叠带 508 的底色与"没有文字被盖住"、按钮上下沿 520 / 519 / 583 / 584、三角尖顶与底边 532 / 531 / 572 / 573）；面板台 `disp/tb_enc_disp_panel.v` 加第 9 段，把危险区按钮四边各测"框内 4 px 受理 / 框外 4 px 不受理"（9b..9g），并数 W1C 请求**只发一条**（9h）。**排错过程见协作记录 59**（旧注释里那个错的"档距必须是 64 的倍数、最小 128"、判据在旧值下也全绿、以及同一份几何在两层各写一份裸数字）。

㉞**P4 等效采样注记按 spec §7 字面口径（14 格 + 字库 +4 字）**（U-38 本轮）：spec §7 的数据来源表（`docs/13_display_ui_requirements.md:305`）对 ABZ/UVW 时序图只写了一句屏上要求 ——「时间轴画 A/B 会混叠，**必须按电角度 64/128 箱等效采样，并在图上注明**」。⑩ 那轮确实在图上写了注记，但字面是妥协写法「128点等效采样」：那一轮字库是 44 ASCII + 83 汉字 = 127 码、lab 码宽 7 bit、**只剩 1 个空位**，「按」「重」「建」「箱」四个字一个都塞不进去，于是拿已有的「点」顶「箱」（原话与理由记在 ㉑ 那一段）。本轮把四个字补齐：`tools/make_cn_glyphs.py` 的 `CN_ORDER` 末尾追加「按重建箱」⇒ **116 个汉字**（`disp/font_rom.v` 重生成 = 51 ASCII + 116 汉字 = **167 码**、140,672 bit = 17.17 KB = 3.82 RAMB36，上一版 163 码 / 139,648 bit / 3.79 RAMB36），`tools/gen_text_ram.py` 的 P4 注记改成 `(27, 6, "按电角度重建128箱等效采样")` —— **14 格**、x 96..319、行 27（y 432..447，P4 框内唯一不压波形/轴标/刻度的空行），`p4_lab_ram` 的非空格从 61 变 67。**本轮不动任何几何常量、不动其它七页的版面**。判据分两层（`disp/tb_disp_engine.v` 新增 **[15] 段**）：① 直接读 `u_p4_lab_ram` 的 14 格字符码逐格比对（`check_p4note`，期望码由 `_disp_work/_probe38.py` 按 `ASCII_CHARS` + `CHARS.index()` 复算 = 163 / 71 / 75 / 76 / 164 / 165 / 9 / 10 / 16 / 166 / 69 / 70 / 127 / 128），② 那一条带的 `C_TEXT` 墨量 > 0（`p4n_px`，实测 **2480 px**）证明文字层真的画出来了；`disp/tb_font_rom.v` 的 `NC 112 → 116`。**这条欠账为什么能藏十轮**：拿「点」顶「箱」既不编译报错、也过得了字库覆盖检查（`check_covers_layout()` 只看"有没有字模"，而「点」本身有字模）、像素判据也照绿（那一带确实有字）—— 只有把规范原话与屏上字面**并排逐字读**才能发现。**排错过程见协作记录 60。**

㉟**P1 两处口径注记按 spec §7 字面补齐（「估算值」+「本次上电起算」，字库 +4 字）**（U-39 本轮）：spec §7 的数据来源表（`docs/13_display_ui_requirements.md`）里还有两条写给屏幕的要求 —— `:300` 机械转速 `RPM = 60 × f_in / 极对数`（`0x0100`，默认 4）的口径栏写着**标「估算值」**（`f_in` 是算回来的量，不是直接测出来的）；`:302` 累计转数从「**本次上电**」起算、**不是掉电保存的绝对值，屏上要写明**。屏上这两句话一直没有：P1 转速卡只有 `转速 / RPM`，累计转数卡只有 `累计转数 / REV / Z计数`。本轮补齐：`tools/make_cn_glyphs.py` 的 `CN_ORDER` 末尾追加「估算上起」⇒ **120 个汉字**（`disp/font_rom.v` 重生成 = 51 ASCII + 120 汉字 = **171 码**、141,696 bit = 17.30 KB = 3.84 RAMB36，上一版 167 码 / 140,672 bit / 3.82 RAMB36），`tools/gen_text_ram.py` 的 `P1_LAB` 加 `(14, 46, "估算值")`（3 格，x 736..783、行 14 = y 224..239，夹在 `RPM` 单位与卡片迷你状态条之间）与 `(23, 26, "本次上电起算")`（6 格，x 416..511、行 23 = y 368..383，卡标题正下方），`p1_lab_ram` 的非空格从 114 变 123。**本轮不动任何几何常量、不动其它七页的版面、不改 RPM 与累计转数的算法**。判据分两层（`disp/tb_disp_engine.v` 新增 **[16] 段**）：① 直接读 `u_p1_lab_ram` 的 3 + 6 = 9 格字符码逐格比对（`check_p1notes`，期望码由 `_disp_work/_probe39.py` 按 `ASCII_CHARS` + `CHARS.index()` 复算 = 167 / 168 / 126 与 150 / 104 / 169 / 71 / 170 / 168），② 两条带的 `C_TEXT` 墨量 > 0（`p1n_px` / `p1q_px`，实测 **624 px** 与 **988 px**）证明文字层真的画出来了；`disp/tb_font_rom.v` 的 `NC 116 → 120`。**这两条要求为什么能藏十轮**：P4 那条注记连着"等效采样"这个功能、读表的人会顺手看到，而这两条只是**表格里的一格文字**，看起来像给文档读者的说明 ⇒ 只有把同一张表逐行读、逐行问"这句话在屏上哪里"才会发现。**排错过程见协作记录 61。**

㊱**P5 六行状态名改汉字写法（`U高 V低 W低` …，字库 +2 字）**（U-40 本轮）：spec §4.4 的 P5 行是「6 行 × 5 列，行高 30、列宽 188，含占比条形图列」，五列语义（序号 / **状态** / 次数 / 占比 / 条形图）是 v30 自定并记在 U-30.7 的。其中**状态那一列一直是 ASCII 三位写法**（`U1 V0 W0` …），而界面是中文的 —— `docs/DEV_STATUS.md:8846-8851`（U-25.7 ②）当年把它挂账，理由是"字库 44 ASCII + 83 汉字 = 127 码已满、lab 层码宽只有 7 bit（0..127），只剩 1 个空位"；㉓ 把 lab 码宽升到 8 bit 之后这个门槛才消失，P5 的另外两条挂账（5 列 / 30 / 188、条形图刻度）也早已做掉 ⇒ 本轮补上这最后一列文字。改动很小、要求很硬：`tools/make_cn_glyphs.py` 的 `CN_ORDER` 追加「高低」⇒ **122 个汉字**（`disp/font_rom.v` 重生成 = 51 ASCII + 122 汉字 = **173 码**、142,208 bit = 17.36 KB = 3.86 RAMB36，上一版 171 码 / 141,696 bit / 3.84 RAMB36）；`tools/gen_text_ram.py` 的 `P5_LAB` 六行状态名 1 → 高、0 → 低（U/V/W 三个字母与两个空格仍是 ASCII ⇒ **每行仍是 8 格**，列位、虚拟格网的地址映射 `{8+r, 11c + dx>>4}` 与字形相位 `lab_bits[15 - dx[3:0]]` **一个字都没动**，`p5_lab_ram` 的非空格仍是 84）。**判据落在像素上**（`disp/tb_p5_page.v` 新增第 7 节）：① 六行各 8 格整块的 `C_TEXT` 墨量必须逐行等于离线用同一份字形算出的精确值 **483 / 483 / 482 / 483 / 482 / 482**（少一格、错字、错相位、被裁掉都会变数）；② 18 个"新写法与旧 ASCII 取值相反"的像素（六行各 3 个）—— 这些点在旧版本上必然红。**为什么不能只回读 RAM**：汉字是**第一次进入 P5 的虚拟格网**（㊱ 之前这张表里全是 ASCII，那条渲染路径从来没跑过），而"写进 RAM 了但没渲染出来"正是 v24 那个 7 bit 截断的表现。★ 这条判据第一版就自己红了一次：墨量各少 26/26/26/30/30/30 —— 差值正好是最后一格最右 **6 px** 的墨量，顺着它回读 RTL 才把 `P5_INSET = 6`（列内左右各 6 px）与 `P5_VINSET = 7`（30 px 行带里 16 px 字形垂直居中）读出来。**本轮不动任何几何常量、不改电平判据与条形尺度、不动其它七页**。**排错过程见协作记录 62。**

㊲**危险区按钮的按下反馈（按下与发声分家 + 形状编码 + 询问态不被压暗）**（U-41 本轮）：`docs/DEV_STATUS.md` 的「仍未做」清单里，这条从 U-37.8 一路挂到 U-40.8 的第 3 条，写法是"危险区按钮没有按下/长按视觉反馈（只有进询问态后按钮底色变浅 `24'hFBD9D6`）"。读 RTL 发现**挂账描述不是根因**：旧行为是 `wire tap_dz_clr = hit_stb && 命中` —— **按下那一拍就进询问态**，而询问态的合成 `compose = dlg_on ? (in_dlg_box ? … : C_DIM) : with_pnl` 会把对话框之外**整屏压成 `C_DIM`**；危险区按钮在 y 520..583、对话框在 y 196..403，两者**完全不重叠** ⇒ 那一刻给按钮上什么颜色、画什么形状都看不见。本版三件事一起收口：① **按下与发声分家** —— 按住只拉高 `dz_prs_lvl = hit_held && dz_now_in`（只驱动外观），`dz_latch` 记住"按下那一刻的起点是否在命中矩形里"、`hit_rel` 那一拍再要求**抬点仍在内**才产 `dz_click = hit_rel && dz_latch && dz_now_in` ⇒ 按住后滑出按钮再抬起**不受理**（spec §6.5 第 ② 类"防误触但不必弹窗"）；② **反馈用形状** —— 按钮里侧 10 px 处画一道 **2 px** 内嵌框（左 x 202..203 / 右 x 628..629 / 上 y 530..531 / 下 y 572..573），不新增颜色（spec §5.2"颜色绝不作为唯一的状态编码"）；③ **模态让步的半径压到一个按钮** —— `dz_keep = dlg_on && dz_btn`，询问态下只放行按钮矩形本身（含它的标签字形），危险区其余部分照旧压暗。**新增端口只有一个**：`disp/disp_engine.v` 的 `ui_dz_press`（按住电平，1 bit）；`disp_engine` 的 **8 处例化**全部补齐（真实链路接 `dz_prs_lvl`，其余 7 个 tb 接 `1'b0`，引擎台接 `dz_prs_tb`）。**写寄存器链路一字未动**（`ui_edit` 的 W1C、`w1c_req` 时序、`dlg` 状态机的 0/1/2 三态都没改）。判据分四层：`disp/tb_disp_engine.v` 新增**第 ⑥ 段**（内嵌框八点在 `dz_prs_tb=0` 时必须是脸 `C_BG`、`=1` 时必须是 `C_FAULT`，内部点 (300,552) 两态都必须是脸 —— 只测按住态的话"把按钮刷红"也能过）；第 [7] 段加"询问态下按钮不被压暗"（`(300,552) = FBD9D6`、按钮外的 `(100,552)` 仍 `C_DIM`）与"标签像素没被遮罩吃掉"；`disp/tb_enc_disp_panel.v` 第 10 节用 `tch_sample` 把按住态拉长，钉 10a（按住期间 `dlg` 仍是 0、`hit_held` 与 `dz_prs_lvl` 都已拉起）/10b（在按钮内抬起才进询问态、只发一条 W1C、`CANCEL` 回关闭态）/10c（按住滑出再抬不受理）。★ 顺手修掉一条**抛硬币的旧判据**：第 [9] 段原来用 `expect_not_px(192,496, C_TEXT, "panel off: 没有 [−] 符号")` —— 那一点落在 P1 卡片 [4] 的**数值格**上，而 tb 的 `t_angle` **每帧 +8192**、数值格每帧被 `val_format` 重写 ⇒ 判据结果取决于仿真相位（U-40 全量回归时它是绿的，㊲ 在第 [7] 段插了两条采样就翻了）。改成读**层信号**：在与合成同拍的输入坐标上断言 `u_dut.pnl_any === 0`（关）/ `=== 1`（开，证伪点）。**预览器同源**：`tools/preview_pages.py` 新增 `draw_dz(press=…)` / `draw_dlg(dz_keep=…)` 与两张演示图（`page_p6_dz_press.png` / `page_p6_dz_dlg.png`，共重出 14 张）。**排错过程见协作记录 63。**

㊳**P6 加第五行填掉 88 px 空档（项高字面 88 = 5 x 88 + 96）**（U-42 本轮）：`docs/DEV_STATUS.md` 的「仍未做」清单里，spec §4.4（`docs/13_display_ui_requirements.md:177`）的「项高 88 px」从 U-23.7 / U-37.8 / U-38.8 / U-39.8 / U-40.8 一路挂到 U-41.8 第 1 条 —— 4 x 88 + 96 = 448 px、而内容区（y 64..599）有 536 px，照字面做会在危险区上方**空出 88 px**。用户（m25387）拍板「加第五行把 88 px 的空档填掉」。**为什么以前做不到**（这才是本轮的技术内容）：88 与 P6 用的两套全局栅格都不可通约 —— 文字层格 16 px（88 = 5.5 x 16）、数值层格 64 px（88 = 1.375 x 64）；v19..v41 那 128 px 档距不是审美选择，而是"标题行与数值格行都必须落在栅格上"逼出来的唯一解。本版把这两道约束整个拿掉，路线与 v30 的 P5 五列表框相同：**给 P6 加一套虚拟格网** —— 用一串比较器算出"项号 k"与"带内 y = v"（`p6_vy` / `p6_k` / `p6_ktop` / `p6_v`），再拿它们当 RAM 行号与字形 ROM 的"格内 y"：标题 = lab RAM 行 `4 + k`、格内 y = v（墨迹恒在带内 v 1..14 ⇒ y 65..78 / 153..166 / 241..254 / 329..342 / **417..430**）；数值 = val RAM 行 `1 + k`、格内 y = v - 13（墨迹恒在带内 v 24..65 ⇒ y 88..129 / 176..217 / 264..305 / 352..393 / **440..481**）。两层各带一个**可见性门**（`p6_lvis` / `p6_vvis`）：不门控的话同一个字形会在 88 px 带里按 16 / 64 px 周期重复出现，而且负相位 6 bit 回卷会画出伪墨迹。**顺手抓出并修掉一个真缺陷**：标题 RAM 行若从 3 起，行 3 的**自然**位置（y 48..63）落在 `p6_area`（y >= 64）之外 ⇒ 自然映射会把「倍频」多画一行到第一行带上方当残留文字（**预览件镜像不走自然行，图上根本看不出来**）。改成从 4 起 + 一条证伪判据（旧行区间残墨必须 0 px）—— 那条判据第一次跑就报 22 px，查下来是**判据自己的窗口**压住了标题带那颗「闪烁」复选框（`CHK_X0/Y0 = 668/36`，16x16，实心时是 C_TEXT，占 y 36..51），窗口下沿从 49 改成 52 后为 0 px。**对话框文字行 15/17/21 → 13/18/22**：新标题墨迹落在 y 241..254 与 329..342，正压在旧行 15（240..255）与 21（336..351）上，而页面层对这三行是"按页排除"（`dlg_cell0`）⇒ 不迁就会把第 3 / 第 4 项的标题整条吃掉；行 22 同时是导航栏第 4 个页签「时序」所在行（格列 1），所以排除又多了一道格列门控（`px2[9:4] >= 6'd16`，即 x >= 256）。**第 5 行放的是三个 v15 修正参数**（P6 上唯一一直没显示的三个）：增益S / 增益C / 相位修正（`cfg_gain_s` / `cfg_gain_c` 无符号 Q1.15、`cfg_phase_k` 有符号 Q1.15），渲染口径 `m * 125 >> 12` 得千分数（`m*125 = (m<<7)-(m<<1)-m`，只要两个减法器），BCD 完全复用现成的 32 拍 double-dabble；有符号那项多一位 `+`/`-`（宽 6 格），小数三位**不做**前导零抑制。字段表 12 → **15**（`disp/p6_view.v` 的 `f_row/f_col/f_wid/f_kind` 与状态机终止值 `4'd11 → 4'd14`），并新增字段种类 `K_Q15` —— 它必须走 BCD，所以 `S_PREP` 里那句 `cur_kind >= K_STR` 换成了显式的 `!cur_bcd`。**字库 +3 字**（增 / 益 / 修；「正」早在"正常"里）⇒ 51 ASCII + **125** 汉字 = **176 码**、142,976 bit ≈ 3.88 RAMB36。至此 spec §4.4 给 P6 写的三个版面数字（3 列 / 项高 88 / 危险区 944x96）**全部字面满足**。

㊴**P6 危险区加第二颗「恢复默认」按钮 + 13 条写寄存器恢复序列（回读确认 + 红 ✖ 指项）**（U-43 本轮）：`docs/DEV_STATUS.md` 的「仍未做」清单里，spec §4.6 下钻路径（`docs/13_display_ui_requirements.md:202`）写着的 `──危险区:「清除锁存故障」「恢复默认」──→ 确认对话框` 从 ⑲ 那轮起只做了一半：只有「清除锁存故障」。本轮把它补齐，并且**屏侧自己按 spec §6.2 的两阶段提交把 13 条命令发出去再回读确认**。**四条路都算过**：① 屏侧只有一条写通路（`disp/ui_edit.v` 把 4 字节命令打到 `enc_top.uart_rx`，与上位机同路径）⇒ **`rtl/` 与冻结契约一个字都不用动**；② 桥的写命令一条写**两个连续寄存器**（`rtl/uart_spi_bridge.v:16-32`）⇒ 13 条命令覆盖 16 个（顺带把 ZERO0 / OUTPUT / H2_K 一起写回默认）；③ 屏侧**没有 UART 读通路** ⇒ 回读只能走 `disp_tap`，所以只承诺抽头里有的 17 个字段，`0x0104` 迟滞(UVW) / 方向位 / H2_K 一律不承诺；④ 失败策略按用户决定**不回滚**、屏上不显示十六进制错误码 —— `bad[14:0]` 的 15 位与 P6 的 15 个格位一一对应，红 ✖ 的**位置 + 形状 + 颜色**本身就是"哪一项"的编码（spec §5.2 要求颜色绝不作为唯一编码）。**版面**：危险区从一颗按钮变**两颗对称按钮**（各 412 px，x 180..591 与 x 608..1019，缝 16 px，标签 `(34,21)` / `(34,49)`），命中区各外扩 8 px 并在 x=600 相接；询问态对话框有了第二套文字行（kind=1 用 lab 行 14 与 19，正文 `REG 0X0100-051A` 从格列 24 起才居中），失败时在那 15 个格位的**行带号**上画 ✖。**本轮抓出并修掉六个真缺陷**（详见 U-43.5）：① ✖ 的第一版按**自然格行**选行带（`lab_cy - 4`），而 P6 的行带是虚拟的、标题墨迹横跨 1~2 个自然格行 ⇒ 只有第 0 带能中，其余四带的 ✖ 永远画不出来；② 按钮画框从 192..640 挪到 180..591 后**命中矩形忘了跟着挪**（还是 184..648）⇒ x 608..647 会落进第 1 颗的命中区，而模态 FSM 是 `if (dz_click) … else if (dz_click2 …)` ⇒ 按「恢复默认」会弹出「清除锁存故障」；③ `disp/ui_restore.v` 的命令间隔原来是 80 µs，**短于桥处理一条命令的最坏 ≈160 µs**（收 4 字节 → 内部 SPI 帧 10.56 µs → 抢遥测空闲最坏 ~100 µs → 发 6 字节应答），第 2 条起的命令整条被丢掉 —— 症状极隐蔽：只有被写脏过的那一项报不一致（`bad=15'h0010`），其余寄存器本来就是默认值、写不写看不出；改成 500 µs（3 倍余量）后全绿；④ 端到端台首跑把"字节数"用**下降沿计数**量（99 ≠ 52，字节内部的数据位也算），改成按起始位同步采样；⑤ 写脏命令发完只等 40 拍（800 ns）就查，桥还没把值落进 `reg_file`（这个假象还会让后面"恢复后 = 0"的判据假绿）；⑥ **预览件是另一个实现**：`draw_p6_planes` 把 ✖ 画成 `C_TEXT`（不红），而且**从来没画过两颗按钮的标签**（格行 34 不在任何 `draw_plane` 范围内）⇒ 静态 P6 图上是空框，而引擎台一直在判它有墨。**字库 +3 字**（恢 / 默 / 认；「复」早在"复现"里）⇒ 51 ASCII + **128** 汉字 = **179 码**、143,744 bit ≈ 3.90 RAMB36。本轮的判据分四层：`disp/tb_ui_restore.v`（新增：52 字节黄金流 + 反例 `bad=15'h0010` + 去刺重跑）、`disp/tb_disp_engine.v` ⑥⑦ 段（两颗内嵌框、描边三态、✖ 按行带列选格、两套对话框行 + 正文居中）、`disp/tb_enc_disp_panel.v` 第 11 段（真闭环端到端：物理 `uart_rx` 写脏 → 按第 2 颗 → OK → 52 字节黄金流 + 命令间隔 ≥ 300 µs + 首字节到达时桥在 `C_IDLE` + `rst_state=1` + 真寄存器回到 0）、以及 `_disp_work/_p6chk.py`（把引擎台的像素判据在预览图上重跑，约 50 条）。**排错过程见协作记录 69**。

㊵**字库 +4 字，把 spec 字面标签写回屏（Tab「模拟」/ 标题带按钮「展开」）**（U-44 本轮）：目标第 18 轮收口四批次之后，两个**只读审计**子代理逐条比 spec 与实现（一个查 §4/§7、一个查 §5/§6/§8/§12，共点出 20 + 8 条缺口）。其中一条**纯沙箱就能闭掉**：spec `docs/13_display_ui_requirements.md:173` 写 P2 的入口是「导航「波形」→ Tab「**模拟**」」、`:176` 写 P5 的入口是「P4 表格「**展开**」」，而屏上从 ⑳ 起一直是 ASCII `SIM` / `EXPAND` —— 原因写在 `tools/gen_text_ram.py` 的注释里：**模 / 拟 / 展 / 开 四个字不在字库**。本轮把这 4 个字补进去（`CN_ORDER` 末尾追加 `"模拟展开"`，**已有 128 个汉字的码位一个都不动**），字库从 179 码变 **183 码**（51 ASCII + 132 汉字）、143,744 bit → **144,768 bit**（17.67 KB、3.93 RAMB36）；`P2_LAB`/`P3_LAB` 的 Tab 1 由 `(7,11,"SIM")` 改成 `(7,11,"模拟")`（2 格 32 px，Tab 矩形 x 96..296 ⇒ 理想居中 x 180，格列只能整格走 ⇒ 取格列 11 = x 176..207，偏左 4.5 px），`P4_LAB` 的标题带按钮由 `(2,43,"EXPAND")` 改成 `(2,45,"展开")`（x 720..751，**与 P1「标定」同格列**）。**顺带查出一处从 ㊴ 起就陈旧的判据**：`disp/tb_font_rom.v` 的规模常量还是 `NC = 125` / `NCH = 176`，而上轮加字后字库已是 179 码 ⇒ "最近 3 个字的点阵非空 / 两两不重复"这两条判据**一直没有跑**（台仍然 PASS —— "判据少跑"和"判据通过"在日志里长得一样）；本轮改成 `NC = 132` / `NCH = 183` 并让 `disp/tb_disp_engine.v` 的 §[8] 段加**码位级**判据（P2/P3 的 Tab 两格必须是 179 / 180、P4 按钮两格必须是 181 / 182，FAIL 时打印实测码）。判据四层：`disp/tb_font_rom.v`（183 码逐个判非空 + 两两不重复）、`disp/tb_disp_engine.v` §[8]（码位）、`disp/tb_p2_page.v`/`tb_p3_page.v`（窗口判据不变）、预览件人眼核对（`_disp_work/page_p2.png` / `page_p4.png`）。**仍未做**：审计报出的其它 spec 字面缺口（卡内 `y+110` 的 1 px 分隔线、卡 4 次级 `pos_full`、卡 6 的「U V W」与底部六通道逻辑条）要动已验收的卡片版面，以及两条需要 spec 裁决的下钻路径（卡片 3 → P7 / 卡片 6 → P4），见 `docs/DEV_STATUS.md` 的 `U-44.8`。

**相对上一版的改动**：①新增 GT911 触摸栈（`disp/touch_ctrl.v`、`disp/i2c_master_seq.v`、`disp/i2c_io_wrap.v`）、第三页 P8、`disp/touch_view.v` 运行时格式化器、状态指示灯、十字准星；②**翻页键从"只有 J5-29 跳线"改成板载 KEY1（Y9）也能翻**；③**修掉 LCD 红/蓝字节整体对调**；④**主界面中文化（C4）**：字库加入 66 个 16x16 汉字点阵，lab 层行位图由 10 位加宽到 16 位；⑤**屏上改值的写链路（③ 前半）**：新增 `disp/ui_edit.v`，屏自己经层内 `uart_spi_bridge` 写 `0x0101/0x0102`，再从 `disp_tap` 回读 `cfg_inter/cfg_div` 确认；不一致自动回滚。触发是**长按板载 KEY1 ≥ 1 秒**（见第 5 节），反馈是 P1「倍频分频」卡片的底色；⑥**P8 底栏三个数（④）**：新增 `disp/band_view.v`，把 `中断电平 / 翻转 / 复位次数` 写进**文字层**第 36 格行（数值层第 9 行超出 600 px 屏高，写不进）。⑦**导航高亮跟随页号 + `disp/` 纳入 lint 覆盖（⑤）**：左侧导航的选中底色原来**写死在第 0 项**，翻到 P6/P8 时仍然高亮“总览”。现改为按页号选中（P1→总览、P6→设置、P8→**任何一项都不高亮**，因为 spec 4.1 规定 P8 走状态栏的 ⚙ 入口，不在左侧导航里）。同时 `tools/lint_all.ps1` 的检查目标从 `rtl\*.v + sim\tb_*.v`（39 个文件）扩到再加 `disp\*.v` 与 `disp\sim\*.v`（**66 个文件**）—— **显示代码此前从未被 lint 检查过**。⑧**触摸命中判定（⑥）**：新增 `disp/hit_test.v`（约 195 行），把“屏幕上的一个点”翻译成“哪个控件被按了”（**6 张卡片 + 6 个导航项 + 1 条状态栏 = 13 个热点**）。左侧导航**第一次点得动**：点 `总览` 回 P1、点 `设置` 去 P6；P1 上点**「倍频分频」卡片**也能触发改值（与长按 KEY1 同一条执行链）。命中判定**只做几何、不认识页号** —— 页号守卫留在策略层（`if (tap_card_md && (page == 2'd0))`），避免在 P6 上点同一坐标也改倍频。同时补上一道越界闸（上游坐标 16 位、显示坐标 12 位，`x0 = 2048` 不截断会折成 0 = 屏幕左上角 = 导航第一项，见记录 18）。⑨**P6 实时回读（⑦）**：此前 P6 那 9 个数字是 `tools/gen_text_ram.py` 里的**静态预置** —— 而预置值恰好等于编码器的复位默认值，所以不改设置时**看着全对**，其实 `p6_val_ram` 的写口一直接 `1'b0`，这条通路从来没通过。现新增 `disp/p6_view.v`（按 P6 自己的 3×3 字段表重画数值层），写口改为 `p6v_we & (page == 2'd1)`，每帧消隐期回读一次。顺带顶出一处旧错：静态预置写的是 `X 64`，而倍频寄存器 0 的真值是 **256**（`rtl/abz_gen.v:285 inter_n = (inter == 10'd0) ? INTER_MAX : inter`），新通路第一帧就把它改成了 `X256`。为此把 `rtl/enc_top.v` 的只读抽头 `disp_tap` 由 134 位扩到 **183 位**（`[133:0]` 一位未动），6 个新字段全部是**已经在寄存器里的既有信号**，并把这份契约正式写进 `rtl/SPEC_interface_contract.md` §2.2（此前它只存在于注释里，而且那段注释指向一个不存在的 §1.14）。⑩**P2 输入波形页（⑧）**：新增 `disp/wave_ram.v`（每列存 `[lo,hi]` 区间的双缓冲，2048×32 = 2 个 RAMB36）与 `disp/wave_trace.v`（按列采样、钳位、写满 944 列即停），`disp/disp_engine.v` 里加 P2 版面、通道中线与合成链。**每列存区间的理由**：spec §7.2 禁止在像素路径里实时栅格化折线，存 `[lo,hi]` 后像素路径只剩两个比较器。**双缓冲的理由**：同一块存储被写者和读者按不同顺序访问时，读者在“写者到达该地址之前/之后”各读到一次就必然撕裂，而“写得比扫得快”救不了它。同时把**页面编号改成 spec §4.4 的页面顺序**（0=P1、1=P2、2=P3、3=P4、4=P5、5=P6、6=P7、7=P8，`page` 位宽 2→3），于是“导航第 k 项 == 页号 k”，原来那张手写的 `nav_page` 映射表**整段删除**。⑪**P3 李萨如 XY 页（⑨）**：新增 `disp/xy_ram.v`（192×192 格点阵、每格 2×2 屏上像素、双缓冲、131072×1 bit = 4 个 RAMB36）与 `disp/xy_plot.v`（一帧两相：擦整面 65536 拍 → 每 16 拍打一个点），`disp/disp_engine.v` 里加一次查表。**位图存的是“格”而不是“线”**：像素通路只做一次 `/2` 取位和一次位比较，没有斜率、没有连线、没有循环（spec §7.2 禁止在像素通路里实时栅格化折线），靠采样密度（一帧约 49000 点、每个信号周期约 1900 点）把曲线“画”出来。**入口**：spec §4.4 给的是 `P2 → Tab「XY」`，本版没有 Tab 控件，改为点左侧导航第 2 项「XY」。**同时修掉一处真错**：`xy_plot` 的复位状态让描点器在第一次帧首之前就开始写，而复位时 `wr_buf == disp_buf` —— 双缓冲的两个指针在复位那一拍必然相同，“写面 ≠ 显示面”这条不变量必然被违反；现加显式的 `reg started`，等第一次帧首。**注意 spec §4.4 的 P3 那一行自相矛盾**（写了 `560×560` 又写了 `y=140..600` 只有 460），本版选了**坐标**那一半（560×460），理由见 `docs/DEV_STATUS.md` 的 `U-15.1`。⑫**P4 ABZ/UVW 时序页（⑩）**：新增 `disp/logic_scope.v`（**按电角度 128 箱等效采样**，每箱 6 bit {w,v,u,z,b,a}，无写使能 —— 因为 50 MHz / 384 kHz 下电角度每拍前进约 503 个计数、正好卡在 512 的箱宽上，加「每箱只写一次」的门会整箱跳过而漏读）。**为什么不是时间轴上的一串点**：A/B 的边沿率是 4×inter×f_in，inter=256、f_in=1500 Hz 时是 1.536 MHz，直接画在时间轴上得到的是混叠出来的假波形（spec §7.1 有明文，spec §3.2 也早为「逐列 6-bit 状态」预算过）。页面上按 6 条通道行画高/低轨 + 箱首竖直边沿（两个寄存读口换来「前一箱」的值，于是像素通路里只有移位和比较）。⑬**三个实时页面的管线级数修正（U-16）**：P2 波形与 P3 点阵的输出各多补了一级寄存器，整块内容在屏上**右移 1 px**。推导：读地址用的是**未延迟**的 `pix_x`，而合成链里的坐标是延迟两拍的 `px2`，所以「数据比坐标早一格」，补一级正好对齐。**为什么两轮的页面测试台都是绿的**：那些断言把 `pix_x` 停在一点上再读，数据通路无论几级都会收敛到同一个值 —— 级数是时间属性，停住输入就把时间维消掉了。新增 `disp/tb_pipe_align.v` 用**连续光栅**测（`pix_x` 每拍 +1），实测修正前 P2 落在 181、P3 落在 421，修正后 180 / 420。顺带修掉 P4 的一处栅格化错误：高/低轨与竖直边沿只判行不判列，一路画进了左边的标签栏（新增 `lg_tband` 门控）。**`rtl/` 这一版又回到一行未改** —— ㉒ 是纯显示侧（新增 `disp/ui_panel.v`，改 `disp/hit_test.v` / `disp/disp_engine.v` / `disp/enc_top_disp.v` / `disp/val_format.v` 与测试台），`disp_tap` 仍是 ㉑ 扩过的 **375 位**（`[342:311] = cfg_amp_low_sq`、`[374:343] = cfg_amp_high_sq`）—— 编码器内部逻辑、`rtl/` 与遥测帧这一版一行未动，新面板走的是与上位机完全相同的 `ui_edit` 两阶段提交链路（写 → 回读 → 比较 → 不一致回滚）。

## 2. 第 1 步：上电，先什么都别碰（约 30 秒）

**预期**：屏亮，出现 **P1 总览**页；屏幕中间 **6 张卡片（2 行 × 3 列）**，每张卡的数字都在变：

> **2026-10-15 起界面标签改为中文**（实机照片核对过）。下面表格"屏上标签"一列是你在屏幕上
> 应该**照着念出来**的字；"含义"一列是它代表什么。数据本身仍是等宽数字（这是设计要求，
> 比例字体跑数字会抖）。

| 屏上标签 | 含义 | 主值 | 单位/次级 |
|---|---|---|---|
| 输入频率 | FREQ IN | 会变的频率 | `HZ` |
| 倍频分频 | MULT/DIV | 会变 | `等效倍率` ／ `边沿率 4X倍频XF` |
| 转速 | SPEED | 会变的转速（**估算值**） | `RPM` ／ `估算值`（㉟ spec §7） |
| 角度 | ANGLE | 会变的角度 | `DEG` ／ `方向 CCW` |
| 累计转数 | REVS | 会变的圈数（**本次上电起算**） | `REV` ／ `Z计数` ／ `本次上电起算`（㉟ spec §7） |
| ABZ/UVW | ABZ/UVW | 会变 | （无静态脚注）|

> **v17 删掉了三条会过期的静态脚注**（`倍频64 分频1`、`电气频率 1600 HZ`、`A1 B1 Z0`）：
> 它们印的是旧默认值，与同一张卡片上的实时大字永远打架。静态版面里不许出现会变的量。

左侧竖排导航现在也是中文：**总览 / 波形 / 时序 / 设置**（v58 为 4 项；原 6 项里的 XY / 状态已随 P3/P5 删除）。

**先花 3 秒做配色自检（本次位流刚修过红蓝字节，这是唯一的验证点）**：

| 元素 | 现在应该是 | 若看到这个 | 说明 |
|---|---|---|---|
| 顶部状态栏底色 | **蓝色** `#2E7DD1` | 橙色 `#D17D2E` | 位流还是旧的（红蓝对调） |
| 左侧导航栏当前项高亮 | **浅蓝** `#8FC4EC` | 米色 `#ECC48F` | 同上 |
| 卡片数字/正文 | 深灰蓝 `#1F2D3D` | 明显偏暖、发褐 | 同上 |

红蓝对调**不影响**布局、文字、同步，只影响颜色，所以不专门看一眼就发现不了。

**看点：屏幕最右上角的状态指示灯。**

位置（`disp/disp_engine.v:437-438`）：**顶部**状态条（本实现高 24 px，cy 0..23）里 **x > 904** 的那一小块（约 119×24 px，就在右上角）。这块竖着分两半：

- **上半**（cy 0..11）：**编码器抽头活性灯**。抽头活着 → 绿；不活 → 橙。它会随抽头信号翻转而闪；**完全不动**说明抽头断线或编码器没时钟 —— 先别管触摸，去查编码器。
- **下半**（cy 12..23）：**触摸活性灯**，优先级更高，按颜色判读：

| 下半灯色（常量） | 触发条件（`disp/disp_engine.v:447-453`） | 含义 | 下一步 |
|---|---|---|---|
| **红** `C_FAULT` `#D9453D` | `q_tch_reads == 0` | I2C 主机一次都没跑起来 | **A** |
| **红** `C_FAULT` | `q_tch_timeout != 0` | 总线超时（SDA 被拉死或 SCL 被拖住） | **B** |
| **橙** `C_WARN` `#E08B2D` | `q_tch_nack != 0` | 从机不应答 | **C** |
| **蓝** `C_ACC` `#2E7DD1` | `q_tch_status == 0` 且以上都不成立 | 通信正常，但 `0x814E` 恒为 0（**本板历史现象**） | **D** ← 最可能是今天的结果 |
| **绿** `C_OK` `#3FA45B` | `q_tch_num != 0` | 检测到触点 | 正常 |
| **浅蓝** `C_SEC` `#8FC4EC` | 以上全不成立 | 通信在跑、当前无触点（**不闪 = 断线**） | 正常 |

> 判读顺序是**先看红**（主机根本没跑）→ **再看橙**（地址/接线）→ **最后看蓝**（通了但读不到数据，问题在触摸 IC 侧）。三种毛病的修法完全不同，所以先用一个灯把它们分开。

## 3. 第 2 步：按 KEY1 走完 5 页（v58）

按一次翻一页：**P1 → P2 → P4 → P6 → P7 → P1**（页号 0→1→3→5→6→0；按 5 下回 P1，第 6 下又到 P2）。
翻页键仍是板载 **KEY1 / Y9**；`KEY0`/W9 是全局复位。旧的 `ui_btn`(J5-29/H14) 仍并联可用，但要飞线。
**P3/P5/P8 不应再出现**；若还能翻到，说明烧的是旧位流。

> **顺带看一眼左侧导航的选中底色**：
> P1 高亮第 1 项 `总览`；P2 第 2 项 `波形`；P4 第 3 项 `时序`；P6 第 4 项 `设置`；
> **P7 不在导航栏（页号 6），4 项都不应高亮**。若 P7 仍高亮「设置」，是导航映射没改到 v58。

**判据**：5 页每页都有页名；按 5 下必回 P1；P3/P5/P8 不出现；无空白页/方块。

### 3.1 历史：P8 九个数（v58 已删除 P8，仅存档）

以下为 v57 及以前的步骤，v58 不再执行；保留用于对照旧照片/旧位流。
旧链（**已作废**）：按一次翻一页 **P1 → P2 → P3 → P4 → P5 → P6 → P7 → P8 → P1**。切到 P8（标题 `P8 触摸诊断`）后填下表。

> **旧版导航高亮判据（已作废）**：P1 高亮第 1 项 `总览`；P6 高亮第 6 项 `设置`；**P8 时任何一项都不应高亮**。

| P8 上的字段（屏上中文） | 实测 | 正常应该是 | 解读 |
|---|---|---|---|
| `触摸IC` | ________ | `GT9` | `GT9`=GT911、`FT5`=FT5206、`---`=两个地址都没应答 |
| `触点数` | ________ | `0` | 不碰屏就该是 0 |
| `读次数` | 第1次 ______ ／ 10 秒后 ______ | **持续增长** | ★ **整张测试单信息量最大的一个数** |
| `触点X0` | ________ | 不碰屏无意义 | 按下后应落在 0…1023 |
| `触点Y0` | ________ | 不碰屏无意义 | 按下后应落在 0…599 |
| `0X814E` | ________ | 不碰屏 `0`，按下后 **≥ 128** | `bit7`=坐标就绪、`[3:0]`=点数；**恒 0 就是历史现象** |
| `产品号` | ________ | `57`（0x39 = 字符 '9'） | `0` 说明总线被拉死；读得到说明 IIC 通了 |
| `无应答` | ________ | `0` | 锁定型号之后应一直保持 0 |
| `超时` | ________ | `0` | 同上 |

> **底栏三个数**（`中断电平` / `翻转` / `复位次数`，16 px 小字）本版**已经有数字了**（见 `docs/DEV_STATUS.md` U-10；上一版这里只有文字）：
> `中断电平` = INT 引脚当前电平（0 或 1）；`翻转` = 每完成一次有效触点就翻转一次（0 或 1）；
> `复位次数` = 触摸控制器 GC 复位计数低 4 位（0..15，会回绕）。
>
> 怎么用它们：
> - `翻转` 跟着"按住—抬起"变 ⇒ 触摸 IC 真的在产生触点事件（比只看 `触点数` 更灵敏）；
> - `中断电平` **不碰屏时应该是 1**，手指按住时变 0（INT 是低有效）。**恒为 0** ⇒ 中断线被一直拉低（`touch_int` 没接、或屏没插好）；**恒为 1** ⇒ IC 根本没报中断；
> - `复位次数` 若**自己在涨** ⇒ 控制器在反复重启，触摸就会时好时坏 —— 这一条以前在屏上完全看不出来。

**判据（只看这一组就能决定下一步）**：

- `读次数` **在涨** 且 `无应答 = 0` 且 `产品号 = 57` → **I2C 完全正常**，问题在触摸 IC 侧 → 走 **D**
- `读次数` **不涨** → I2C 层次的问题 → 走 **A**
- `读次数` 在涨但 `无应答` 也在涨 → 地址/接线 → 走 **C**

## 4. 第 3 步：有读数之后再按屏

手指按住屏，观察：

1. ~~P8 上 `触点数` 从 0 变 1…5，`触点X0 / Y0` 跟着手指走~~（v58 已删 P8，触点数不再上屏；直接看第 2 条的准星跟手即可）；
2. **任意页面上都有一根 2 px 蓝色十字准星（`#2E7DD1`）跟着手指**，优先级最高，会压在卡片和文字之上；
3. **抬起手指后准星必须在约 0.5 秒内消失**。实现细节（`disp/touch_ctrl.v:518-525`）：GT911 有时不产生"抬手"中断、状态字一直是 0，点数据会永远停在最后一帧（**老毛病：实测抬手后 `tch_num` 恒为 2、准星挂在屏上不动**）。本版的兜底是"连续 48 次空读（每次等 10 ms，≈0.48 s）就主动清 `tch_num`/`tch_valid`"。所以：抬手后准星**不是瞬间**消失，而是最多约半秒后消失。若超过 1 秒还赖着不动，就是没修干净。

| 现象 | 结论 |
|---|---|
| 准星动 + 点数动 | 触摸通了，可以做 P6 的编辑交互 |
| 点数动但准星不动 | 坐标判定或渲染有问题（查 `disp/disp_engine.v` 的 `tch_cross`） |
| 都不动但 `读次数` 在涨 | 回到 **D** |
| 都不动且 `读次数` 不涨 | 回到 **A** |

### 4.1 顺手验一下“点屏”（⑥ 新增，约 1 分钟；v58 更新）

⑥ 之前，左侧导航是**装饰**：画得出来，点不动。v58 屏上有 **10 个真正有落点的热点（6 张卡片 + 4 个导航项）**。**只做了单击**，长按/拖拽/滑动没有。

| 点哪里 | 预期 | 若没反应 |
|---|---|---|
| 左导航第 4 项 `设置` | 跳到 **P6**（高亮第 4 项） | 触摸没通，回到第 3 步 |
| 左导航第 1 项 `总览` | 回到 **P1**（高亮第 1 项） | 同上 |
| 左导航第 2 项 `波形` | 跳到 **P2**（4.3 专门验） | 见 4.3 |
| 左导航第 3 项 `时序` | 跳到 **P4**（4.5 专门验） | 见 4.5 |
| P1 第 1 行第 2 张「倍频分频」卡片 | 弹编辑面板（不翻页） | 见第 5 节的表 |
| P1 卡片 3「转速」 | 跳到 **P7 标定** | v58 双入口之一 |
| P1 卡片 6「ABZ/UVW」 | 跳到 **P4 逻辑时序** | v58 双入口之一 |
| P1 标题带「标定」 | 跳到 **P7 标定**（P1 上唯一的标题按钮） | 同上 |
| 状态栏原 ⚙ 处 / P4 原「展开」处 | **按设计没反应**（v58 已随 P8/P5 删除） | 这是预期，不是故障 |
| 点卡片以外的空白 | 没反应 | 预期 |

> **v58 易混点**：P1 卡片左沿是 x=96，与导航栏（x<80）之间留 16 px；点这条空白既不翻页也不改值。
> 旧版「卡片从 x=32 起、压住导航栏右半」的描述已作废。

### 4.2 顺手验一下「P6 的数字是不是活的」（⑦ 新增，约 1 分钟）

⑦ 之前，P6 那 9 个数字是**静态预置**的，而且预置值恰好等于复位默认值 —— 也就是说改没改设置，屏上都长一个样。现在它们每帧从 `disp_tap` 回读寄存器当前值重画，**改过的设置要能在 P6 上看见**。

| 操作 | 预期 | 若没反应 |
|---|---|---|
| 上电后直接切到 P6（**什么都不改**） | 倍频 `×256`、分频 `÷ 1`、极对数 ` 4`、迟滞 ` 0`、限幅 ` 0`、Z脉宽 ` 4`、Z相位 ` 0`、UVW相位 ` 0`、极性 `A+B+Z+U+` | 见下 |
| 先在第 5 步改一次倍频，再切到 P6 | 倍频那一格**跟着变**（`×256` → `×2` → `×4` …） | 回读通路没通 |
| 长按 KEY1 连续改几次，每次切到 P6 看 | 倍频一格**逐档跟着走** | 同上 |

> **两个易混点**。①**上电第一眼的 `×256` 是对的，不是 bug** —— 倍频寄存器 0 表示 256 倍（`rtl/abz_gen.v:285`），旧版屏上那个字母 `X` 开头的 `X64` 才是错的。②**数字与标签是两处契约**：标签在 `tools/gen_text_ram.py` 的 `P6_LAB`（格行 3/15/27、格列 6/26/46），数值列在 `disp/p6_view.v` 的字段表（格行 1/4/7、格列 3/13/23）—— 若看到**数字整体偏一格**（比如倍频的数字压到「分频」标签下面），那是两处对不上，不是回读坏了。（㊳ 起 P6 的标题行号已从 3/15/27 搬到 **4..8**（虚拟格网，一格一项），数值格行从 1/4/7 搬到 **1..5** —— 见 §4.30。）

> **极性那一格怎么读**：写的是 `A+B+Z+U+` 八个字符，含义是 「A 相未反相、B 相未反相、Z 相未反相、UVW 这组未反相」。`+` 未反相、`-` 反相。`uvwpol` 对 U/V/W **整组**生效，所以第 7 个字符是 `U`，它代表的是整组，不是「只有 U 相」。寄存器 0x010C 的 bit0/1/2/4 分别对应 A/B/Z/UVW。

### 4.3 顺手验一下「P2 波形页」（⑧ 新增，约 1 分钟）

⑧ 之前，左侧导航的 `波形` 点不动，也没有任何页面画波形。现在 P2 画**双通道时域波形**：上半 A 通道（y 100..320）、下半 B 通道（y 340..560），横轴是一帧 944 列，纵轴是该通道的满量程。v58 删掉 Tab 栏后波形上提 40 px，两块各 220 行。

| 看哪里 | 预期 | 若不对 |
|---|---|---|
| 点左导航 `波形` | 进 P2，左侧**第 2 项**高亮 | 命中判定 |
| A / B 两个方框内 | 各有一条**连续的**曲线（A 深蓝、B 深红），不接缝、不上下错位 | 见下 |
| 方框内那条水平细线 | 是**通道中线**（0 电平参考），与曲线同屏 | 正常 |
| 两个方框之间的空隙（y 321..339） | 是**页面底色**，不是白色绘图底 | 正常 |
| 接上信号源后 | 曲线随信号动，不是静止 | 信号源没接 |
| 不接信号源 | 两条**居中**的平直线（不是贴在顶边） | 见下 |

> **四个易混点**。
> ①**曲线中央有一条竖直接缝、上下两半来自不同的时刻** —— 这是双缓冲失效的典型样子（写面和读面撞上了）。本版 `disp/wave_ram.v` 用两块面、**只在帧首换面**，正常时不该出现。
> ②**整条波形横向平移 2 px** —— 那是文字通路（字符 RAM 一拍 + 字形 ROM 一拍）与波形通路的**管线级数没对齐**。本版用 `wave_d1 / wave_d2` 补了两级，仿真里专门有一条"第 100 列必须落在 x=180"的断言盯着它。
> ③**不接信号源时曲线贴着顶边或底边** —— 那是钳位生效了。本版把 ±32768 映射到 ±128 行（只占 200 行窗口的 64%），所以**接上信号源后**曲线应回到中间附近。贴边不是 bug，是**故意的**：留出余量之后，超量程会以"贴边"表现出来，而不是被缩放到看不出饱和。
> ④**P2 上不该再有 Tab 栏或徽标**：v58 已删 Tab（模拟/XY）与右下四枚徽标（VPP-PC / F-HZ / DT-US / DV-PC），底部「等效采样 100US」注记也一并删除。若还能看到其中任何一个，说明烧的是旧位流。P2 的标题/通道标注在 ⑰ 已补上。

### 4.4 历史：P3 李萨如 XY 页（⑨ 新增）—— **v58 已删除，仅存档**

> **v58 删除 P3（页 2）**：P2 的 Tab 栏（模拟/XY）、导航里的 `XY` 项、以及整张李萨如图都已移除。
> 本节步骤**不再执行**，只保留用于对照旧位流/旧照片。

点左侧导航 `XY`（第 2 项）进 P3，然后看四样东西：

| # | 看什么 | 应该是什么 |
|---|---|---|
| 1 | 页面中央 | 一个 **384×384 的方块**，里面是**点阵画出来的曲线**（不是一条线，是一串 2×2 的点） |
| 2 | 曲线形状 | **圆**（接上信号源之后）。两路样本是同一次标定后的 sin / cos，相位差 90°，所以 1:1 的 Lissajous 就是圆而不是 8 字 |
| 3 | 方块里 | **中心有一横一竖两条浅灰十字线**；没有信号时所有点都在**正中心**（屏上是中心的一个小点，不是一条长线） |
| 4 | 方块四周 | 点阵区外面还留一圈**浅色背景**，最外才是方框边 |

> ①**屏上是“点”不是“线”** —— 这是设计如此：位图是 192×192 的**格**，每格 2×2 像素，
> 曲线连续靠的是采样密度，不是连线逻辑。曲线看着“有毛边”是量化，不是画错。
>
> ②**不接信号源时是中心一个点，不是一条线** —— P2 的波形页那时是两条居中直线，
> P3 则是中心一个点，因为 XY 图的两个坐标都是 0。中心十字线仍在。
>
> ③**曲线贴着方块四边** —— 那是钳位生效了（`±32768` 映射成 `±128` 格，只占 192 格的 67%）。
> 接上信号源后应回到中间附近；贴边是**故意的**，与 P2 的 64% 同一个口径。
>
> ④**P3 的标题与轴标注已在 ⑰ 补上**；spec §4.4 的 Tab「模拟 / XY」的**控件**在 ⑳ 做了、**字面标签**到 ㊵ 才补上（模 / 拟 两个字那时不在字库，㊵ 把字库 +4 字之后屏上就是「模拟」），见 `docs/DEV_STATUS.md` 的 `U-15.7` 与 `U-44`。

### 4.5 顺手验一下「P4 时序页」（⑩ 新增，约 1 分钟）

按 KEY1 从 P2 再按一次进 P4（v58 链：P1 → P2 → P4 → P6 → P7 → P1；P3 已删）。

| 看什么 | 期望 | 不合就看 |
|---|---|---|
| 六条通道行 | 框 y=100..596、6 行 × 68 px；左侧色块 + 六行方波，行名 A/B/Z/U/V/W（色块只是加速识别，spec 5.2 要求颜色不是唯一编码） | 只有一片底色 = 页面没进去 |
| 波形形状 | 每行是一串**方波**，边沿竖直、箱宽约 **6.7 px**（⑱ 之后不再是一箱 4 px） | 看起来像随机噪声 = 等效采样没锁住，查 `disp/logic_scope.v` 的箱号换算 |
| 波形位置 | 轨迹**只画在右侧 856 px** 里（x ≥ 168），左边 88 px 的标签栏里**没有**波形线 | 标签栏里也有横线 = `lg_tband` 门控失效 |
| 时间轴 | 底部一条横线（y≈572）+ **8 根 45° 刻度**（轨迹宽 856 px，约每 107 px 一根） | —— |
| 页面文字 | `P4 逻辑时序` + 六条道标签（A/B/Z/U/V/W）+ `电角度`（⑰ 补上；⑱ 把通道字母挪到格列 8） | 整页没有文字 = 文字层门控退回上一版 |

**四个易混点**：

1. **波形不能对时间** —— 它是按**电角度**重建的等效采样图，不是示波器。转一圈画一遍，
   横轴是角度不是时间（spec §7.1）。屏上已注明「按电角度重建128箱等效采样」（㉞），**不是待办**。
2. **边沿疏密随倍频变化**：改大倍频后同一屏里电角度周期数变多，箱与箱之间的跳变会变多。
3. **波形与 P2 的横移无关**：P2 是 944 列的时间轴波形，P4 是**角域**波形（128 箱铺满 856 px、每箱 6.7 px），两者宽度与横轴含义都不同。
4. **像素级的"歪"没法用肉眼判 1 px** —— 三个实时页面的落点由 `disp/tb_pipe_align.v` 用连续光栅守住，
   上板只要看"有没有明显的接缝/错位"即可。

### 4.6 历史：P5 六状态表（⑪ 新增）—— **v58 已删除，仅存档**

> **v58 删除 P5（页 4）**，P4 的「展开」按钮也一起删除；下面步骤**不再执行**。

| 看什么 | 期望 | 说明 |
|---|---|---|
| 按板载 KEY1 能切到 `P5` | ☐ 是 ☐ 否 | 标题是 `P5 状态`；翻页顺序 P1→P2→P3→P4→P5→P6→**P7**→P8→P1 |
| 六行状态名与占比 | ☐ 是 ☐ 否 | 六行是 `U高 V低 W低` … `U低 V高 W高`（㊱ 起是汉字；此前是 ASCII 的 `U1 V0 W0`），每行右边有 `xx.x` 百分比 |
| 条形图随占比长短变化 | ☐ 是 ☐ 否 | 条形图在 x = 400..899，每行 32 px 高、中间隔 16 px 空行 |
| 底栏 `故障 000` / `111 PCT` | ☐ 都是 0.0 | 不是 0 说明换相或接线有问题（正常电机不该出现这两个状态）；㉓ 起 `BAD 000` 改称 `故障 000` |

> **四个易混点**：
> ① **占比是"时间占比"不是"角度占比"** —— 和 P4 的 128 箱等效采样不是一回事（P4 画边沿、P5 统计时间）；
> ② **条形图每行只填 32 px 高、下面留 16 px 空行**，看到"斑马纹"是设计如此，不是丢行；
> ③ **百分比列的前导零是空格**（` 20.0` 而不是 `020.0`），小数位永远显示（` 0.0`）；
> ④ 这一页**一个字都没有**或**整页花屏**都不正常 —— 前者查 `p5_lab_ram` 有没有被选到（页号 4），
> 后者查 `val_ch_raw` 的 P5 档有没有驱动源（协作记录 28 就是这么查出来的）。

### 4.7 顺手验一下「P7 标定与误差可视化」（⑫ 新增，约 2 分钟）

| 看什么 | 期望 | 说明 |
|---|---|---|
| 按板载 KEY1 能切到 `P7` | ☐ 是 ☐ 否 | 标题是 `标定与误差可视化`；v58 翻页顺序 P1→P2→P4→P6→**P7**→P1（第 5 下） |
| 左框两条曲线都在 | ☐ 是 ☐ 否 | 品红＝标定前、绿＝标定后；曲线区 x = 112..623，每箱 4 px |
| 右栏六个参数有数值 | ☐ 是 ☐ 否 | `OFS-S` / `OFS-C` / `GAIN-S` / `GAIN-C` / `PHASE-K` / `SHIFT`；GAIN 默认 32768 |
| `幅值` 有数值 | ☐ 是 ☐ 否 | 是 `s²+c²` 的原始值，标称约 **16384**（`0x4000`） |
| 触发一次标定后绿线变窄 | ☐ 是 ☐ 否 | 写 `0x0502` 的 start 位（**只发一帧**）；标定期间品红线冻结 |

> **五个易混点**：
> ① `幅值` 是 `amp_sq[30:15]` 的**原始十进制值**，不是百分比；标称约 16384，明显偏离说明增益/偏移没标定好；
> ② 纵轴是**固定**映射 `y = clamp(mag>>7, 0, 239)`，**不按帧自动归一化** —— 所以"带子变窄"是真的变窄，
>    不是纵轴被拉伸（自动归一化会让这两种情况在屏上长得一样，所以故意不做）；
> ③ 曲线画的是**每箱的 min/max 区间**（一条竖带），不是折线；128 箱 × 4 px = 512 px 铺满曲线区；
> ④ **刚上电时两条曲线都显示"标定前"的数据**（"后"bank 还是初始值）；触发一次标定之后绿色那条
>    才变成标定后的曲线 —— 这是设计如此，不是坏；
> ⑤ 整页空白：先确认页号是 6（v58 KEY1 第五下，链 0→1→3→5→6），再查 `p7_lab_ram` 有没有被选到（页号 6 的文字层）；
>    整页花屏：查 `p7_pair` 那一级流水（`disp_engine` 里两拍 RAM 的对齐）。

### 4.8 顺手验一下「版面不再压到导航栏」（⑯ 新增，约 1 分钟）

这一版把内容网格整体右移了 64 px：三列原点从 x = 32 / 352 / 672 改成 **96 / 416 / 736**
（96 = 导航栏 80 + 16 px 内边距）。根因是旧网格比 spec §4.1/§4.3 的规定左移了 64 px，
P1 的卡片和 P6 的文字都压在左侧导航栏上（P5/P8 已删除，不再涉及）。

| 看什么 | 期望 | 说明 |
|---|---|---|
| 左侧导航栏上**没有任何内容文字** | ☐ 是 ☐ 否 | v58 四项导航标签（总览/波形/时序/设置）背后是干净的导航底色；P6 的标签不再压进来 |
| P1 六张卡片整体右移 | ☐ 是 ☐ 否 | 卡片左沿约 x=96，与导航栏之间留出约 **16 px 空白**（旧版卡片从 x=32 起、压住导航栏右半） |
| P1 卡片里的数字不越出卡片右沿 | ☐ 是 ☐ 否 | 最长的是「输入频率」的 `1500.00`：旧版这一串右端伸出卡片 64 px，现在正好占满卡片宽（9 个数值格 = 288 px） |
| 点导航栏与卡片之间那条 16 px 空白 | ☐ 什么都不发生 | 既不翻页也不改值（旧版这一条算卡片命中） |

> **三个易混点**：
> ① **导航项的触控宽度仍是完整的 80 px**（spec §4.1 要求 ≥48 px 触控目标）；旧版在 P1 上被卡片
>    吃掉右半、实际只剩 32 px —— 这一版修好了，不用担心「点导航点不动」；
> ② P6/P7 **本来就没有卡片框**（卡片只画在 P1），这一版只是把它们的文字与数值右移；
>    看到「没有卡片」是设计如此，不是丢图；
> ③ 如果某个标签仍然贴到导航栏上，先核对 `disp/disp_engine.v` 的 `CARD_X0/X1/X2`、
>    `disp/val_format.v` 与 `disp/p6_view.v` 的 `f_col`、以及 `tools/gen_text_ram.py` 的
>    `P1_LAB`/`P5_LAB`/`P6_LAB`/`P8_LAB` —— 这几处是**同一份几何的多份抄写**，最容易改漏一处。

### 4.9 验「这一版修的四处」（⑰ 新增，约 2 分钟）

这一版只修实机照片上读出来的四处，几何一行未动。

> **v58**：本表涉及 P3/P5/P8 的行仅存档；P2/P4/P1 行仍可验。P2 底部的「等效采样 100US」注记在 v58 已删。

| 看什么 | 期望 | 说明 |
|---|---|---|
| P2/P3/P4 有页名与导航标签 | ☐ 是 ☐ 否 | 上一版这三页整页没有文字（状态栏左端空、左侧导航只剩一个高亮方块）。现在 P2 有 `P2 输入波形` + `A SIN` + `B COS` + `等效采样 100US`，P3 有 `P3 李萨如` + `Y`/`X` 轴标，P4 有 `P4 逻辑时序` + A/B/Z/U/V/W 六条道标签 + `电角度` |
| P5 表格第一行与底栏 | ☐ 第一行是真实占比、`故障 000` 是 0.0 | 上一版六行整体错一格，于是「第一行 U1 V0 W0」和 `BAD 000` 同时显示 99.9（占比合计超过 100）；㉓ 起该状态名写作 `故障 000`（㊱ 起第一行的状态列本身写作 `U高 V低 W低`） |
| P1 卡片上不再有陈旧脚注 | ☐ 是 ☐ 否 | 上一版在输入频率/转速/ABZ 三张卡上印着 `倍频64 分频1`、`电气频率 1600 HZ`、`A1 B1 Z0`，都与同一张卡的实时大字打架；现在只剩 `HZ`/`RPM`/`等效倍率`/`边沿率 4X倍频XF`/`DEG`/`方向 CCW`/`REV`/`Z计数` |
| P2 波形左侧不再是平线 | ☐ 是 ☐ 否 | 上一版两条通道各有一段约半个屏宽的直线（消隐期写的是同一个冻结样本）；现在从最左边就是正弦 |
| P8 触点数 = 0 时的坐标 | ☐ 已知现象 | `触点X0`/`触点Y0` 会显示上一次触点的坐标（GT911 保留值，`0X814E = 0` 表示没有新数据）。**这不是 bug** |

> **两个易混点**：① P2 的 `A SIN` / `B COS` 是**通道标注**，压在波形框的上沿 —— 曲线可能从字下面穿过，
> 属于设计（文字层最后合成，永远在最上层）；② 状态栏右上角那块**上半橙、下半蓝**是两条活性灯
> （编码器活性在闪 / 触摸 IC 在应答但没有新数据），不是配色 bug。

### 4.10 验「P4 加宽到 944 与 P2 四枚徽标」（⑱ 新增，约 2 分钟）

这一版动了两处版面：P4 时序图的绘图区从 600 px 加宽到 **944 px**（spec §4.4 的宽度），
P2 右下角补上 spec §4.4 要求的四枚徽标。

| 看什么 | 期望 | 说明 |
|---|---|---|
| P4 外框宽度 | 与其它页面的内容区**同宽**（x 80..1023），不再比别的页窄一截 | 上一版 P4 白框只有 600 px 宽（x 212..811） |
| P4 标签栏与轨迹区 | 左边 88 px 是标签栏（色块 + 通道字母 A/B/Z/U/V/W），波形**只画在右边 856 px** 里 | 轨迹区左沿在 x=168；标签栏里出现波形线就是 `lg_tband` 门控失效 |
| P4 波形的疏密 | 箱宽从 4 px 变成 **6.7 px**，同一屏里的边沿比上一版更**疏** | 这是摊箱换来的（分辨率变低），不是采样变差；箱数是采集侧上限，加宽只能摊箱 |
| P4 底部刻度 | 仍每 **128 px** 一根竖刻度（856 px 里 7 根），不是每箱一根 | 刻度跟着轨迹区走 |
| P2 右下四枚徽标 | 一行标签 `VPP-PC` / `F-HZ` / `DT-US` / `DV-PC`，**下面一行是实时数值**（形如 `  39.6`） | 标签在文字层第 35 格行（静态），数值在第 36 格行、每帧刷新 |
| P2 四枚是"真值" | 值随信号变；不接信号源时四枚都显示 `0.0` | 显示侧自己量遥测样本，不动 `rtl/`、不新增遥测带宽 |
| P2 四枚的排布 | 四枚等距、最右一枚贴着内容区右沿，不挤成一串 | 上一稿六格字段配六格节距会连成 `VPP-PCF-HZ`，改成 10 格节距 |

> **两个易混点**：① 四枚的算式在 `disp/p2_badge.v` 里 —— `VPP-PC`/`DV-PC` 是峰值差占**波形窗**
> （200 行满量程）的百分比（±32768 打满就是 `100.0`），`F-HZ` 量的是**过零频率**（首末过零的
> 时间差 ÷ 过零数），`DT-US` 是 A 上升过零到其后第一个 B 上升过零的平均间隔；它们与 P1 卡片上
> 那些实时大字**不是同一来源**。② 过零时刻取的是**采样区间中点**，100 µs 采样栅格下 `DT-US`
> 有 ±50 µs 的抖动，属于设计（取新样本那一拍会系统性偏 +50 µs）。

### 4.11 验「P6 设置页 12 项 + 危险区二次确认 + 状态栏三入口」（⑲ 新增，约 3 分钟）

这一版补的是 spec §4.4 / §4.6 / §6.4 里明文的缺口：P6 设置页补满 12 项、底部危险区带二次确认、
状态栏右端三个入口。

| 看什么 | 期望 | 说明 |
|---|---|---|
| P6 的项数 | **3 列 x 5 行 = 15 项**（㊳ 起补第五行 `增益S` / `增益C` / `相位修正`，项高字面 88 px） | ⑲ 那轮是 3 列 x 4 行（12 项）；㊳ 之前是 128 px 档距 |
| P6 第 4 行的值 | `ON` / `OFF`（ABZ、UVW 使能），`S0C0` 形式（粗调移位的 ss/cc） | 三项都取自 `disp_tap` 上本来就有的位，没有新寄存器 |
| P6 底部危险区 | 944×96 的红框横条 + 警示三角 + `清除锁存故障` 按钮；按钮框 64 px 高、命中框 ±8 px = 80 px | 区域 y **504..599**（㉝ 起为 96 px），框由 `disp_engine` 画，文字来自文字层第 34 格行（y 544..559，中心 552 = 区域中心） |
| 按住危险区按钮 | 按钮里侧 10 px 处出现一道 2 px 红**内框**（按下反馈），**这一拍不弹询问态**、寄存器一个字节都不写 | spec §5.2 要求状态不能只靠颜色，所以反馈用形状；㊲ 起「按下」与「发声」分家 |
| 在按钮内松开 | 松开那一拍才弹**模态对话框**（整屏变暗 + 红框对话框 + `清除锁存故障` + `REG 0X0405` + `CANCEL` / `OK`），不是直接清故障 | spec §6.4 要求二次确认；模态期间点别处**什么也不该发生**；按住后滑出按钮再松开则**不受理** |
| 按 `CANCEL` | 关闭对话框、**不写寄存器**（P6 上四行数值一个都不变） | 没确认就不许动寄存器 |
| 按 `OK` | `OK` 底色变浅红 → 写 `0x0405 bit0 = 1` → 关对话框 | 只发一条命令、**不回滚**（W1C 不能走回读校验） |
| 状态栏右端 | `[信号●]` `[告警▲]` `[系统⚙]` 三个图标；⚙ 在 x 896，最右是活性灯（x 960） | 三个都是几何图形（字库没有对应汉字） |
| 点 `⚙` | 跳到 **P8**（页名 `P8 状态`，左侧导航**没有任何一项高亮**） | spec §4.1 规定的 P8 入口；上一版只能靠短按 KEY1 连翻七次 |
| 点 `●` / `▲` | **不翻页**（它们是指示器：● 跟触摸链路灯色、▲ 跟告警色） | spec §4.1 只把 ⚙ 算作入口 |
| P1 不受影响 | 在 P1 上点屏幕下半部仍然是卡片（危险区只在 P6 生效） | 同一块面积在 P1 是卡片 11/12，按坐标 + 页号判才不出错 |

> **两个易混点**：① 对话框是**真模态** —— 它压过 `compose` 里所有层（连触点半字准星都被遮住），
> 被挡住的下层控件一个都不响应；如果模态开着还能点到底下的导航或卡片，那“二次确认”就不算数。
> ② `[信号]` / `[告警]` 长得像入口但**不是**按钮（spec §4.1：顶层目的地 4 个，溢出入口只有状态栏
> 的 ⚙ 与卡片下钻）；点它们没有任何页面变化是设计，不是坏了。危险区按钮**只在 P6 生效** ——
> 那条横条在 P1 上与卡片 11/12 重叠，所以改由策略层按坐标 + 页号判。

### 4.12 验「P2/P3 页内 Tab + 标题带按钮」（⑳ 新增，约 3 分钟）

这一版把"spec 写了入口、屏上却没有"的三处补上：P2/P3 的页内 Tab、标题带的主操作按钮
（P1「标定」/ P4「展开」—— ㊵ 起按 spec 字面），以及 P7 入口的语义修正。

| 看什么 | 期望 | 说明 |
|---|---|---|
| P2 顶部 | 两个页签：左边「模拟」**选中**（白底 + 蓝边）、右边 `XY` 未选中（浅蓝底 + 浅灰边） | 页签区 y 96..136；上一版这两页顶部整片空白 |
| P3 顶部 | 同一对页签，但**右边 `XY` 选中**、左边「模拟」未选中 | 与 P2 共用同一对矩形，靠页号决定谁选中 |
| 点 P2 的 `XY` | 切到 P3 | 页内导航，不动左侧导航 |
| 点 P3 的「模拟」 | 切回 P2 | |
| 左侧导航「XY」 | 仍然直接到 P3（与页签**双路径**） | 有意保留，见下面易混点① |
| P1 标题带按钮 | 左上角附近一块白底蓝边矩形，里面是「**标定**」；点它进 **P7 标定** | 上一版只有点卡片 3 能进 P7，而卡片 3 上写的是「转速」 |
| P4 标题带按钮 | 同一位置一块矩形，里面是「**展开**」；点它进 **P5 六状态明细** | spec 要"点表格标题「展开」"：㊵ 起字库已有这两个字，屏上就是 spec 字面（v20..v44 前是 ASCII `EXPAND`） |
| P2 / P4 上不该有的东西 | P2 上**没有**标题带按钮（那块位置是底色）；P4 上**没有**页签 | 两个方向都判，避免按钮漏了页号守卫 |
| 点卡片 3（转速） | **不再**跳 P7（P7 只走标题带按钮） | spec §4.5 把卡片 3 定为转速，点它跳标定是旧版的口径错位 |

> **两个易混点**：① 页内 Tab 与左侧导航的「XY」**是双路径、都在生效** —— 不是重复实现，
> spec §4.1 要求左侧导航常驻（导航入口不能被隐藏），Tab 是页内层级的补充。
> ② 标题带按钮**是一块矩形跨页复用**（P1「标定」/ P4「展开」），文字来自各页自己的文字层、
> 由策略层按页号分派；所以它在 P2/P3/P5/P6/P7/P8 上**没有任何反应是设计**，
> 想加就得先在策略层补 `page` 守卫（`disp/disp_engine.v` 的 `tb_page` 与
> `disp/hit_test.v` 的 `TBTN_*` 是两处共同契约）。

### 4.13 验「P4 45° 刻度 + P5 表格与刻度 + P7 百分比」（㉑ 新增，约 3 分钟）

这一版把三处「图上有数据、却没有标注/刻度」的地方补齐：P4 时间轴的整度刻度、
P5 的表格框与占比刻度、P7 幅值列的百分比。

| 看什么 | 期望 | 说明 |
|---|---|---|
| P4 时间轴下面 | 8 个整度数字 `0` `45` `90` `135` `180` `225` `270` `315` | 格列 10/16/23/29/36/42/49/56；上一版这一行只有「电角度」三个字 |
| P4 刻度线 | 每条数字**正上方一根短竖线**，等间距 8 根 | 上一版是每 128 px 一根（≈53.8°），与整度对不上 |
| P4 图上注明 | 轨道区左下角一行 `按电角度重建128箱等效采样`（14 格） | spec §7 数据来源表要求图上注明口径；㉞ 起字库补齐「按 / 重 / 建 / 箱」4 字，按规范原话写全 |
| P5 表格 | 六行外面**有框**，行与行之间**有 5 条分隔线** | 分隔线落在两行文字之间的空档，不压字 |
| P5 条形区 | 25% / 50% / 75% 三根**浅蓝竖线**，每行下面有 `0` / `50` / `100` | 刻度是「底」、填充条是「面」：填充会盖住刻度 |
| P5 框底 | 框底在「`故障 000` / `111 PCT`」那一行**之上**，横线不穿过字 | 框底 y = 305；本来取 321，会从 `111 PCT` 上穿过去（㉓ 起左端状态名是 `故障 000`） |
| P7 `幅值` 行 | 显示成**百分比**（如 `  82.4`）且后面有 `PCT` 单位 | 上一版是 `amp_sq[30:15]` 的原始整数，看不出正常范围 |
| P7 百分比很小 / 为负 | 出现负号（如 `- 33.3`），或门限配错时显示 `999.9` | 0.0% = `0x0520` 下限、100.0% = `0x0524` 上限；夹紧是为了屏上不出现 X |

> **两个易混点**：① P4 的刻度数字与刻度线**是两处契约**（文字层格列 vs RTL 的 107k 判据），
> 少改一处就会出现「数字与线差半格」；16 px 格网下最大差 7.5 px 属正常（见 `DEV_STATUS.md` 的 `U-25.7`）。
> ② P7 的百分比**跟着 `0x0520`/`0x0524` 走** —— 在 P6 上改这两个门限，屏上的百分比会立刻换尺度，
> 这不是 bug。

### 4.14 验「倍频编辑面板 + 长按/拖拽 + 回到上一次值」（㉒ 新增，约 5 分钟）

这一版把 P1 卡片 2 从「点一下就改」改成「弹出编辑面板、按 APPLY 才写、写完回读确认」。

| 看什么 | 期望 | 说明 |
|---|---|---|
| 点 P1 卡片 2（整卡可点） | 下半屏弹出面板：`倍频分频` 标题、`[−]` / `[+]`、8 档滑条、`CANCEL` / `APPLY` / `回到` | 面板只占下半屏，上半屏波形继续刷新（spec §4.5） |
| 卡片 2 的主值 | 弹出后先显示**当前回读值**，改档后显示**待应用值**（如 `×128 ÷1`） | spec §6.2 / `docs/13:267`：只有面板开着才显示待应用值 |
| 点 `[−]` / `[+]` | 每次一档（2 / 4 / 8 / 16 / 32 / 64 / 128 / 256），两端夹住不绕回 | 点按永远是入口（§6.5） |
| 按住 `[+]` 不放 | 约 0.6 s 后走第一档，之后每约 0.2 s 一档；按钮**内侧**有一圈进度环 | 进度环沿按钮周长走（不是真圆环，见 `U-26.7`） |
| 滑条上按下并拖动 | 直接吸附到对应档（8 档等距，每档 64 px） | 拖到哪档就是哪档 |
| 点 `CANCEL` | 面板收起，**寄存器一个字节都没写**（主值回到回读值） | spec §6.5：「取消」= 不写寄存器 |
| 点 `APPLY`（值改过） | 先显示应用中，成功后收起；卡片 2 的值变成**回读确认过**的新值 | 失败会自动回滚（`ui_edit` 的回读比较） |
| 点 `APPLY`（值没改） | 直接收起，不产生写入 | 避免无效写 |
| 改完之后点 `回到` | 把**上一次被回读确认过的值**写回去（不是面板打开前的旧值） | §6.5 的「回到上一次值」；再点一次会互换回去 |
| 没有「上一次值」时 | `回到` 压暗（灰），按下不发任何字节 | 上电后没写过值就是这种状态 |
| 面板开着时 | 翻页（左侧导航）、状态栏三个入口、标题带按钮、页内 Tab **都不响应** | 模态：先 `CANCEL` / `APPLY` 或点面板外空白收起 |

> **两个易混点**：① 卡片 2 的主值在面板开着时显示的是「待应用值」—— 这是 spec §6.2 明确要求的
> （屏幕可以显示用户想要的理想值，但只能显示在"待应用"语境里；一关面板立刻回读值），
> 不要当成"写失败"。② `回到` 写回的值**也要过两阶段提交** —— 编码器那边若拒收，
> 面板会退回原值并保持「上一次值」不变；这与"撤销"不同：撤销是根本不写。

### 4.15 验「字库扩容：lab 码 8 bit」（㉓ 新增，约 3 分钟）

这一版把 **lab 平面字符码从 7 bit 升到 8 bit**（47 ASCII + 89 汉字 = 136 码；㉔ 又补了 `↩` ⇒ 137 码），
字库末尾补了 `%` `×` `÷` 三个符号与 `正常/警示/故障/回到` 四个词，
于是「汉字状态名」「百分比号」「乘除号」第一次能真的写在屏上；
同时修掉一个真缺陷：**面板关着时，面板那两行标签也会被画在卡片上**。

| 看什么 | 期望 | 说明 |
|---|---|---|
| P5 底栏那个退化状态 | 左边是 `故障 000 PCT`（原来是 ASCII 的 `BAD 000 PCT`） | 汉字状态名第一次上屏 |
| P5 刻度行 | `0%` / `50%` / `100%`，百分号紧贴数字 | 满量程 500 px：0% 在 x = 400、100% 在 900 |
| P7 右下「幅值」那一行 | 数值后面紧跟 `%`（原来写的是 `PCT`） | 百分比口径跟 `0x0520` / `0x0524` 走 |
| P1 卡片 2 的主值 | `×64 ÷1`（真乘号/除号，原来用字母 `X` 与 `/` 当替身） | 规范 §4.5 的写法 |
| P1 底部编辑面板右侧按钮 | 写 `↩ 回到 ×N`（原来是 ASCII 的 `BACK`，㉓ 起先只写死 `回到`） | §6.5；动态的那一位见 §4.16 |
| **面板关着时**（本轮重点） | P1 上**不该**出现 `倍频分频` / `PRESET` / `CANCEL` / `APPLY` / `回到` / `↩` 中的任何一行 | ㉓ 修掉的真缺陷：这两行只在面板打开时画 |

> **易混点**：① 码宽从 7 bit 升到 8 bit 是**整片文字层**的改动。屏上若出现方块/错字/串字，
> 先怀疑字模与码宽（`disp/font_rom.v`、`disp/text_ram.v`），而不是触摸链路。
> ② `正常` / `警示` 两个字模本版先备着，界面上暂时看不到 —— 那是留给 P5「5 列状态名」（㊱ 起 P5 的状态列本身已经是汉字，但这两个字仍未上屏）
> 那一项真要重排时用的（见 `DEV_STATUS.md` 的 `U-27.7`）。

### 4.16 验「面板上的 `↩ 回到 ×N`」与 `×`/`÷` 一致（㉔ 新增，约 4 分钟）

这一版把编辑面板右侧那个按钮从写死的 `回到` 改成**动态显示"上一次值"**（spec §6.5），
并把屏上剩下的 ASCII `X` / `/` 换成真乘号/除号（字库新补了 `↩`，lab 码 8 bit 下共 137 码）。

| 看什么 | 期望 | 说明 |
|---|---|---|
| 面板右侧按钮（**有记忆**时） | `↩ 回到 ×N`，乘号**紧贴**数字左边，前导零不写 | N = 上一次被回读确认过的倍频 |
| 复位后第一次打开面板 | 看到 `↩ 回到 ×256` | 倍频编码 `0` 当 ×256（`rtl/abz_gen.v:285`） |
| 走一次 `[+]`/`[−]` 但**不** APPLY | 按钮上的 N **不变** | 记忆只跟"回读确认过"的值走 |
| 按 `APPLY` 成功后再打开面板 | N 变成刚写进去的那个倍频 | 与 ㉒ 的「两次 `回到` 互换」是同一个记忆 |
| 面板刚上电 / 没有记忆时 | 按钮上**只有** `回到`（没有 `↩`、没有 `×N`），按钮压暗 | `pnl_undo_avail = 0` 时不发任何字节 |
| `↩` 字形本身 | 左箭头 + 右侧一竖，**不是**方块/空白/串字 | 字库索引 47（lab 平面第 48 个 ASCII） |
| P6 上倍频/分频两行 | 前缀是 `×` `÷`（不是字母 `X` 与 `/`） | spec §4.4 的写法，与 P1 卡片 2 一致 |
| P1 卡片 2 的脚注（`倍频分频` 卡底部） | `边沿率 4×倍频×F`（两个都是真乘号） | 原来是 `4X倍频XF` |

> **易混点**：① `↩` **只进 lab 平面**（标签/汉字那一层）；32 px 大字走 val 平面、索引只有 6 bit，
> 放不下第 48 个字符 —— 所以别指望在卡片的大数字里看到 `↩`。
> ② 面板**只显示倍频、不显示分频**：面板从头到尾都不改分频（`disp/ui_panel.v:316` 原样带回），
> 显示 `÷M` 纯噪声，这是**有意偏离** spec 的字面写法（记在 `DEV_STATUS.md` 的 `U-28.7`）。

### 4.17 验「长按进度的真圆环」（㉕ 新增，约 3 分钟）

这一版把 U-26 当时"如实记偏离"的**矩形**进度环换成**真圆环**（spec §6.5「配环形成进度反馈」）：
环带 26..30 px、64 扇区 × 5.625°、12 点方向起顺时针；扇区表是 `disp/ring_lut.v`
（32×32 折叠、1024 × 5 bit ≈ 0.62 KB，由 `tools/gen_ring_lut.py` 生成）——
**没有乘法器、没有 CORDIC、没给像素流水线加级**。

| 看什么 | 期望 | 说明 |
|---|---|---|
| 按住 `[−]`（或 `[+]`）不放 | 按钮内出现**圆弧**，从 **12 点方向**起、**顺时针**生长 | `pnl_prog` 0..63；起手 0.6 s、之后每 0.2 s 一档 |
| 环的形状 | 是**环带**：圆心附近没有像素 | 半径 26..30 px（4 px 厚），既不是实心圆也不是矩形 |
| 一直按住到顶 | 环**闭合成整圈** | `pnl_prog = 63` 补最后一格（满格一定是整圈） |
| 松手 | 环**立刻消失**，按钮回未按下态 | 环只在按下期间画 |
| 按住时的按钮本体 | 描边变强调蓝、按钮底变浅蓝 | 与环同时出现（`pnl_press`） |
| **短按**（< 0.6 s） | 不出现环、不加速，但松手仍走一档 | spec §6.5：长按**不得**作为唯一入口 |
| 圆弧的连续性 | 从 12 点经 3 点、6 点、9 点回到 12 点，**不跳格、不缺口** | 64 个扇区、每扇区 ≥ 9 px，覆盖完整 |

> **易混点**：① 环的"未点亮"半圈与按下态的按钮底色**同色**，所以看不见 —— 这是有意的
> （进度表达"亮了多少"），不是渲染坏了。② 环**只对两个步进按钮**出现；滑条拖拽没有环。
> ③ 若验收要求"从按下的位置起飞"或"逆时针"，那是生成器里的一条参数
> （见 `DEV_STATUS.md` 的 `U-29.7` 第 1 条），不是缺陷。④ 眼睛看不清时看预览件
> `_disp_work/page_p1_panel_ring.png`（按住 `[−]`、进度 32/64）。

### 4.18 验「P5 六状态表按 spec 重排：30 px 行距 / 188 px 列宽」（㉖ 新增，约 4 分钟）

这一版把 P5 的表格从"16 px 文字格网下的近似"（U-25：6 行 × 32 px 半格、条形区 x 400..900）
改成 spec §4.4 的字面几何：**6 行 × 5 列、行高 30、列宽 188**（表框 x 82..1022、y 128..338）。
表格区走一套**页号限定**的虚拟格网，其余七页一个像素不动。

| 看什么 | 期望 | 说明 |
|---|---|---|
| 表格外框 | x 82..1022、y 128..338 的矩形（灰蓝细线） | 列宽 188 × 5 = 940 px、行高 30 × 7 = 210 px |
| 行数 | **表头 1 行 + 数据 6 行 = 7 条行带**（行分隔线 y = 158/188/218/248/278/308） | 每个状态一行，行距 **30 px**（不是 16/32） |
| 列数 | **5 列**（列分隔线 x = 270/458/646/834） | 列宽 **188 px** |
| 五列内容 | ①序号 `1..6` ②状态 `U高 V低 W低`…（㊱ 起；此前是 ASCII） ③次数 ④占比 `dd.d` ⑤条形图 | 第 5 列是比例条，不是数字 |
| 条形图列 | 槽底色浅蓝、5 条竖刻度线（0/25/50/75/100%）、填充强调蓝 | 刻度线 x = 836/881/927/973/1019；满量程 184 px |
| 条形长度与占比一致 | 占比 `dd.d` 与条形长度同源（都是 permille × 188 / 1024） | 两边不会打架 |
| 两个退化状态 | 在表格**下方**的脚注行（`故障 000 PCT` / `111 PCT`） | 它们原来是底栏，表格变高后挪到 y ≈ 352 |
| 其余七页 | **一行都没变**（P1..P4、P6..P8 的版面与像素判据全过） | 重映射是页号限定的 |

> **易混点**：① 每列 11 个字符格、但**只用到 0..10 格**，最右 12 px 是留白（188 = 11×16 + 2×6）。
> ② 行带里 16 px 字高居中，上下各留 7 px（30 = 16 + 2×7）——字看起来"比行距小"是正常的。
> ③ 条形刻度线**没有数值标签**（188 px 里放不下），数值看第 4 列的 `dd.d`。
> ④ 眼睛看不清时看预览件 `_disp_work/page_p5.png`（与 RTL 同一套映射，逐格同源）。

### 4.19 验「状态字模上屏：六卡迷你状态条 + ●/▲/✖ 字形」（㉗ 新增，约 3 分钟）

这一版给 P1 的六张卡片各加了一条**迷你状态条**：卡片底部一行「● 正常 / ▲ 警示 / ✖ 故障」，
符号与汉字都出自字模 ROM（**不是**画的图形）。六张卡片各看**自己的**量：

| 看什么 | 期望 | 说明 |
|---|---|---|
| 卡片 1 输入频率 | 两路任一路告警时变 `▲ 警示`（`io_flags[0]`）、拉闸时 `✖ 故障`（`io_flags[1]`） | `lag_warn` / `lag_fat` |
| 卡片 2 倍频分频 | `stat[3]` 置位时 `▲ 警示` | `inclim`（限幅中） |
| 卡片 3 转速 | `io_flags[7]`（幅值坏）⇒ `✖ 故障`；`stat[5]` ⇒ `▲ 警示` | `scamp` |
| 卡片 4 角度 | `io_flags[6]`（相关器饱和）⇒ `✖ 故障`；`stat[0]`（溢出）⇒ `▲ 警示` | `oflow` |
| 卡片 5 累计转数 | `stat[2]` 置位时 `▲ 警示` | `laglim` |
| 卡片 6 ABZ/UVW | ABZ 与 UVW **两路都没使能** ⇒ `✖ 故障`；只有一路或 `io_flags[3]`（UVW 频率告警）⇒ `▲ 警示` | `abzen` / `uwven` / `uvw_warn` |
| 状态条位置 | 上排三卡在卡片内 y 240..255、下排三卡在 y 576..591；**在 48 px 数值与次级信息之下** | spec 的 y+148 是给 300×264 卡片算的，本工程卡片 288×256 |
| 三个符号的字形 | `●` 是圆盘、`▲` 是三角、`✖` 是**加粗的叉**（每边 2 px 宽） | 细的叉会与字母 `X` 逐点相同，字库判据会报 identical |
| 面板开着时 | 状态条与面板互不干扰：写口优先给面板，`stat_chip` 那一拍停写、下一帧补上 | 两者共用一个 lab 写口 |
| 其余七页 | 一行都没变（既有 21 个测试台的几何判据全过） | 字符码只在表尾追加 |

> **易混点**：① `✖ 故障` 的 `✖` 比字母 `X` 粗，这是**故意的**（细叉与 `X` 逐点相同）。
> ② 卡片底部那一行**静态兜底也是「● 正常」**，所以"复位后看到 ● 正常"不能证明状态机在跑 ——
> 要换告警条件才有区别（这也正是端到端判据要改遥测的原因）。③ 状态条用的是 16 px 全局格网，
> 行距不是 spec 的 24 px（见 `DEV_STATUS.md` 的 `U-31.8` 第 3 条）。
> ④ 眼睛看不清时看预览件 `_disp_work/page_p1.png`（与 RTL 同一份版面表）。

### 4.20 验「状态字模第三重：六卡状态条反转视频（白字 + 状态色底）」（㉘ 新增，约 3 分钟）

这一版让「异常」在**余光里也看得见**：某张卡的状态只要不是「正常」，它的状态条那 4 个格
（64 × 16 px）就整块翻成**状态色底 + 白字**（警示 = 橙 `#E08B2D`、故障 = 红 `#D9453D`，
白字就是原来的字形位置换成白色）。

| 看什么 | 期望 | 说明 |
|---|---|---|
| 正常态（刚上电） | 六张卡都**没有色块**，只有黑字 `● 正常` 压在卡片白底上 | 正常不反转；主预览图 `page_p1.png` 就是这个状态 |
| 警示态 | 那张卡的状态条变**橙底白字** `▲ 警示` | `C_WARN = 24'hE08B2D` |
| 故障态 | 那张卡的状态条变**红底白字** `✖ 故障` | `C_FAULT = 24'hD9453D` |
| 色块的范围 | 只盖住状态条那一行（64 × 16 px），**不压 48 px 大数字**、不串到隔壁卡 | 六段矩形与状态字模同源 |
| 同屏多状态 | 可以有卡是正常、卡是警示、卡是故障，各按自己的位判定 | 判据来自 `stat_chip` 的 `chip_st` |
| 面板开着时 | 第一排三张卡的状态条仍然正常显示（面板矩形从 y 320 起，第一排在 y 240..255） | 第二排会被面板盖住，这是模态使然 |
| 其余七页 | 一个像素都不变（`scbar_any` 带页号门控） | 只动 `with_txt` 那一层 mux |

> **易混点**：① 色块会与卡片的左/下边框齐平（压住 1 px）—— **故意的**，像一枚贴在卡上的标签。
> ② 正常态「没有色块」是判据的一部分（不是"没做"）：要看到色块必须先造出告警/故障条件。
> ③ 白字与黑字**逐像素同位置**，所以「字变白了」不会让版面跳动。④ 眼睛看不清时看预览件
> `_disp_work/page_p1_chip.png`（与 RTL 同一份判据画的演示状态）。

### 4.21 验「状态字模第四重：可关闭的 2 Hz 闪烁 + P6 标题带复选框」（㉙ 新增，约 3 分钟）

| 看什么 | 期望 |
|---|---|
| P6 标题带右侧那颗按钮 | 里面有一个 16 × 16 的复选框：**实心 = 闪烁开**（默认），点一下变 **空心 = 关** |
| 正常态那几张卡 | 状态条仍是黑字 `● 正常`，**永不闪**（正常态不参与闪烁） |
| 造出告警/故障之后 | 对应那张卡的状态条在「橙/红色块 + 白字」与「黑字常态」之间翻转，约每 **0.51 s** 换一次（1.9529 Hz，肉眼接近每秒两次） |
| 把复选框点成空心（关）以后 | 立刻停在**常亮的色块 + 白字**（不是退回黑字）—— 关掉的是闪烁、不是反转 |
| 其余七页 / 面板开着时 | 一行没变；面板开着时第一排三张卡的状态条仍正常 |

> **易混**：① 闪烁只发生在「警示 / 故障」那几张卡上，正常卡的 `● 正常` **不该闪**；② 「关」的语义是「不闪」而不是「不反色」—— 关掉后仍然是色块 + 白字；③ 频率是 15 帧量化出来的 **1.9529 Hz**，不是精确 2 Hz（spec 只写「2 Hz」）；④ 开关状态要能**一眼看出**（实心 / 空心），别只靠颜色深浅。
> 眼睛看不清时看预览件：`_disp_work/page_p6.png`（复选框实心 + 「闪烁」标签）与 `_disp_work/page_p1_chip.png`（反转态的色块 + 白字）。

### 4.22 验「数字键盘兜底（spec §6.3）：12 键 + 三位七段」（㉚ 新增，约 4 分钟）

| # | 动作 | 期望 |
|---|---|---|
| 1 | P1 上长按 KEY1 打开「倍频分频」编辑面板 | 面板出现在屏幕下半（x 96..928 / y 320..592） |
| 2 | 看面板右上角（约 x 856..920 / y 392..456） | 有一颗 64×64 的「键盘」按钮，图标是 12 个点的键盘形 |
| 3 | 点它 | 面板换成键盘：左上 3 列 × 4 行键（`1 2 3 / 4 5 6 / 7 8 9 / ← 0 ↵`），右上是 3 位大数字窗口，`[−]/[+]` 与滑条消失 |
| 4 | 看输入窗 | 显示的是**当前回读值**（默认 64），前导零不显示 |
| 5 | 依次点 `2` `5` `6` | 输入窗依次变成 `2` → `25` → `256`（右对齐、前导零不显示） |
| 6 | 再点任意一个数字键 | **什么都不变**（2566 越界，按键不接受；屏幕不许显示用户没敲的值） |
| 7 | 点 `←`（退格）两次 | 变成 `2`（每次退掉最后一位） |
| 8 | 点 `↵` | 键盘收起、回到面板，值进入「待应用 黄」——**寄存器还没写** |
| 9 | 点 `APPLY` | 写入并回读，面板收起；重新打开面板/键盘时输入窗是刚才那个值 |
| 10 | 键盘里点 `CANCEL` | **只退一层**：键盘收起、面板还在；再点一次才收面板 |
| 11 | 键盘里按住某个数字键不放 | 该键高亮（蓝框），但**不连击**（松手才输入一位） |
| 12 | 键盘开着时切到别的页（J5-29 或 KEY1）再回来 | 键盘自动收起（跨页不留悬挂模态） |

> 易混点四条：① 键盘里的数字是**画出来的**（七段图形），不是字库字形 —— 所以「字模缺字」这类问题不会出现在这里，反过来 `disp/seg7.v` 的几何错了也只在这里露馅；② `[−]/[+]` 在键盘模式下**故意失效**（点它们不会有反应），这是设计而不是坏键；③ `CANCEL` 的两级语义：键盘里退键盘、面板里退面板；④ 键盘只覆盖 `inter`（2…256），`div` 仍是 8 档步进（spec §6.3 对 `div` 就是这么要求的）。

### 4.23 验「P8 系统信息 / 自检（spec §4.4）：设备 ID / 固件版本 / 链路统计 / 资源占用」（㉛ 新增，约 3 分钟）

| # | 操作 | 期望 | 实测 |
|---|---|---|---|
| 70 | 从状态栏点 ⚙ 进第 8 页 | 页标题是 **`P8 系统信息`**（不再是「触摸诊断」）；三行标签是 `设备 ID / 固件版本 / 触摸 IC`、`IIC 读 / 无应答 / 超时`、`LUT % / BRAM % / DSP %` | ☐ 是 ☐ 否 |
| 71 | 看第 1 行的三个值 | `设备 ID` = **`ENCC1`**、`固件版本` = **`V55`**（显示侧常量 `FW_MAJ/FW_MIN`，随位流版本走 —— 旧版写死 `V35` 一直到 v46，见 U-48）；`触摸 IC` = 实际型号（`GT9` / `FT5` / `---` 三选一，未知型号时是 `---`） | ☐ 是 ☐ 否 |
| 72 | 看链路统计与资源占用 | `IIC 读` 随触摸活动增长、`无应答` 与 `超时` 在正常通信下保持 0；`LUT % / BRAM % / DSP %` = **70 / 41 / 24**（与最近一次位流一致 —— ㊾ 实测 69.57 / 41.00 / 24.44%，见 U-53.7；旧版写 65 的那次见 U-48）；底栏 `中断电平 / 翻转 / 复位次数` 一行没变 | ☐ 是 ☐ 否 |

**易混点：**

> 1. **设备 ID / 固件版本不是从寄存器读的**：协议里没有这两个寄存器（`rtl/SPEC_interface_contract.md` 全文可查），它们是 `disp/touch_view.v` 里的常量字符串。屏上写的是"这块板的显示侧自报"，不是"从编码器读回的"。
> 2. **`LUT % / BRAM % / DSP %` 是位流期常量**，不是运行期测量：改了 RTL 但没重跑位流时，这三个数与实际布局不符（`RES_*` 三个常量要和 `_disp_work/impl_util.rpt` 一起更新，`verify_u35.py` 会比对）。
> 3. **触点 X0/Y0/触点数/0x814E 四个实时值这一版从 P8 让位**（规范要的四项占了位置）；要看触点原始值就走 `tb_touch_view`/上板日志，或等下一轮「自检结果」把明细并回去。
> 4. **`触摸 IC` 那一格跟型号联动**：未知型号时整格是 `---`（不是三格空白）——第一轮 bring-up 时抓的就是这个信号。

### 4.24 验「P8 第 ⑤ 项『自检结果』：三项 IIC 判据 + 通过 / 失败」（㉜ 新增，约 3 分钟）

| # | 操作 | 期望 | 实测 |
|---|---|---|---|
| 73 | 从状态栏点 ⚙ 进第 8 页，看**底栏最右端** | 静态标签 **`自检结果`**（格 31..34）后面是结论两个字：正常通信时是 **`通过`**（`通`=159 / `过`=160）；上电首帧前是静态占位的 **`失败`** | ☐ 是 ☐ 否 |
| 74 | 同时看同一页第 15 格行的三个计数 | **结论与明细同源**：`IIC 读 ≠ 0` 且 `无应答 = 0` 且 `超时 = 0` ⇔ 结论 `通过`；任一条不满足（读次数 0 / 无应答涨 / 超时涨）⇒ 结论 **`失败`** | ☐ 是 ☐ 否 |
| 75 | 拔掉触摸排线（或让 IIC 出现 NAK/超时）再回来看 | 结论在两帧内变成 **`失败`**（`失`=161 / `败`=162），且 `无应答` 或 `超时` 计数同时涨；插回去（读成功且两个错误计数清零的条件重新成立）后回到 `通过` | ☐ 是 ☐ 否 |

**易混点：**

> 1. **它是"运行期判定"，不是"自检按钮"**：每帧都在重算（输入是 `touch_view` 报上来的三个 IIC 计数），屏上没有"开始自检"这个操作。
> 2. **不判 `tch_status == 0`**：0x814E 不刷新是这块板的历史现象，通信其实是好的（状态灯画成蓝色信息态）；把"没手指"当成故障是错的，所以触点数 = 0 也不判。
> 3. **底栏一行是三段共享的**：左中右分别是 `中断电平 / 翻转 / 复位次数`（`band_view` 写 11/18/27 列）与最右端的 `自检结果`（`selftest_lab` 写 31..34 静态标签 + 36/37 结论）。两者**列不重叠**，所以共用一个写口、只加一层优先级 mux；判据失败时先看标签有没有被顶掉（那就是仲裁/越界问题，不是判定问题）。
> 4. **`失败` 是 fail-safe 的默认值**：静态版面（`tools/gen_text_ram.py` 的 `P8_LAB`）就写 `失败`，与"上电还没读成功过"的真实判定一致 —— 所以"模块没跑起来"和"链路真断"在画面上是同一个结论，**不会被误读成通过**。

### 4.25 验「P6 危险区高度 96 px + 命中边界 ±8 px」（㉝ 新增，约 2 分钟）

这一版把 spec §4.4 的「底部危险区 944×96」做到字面值，并把危险区按钮的触控命中
从"画框本身"扩到"画框 ±8 px"。**版面与文字一个都没动**，所以看的全是几何。

| # | 操作 | 期望 | 实测 |
|---|---|---|---|
| 76 | 导航「设置」进 P6，看底部红框横条 | 横条**上沿贴在 `SHIFT` 那一行数值格下方约 8 px**（y ≈ 504），高度到屏底（y 599）= **96 px**；左右从 x 80 到 x 1023（宽 944） | ☐ 是 ☐ 否 |
| 77 | 看按钮框与警示三角的水平中线 | 按钮框 y 520..583（64 px 高，中心 552）**正好在危险区正中**（上下各留 16 px）；三角尖顶 y 532、底边 y 572，与按钮同一中线 | ☐ 是 ☐ 否 |
| 78 | 先点按钮**框外 4 px**（上 y 516 / 下 y 587 / 左 x 176 —— ㊴ 起画框在 180..591、命中区外扩 8 px 到 172），再往**外一点**点（上 y 508 / 下 y 595 / 左 x 164） | 前者仍然弹出二次确认模态（±8 px 外扩生效）；后者**不弹**（外扩只有 8 px，508 那一带仍在危险区内但按设计不属于按钮命中区） | ☐ 是 ☐ 否 |

**易混点：**

> 1. **危险区（944×96）与按钮命中区（80 px 高）不是一回事**：危险区是"画出来的红框横条"，按钮命中区是"画框 ±8 px"。危险区上沿 504..511 那 8 px 故意留给"看得见但点不动"——它和第 4 项数值格在几何上重叠。
> 2. **`hit_test` 里找不到危险区按钮**：命中层不认识页号，所以这个按钮由策略层按 `hit_x/hit_y + page == 5` 判（延续 ⑲）。搜代码要搜 `dz_prs_lvl`（按住电平）/ `dz_click`（在按钮内抬起才产出的点击）/ `DZ_HIT_*`（`disp/enc_top_disp.v`），不要在 `disp/hit_test.v` 里找（㊲ 起 `tap_dz_clr` 这个名字已经不存在）。
> 3. **在 P1 上点同一块面积仍然是卡片**：画面下半部在 P1 是卡片 11/12。危险区只在 P6 存在，按坐标 + 页号判才不出错。
> 4. **按钮框变了不代表版面变了**：`P6_LAB/P6_VAL` 与 `disp/text_ram.v` 本轮一个字节没动（`tools/gen_text_ram.py` 只改了注释），所以"P6 那 12 项的文字位置"应与上一版完全一致。

### 4.26 验「P4 等效采样注记按 spec §7 字面口径」（㉞ 新增，约 2 分钟）

这一版把 P4 图上那行注记从妥协写法「128点等效采样」改成规范原话的字面口径
「**按电角度重建128箱等效采样**」（14 格）。**几何、其它七页、字库之外的一切都没动**，
所以看的只有这一行字。

| # | 操作 | 期望 | 实测 |
|---|---|---|---|
| 79 | 进 P4，看轨迹区左下角那一行小字 | 逐字是 `按电角度重建128箱等效采样`（**14 格**：按/电/角/度/重/建/`1`/`2`/`8`/箱/等/效/采/样），**不是**旧版的 `128点等效采样` | ☐ 是 ☐ 否 |
| 80 | 看这一行的上下有没有压到波形 / 轴标 / 刻度 | 行 27（y 432..447）在 P4 框内：上方是波形区底部、下方是 45° 刻度那一行；字与字之间无重叠、无断笔（「按 / 重 / 建 / 箱」四个新字都要有形） | ☐ 是 ☐ 否 |
| 81 | 与 spec §7 的原文对照（`docs/13_display_ui_requirements.md:305`） | 屏上文字 = 规范原话的字面口径：「**按电角度**」+「**128 箱**」+「**等效采样**」，「箱」不再是「点」 | ☐ 是 ☐ 否 |

**易混点：**

> 1. **「128 箱」不是新数字**：分箱数一直是 128（P4 的箱号换算与 P7 的 `p7_ram` 都没变），本版改的只是**注记的用词**（点 → 箱，并补上「按电角度重建」）。
> 2. **字库加了 4 个字，码值是 163..166**：`CN_ORDER` 只追加 ⇒ 既有 163 个码**一个都没动**，P1/P6/P8 的字符码判据不受影响。
> 3. **这一行是静态版面，不是运行期写者**：它住在 `disp/text_ram.v` 的 `p4_lab_ram`（由 `tools/gen_text_ram.py` 的 P4 表生成）⇒ 改注记要**重跑生成器**，不是改 RTL。
> 4. **两层判据不是重复**：格子读数管「是哪个字」，墨量管「画出来了没有」。只读 RAM 会被"写对但没渲染"骗过；只看像素会把旧的 8 格注记也当成合格。

### 4.27 验「P1 两处口径注记按 spec §7 字面口径」（㉟ 新增，约 2 分钟）

这一版在 P1 的两张卡片上各加了一句口径注记：转速卡加「**估算值**」（3 格），
累计转数卡加「**本次上电起算**」（6 格）。**几何、其它七页、值层数据、RPM 与累计转数
的算法都没动**，所以看的只有这两行小字。

| # | 操作 | 期望 | 实测 |
|---|---|---|---|
| 82 | 进 P1，看「转速」卡 `RPM` 单位下面那一行小字 | 逐字是 `估算值`（**3 格**：估/算/值 = 字符码 167/168/126），位置在 `RPM` 与卡片底部迷你状态条之间 | ☐ 是 ☐ 否 |
| 83 | 看「累计转数」卡标题下面那一行小字 | 逐字是 `本次上电起算`（**6 格**：本/次/上/电/起/算 = 150/104/169/71/170/168），在卡标题正下方 | ☐ 是 ☐ 否 |
| 84 | 与 spec §7 的原文对照（`docs/13_display_ui_requirements.md:300` / `:302`） | 两句话都按规范原话写全（`估算值` / `本次上电起算`），4 个新字（估/算/上/起）都有形、无断笔（字库 171 码） | ☐ 是 ☐ 否 |

**易混点：**

> 1. **两句注记是静态版面，不是运行期写者**：它们住在 `disp/text_ram.v` 的 `p1_lab_ram`（由 `tools/gen_text_ram.py` 的 P1 表生成）⇒ 改字面要**重跑生成器**，不是改 RTL（P1 上只有格行 15/36 的迷你状态条与格行 34 的撤销值有运行期写者）。
> 2. **字库加了 4 个字，码值是 167..170**：`CN_ORDER` 只追加 ⇒ 之前那批码**一个都没动**（新码从 167 起编号）；「算」在两句话里共用同一个码（168），所以是 4 个字不是 5 个。
> 3. **RPM 与累计转数的算法一个字没改**：这一轮只补"口径"，不改测量链路 —— RPM 仍是 `60 × f_in / 极对数` 的估算值、累计转数仍从本次上电起算（掉电不保存是设计如此，不是缺陷）。
> 4. **两层判据不是重复**：格子读数管「是哪几个字」，墨量管「画出来了没有」（实测「估算值」**624 px**、「本次上电起算」**988 px**）。只读 RAM 会被"写对但没渲染"骗过；只看像素分不清那一带写的是哪句话。

### 4.28 验「P5 六行状态名改汉字写法」（㊱ 新增，约 2 分钟）

这一版把 P5 状态列从 ASCII 的 `U1 V0 W0` 改成汉字写法 `U高 V低 W低`（1 → 高、
0 → 低），U/V/W 三个字母保留。**几何、其它七页、电平判据与条形尺度都没动**，所以看的
只有这一列的几个字。

| # | 操作 | 期望 | 实测 |
|---|---|---|---|
| 85 | 进 P5，看表格里「状态」那一列（第 2 列） | 六行逐字是 `U高 V低 W低` / `U低 V高 W低` / `U高 V高 W低` / `U低 V低 W高` / `U高 V低 W高` / `U低 V高 W高`（U/V/W 仍是字母，0/1 换成了汉字） | ☐ 是 ☐ 否 |
| 86 | 看「高」「低」两个字有没有形、有没有断笔 | 两个新字（高 = 字符码 **171**、低 = **172**）都是 16×16 点阵，落在 30 px 行带里垂直居中（`P5_VINSET = 7`）、列内左右各 6 px 内缩（`P5_INSET = 6`）⇒ 字与格线不重叠 | ☐ 是 ☐ 否 |
| 87 | 与 spec §4.4 的原文对照（`docs/13_display_ui_requirements.md:176`） | 五列语义仍是 序号 / **状态** / 次数 / 占比 / 条形图，四列几何（30 px 行高 / 188 px 列宽）一字未变；状态列是中文电平写法；其余七页一行未变（字库 **173 码**） | ☐ 是 ☐ 否 |

**易混点：**

> 1. **改的是"字"不是"数"**：电平判据（`uvw = {w,v,u}`）、`snap[k]` 的映射、占比与条形尺度全部没动 —— 这一轮的改动半径只有"两个字符码"这么大（U/V/W 保留字母就是为了不动列位）。
> 2. **每行仍是 8 格，`p5_lab_ram` 仍是 84 个非空格**：汉字与 ASCII 在 lab 平面里都是 16×16 一格 ⇒ P5 的虚拟格网、行带/列带几何**一个字都不用动**。
> 3. **字库只追加了 2 个字，码值是 171/172**：`CN_ORDER` 只追加 ⇒ 之前那批码一个都没动（U-39 的 171 码是上一版的总数，新码从**那之后的编号**继续）。
> 4. **判据为什么必须落像素**：汉字第一次进 P5 的虚拟格网，只回读 RAM 会被"写对但没渲染"骗过（v24 的 7 bit 截断就是 RAM 全对、屏上全空）；而只数"这一带有没有字"在旧版本上也绿。所以既逐行钉精确墨量（483 / 483 / 482 / 483 / 482 / 482），又钉 18 个"新旧取值相反"的像素。

### 4.29 验「危险区按钮的按下反馈」（㊲ 新增，约 2 分钟）

这一版把危险区按钮的"按下"与"弹询问态"分开，并给按下加了一道形状反馈（按钮里侧 2 px 红内框）；
询问态下按钮矩形不再被整屏压暗吃掉。**几何、命中矩形、写寄存器链路都没动**，所以看的只有这几件事。

| # | 操作 | 期望 | 实测 |
|---|---|---|---|
| 88 | 进 P6，在 `清除锁存故障` 按钮上**按住不放** | 按钮里侧 10 px 处出现一道 2 px 红内框（**㊴ 起**左那颗 x 190..191 / 580..581、右那颗 x 618..619 / 1008..1009，上 y 530..531 / 下 y 572..573），**这一拍不弹询问态**、寄存器不写 | ☐ 是 ☐ 否 |
| 89 | 在按钮**内**松开；然后再按一次、按住后**滑出按钮**再松开 | 第一次：松开那一拍弹出询问态（整屏变暗 + 红框对话框）；第二次：**什么都不发生**（滑出再抬不算点击，防误触） | ☐ 是 ☐ 否 |
| 90 | 让询问态挂在屏上（弹出后先别按 `CANCEL`） | 整屏压暗，但**按钮矩形本身保持可见**（底色变浅为 `FBD9D6`、`清除锁存故障` 五个字仍在、里侧内框还在）；按钮之外的整片危险区照旧压暗。（㊴ 起有两颗按钮，两颗在各自的询问态里都保持可见 —— 第二套对话框见 §4.31。） | ☐ 是 ☐ 否 |

**易混点：**

> 1. **"按下"不再等于"弹窗"**：旧行为是按下那一拍就进询问态，于是按钮立刻被遮罩压暗 —— 反馈在物理上看不见。㊲ 起按住只亮内框（电平 `dz_prs_lvl`），**在按钮内抬起**才产 `dz_click` 并弹询问态。
> 2. **反馈是形状不是颜色**：spec §5.2（`docs/13_display_ui_requirements.md:241-244`）要求状态不能只靠颜色；内框是 2 px 深红（`C_FAULT`），与按钮的浅底/深字形成形状差，色弱与强光下都读得出。
> 3. **滑出再抬不受理**：按住后把手指移到按钮外再松开 ⇒ 不弹询问态、不写寄存器（`dz_latch` + 抬点复判）。这与 §6.5 第 ② 类"防误触但不必弹窗"一致。
> 4. **询问态只让步一个按钮**：`dz_keep = dlg_on && dz_btn` —— 只放行按钮矩形（含它的标签字形），危险区其余部分照旧 `C_DIM`；对话框本体、`CANCEL` / `OK` 的交互一个字没改。

### 4.30 验「P6 补齐第五行、项高 88」（㊳ 新增，约 3 分钟）

这一版把 spec §4.4 的「项高 88 px」做成了字面数字：**5 行 x 88 px = 440（y 64..503）+ 危险区 96（504..599）= 536**，正好铺满内容区。P6 现在有 **15 项**（原有 12 项 + 第 5 行三项修正参数）。
五行等距、每行的标题在带内最上（y 65..78 / 153..166 / 241..254 / 329..342 / 417..430），底下是大数字；
**这一版动了版面**：`tools/gen_text_ram.py` 的 `P6_LAB` / `P6_VAL` 行号、`disp/disp_engine.v` 的虚拟格网与
对话框文字行（15/17/21 → 13/18/22）都是同一个契约的三处抄写。

| # | 操作 | 期望 | 实测 |
|---|---|---|---|
| 91 | 进 P6，从上往下看五行 | 五行**等距 88 px**、互不粘连；每行都是"小标题 + 大数字"（第 5 行标题是 `增益S` / `增益C` / `相位修正`） | ☐ 是 ☐ 否 |
| 92 | 看第 5 行三项读数 | `1.000` / `1.000` / `+0.000`（复位默认值）；**小数点与正负号都在**（相位修正带 `+`） | ☐ 是 ☐ 否 |
| 93 | 看第 1 行标题上方（y 52..62）与第 5 行数值下方（y 490） | 标题上方**没有任何残留文字**（旧实现会把「倍频」多画一行在这里）；第 5 行数值墨迹止于 y 481，与危险区上沿（504）之间是空白 | ☐ 是 ☐ 否 |

**易混点：**

> 1. **"项高 88"是行带高度、不是字高**：88 px 的带里放"16 px 标题 + 42 px 大数字 + 30 px 行距"，标题与数值的墨迹分别落在带内 v 1..14 与 v 24..65；所以量"行距"要量**标题墨迹到下一行标题墨迹**（正好 88 px），不是量字高。
> 2. **标题 RAM 行从 4 起、不是 3**：虚拟区从 y 64 开始，而 lab RAM 行 3 的自然位置是 y 48..63 —— 落在虚拟区外，自然映射会把「倍频」多画一行当残留文字。预览件镜像不走自然行，所以**图上根本看不出来**，只有引擎台的残墨判据能抓（第一次跑就抓到 22 px 的假红，见 `DEV_STATUS.md` 的 `U-42.5`）。
> 3. **对话框那三行文字搬过家**（15/17/21 → 13/18/22）：原因不是"好看"，而是旧行 15（y 240..255）与 21（y 336..351）正好压在新第 3 / 第 4 项标题（y 241..254 / 329..342）上，而页面层对这三行按页排除 ⇒ 不迁就会吃掉两条标题。行 22 与导航页签「时序」同行（格列 1），所以那处排除另加了 `x >= 256` 的格列门控。
> 4. **字段表是 15 项、不是 12 项**：第 5 行三项是 v15 的修正参数（`cfg_gain_s` / `cfg_gain_c` / `cfg_phase_k`，Q1.15）；`disp/p6_view.v` 的 `S_NEXT` 终止值已从 `4'd11` 改成 `4'd14`，`P6_VAL` 里那三个占位串（`1.000` / `1.000` / `+0.000`）运行期会被它覆写。
> 5. **值域**：Q1.15 满量程是 `1.999`（65535/32768）、有符号项下限 `-1.000`（16'h8000）；小数三位**不做**前导零抑制（`1.000` 不会变成 `.000`）。

### 4.31 验「危险区第二颗按钮：恢复默认」（㊴ 新增，约 4 分钟）

这一版把 spec §4.6 的「恢复默认」补上：危险区从一颗按钮变**两颗对称按钮**（各 412 px、缝 16 px），
右那颗按下 → 弹同款二次确认对话框（标题 `恢复默认`、正文 `REG 0X0100-051A`）→ 点 `OK` 之后
**屏侧自己发 13 条写寄存器命令**（16 个寄存器）把 P6 的 15 项恢复成复位默认值，再等 2 ms
回读抽头的 17 项逐项确认；**任何一项没对上，就在那一项的格位画一个红 ✖**（不回滚、不显示错误码）。
整条序列约 **8.8 ms**（13 x (20 µs 字节 + 500 µs 命令间隔) + 2 ms settle），人眼只看到"闪一下"。

| # | 操作 | 期望 | 实测 |
|---|---|---|---|
| 94 | 进 P6，看底部危险区 | **两颗等宽对称按钮**（各 412 px、缝 16 px、左右各留 180 px）：左 `清除锁存故障`、右 `恢复默认`，标签各自居中；红框与警示三角没变 | ☐ 是 ☐ 否 |
| 95 | 先用长按 KEY1（或上位机）把某一项改脏（例如把「限幅」改小），再点右那颗 `恢复默认` → 对话框点 `OK` | 对话框标题是 `恢复默认`、正文是 `REG 0X0100-051A`（**不是**"清除锁存故障"那套）；确认后屏上闪一下，P6 的 15 项**全部回到复位默认值**（倍频 64 / 分频 1 / 极对数 4 / 迟滞 2 / 限幅 1023 / Z脉宽 4 / Z相位·UVW相位 0 / 极性 NORMAL / ABZ·UVW ON / SHIFT 0 / 1.000 / 1.000 / +0.000），屏上**没有任何红 ✖** | ☐ 是 ☐ 否 |
| 96 | 再点右那颗 → 对话框点 `CANCEL` | 对话框收起、**一个字节都不发**（P6 的读数一项都不变）；左那颗的 `清除锁存故障` 行为与 ㊲ 那轮一模一样（按住亮内框、按钮内松开才弹、`CANCEL` 不写 `0x0405`） | ☐ 是 ☐ 否 |

**易混点：**

> 1. **两颗按钮的命中区在 x=600 相接**：左 172..599、右 600..1026（都是画框外扩 8 px）。"按右那颗却弹出「清除锁存故障」"就是命中区错了 —— v42 版正是这样（画框挪了、命中区没挪，见 `DEV_STATUS.md` 的 `U-43.5` 第 2 条）。
> 2. **「恢复默认」只恢复能回读的 16 个寄存器**（`0x0100/0101/0102/0106/0108/010A/010C/0510/0512/0514/0516/0518/051A` 及其顺带的邻居）：`0x0104` 迟滞(UVW)、方向位（`abzdir`/`uvwdir`）、H2_K 都**不在 `disp_tap` 里** ⇒ 本轮不写它们、也不承诺它们被恢复。要做"全量恢复"必须先扩抽头或加读通路（那是协议侧改动，会碰冻结契约）。
> 3. **命令间隔 500 µs 是给桥留的**：桥收完 4 字节要跑一帧内部 SPI（10.56 µs）、抢遥测行空闲（最坏 ~100 µs）、再发 6 字节应答（30 µs），这期间**它不看 rx**。把间隔改回 80 µs 会让第 2 条起的命令整条丢失，症状是"只有被改脏的那一项报不一致"（其余寄存器本来就是默认值）。
> 4. **红 ✖ 是"哪一项"的编码**：`ui_rst_bad[14:0]` 的第 `k*3 + n` 位对应 P6 第 k 行第 n 列那一项，✖ 画在该项标题的右边（x 512..527 那一列）。屏上**不会**出现 `ERR 0X0010` 这类十六进制码（用户确认过：位置 + 形状 + 颜色已经三重冗余，且现场没有码表）。
> 5. **序列期间屏侧占用 `enc_top` 的 UART 入口**（约 8.8 ms）：这期间上位机发的命令要等它；P1 的波形刷新不受影响。

### 4.32 验「Tab「模拟」/ 按钮「展开」按 spec 字面」（㊵ 新增，约 2 分钟）

这一版把 spec 的**字面标签**写回屏：`docs/13_display_ui_requirements.md:173` 要求 P2 的入口是
「导航「波形」→ Tab「**模拟**」」、`:176` 要求 P5 的入口是「P4 表格「**展开**」」，而 v20 起屏上
一直是 ASCII `SIM` / `EXPAND`（原因：`模` / `拟` / `展` / `开` 不在字库）。本轮把这 4 个字补进字库
（51 ASCII + 132 汉字 = **183 码**、144,768 bit = 17.67 KB，比上一版只多 1,024 bit），
两处标签改成 spec 字面。**接线、命中区、页号守卫一处未动**（Tab 仍是 `x 96..296` / `300..500`，
标题带按钮仍是 `x 660..820` / 命中 `y 24..64`）。

| # | 操作 | 期望 | 实测 |
|---|---|---|---|
| 97 | 进 P2 看顶部两个页签，再进 P3 看同一对 | 第一格是 **「模拟」**（不再是 3 个字母的 `SIM`）、第二格仍是 `XY`；P2 上「模拟」选中、P3 上 `XY` 选中；点任一格仍能互换 P2/P3 | ☐ 是 ☐ 否 |
| 98 | 进 P4，看标题带右边那颗按钮 | 里面是 **「展开」**（不再是 6 个字母的 `EXPAND`），位置与 P1 的「标定」**同格列**（x 720..751）；点它进 P5；P1 上仍是「标定」→ P7 | ☐ 是 ☐ 否 |
| 99 | 放大看这四个新字（`模拟展开`）的笔画 | 四个字**笔画完整、不缺不糊**、与周围汉字同一套字形（16 px 等宽点阵）；同一页其它标签没有串位或变字 | ☐ 是 ☐ 否 |

**易混点：**

> 1. **字库是"只追加"的表**：新字追加在 `CN_ORDER` 末尾 ⇒ 新码是 **179 / 180 / 181 / 182**，已有 128 个汉字的码一个都没动。所以"某页某个老标签突然变字"= 字库被重排了，不是本次改动的正常现象。
> 2. **页签底色是 RTL 画的**：预览件 `_disp_work/page_p2.png` / `page_p4.png` 只画**文字**，看不到页签矩形与选中态；"预览图里没有框"不代表屏上没有。
> 3. **标签只占 2 格**：`模拟` 与 `展开` 都是 32 px（2 x 16 px），Tab 矩形 200 px 宽 ⇒ 理想居中 x 180、实取格列 11（x 176..207，偏左 4.5 px）；标题带按钮 160 px 宽 ⇒ 理想居中 x 724、实取格列 45（偏左 4 px）。这是"格位只能整格走"的必然结果，不是排版错误。
> 4. **本轮只动版面**：`disp/tb_font_rom.v` 的规模常量（`NC` / `NCH`）必须跟着字库走 —— 上一轮加字时忘了改，导致最近 3 个字的判据静默少跑（本次一并修掉，见 `DEV_STATUS.md` 的 `U-44.5`）。

### 4.33 验「面板 ÷ 分频八档步进」（㊶ 新增，约 3 分钟）

这一版把面板从"只改倍频"扩成**两个字段**：面板标题带左边多了一颗 **64×64 的小方按钮**，
按一下在 **×倍频 ⇄ ÷分频** 之间切；切过去之后 `[−]` / `[+]` / 8 档滑条 / 长按加速 / 数字键盘
**全部作用于分频**（`÷1…÷8` 八档、两端夹住不绕回）。底层一条写命令同时写 0x0101（倍频）与
0x0102（分频）两个字，所以本轮把"打开面板"从"把倍频吸附到档位"改成 **原样带回读值**
（`pnl_inter <= tap_inter`）—— 只改分频时倍频一个 bit 都不许动。撤销标签也从 7 格扩到 **9 格**。

| # | 操作 | 期望 | 实测 |
|---|---|---|---|
| 100 | 进 P1，点第 1 行第 2 张「倍频分频」卡片开面板，看标题带左边那颗 **64×64 小方按钮** | 里面是 **×** 号（两笔斜线）；点它一下变成 **÷**（一横 + 上下两点），**数值窗里的待应用值一个数字都不变**（切字段不是改动），点 `APPLY` 之前一个字节都不发 | ☐ 是 ☐ 否 |
| 101 | 切到 ÷ 之后：点 `[−]` / `[+]`（或拖滑条、长按加速、数字键盘敲 1…8） | 数值窗显示 **÷1…÷8** 八档、两端**夹住不绕回**（÷8 再点 `[+]` 不动、÷1 再点 `[−]` 不动）；键盘只收 **1…8**（敲 `0` 或 `9` 不收，`←` 只做高亮）；`APPLY` 后 P1 卡片 2 的副文本变成新的 `÷M`，P6 的「分频」一项读数与新值一致、倍频读数**没变** | ☐ 是 ☐ 否 |
| 102 | 改完分频后点 `BACK` 撤销（面板左下角 `CANCEL` 左边那一行 `↩ 回到 …`） | 分频**回到改之前的值**、倍频全程没被动过；撤销标签从 7 格变成 **9 格**：`↩回到×N ÷M`（例 `↩回到×64 ÷3`），按 `BACK` 后两个值互换（再按一次能回到刚才那组） | ☐ 是 ☐ 否 |

**易混点：**

> 1. **倍频与分频是同一条写命令的两个字**（0x0101 / 0x0102，见 `disp/ui_edit.v` 的 `pack_cmd`）：面板里改分频时倍频按**回读真值**原样带出，不会被"吸附"成档位值（旧版就会 —— 改分频顺手把 100 变成 64）。反过来改倍频时分频也原样带出。
> 2. **那颗字段按钮在键盘模式下会被键盘盖住**（键盘铺在面板之上）：先 `↵` 或 `CANCEL` 收起键盘再切字段。
> 3. **每次写要等 2 ms 沉降 + 回读比对**（约 2.2 ms/事务）：点 `APPLY` 后屏上先显示**待应用值**，比对通过才变成回读值；这期间上位机发的命令要排队（整段恢复序列约 8.8 ms 同理）。
> 4. **面板里的 ×/÷ 图标是 RTL 画的图形**（面板矩形内字库被抑制）：预览件 `_disp_work/page_p1.png` 里**看不到**这两个符号；"预览里没有"不代表屏上没有，像素判据以 `disp/tb_disp_engine.v` §[9b] 为准。

### 4.34 验「空态：链路不可信时测量字段显示 `-`」（㊷ 新增，约 3 分钟）

这一版补 spec §8-8 的**空态**（`docs/13_display_ui_requirements.md:351`「没信号时屏幕一片空白 /
一片 `0`」）：链路不可信时，四个**测量**字段整格显示 `-`（小数点留在原处、字段骨架还在），
四个测量卡的迷你状态条同时转 **✖ 故障**。口径 = `sig_bad` 里的**链路锁存位**（`disp_tap[126]`；
只认链路级故障 ⇒ 这一帧读数整体不可信）。**信号质量**位（`cor_sat` / `amp_bad`）不并进来：
它们各自落在卡 3（转速，幅值）/ 卡 4（角度，相关器饱和）的判据上，顶栏告警灯另外表达它们。
**配置回读**（字段 1 倍频分频）与**逻辑电平**
（字段 5 ABZ/UVW）**不动** —— 它们不是测量，链路坏了它们照样是真值。

| # | 操作 | 期望 | 实测 |
|---|---|---|---|
| 103 | 让编码器的**链路锁存故障位**置位（`disp_tap[126]`，编码器侧锁存；可造一次协议违例触发），停在 P1 看数值区 | 四个**测量**字段整格变 `-`：输入频率（`------.--`）、转速、角度、累计转数；**倍频分频字段与 ABZ/UVW 字段一个字都不变**（配置回读与逻辑电平不是测量）。★ 该位是 **sticky**（编码器侧置位，只有复位分支能清），所以违例**一次**之后屏上就一直是 `-`，直到复位编码器 | ☐ 是 ☐ 否 |
| 104 | 同一状态下看六张卡的状态条与顶栏 | 四张**测量卡**（输入频率 / 转速 / 角度 / 累计转数）的迷你状态条是 **✖ 故障**；顶栏告警灯也是故障态。比例卡（卡 2）与 ABZ/UVW 卡（卡 6）仍按自己的判据（它们本来就不依赖测量值） | ☐ 是 ☐ 否 |
| 105 | 复位编码器（`rst_n` / 重新配置器件）让 `[126]` 落下 | 四个测量字段**自己回到数字**（显示侧不加锁存、不用重新进页）；状态条回到按 `io_flags` 判定的 ●/▲/✖ | ☐ 是 ☐ 否 |

**易混点：**

> 1. **空态只针对"测量值"**：倍频分频是寄存器回读、ABZ/UVW 是逻辑电平 —— 链路坏了它们照样是真值，所以它们**不变是对的**，别当成 bug。
> 2. 触发条件是 `sig_bad` 里的链路锁存位（`disp_tap[126]`；**只认链路**，不含幅值/相关器饱和）。★ 这个位在编码器侧是 **sticky，且只有复位能清**：违反帧约定的那一拍置位，只有复位分支清它，寄存器组里没有 W1C 路径（`rtl/reg_file.v:528` 的 `0x053A` 那位是直读）。⇒ **真机上违例一次，屏上就一直 `-`，必须复位编码器**才回来；这不是显示侧加的锁存（引擎台轮 C 专门验了"输入落下就回来"）。
> 3. 屏上没有"空态"这个词：**`-` 本身就是空态**。小数点保留是为了和"真的是 0.00"区分开 —— `0` 是合法读数，不能拿它当空态（旧版正因为在编码器停摆时显示 `0.00 Hz` 同时挂着 ● 正常，才被列为反模式 8）。
> 4. 判据在 `disp/tb_disp_engine.v` §[11b]（四轮：基线 → 空态 → **口径区分（轮 B2：只有 amp_bad/cor_sat 时读数不许空态）** → 复原；基线里先要求"输入频率里原本有 ≥4 个数字字符"，专门防"恒输出 `-`"骗绿）与 `disp/tb_val_format.v` 第 5 轮；像素判据只看 ✖ 是否落在卡 1 的状态条上。另：**信号质量差（幅度/相关器）不会**让读数变 `-`，那时该看卡 3/卡 4 的 ✖ 与顶栏告警灯。

### 4.35 验「停摆空态：无载波 ⇒ 测量字段显示 `-`」（㊸ 新增，约 3 分钟）

这一版补 spec §8-8 空态的**另一半**（`docs/13_display_ui_requirements.md:351`）：㊷ 只覆盖
"帧来了但没过校验"，覆盖不了"**编码器侧根本没有信号**"——停摆时旧版依旧显示
`0.00 Hz` 并挂着 ● 正常。本版把**载波幅值**并进空态判据：`sig_bad = amp_gone`，
其中 `amp_gone = (tap_amp_sq < tap_amp_low_sq)`（与 `rtl/amp_monitor.v:95` 的 `w_low` 同口径、
**严格小于**、门限写 0 等于关掉）。**只看幅值低侧**，不看 `[128] amp_bad` 标志（那个位是
`amp_low | amp_high`，会把"幅值偏高"也算成坏信号，与现场 103 的"只有信号质量差、读数照常"
那条口径打架）。

| # | 操作 | 期望 | 实测 |
|---|---|---|---|
| 106 | 编码器停摆（拔掉磁环 / 关掉编码器一侧的载波，使 `0x0530` 的幅值掉到 `0x0520` 下限以下；抽头 `amp_sq < amp_low_sq`），停在 P1 看数值区 | 四个**测量**字段整格变 `-`（输入频率 `------.--`、转速、角度、累计转数；小数点留在原处），四张测量卡转 **✖ 故障**、顶栏告警灯故障；**倍频分频字段与 ABZ/UVW 字段一个字都不变**。★ 与 103 的区别：这一条**不 sticky** —— 幅值回窗口内就自己回来（103 是编码器侧锁存的链路故障位，只有复位能清） | ☐ 是 ☐ 否 |
| 107 | 把载波接回去（幅值回到上下限之间） | 四个测量字段**自己回到数字**（显示侧不加锁存、不用重新进页/复位）；状态条回到按 `io_flags` 判定的 ●/▲/✖ | ☐ 是 ☐ 否 |
| 108 | **口径区分**：让"只有信号质量差"发生（幅值仍在窗口内，但 `cor_sat` 或 `amp_bad` 标志为真，例如相关器饱和） | 四个测量字段**照常显示数字**（这是 ㊷ 轮 B2 钉死的口径：标志层 ≠ 值层）；只有卡 3（转速，幅值）/ 卡 4（角度，相关器）按自己的判据转 ▲/✖，顶栏告警灯亮 | ☐ 是 ☐ 否 |

**易混点：**

> 1. **"静止"不是"停摆"**：编码器停住不动、载波还在、幅值在窗口内 ⇒ 位置不变但读数**照常显示**（引擎台轮 E 专门验了这条，失败信息就是"把静止误判成停摆了"）。停摆的判据是**载波幅值**，不是"值不变"。
> 2. **判据是严格小于、与 `rtl/amp_monitor.v:95` 同口径**：幅值**恰好等于**下限时**不算**没信号（引擎台轮 D2 把这一条钉死：`amp_sq == amp_low_sq` 读数照常）。另外门限写 0 等于关掉判据（`rtl/amp_monitor.v:32-33` 的既有约定）。
> 4. 判据在 `disp/tb_disp_engine.v` §[11b]（本轮新增轮 D「无载波」/轮 D2「门限边界」/轮 E「静止 ≠ 停摆」，既有轮 A/B/B2/C 全部保留）与 `disp/tb_val_format.v` 第 5 轮；像素判据看 ✖ 是否落在卡 1 的状态条上（`expect_px(120,248,C_FAULT)`）。

### 4.36 验「P8 说真话：固件版本与资源占用」（㊹ 新增，约 1 分钟）

这一版**不新增现场项** —— 它修的是 P8 上两处"手抄常量"，对应的现场判据就是已有的
**现场记录 71 / 72**（本轮已把期望值改对）。本节只写清"怎么核对"，因为这两条以前**没有可核对的依据**：

| 序号 | 怎么核对 | 期望 |
|---|---|---|
| 71 | 进 P8 看第 1 行的 `固件版本`，与**这一次烧进去的位流版本**对照（版本号写在 `DEV_STATUS.md` 最新一轮的标题里，形如 `（v55）`） | 屏上是 **`V55`**，且与前几次烧录**不同**（旧版本号 `V35` 从 v35 挂到 v46，就是没有这条核对才漏掉的） |
| 71 | 再看 `设备 ID` | 仍是 **`ENCC1`**（身份串，**不随版本变** —— 它变了才是 bug） |
| 72 | 把 `LUT % / BRAM % / DSP %` 与归档的 `_disp_work/impl_util.rpt`（本轮位流那一份）逐项对照 | **`70 / 41 / 24`**，与报告的取整值一致（㊾：69.57 / 41.00 / 24.44%）；`LUT` 一项历史上曾少报 2.5 个点（旧常量 65，U-47 实测 67.51%） |

> ★ **上板状态（U-55 登记）**：上表三条的期望值来自**仿真 + 实现报告**，屏上的实际读数**尚未复测**（v55 的位流还没烧）。烧完把结果写回本节；同一块板上还有 §4.43 的 127..128 待勾。

**易混点：**

> 1. **`设备 ID` 与 `固件版本` 是两回事**：前者是身份（`ENCC1` = 型号 + C1 通道），按定义不过期；后者是"这一次交付"的属性，**每轮必须等于当前位流版本**。把两者都当"版本"去改，等于每轮改身份串 —— 那是错的。
> 2. **资源百分比只能是"快照"**：FPGA 读不到自己的 utilization report，屏上这三个数是 `disp/touch_view.v` 里的三个 `localparam`，它们**参与综合** ⇒ 改一次就要重出一版位流。正确流程是"先出位流 → 读 `impl_util.rpt` → 若取整值变了再改常量并重出"，而不是先写一个希望值。归档的 `verify_u48.py` 会把这三个常量与本轮报告比对，漂了会红。
> 3. **P8 的九个字段全是运行期写的**：`disp/text_ram.v` 里的初值只是首帧之前的占位（也是 `preview_pages.py` 的依据）。只改 RTL 不改生成器 ⇒ 预览与实屏不一致；只改生成器不重生成 ⇒ 工作区里的 `text_ram.v` 是旧的。本轮用"生成器输出 vs 已提交文件逐行 diff == identical"把这条钉住。

### 4.37 验「卡内 1 px 分隔线与卡 4 的 pos_full 十六进制」（㊺ 新增，约 2 分钟）

这一版补 spec 的两处**字面缺口**（`docs/13_display_ui_requirements.md:162` 的卡内分隔线、
`:188` 的卡 4 次级 `pos_full 0x……`），顺手修掉一处**串位**：`方向 CCW` 原本写在卡 4 的次级行，
按 `:187` 它属于转速卡（卡 3）。

| # | 操作 | 期望 | 实测 |
|---|---|---|---|
| 109 | 停在任何一页之外不需要动，进 P1 看**卡片内部**：数值大字的下面、次级信息上面那条横线 | 每张卡里有一条 **1 px 浅蓝（#D6E3F0）分隔线**，左右各距卡片边缘约 16 px；**上下相邻行没有线**（不是 2 px 也不是 3 px）；第二排卡片同样有 | ☐ 是 ☐ 否 |
| 110 | 看卡 4（角度 / 相位）的次级行：`POS 0X` 后面 8 位十六进制 | 8 位数字是**运行期值**：慢慢转动（或拨动）编码器时它**在变**；链路/信号断开进入空态时它**仍然显示**（它是位置回读，不是测量值） | ☐ 是 ☐ 否 |
| 111 | 看卡 3（转速）与卡 4 的次级行 | 卡 3 次级行有 **`方向 CCW`**（spec :187 归属转速卡）；卡 4 次级行**不再**出现 `方向 CCW`（只剩 `POS 0X……`） | ☐ 是 ☐ 否 |

**易混点：**

> 1. **分隔线是"背景色"不是"文字"**：它在 `disp/disp_engine.v` 的 `bg_grid` 那一级画（`C_GRID`），不占文字层、不占 RAM；所以它**不会**因为空态/面板/键盘的覆盖而消失，也不会被写口仲裁影响。
> 2. **`POS 0X` 是大写**：字库没有小写字母（`ASCII_CHARS` 只有大写），spec 字面的 `pos_full 0x` 按全仓既有约定落成 `POS 0X`（与 `REV` / `RPM` / `DEG` 同一处理）。8 位十六进制用到的 `0..9 A..F` 全在字库里 —— **没有扩字库**。
> 3. **它走标签层不走数值层**：数值层的格是 32×64 px、只落在"格行 2 / 格行 7"两条带上（48 px 大数字）；卡 4 次级行（y 560..575）不在那两条带里。标签层是 16×16 格网，行 35 / 列 12 正好在卡内。
> 4. 判据在 `disp/tb_disp_engine.v` §[17]：A1 走像素（两端有 / 两端外没有 / 上下行没有 / 第二排也有），A2 走**标签层字符码**（把 `pos_full` 冻成 `003A1B2C` 再逐格比）。像素颜色分不清"是哪个字"，字符码才是硬证据。

### 4.38 验「卡 6 底部迷你 6 通道逻辑条」（㊻ 新增，约 1 分钟）

spec §4.5（`docs/13_display_ui_requirements.md:190`）给卡 6 规定"底部迷你 6 通道逻辑条"。
本版把它落到卡 6 的 y 512..559：六道 = `io_state` 的 a/b/z/u/v/w（从上到下按位序）。

| # | 操作 | 期望 | 实测 |
|---|---|---|---|
| 112 | 进 P1 看卡 6（右下）底部 | 六条通道各一条**电平线**：高电平时**整条画满**（强调蓝），低电平时**只留左端一小段**（浅网格色）；六道之间互不粘连 | ☐ 是 ☐ 否 |
| 113 | 让 ABZ/UVW 输出的电平变化（转动/拨动，或按已有 Z/U/V/W 观察条件） | 对应那一道的长短**跟着变**；a/b/z 三道与 u/v/w 三道**分别**反映两组输出（不是复制同一路） | ☐ 是 ☐ 否 |
| 114 | 看卡 6 的状态条那一行与卡边框、卡内分隔线 | 状态条（●正常/▲警示/✖故障）**不被六道线覆盖**；卡片边框与卡内那条 1 px 分隔线也不被覆盖 | ☐ 是 ☐ 否 |

**易混点：**

> 1. **每道 8 px、不是 spec 的 16 px**：本工程卡片 256 高、底部可用带只有 64 px，`6 × 16 = 96 px` 放不下 ⇒ 按 8 px 落（共 48 px）。这是"卡片几何 288×256 vs 300×264"那一整笔偏差的一部分，不是随手压缩。
> 2. **低电平不是"没画"**：整条不画的话，"低电平"与"这一道缺失"在屏上分不清，所以低电平留 16 px 短桩。
> 3. **六道来自 `io_state` 的位 0..5**：`{limiter_active, dir, w, v, u, z, b, a}` ⇒ 上到下 = a/b/z/u/v/w；`limiter_active` 与 `dir` 不在六道里。
> 4. 判据在 `disp/tb_disp_engine.v` §[18]：三道高电平 + 带外不画 + 全低只剩短桩（像素级，颜色可区分高/低/白底）。

### 4.39 验「空态：P5 六状态表与 P2 四枚徽标逐格显示 -」（㊼ 新增，约 1 分钟）

spec §8-8（`docs/13_display_ui_requirements.md:351`）要求"信号不可信时不要显示像测量值的
数字"。㊷/㊸ 已经把 P1 的四个测量字段与四张测量卡做成空态；本版把同样的事做到
**P5 六状态表的「次数 / 占比」**与 **P2 右下四枚徽标**（Vpp / f / Δt / ΔV）。

空态的判据不是数字，是 `sig_bad`（无载波 ⇒ `amp_gone`）。

| # | 操作 | 期望 | 实测 |
|---|---|---|---|
| 115 | 把输入幅度降到阈值以下（或断开输入），进 P5 六状态表 | 六行（U高 / V低 / W低 …）的「次数」与「占比」**逐格显示 `-`**；不是 `0`、不是 `99999`、不是空白；状态名本身照旧可读 | ☐ 是 ☐ 否 |
| 116 | 回 P1 看右下四枚徽标（Vpp / f / Δt / ΔV） | 四枚**每枚逐格 `-`**（每枚 6 格）；不是 `0.00`、也不是空白 | ☐ 是 ☐ 否 |
| 117 | 恢复输入（幅度回到阈值以上、CRC 正常） | P5 与 P2 **立刻回到数字**，不需要重新上电 | ☐ 是 ☐ 否 |

**易混点：**

> 1. **`-` 与 `0` 是两件事**：`0` 是合法读数（这六种状态真的没出现过），`-` 是"没有读数"。两处都只写 `-`。
> 2. **不能用 `99999` 判空态**：它是 16 bit BCD 通路的**饱和点**（数满了就停在那里），拿它当哨兵会把"数满"和"没数"混成一件事（`disp/p5_view.v:199-203`）。
> 3. **本版空态只覆盖 P5 / P2 两处**：P1 四字段与四张测量卡是 ㊷/㊸ 做的，判据是同一条 `sig_bad`。
> 4. 判据在 `disp/tb_disp_engine.v` §[11b]：轮 B 判空态逐格 `-`，轮 C 撤销空态后**最右格必须回到数字码 8..17**（防"恒空"骗绿）。

### 4.40 验「面板里算出来的等效倍率与 AB 边沿率」（㊽ 新增，约 2 分钟）

spec §6.3（`docs/13_display_ui_requirements.md:284`）要求编辑面板**同时**显示
"等效倍率 = inter/div"与"预测的 AB 边沿率"。本版把这两个数算出来，写到面板右上角
两行 —— 面板开着才看得到，收起来这两行是空的。

| # | 操作 | 期望 | 实测 |
|---|---|---|---|
| 118 | P1 点卡片 2「倍频分频」开面板，把倍频按到 ×100、分频按到 ÷3（输入 68 Hz） | 面板右上第一行 `等效倍率  33.3`、第二行 `AB边沿率 9.1`（4 × 33.3 × 68 Hz = 9.06 kHz）；数字随按键**逐次变** | ☐ 是 ☐ 否 |
| 119 | 换成 ×64 ÷1 | 第一行 ` 64.0`、第二行 ` 17.4`（4 × 64 × 68 Hz = 17.4 kHz）；整数位不足三位时**前面留空格**，整数位为 0 时留一个 `0`（`0.3` 不会打成 ` .3`） | ☐ 是 ☐ 否 |
| 120 | 把输入幅度降到阈值以下（或断开输入、或让 CRC 报错） | 第二行整行变 `-`（四个空格 + `-`），第一行**照旧**显示倍率 | ☐ 是 ☐ 否 |

**易混点：**

> 1. **边沿率用的是等效倍率**：`4 × (inter/div) × f_in`。卡片 2 上的静态标签写的是 `边沿率 4×倍频×F`（v44（㊶）引入 `div` **之前**的写法），屏上这个数已按新口径算。
> 2. **单位是 kHz 一位小数**：` 17.4` 读作 **17.4 kHz**（不是 17.4 Hz、也不是 174）。上限 `999.9 kHz`，再大就饱和。
> 3. **`-` 只出现在边沿率那一行**：倍率永远算得出来（两个数都是设置值）；边沿率要乘 `f_in`，没有可信频率就没有读数。
> 4. **这两行属于面板层**，不写页面层；所以排除窗必须同时盖住标签与数值（只盖数值时，面板收起后标签会留在页面上）。
> 5. 判据在 `disp/tb_disp_engine.v` §[19]：逐格判字符码 + 两条层门控（面板开有墨 / 关归零）。

### 4.41 验「卡 6 的圈字形与次级行 U● V● W○」（㊾ 新增，约 2 分钟）

spec §4.5（`docs/13_display_ui_requirements.md:190`）给的卡 6 形态是主值行
`A● B● Z○`、次级行 `U V W`（电平用实心 / 空心圈）。本版把主值行的数字 `1/0`
换成圈字形，并把次级行补出来。两行都在卡 6 里：主值行 y 448..511（数值层），
次级行 y 416..431（**标签层** 行 26 列 46..53，紧贴大数字上方）。

| # | 操作 | 期望 | 实测 |
|---|---|---|---|
| 121 | 让 U/V/W 全为高电平（或按 P4 页看当前电平），看卡 6 大数字上方那一行 | `U● V● W●` —— 三个字母后面各一个**实心**圈 | ☐ 是 ☐ 否 |
| 122 | 把三路里的某一路（例如 W）变低 | 对应那个字母后面的圈变**空心** `○`，其余不动；三路各自独立 | ☐ 是 ☐ 否 |
| 123 | 看大数字那一行（主值行） | `A● B● Z○` 形态：字母不变，后面是实心/空心圈**而不是** `1` / `0` | ☐ 是 ☐ 否 |

**易混点：**

> 1. **同一个 `○` 在屏上是一个字，在字库里有两个编号**：标签层是 **183**、数值层是 **51**。两个平面的字符表与 ROM 本来就分开（lab 8 bit / val 6 bit），RTL 从不跨平面传码 —— 这样换来的好处是 **132 个汉字码一个都没动**。
> 2. **行 26 是卡片内容，不是面板层**：面板开着时它照旧可见，收起面板也不会消失；所以它**不在** `glyph_page` / `pnl_lab_cell` 的排除窗里。
> 3. **字母后面只跟一个圈**：`U●` `V●` `W●` 之间留一个空格（8 格 = `U`+电平+空格+`V`+电平+空格+`W`+电平），不要读成 `U ●`。
> 4. 判据在 `disp/tb_disp_engine.v` §[20]：三组电平（全高 / 单调高 / 主值行）逐格判字符码，并且**两组必须互换**，只写死一组会红。

### 4.42 验「卡片 3 ↔ P7、卡片 6 ↔ P4 两条下钻」（㊿ 新增，约 2 分钟）

spec §4.6（`docs/13_display_ui_requirements.md:195-204`）写的是「点卡片 3 → P7 标定、
点卡片 6 → P4 逻辑时序」。v20（⑳）曾把卡片 3 这一条删掉，理由是「§4.5 把第 3 张卡
的内容钉成『转速』，与『点它进标定页』像是矛盾」。本版按**双入口**收口：§4.5 管卡片
**画什么**、§4.6 管点击**去哪里**，两件事不冲突 —— 卡片 3 与标题带那颗「标定」按钮
都进 P7，两条路都算数。

| # | 操作 | 期望 |
|---|---|---|
| 124 | 在 **P1 总览**点第 3 张卡（右上角那张「转速」，中心约 x 880 / y 192） | 进 **P7 标定**页（页号 6），不是面板 |
| 125 | 回到总览，点第 6 张卡（右下角「ABZ/UVW」，中心约 x 880 / y 464） | 进 **P4 逻辑时序**页（页号 3） |
| 126 | 先点第 3 卡进 P7，再在 P7 上点同一处（x 880 / y 464 一带） | 页面**不动** —— 卡片命中区只在 P1 生效；另：标题带的「标定」按钮仍然独立可进 P7 |

**易混点：**

> 1. **同一块屏幕，两种「命中」**：P1 的 6 卡网格（`hit_id` 8..13，编号 = `8 + 列号 + 3×行号`）与面板/标题带按钮是两套命中区。落在 P1 才解释成卡片，其余页面同一个坐标不解释为卡片 —— 判据里专门有一条守住这一点。
> 2. **卡片 3 是双入口，不是替换**：标题带的「标定」按钮那一轮（⑲）保留至今，本版只是把「点卡片」这条老路补回来。两条路都进 P7 页号 6。
> 3. **点卡片 6 进的是 P4，不是面板**：**面板只有一条开法** —— 在 P1 点卡片 2（命中 id `9` = column 1 / row 0，`disp/hit_test.v:171` 起的 `HIT_CARD_B = 5'd8` 编号）。卡片 6 整卡命中走的是页面跳转；卡 6 底部那条**迷你逻辑条只是显示**，命中区里没有它，点它不会开面板。
>    ★ 纠错（U-55）：本行原文是"面板只由卡片 2 与卡 6 底部那条迷你逻辑条打开（后者是 ㊻ 加的）"，与代码不符 —— 全仓 `pnl_open_req` 只有**一处**置位，`disp/enc_top_disp.v:833` `if (tap_card_md && (page == 3'd0) && (dlg == 2'd0) && !w1c_busy)`，而 `tap_card_md` 只对 id 9 有效；那条迷你条没有任何命中 id。
> 4. 判据在 `disp/tb_enc_disp_panel.v` §8b：18 条，含「面板开着时点卡片不许翻页」「非 P1 页面点卡片不许翻页」，并有 `pg_chg >= 6` 一条**反骗绿**（实测翻了 8 次页）。

## 5. 第 4 步：试一次“改值 → 回读确认”（两个入口：长按 KEY1　或　点 P1 的「倍频分频」卡片）

这一步验证 **docs/13_display_ui_requirements.md 第 6.2 节的两阶段提交**：屏上写完寄存器之后
必须**读回来确认**，屏只允许显示"回读确认过的实际值"，这样"写成功"与"链路假死"才分得开。

本版的触发方式有**两个入口**（⑥ 之后新增了第二个）：

| 入口 | 操作 | 说明 |
|---|---|---|
| 长按板载 KEY1 | 按住约 **1 秒**（短按仍是翻页） | 2026-10-15 之前唯一的入口，仍保留 |
| 点屏 | P1 页点第 1 行第 2 张「倍频分频」卡片 | ⑥ 新增，走同一套命中判定 |

两者提交的是**同一个动作**：自动提交**下一个倍频档位**，序列是 `2 → 4 → 8 → 16 → 32 → 64 → 128 → 256 → 2` 循环（与 `rtl/abz_gen.v:118` 的编码一致，256 用寄存器值 0 表示）。

观察 **P1 页第 1 行第 2 张"倍频分频"卡片的底色**（这是 ③ 的可见反馈）：

| 底色 | `ui_state` | 含义 |
|---|---|---|
| 白（无变化） | 0 空闲 | 没有事务，或复位后的初始态 |
| **浅黄 `#FFF3CD`** | 1 进行中 | 写命令已发出，正在等回读 |
| **浅绿 `#E3F5E7`** | 2 已应用 | 回读与写入值一致 —— **写入真的生效了** |
| **浅红 `#FBD9D6`** | 3 失败 | 回读不一致，已自动回滚到旧值 |
| **深红 `#E8B4B0`** | 3 失败 | **连回滚也失败**（严重：写链路本身有问题） |

底色**会一直保留到下一次长按**（`disp/ui_edit.v` 的 `state` 只在收到新请求时才回到"进行中"），
所以不必抢着看：长按之后切回 P1，底色就是那次事务的最终结论。事务本身只要约 2.2 ms
（80 µs 前导 + 4 字节 × 5 µs + 80 µs 尾随 + 2 ms 等待 + 回读），人眼看不到"进行中"那一档。

真正稳的判据是卡片上的**数值**：

- 大字从 `×256 ÷1` 变成 `×128 ÷1`，再长按继续按序列走；
- **`×0` 不表示"0 倍"**。倍频寄存器 0 在 `rtl/abz_gen.v:118` 里表示 **256 倍**，所以第 8 次
  长按后屏上显示 **`×256 ÷1`**。本版专门修掉了"显示 ×0"这个数字与行为不一致的错误
  （`disp/val_format.v` 的映射 + `disp/tb_val_format.v` 第 3 轮把它钉住）。

| 现象 | 结论 |
|---|---|
| 数值按档位变化 | **写链路 + 回读确认成立**，③ 的骨架通了 |
| 数值不变、底色浅红 | 写进去了但回读不一致，已自动回滚（链路半通） |
| 数值不变、底色深红 | UART 回环本身不通，抄串口日志里的 `读次数 / 无应答 / 超时`（v58 已删 P8，屏上不再显示这三个数） |
| 长按没反应 | 板载 KEY1 是 Y9；长按要按住约 1 秒；短按只会翻页 |

> **为什么长按 KEY1 还没删掉**：按 `docs/13` 的约束 **C3**，触摸修好之后就应该走纯触屏、不留按键兜底；而这一版恰好就是“触摸命中判定做完了”的那一版。但命中判定**只在仿真里验过**（51 条断言），**没有一次上板记录**，它取代的旧入口却是上板验过的。删掉验过的、换成没验过的，等于拿一次“合规”换一次“可用” —— 万一实机上触摸的 Y 轴是反的，这一版连改倍频都做不成。所以这一版**双入口并存**，等触摸在实机上确认命中之后，删掉 `disp/enc_top_disp.v` 里约 25 行长按逻辑（`lp_cnt` / `lp_armed` / 那个 `else if` 分支），4.7 节开头写了这件事。理由与取舍见 `docs/ai-collaboration-log.md` 记录 17。

## 6. 故障树

**A. `读次数` 恒 0（主机没发）**

1. 确认 J9 / J10 都是 3.3 V；
2. 示波器看 **T4（`touch_scl`）**：IIC 只在传输时才有突发（约 201.6 kHz = 50 MHz ÷ (4×62)），不是连续的；一帧里应能看到若干次突发；
3. **T4 与 U5（`touch_sda`）都常高** → 主机一次都没发。查复位：`touch_rst_n`（**W4**）在复位释放后应为高；W4 一直低 = 复位没释放；
4. **SCL 有突发、SDA 常低** → 从机把总线拉死，或 IOBUF 方向反了（`disp/i2c_io_wrap.v` 里 `T` 必须接 `~oe`；接反的典型表现是"所有地址都像被 ACK、读回全 0"）；
5. 都不对 → 屏排线的 I2C 两针没接触好。

**B. `超时 != 0`（相位被拖住超过 40 ms）**

- 数据通路：`disp/i2c_master_seq.v` 的 `stop_cnt` 累到 `BUSY_LIMIT`（40 ms @50 MHz = 2,000,000 拍）算超时。**本版修掉了两处会让看门狗永不触发的缺陷**：原先 `stop_cnt` 只有 16 位（阈值被截成 34,048 ≈ 0.68 ms），而且它在"相位推进"分支里每拍被清零；现在改成 25 位、与未截断的 `BUSY_LIMIT` 比较，并且超时后走新增的 `S_RECOVER`（不看总线电平，纯打 10 个 SCL 时钟 + STOP）保证一定能产生 `done`。
- 若仍频繁 `超时` → 从机真的不在（走 C），或 SCL 被外部拉死。看 `超时` 的增长速度。

**C. `无应答 != 0`（从机不应答）**

- GT911 的 7 位地址是 `0x5D`、FT5206 是 `0x38`；**地址由 INT 在 RST 上升沿的电平决定**（低 → 0x5D）；
- 先看 `触摸IC` 有没有锁定型号；没锁定说明探测阶段两个地址都没应答 → 按 A 的 3、4 条查；
- I2C 靠外部上拉，模块侧上拉缺失会让 SDA/SCL 永远回不到高，表现也是 无应答。

**D. 通信正常但 `0x814E` 恒为 0（本板历史现象）**

按可能性从高到低：

1. **INT 上电时序**（`disp/enc_top_disp.v` 第 4.5 节）：RST 释放后 `touch_int` 还要保持低约 50 ms。示波器量 **T5（`touch_int`）**：
   - 复位期间应为**低**；
   - 释放后应再低约 **50 ms** 才回高；
   - 若一直低 → 上拉没生效（检查 XDC 里 `touch_int` 的 `PULLTYPE PULLUP` 是否存在，当前是有的）；
   - 若释放瞬间就是高 → 触摸 IC 被选到另一个地址（0x14），主机自然读不到；
2. **IC 配置没加载**：能读到 `产品号` 但内部配置全 0 属于这类。本设计 `CFG_WRITE_EN` 固定为 0，**故意不写配置表**，走 GT911 出厂配置；
3. 面板没插好，或触摸 IC 没供电。

**E. `触摸IC = ---`（两个地址都没应答）** → 走 A 与 C。

## 7. 现场记录

> **v58 注**：本表是 2026-10-15 第一次上板起的累计现场清单。第 **5、18–23、33、36–38、41、46、55、57、
> 70–75、85–87、97–99、115–117、129** 项涉及已删除的 P3/P5/P8、Tab/四徽标/「展开」/状态栏 ⚙，
> **仅作历史对照，不要再按它们判 FAIL**；v58 必测见 §0.1。

| # | 现象 | 实测 | 判定 |
|---|---|---|---|
| 1 | 上电后屏亮、显示 P1 总览 | ☐ 是 ☐ 否 | |
| 2 | P1 六张卡的数字都在变 | ☐ 是 ☐ 否 | |
| 3 | 右上角状态灯**上半**（抽头）在闪 | ☐ 是 ☐ 否 | |
| 4 | 右上角状态灯**下半**颜色 | ________ | |
| 5 | 按板载 KEY1 能依次切到 P2、P3、P4、P5、P6、P7、P8、回 P1（**八页全通**） | ☐ 是 ☐ 否 | |
| 6 | `读次数` 持续增长 | ☐ 是 ☐ 否 | |
| 7 | `产品号` = 57（'9'） | ☐ 是 ☐ 否 | |
| 8 | `0X814E` 按下后 ≥ 128 | ☐ 是 ☐ 否 | |
| 9 | 十字准星跟随手指 | ☐ 是 ☐ 否 | |
| 10 | 抬手后约 0.5 秒内准星消失 | ☐ 是 ☐ 否 | |
| 11 | 点左导航 `设置` 能跳到 P6 | ☐ 是 ☐ 否 | |
| 12 | 点左导航 `总览` 能回到 P1 | ☐ 是 ☐ 否 | |
| 13 | P1 点「倍频分频」卡片能改值（与长按 KEY1 等效） | ☐ 是 ☐ 否 | |
| 14 | 点 P1 卡片与导航栏之间的 16 px 空白（x 80…95）**什么都不触发**（不翻页也不改值） | ☐ 是 ☐ 否 | |
| 15 | 点左导航 `波形` 能进 P2，且第 2 项高亮 | ☐ 是 ☐ 否 | |
| 16 | P2 两条曲线连续：**无竖直接缝、无横向平移** | ☐ 是 ☐ 否 | |
| 17 | 接上信号源后 P2 曲线随信号动 | ☐ 是 ☐ 否 | |
| 18 | 点左导航 `XY` 能进 P3，且第 2 项高亮 | ☐ 是 ☐ 否 | |
| 19 | P3 中央出现**点阵圆**（接信号源后），无竖直接缝、无整体平移 | ☐ 是 ☐ 否 | |
| 20 | P3 中心一横一竖十字线可见 | ☐ 是 ☐ 否 | |
| 21 | 按 KEY1 能切到 `P5`（标题 `P5 状态`），六行占比都出来了 | ☐ 是 ☐ 否 | |
| 22 | P5 条形图每行长短不同、且与旁边的百分比对得上 | ☐ 是 ☐ 否 | |
| 23 | P5 底栏 `故障 000`（旧称 `BAD 000`）与 `111 PCT` 都是 `0.0` | ☐ 是 ☐ 否 | |
| 24 | 按 KEY1 能切到 `P7`（标题 `标定与误差可视化`），左框两条曲线都在 | ☐ 是 ☐ 否 | |
| 25 | P7 右栏六个标定参数与 `幅值` 都有数值 | ☐ 是 ☐ 否 | |
| 26 | 触发一次标定后，绿色（标定后）曲线比品红（标定前）更窄 | ☐ 是 ☐ 否 | |
| 27 | 左侧导航栏上**没有内容文字**（P5 的六行状态名、P6/P8 的标签与数值都不压进来） | ☐ 是 ☐ 否 | |
| 28 | P1 卡片左沿在 x≈96，与导航栏之间有约 16 px 空白；`1500.00` 不再伸出卡片右沿 | ☐ 是 ☐ 否 | |
| 29 | P2/P3/P4 都有页名与导航标签；P4 六条道有 A/B/Z/U/V/W 标注 | ☐ 是 ☐ 否 | |
| 30 | P5 第一行是真实占比，`故障 000` 与 `111 PCT` 都是 0.0（上一版第一行与 BAD 同时 99.9） | ☐ 是 ☐ 否 | |
| 31 | P1 三张卡上的陈旧脚注已消失；P2 波形左侧不再有平线 | ☐ 是 ☐ 否 | |
| 32 | P4 的绘图区与其它页同宽（944 px）；波形只画在右侧 856 px 里，箱宽约 6.7 px | ☐ 是 ☐ 否 | |
| 33 | P2 右下四枚徽标：标签 + 下面一行实时数值；不接信号源时四枚都是 0.0 | ☐ 是 ☐ 否 | |
| 34 | P6 设置页 3 列 x **5 行共 15 项**（㊳ 起补第五行：`增益S` / `增益C` / `相位修正`，项高 **88 px**） | ☐ 是 ☐ 否 | |
| 35 | P6 底部危险区：红框 + 警示三角 + `清除锁存故障`；**按住亮里侧内框、在按钮内松开才弹模态**，`CANCEL` 不写、`OK` 写 `0x0405 bit0` | ☐ 是 ☐ 否 | |
| 36 | 状态栏右端 `[信号●]` `[告警▲]` `[系统⚙]`；点 ⚙ 进 P8 | ☐ 是 ☐ 否 | |
| 37 | P2/P3 顶部两个页签（「模拟」/ `XY`），点它能互换 P2 与 P3；左侧导航「XY」仍在 | ☐ 是 ☐ 否 | |
| 38 | 标题带主操作按钮：P1 上是「标定」→ P7、P4 上是「展开」→ P5；另外两页上没有 | ☐ 是 ☐ 否 | |
| 39 | 点卡片 3（转速）**也**能进 P7（与标题带按钮双入口）；卡片 6 进 P4 | ☐ 是 ☐ 否 | |
| 40 | P4 时间轴下 8 个整度数字 `0`…`315`，每条正上方一根等间距刻度线；图上有 `按电角度重建128箱等效采样` | ☐ 是 ☐ 否 | |
| 41 | P5 六行有表格框 + 5 条行分隔线；条形区有 25/50/75% 三根浅蓝线与 `0`/`50`/`100`；框底不穿过 `111 PCT` 那一行 | ☐ 是 ☐ 否 | |
| 42 | P7 `幅值` 行显示百分比（带 `PCT`），触发标定后跟着变；门限越界时出现负号 | ☐ 是 ☐ 否 | |
| 43 | 点 P1 卡片 2 弹出编辑面板（只占下半屏），`[−]` / `[+]` / 滑条 / `CANCEL` / `APPLY` / `回到` 都在；面板开着时翻页与状态栏不响应 | ☐ 是 ☐ 否 | |
| 44 | 按住 `[+]` 约 0.6 s 后连走多档且按钮内侧有进度环；滑条上按下拖动直接吸附到档 | ☐ 是 ☐ 否 | |
| 45 | `APPLY` 后面板收起且卡片 2 显示**回读确认过**的新值；`CANCEL` 一个字节不写；`回到` 写回上一次值（两次互换） | ☐ 是 ☐ 否 | |
| 46 | P5 底栏是 `故障 000 PCT`，刻度行是 `0%` / `50%` / `100%` | ☐ 是 ☐ 否 | |
| 47 | P7「幅值」行的数值后有 `%`；P1 卡片 2 主值是 `×64 ÷1` | ☐ 是 ☐ 否 | |
| 48 | **面板关着时** P1 上没有任何面板标签；打开面板后 `倍频分频` / `PRESET` / `CANCEL` / `APPLY` / `回到` 都在 | ☐ 是 ☐ 否 | |
| 49 | 打开面板后右侧按钮上是 `↩ 回到 ×256`（复位后第一次；乘号紧贴数字、无前导零），按它能写回上一次值 | ☐ 是 ☐ 否 | |
| 50 | `APPLY` 成功后再打开面板，`×N` 里的 N 变成刚写进去的倍频；只按 `[+]`/`[−]` 不 APPLY 时 N 不变 | ☐ 是 ☐ 否 | |
| 51 | P6 上倍频/分频的前缀是 `×` `÷`（不是 `X` `/`）；P1 卡片 2 的脚注是 `边沿率 4×倍频×F` | ☐ 是 ☐ 否 | |
| 52 | 按住 `[−]`（或 `[+]`）不放：按钮内出现**圆弧**，从 **12 点方向**起、**顺时针**生长；**圆心附近是空的**（是环带不是实心圆） | ☐ 是 ☐ 否 | |
| 53 | 一直按住到顶：环**闭合成整圈**；松手环**立刻消失**、按钮回未按下态 | ☐ 是 ☐ 否 | |
| 54 | **短按**（< 0.6 s）不出现环、也不加速，但松手仍走一档（长按不是唯一入口） | ☐ 是 ☐ 否 | |
| 55 | P5 的表格是 **7 条行带**（表头 + 6 个状态）、行距明显比正文行大（**30 px**）、**5 列**且列宽 **188 px** | ☐ 是 ☐ 否 | |
| 56 | 五列依次是 序号 / 状态（`U高 V低 W低`）/ 次数 / 占比（`dd.d`）/ 条形图；条形长度与占比数值一致 | ☐ 是 ☐ 否 | |
| 57 | P5 的 `故障 000 PCT` 与 `111 PCT` 在**表格下方**的脚注行（不是表格里的行）；其余七页版面一行没变 | ☐ 是 ☐ 否 | |
| 58 | 六张卡片底部各有一行状态词（`● 正常` / `▲ 警示` / `✖ 故障`），符号与汉字都清晰、不压卡片框、不压大数字 | ☐ 是 ☐ 否 | |
| 59 | 人为造出告警/故障条件（例如摘掉 UVW 一路使能）后，**对应那张卡**的状态词跟着变（其余卡不变） | ☐ 是 ☐ 否 | |
| 60 | 面板开着时长按步进仍走档、`↩ 回到 ×N` 正确，且卡片 2 的状态词那一行没有闪烁/花字 | ☐ 是 ☐ 否 | |
| 61 | 正常态六张卡的状态条都**没有色块**，黑字 `● 正常` 清晰压在白底上，不压大数字 | ☐ 是 ☐ 否 | |
| 62 | 造出告警/故障后，**对应那张卡**变成状态色底 + 白字（警示橙底、故障红底），其余卡仍是黑字 | ☐ 是 ☐ 否 | |
| 63 | 色块只盖住状态条那一行（不压 48 px 数值、不串到隔壁卡），面板开着时第一排三张卡的状态条仍正常 | ☐ 是 ☐ 否 | |
| 64 | P6 标题带右侧出现一颗「闪烁」按钮，里面有 16 × 16 复选框（默认实心 = 开），点一下变空心 = 关 | ☐ 是 ☐ 否 | |
| 65 | 造出告警/故障后，对应那张卡的状态条在「状态色底 + 白字」与「黑字常态」之间以约 0.51 s 翻转（正常卡不闪） | ☐ 是 ☐ 否 | |
| 66 | 把复选框点成空心后闪烁立刻停住、但**色块 + 白字仍在**（关的是闪烁不是反转）；其余七页与面板开着时一行没变 | ☐ 是 ☐ 否 | |
| 67 | P1 编辑面板右上角出现「键盘」按钮，点进去是 3 列 × 4 行数字键 + 右上三位输入窗，`[−]/[+]` 与滑条消失；输入窗显示当前回读值 | ☐ 是 ☐ 否 | |
| 68 | 依次点 2 5 6 → 输入窗显示 256；再点一个数字键**不变**；点 ← 两次退到 2；点 ↵ 后是「待应用 黄」，点 APPLY 才写入并回读 | ☐ 是 ☐ 否 | |
| 69 | 键盘里点 CANCEL 只退键盘（面板还在）、再点一次才收面板；按住数字键只高亮不连击；切页后键盘自动收起；其余七页与 ㉗㉘㉙ 的行为一行没变 | ☐ 是 ☐ 否 | |
| 70 | 从状态栏 ⚙ 进 P8：页标题变成 `P8 系统信息`，三行标签为 `设备 ID / 固件版本 / 触摸 IC`、`IIC 读 / 无应答 / 超时`、`LUT % / BRAM % / DSP %` | ☐ 是 ☐ 否 | |
| 71 | `设备 ID = ENCC1`、`固件版本 = V55`（显示侧常量，随位流版本走），`触摸 IC` 跟实际型号（未知则 `---`） | ☐ 是 ☐ 否 | |
| 72 | `IIC 读` 随触摸增长、`无应答/超时` 正常为 0；`LUT %/BRAM %/DSP % = 70/41/24`；底栏 `中断电平/翻转/复位次数` 一行没变 | ☐ 是 ☐ 否 | |
| 73 | 从状态栏 ⚙ 进 P8 看底栏最右端：静态标签 `自检结果` 后面是结论两个字，正常通信时为 `通过`（上电首帧前是静态占位 `失败`） | ☐ 是 ☐ 否 | |
| 74 | 结论与第 15 格行明细同源：`IIC 读≠0` 且 `无应答=0` 且 `超时=0` ⇔ `通过`，任一不满足 ⇒ `失败` | ☐ 是 ☐ 否 | |
| 75 | 拔触摸排线（或造出 NAK/超时）：结论两帧内变 `失败`、对应计数同时涨；插回后回到 `通过` | ☐ 是 ☐ 否 | |
| 76 | 进 P6：危险区横条上沿贴在 `SHIFT` 数值格下方约 8 px（y 504）、到屏底 y 599，高 96 px、宽 944 px | ☐ 是 ☐ 否 | |
| 77 | 按钮框 y 520..583（64 px、中心 552）在危险区正中；三角尖顶 532 / 底边 572 与按钮同一中线 | ☐ 是 ☐ 否 | |
| 78 | 按钮框外 4 px（y 516 / y 587 / x 188）点一下仍弹模态；再远一点（y 508 / y 595 / x 180）不弹 | ☐ 是 ☐ 否 | |
| 79 | 进 P4：轨迹区左下角那行小字逐字是 `按电角度重建128箱等效采样`（14 格），不是旧的 `128点等效采样` | ☐ 是 ☐ 否 | |
| 80 | 行 27（y 432..447）没压到波形 / 轴标 / 刻度；「按 / 重 / 建 / 箱」四个新字都有形、无断笔 | ☐ 是 ☐ 否 | |
| 81 | 屏上文字与 spec §7（`docs/13:305`）的原话对齐：「按电角度」+「128 箱」+「等效采样」，不再是「点」 | ☐ 是 ☐ 否 | |
| 82 | 进 P1：「转速」卡 `RPM` 下面那行小字逐字是 `估算值`（3 格，字符码 167/168/126） | ☐ 是 ☐ 否 | |
| 83 | 「累计转数」卡标题下面那行小字逐字是 `本次上电起算`（6 格：本/次/上/电/起/算） | ☐ 是 ☐ 否 | |
| 84 | 两句话与 spec §7（`docs/13:300` / `:302`）原话对齐；「估 / 算 / 上 / 起」四个新字都有形、无断笔（字库 171 码） | ☐ 是 ☐ 否 | |
| 85 | P5 第 2 列六行逐字是 `U高 V低 W低` / `U低 V高 W低` / `U高 V高 W低` / `U低 V低 W高` / `U高 V低 W高` / `U低 V高 W高` | ☐ 是 ☐ 否 | |
| 86 | 「高」（码 171）/「低」（码 172）两个字有形、无断笔，落在行带内不打格线 | ☐ 是 ☐ 否 | |
| 87 | 五列语义与 30 px / 188 px 几何没变；其余七页一行未变（字库 173 码） | ☐ 是 ☐ 否 | |
| 88 | P6 危险区按钮按住时会亮出里侧 2 px 红内框，且按住期间**不弹**询问态 | ☐ 是 ☐ 否 | |
| 89 | 在按钮内松开才弹询问态；按住后滑出按钮再松开**不受理**（不弹、不写寄存器） | ☐ 是 ☐ 否 | |
| 90 | 询问态下按钮矩形保持可见（底色变浅、标签仍在），按钮之外整片危险区照旧压暗 | ☐ 是 ☐ 否 | |
| 91 | P6 五行等距（项高 88 px），标题与数值各落在自己带内、带间不粘连 | ☐ 是 ☐ 否 | |
| 92 | 第 5 行三项「增益S / 增益C / 相位修正」有形，复位默认读数是 `1.000` / `1.000` / `+0.000` | ☐ 是 ☐ 否 | |
| 93 | 第 1 行标题上方无残留文字；第 5 行数值下沿（y 481）与危险区上沿（504）之间是空白 | ☐ 是 ☐ 否 | |
| 94 | P6 危险区是**两颗对称按钮**（左 `清除锁存故障` / 右 `恢复默认`，各 412 px、缝 16 px），标签都居中 | ☐ 是 ☐ 否 | |
| 95 | 点右那颗 `恢复默认` → 对话框标题 `恢复默认` / 正文 `REG 0X0100-051A` → `OK`：13 条命令发完（约 8.8 ms）后 15 项读数全部回到复位默认值，屏上无红 ✖ | ☐ 是 ☐ 否 | |
| 96 | 再点右那颗 → `CANCEL`：一个字节都不发、读数一项不变；左那颗 `清除锁存故障` 的行为与 ㊲ 一致 | ☐ 是 ☐ 否 | |
| 97 | P2/P3 的页内 Tab 第一格是 **「模拟」**（不再是 ASCII `SIM`）、第二格仍是 `XY`；点它仍能互换 P2/P3 | ☐ 是 ☐ 否 | |
| 98 | P4 标题带按钮上是 **「展开」**（不再是 `EXPAND`，与 P1「标定」同格列 x 720..751）；点它进 P5 | ☐ 是 ☐ 否 | |
| 99 | 新字 `模`/`拟`/`展`/`开` 笔画完整（字库 183 码 = 51 ASCII + 132 汉字、144,768 bit）；同页其它标签没串位 | ☐ 是 ☐ 否 | |
| 100 | P1 卡片 2 的面板标题带左边那颗 64×64 小方按钮里是 **×**；点一下变 **÷**，且**数值窗待应用值不变**（切字段不算改动） | ☐ 是 ☐ 否 | |
| 101 | 切到 ÷ 后 `[−]`/`[+]`/滑条/键盘只动 **分频 ÷1…÷8**、两端夹住不绕回；`APPLY` 后卡片 2 副文本与 P6「分频」读数都是新值、倍频读数没变 | ☐ 是 ☐ 否 | |
| 102 | `BACK` 把**分频**退回改之前的值（倍频全程没被动过）；撤销标签是 **9 格** `↩回到×N ÷M` | ☐ 是 ☐ 否 | |
| 103 | 让编码器链路锁存故障位置位（`disp_tap[126]`，**sticky**），停在 P1：四个**测量**字段整格变 `-`（小数点还在） | ☐ 是 ☐ 否 | |
| 104 | 同一状态下四张测量卡的迷你状态条是 **✖ 故障**、顶栏告警灯故障；卡 2 / 卡 6 仍按自己的判据 | ☐ 是 ☐ 否 | |
| 105 | **复位编码器**（`rst_n` / 重新配置器件）让 `[126]` 落下后，四个测量字段**自己回到数字**（显示侧不加锁存、不用重新进页），状态条回到 ●/▲/✖ | ☐ 是 ☐ 否 | |
| 106 | 编码器停摆：让幅值掉到下限以下（拔磁环 / 关载波），停在 P1：四个**测量**字段整格变 `-`（小数点还在），四张测量卡 **✖** 故障；倍频分频与 ABZ/UVW 字段不动。**不 sticky** | ☐ 是 ☐ 否 | |
| 107 | 接回载波（幅值回窗口内）：四个测量字段**自己回到数字**，不用进页/复位；状态条回到 ●/▲/✖ | ☐ 是 ☐ 否 | |
| 108 | 口径区分：幅值在窗口内但只有 `cor_sat`/`amp_bad` 标志为真 ⇒ 读数**照常显示**，只有卡 3/卡 4 转 ▲/✖、顶栏告警灯亮 | ☐ 是 ☐ 否 | |
| 109 | 进 P1 看每张卡内部：数值大字下面、次级信息上面 | 一条 **1 px 浅蓝（#D6E3F0）分隔线**，左右各距卡边约 16 px；**上下相邻行没有**（严格 1 px）；第二排同样有 | ☐ 是 ☐ 否 | |
| 110 | 看卡 4 次级行 `POS 0X` + 8 位十六进制 | 数字**在变**（转动编码器时）；空态（链路/无载波）时**仍显示**（位置回读不是测量值） | ☐ 是 ☐ 否 | |
| 111 | 看卡 3 与卡 4 的次级行 | 卡 3 有 **`方向 CCW`**（spec :187 归属转速卡）；卡 4 **不再**有 `方向 CCW` | ☐ 是 ☐ 否 | |
| 112 | 进 P1 看卡 6 底部：六条通道（上到下 a/b/z/u/v/w） | 高电平**整条画满**、低电平**只留左端短桩**；六道不粘连；边框与卡内 1 px 分隔线不被覆盖 | ☐ 是 ☐ 否 | |
| 113 | 让 ABZ/UVW 电平变化 | 对应那一道长短跟着变；a/b/z 与 u/v/w **分别**反映两组输出 | ☐ 是 ☐ 否 | |
| 114 | 看卡 6 状态条那一行 | 迷你状态条（●/▲/✖）不被六道线覆盖（带外不画） | ☐ 是 ☐ 否 | |
| 115 | 把幅度降到阈值以下（或断开输入），进 P5 六状态表 | 六行「次数 / 占比」**逐格 `-`**；不是 `0` / `99999` / 空白 | ☐ 是 ☐ 否 | |
| 116 | 回 P1 看右下四枚徽标（Vpp / f / Δt / ΔV） | 四枚**每枚逐格 `-`**（每枚 6 格） | ☐ 是 ☐ 否 | |
| 117 | 恢复正常输入 | P5/P2 **立刻回到数字**，不用重新上电 | ☐ 是 ☐ 否 | |
| 118 | 面板里 ×100 ÷3（输入 68 Hz） | 右上 `等效倍率  33.3` / `AB边沿率 9.1`；随按键逐次变 | ☐ 是 ☐ 否 | |
| 119 | 面板里 ×64 ÷1 | 右上 ` 64.0` / ` 17.4`；整数位为 0 时留一个 `0` | ☐ 是 ☐ 否 | |
| 120 | 降到阈值以下（或让 CRC 报错） | 边沿率整行 `-`，等效倍率照旧 | ☐ 是 ☐ 否 | |
| 121 | 让 U/V/W 全为高电平 | 卡 6 大数字上方 `U● V● W●`（实心圈） | ☐ 是 ☐ 否 | |
| 122 | 把某一路（如 W）变低 | 那一格的圈变空心 `○`，另两格不动 | ☐ 是 ☐ 否 | |
| 123 | 看主值行 | `A● B● Z○` 形态，字母后是圈而不是 `1`/`0` | ☐ 是 ☐ 否 | |
| 124 | 在总览点第 3 张卡（约 880,192） | 进 P7 标定页（页号 6） | ☐ 是 ☐ 否 | |
| 125 | 回总览点第 6 张卡（约 880,464） | 进 P4 逻辑时序页（页号 3） | ☐ 是 ☐ 否 | |
| 126 | 进 P7 后点同一处 | 页面不动（卡片只在 P1 生效）；标题带按钮仍进 P7 | ☐ 是 ☐ 否 | |

## 8. 结论怎么下

| 现场结果 | 结论 | 下一步 |
|---|---|---|
| `读次数` 持续增长、`0X814E` 按下后 ≥ 128 | **根因就是主机相位被拖死后 `done` 永不到达**，触摸字段整体冻结；看门狗修复生效 | 进入 P6 的编辑交互（改值 → 回读确认 → 生效/回滚） |
| `读次数` 在涨、`无应答 = 0`，但 `0X814E` 恒 0 | 问题在触摸 IC 侧 | 按 **D** 查 INT 上电时序（下一个最可疑的点） |
| `读次数` 不涨 | 还有一层 I2C 通路问题 | 按 **A** 用示波器查 T4/U5/W4 |
| `无应答` 在涨 | 地址或接线 | 按 **C** |
| 第 11…14 项（点屏）有失败 | 命中判定与实机坐标不符（Y 轴反了 / 标定偏移） | 记下“点哪儿跳哪儿”；**先别删 KEY1 兜底** |
| 第 15…17 项（P2 波形）有失败 | 波形区几何、双缓冲或管线对齐有问题 | 记下「接缝 / 平移 / 静止」三样现象，对照 `DEV_STATUS.md` 的 `U-14` |
| 第 18…20 项（P3 XY 图）有失败 | 点阵几何、双缓冲或管线对齐有问题 | 记下「有没有圆 / 是不是中心一个点 / 点阵有没有整体偏 1 px」，对照 `DEV_STATUS.md` 的 `U-15` |
| 第 21…23 项（P5 六状态表）有失败 | 占比统计（时间窗口/除法/BCD）或条形图映射有问题 | 记下「六个状态是不是都出现过 / 占比之和是不是接近 100 / 条形图有没有整行不动」，对照 `DEV_STATUS.md` 的 `U-17` |
| 第 24…26 项（P7 标定与误差可视化）有失败 | 分箱累积 / dump 流水 / `calib_busy` 边沿分 bank 有问题，或标定本身没生效 | 记下「两条曲线是不是都出现 / 触发标定后绿色有没有变窄 / 六个参数有没有更新」，对照 `DEV_STATUS.md` 的 `U-18` |
| 第 27…28 项（版面右移）有失败 | 文字/卡片几何与 `disp/disp_engine.v` 的 `CARD_X0/1/2`、`disp/val_format.v` 的 `f_col`、`tools/gen_text_ram.py` 的 `P*_LAB` 不一致（同一份几何的多份抄写） | 记下「哪个标签贴到了导航栏 / 哪个数字伸出了卡片」，对照 `DEV_STATUS.md` 的 `U-20` |
| 第 29…31 项（上板缺陷修复）有失败 | 文字层门控（`txt_page`/`lab_ch_raw`/`val_ch_raw`）、P5 的 uvw 码映射、或 `wave_trace` 的 `de` 门控漏了一处 | 记下「哪一页没有文字 / 哪一行的占比不对 / 平线还有多长」，对照 `DEV_STATUS.md` 的 `U-21` |
| 第 32…33 项（P4 加宽 + P2 徽标）有失败 | P4 的摊箱换算（`logic_scope.v` 的 `(dx × 153) >> 10`）、`lg_edge`/`lg_tband` 门控，或 `p2_badge` 的字段列号 / 量程口径 | 记下「P4 哪一段不对 / 哪一枚徽标不对、显示的是什么值」，对照 `DEV_STATUS.md` 的 `U-22` |
| 第 34…36 项（P6 12 项 + 危险区二次确认 + 状态栏三入口）有失败 | `disp/text_ram.v` 的 P6 版面（格行 3/11/19/27）、`disp/p6_view.v` 的 12 字段表、`disp/enc_top_disp.v` 的模态 FSM（`dlg`）与 W1C 通道（`CMD_B0`/`CMD_B1`/`VERIFY`）、`disp/disp_engine.v` 的 `ui_dlg` 门控、或 `hit_test` 的 `HIT_SYS` / 策略层的坐标判据 | 记下「哪一项没出现 / 对话框没弹或弹了还能点到下面 / ⚙ 点了没反应」，对照 `DEV_STATUS.md` 的 `U-23` |
| 第 37…39 项（P2/P3 页内 Tab + 标题带按钮 + P7 入口）有失败 | `disp/disp_engine.v` 的 `tab_page` / `tb_page` 门控与 `bg_sel` 链、`disp/hit_test.v` 的 `TBTN_*` 与 `HIT_TITLE_BTN = 5'd15`、`disp/enc_top_disp.v` 的 `tap_tab_*` / `tap_title_btn` 路由、或 `disp/text_ram.v` 的「模拟」/ `XY` / 「展开」/ 「标定」四处格位（㊵ 起 Tab 与标题带按钮都是汉字） | 记下「哪一项没出现 / 点了不切页 / 在两页都出现」，对照 `DEV_STATUS.md` 的 `U-24` |
| 第 40…42 项（P4 刻度 + P5 表格刻度 + P7 百分比）有失败 | `disp/disp_engine.v` 的 `p4_tx` 八个比较点 / `p5_frame` / `p5_rowsep` / `p5_grat` 与 `bg_grid` / `bg_edge` 合成链、`disp/p7_view.v` 的 `pct_*` 通路与 `S_PCT` 状态、`disp/enc_disp_tap.v` 与 `disp/enc_top_disp.v` 的两个新抽头位（375 位），或 `rtl/SPEC_interface_contract.md` §2.2 的位表 | 记下「哪根刻度不在 / 框线穿没穿字 / 百分比会不会跳成 X」，对照 `DEV_STATUS.md` 的 `U-25` |
| 第 43…45 项（编辑面板 + 长按/拖拽 + 回到上一次值）有失败 | `disp/ui_panel.v` 的手势与档位状态机、`disp/hit_test.v` v22 的 `held` / `rel_stb` / `cur_x` / `cur_y`、`disp/enc_top_disp.v` 的 `u_ui_panel` 例化与模态守卫、`disp/val_format.v` 的 `pnl_on` / `pnl_inter`、`disp/disp_engine.v` 第 5.13 段的绘制，或 `disp/ui_edit.v` 的请求 mux | 记下「面板开没开 / 哪个控件不响应 / 值有没有回读确认」，对照 `DEV_STATUS.md` 的 `U-26` |
| 第 46…48 项（字库扩容 / 面板标签）有失败 | `tools/gen_font_rom.py` 与 `tools/gen_text_ram.py` 的字符表（两处抄写）、`disp/font_rom.v` / `disp/text_ram.v` 的 8 bit 码宽、`disp/disp_engine.v` 的 `lab_ch_*` 位宽与 `glyph_page` 的 P1 排除项、`disp/val_format.v` 的 `CH_MUL` / `CH_DIV` | 记下「哪一页哪个字不对 / 面板关着时有没有标签」，对照 `DEV_STATUS.md` 的 `U-27` |
| 第 49…51 项（面板 `↩ 回到 ×N` / 全局 `×` `÷`）有失败 | `disp/undo_lab.v`（7 拍写序 / double-dabble / 前导零抑制 / `avail=0` 分支）、`disp/disp_engine.v` 的 `pnl_undo_inter` 端口与 `p1_lab_ram` 写口（原来写死 `.we(1'b0)`）、`disp/font_rom.v` 的 `↩`（索引 47）、`disp/p6_view.v` 的 `CH_MUL` / `CH_DIV`，或 `tools/gen_text_ram.py` 的 P1 脚注 | 记下「按钮上到底是什么字 / 有没有 `↩` / P6 前缀是不是 `×` `÷`」，对照 `DEV_STATUS.md` 的 `U-28` |
| 第 52…54 项（长按进度真圆环）有失败 | `disp/ring_lut.v`（生成表的内容与地址接线 `{jv, ju}`）、`disp/disp_engine.v` 的 `ring_fold` / 象限装配（`px2[5]` / `py2[5]`）/ 取数级（S1 给地址、S2 收数据）、`tools/gen_ring_lut.py` | 记下「环还是不是矩形 / 起点与方向 / 圆心有没有像素 / 满格是否整圈」，对照 `DEV_STATUS.md` 的 `U-29` |
| 第 97…99 项（Tab「模拟」/ 按钮「展开」按 spec 字面）有失败 | `tools/make_cn_glyphs.py` 的 `CN_ORDER`（模/拟/展/开 = 128..131 ⇒ 码 **179..182**）、`tools/gen_text_ram.py` 的 `P2_LAB`/`P3_LAB` 的 `(7, 11, "模拟")` 与 `P4_LAB` 的 `(2, 45, "展开")`（改完必须重跑生成器）、`disp/font_rom.v` 的 183 码 / 144,768 bit、`disp/tb_font_rom.v` 的 `NC` / `NCH` 两个规模常量、`disp/tb_disp_engine.v` §[8] 段的码位判据 | 记下「Tab 上还是 SIM / 按钮上还是 EXPAND / 汉字缺笔画 / 只显示一个字 / 老标签串位」，对照 `DEV_STATUS.md` 的 `U-44` |
| 第 100…102 项（面板 ÷ 分频八档步进）有失败 | `disp/ui_panel.v` 的 `P_FLD = 4'd8` / `pnl_fld` / `pnl_didx` / `pnl_pend`（两字段同比）/ APPLY 的 `req_div_code <= pnl_didx` / 开面板 `pnl_inter <= tap_inter`（不吸附）、`disp/disp_engine.v` 的 `FLD_X0/X1/Y0/Y1 = 240/304/344/408` 与 `fld_*` 图形、`pnl_ai`（滑条游标）、`disp/val_format.v` 的 `pnl_div`、`disp/undo_lab.v` 的 `div` 与 `LAB_N = 4'd8`（9 格）、`disp/enc_top_disp.v` 的 `u_disp` / `u_ui_panel` 例化（`pnl_fld` / `pnl_didx` / `pnl_undo_div` 三根线）、`tools/gen_text_ram.py` 的 P1 第 34 行注释（改完必须重跑生成器） | 记下「按钮里没有 ×/÷ / 切了字段但 APPLY 没写分频 / 倍频被顺手改了 / 撤销标签少一位或 ÷M 写错 / 键盘收了 0 或 9」，对照 `DEV_STATUS.md` 的 `U-45` |
| 第 103…105 项（空态：链路不可信时测量字段显示 `-`）有失败 | `disp/disp_engine.v` 的 `sig_bad` 与 `disp/enc_disp_tap.v` 的链路锁存位（**只认链路**；`cor_sat`/`amp_bad` 各自落在 卡 3/卡 4 的判据上，不并进来）、`disp/val_format.v` 的 `nodata` 分支与 `CH_MINUS` / `CH_DOT`、`disp/stat_chip.v` 的 `sig_bad` 四条判据、`disp/enc_top_disp.v` 的 `u_disp` 例化（`.sig_bad`） | 记下「链路一直报错但卡片还是 ● 正常 / 测量字段不变 `-` / 倍频分频也被写成 `-` / 恢复后不回来（锁存了）」，对照 `DEV_STATUS.md` 的 `U-46` |
| 第 106…108 项（停摆空态：无载波时测量字段显示 `-`）有失败 | `disp/disp_engine.v` 的 `wire amp_gone = (tap_amp_sq < tap_amp_low_sq);` 与 `wire sig_bad = amp_gone;`（**只看幅值低侧**、严格小于、不用 `[128] amp_bad` 标志）、`tap_amp_sq` / `tap_amp_low_sq` 两条抽头与 `disp/enc_top_disp.v:1074-1076` 的接线、`disp/val_format.v` 的 `nodata` 分支、`disp/stat_chip.v` 的 `sig_bad` 四条判据 | 记下「停摆后读数还是数字 / 静止被误判成停摆 / 幅值**等于**下限就变 `-` / 只有 amp_bad·cor_sat 时读数也变 `-`（口径打穿轮 B2）/ 恢复后不回来（锁存了）」，对照 `DEV_STATUS.md` 的 `U-47` |
| 第 109…111 项（卡内分隔线与卡 4 pos_full）有失败 | `disp/disp_engine.v` 的 `card_div`（`ly == 110`、`lx ∈ [16, CARD_W-16)`）与 `bg_grid` 的 `C_GRID` 条件、`disp/pos_hex.v`（行 35 / 列 12..19 / 最高位先写）、三个写者的仲裁（`p1_we = ul_we | sc_we | ph_we`、`pos_hex` 的 `hold = ul_we | sc_we`）、`tools/gen_text_ram.py` 的 `(35,6) POS 0X` 与 `(17,46) 方向 CCW` | 记下「没有线 / 线 2 px 或越界 / 十六进制不动 / 十六进制错位或少了高两位 / 卡 4 还写着方向 CCW」，对照 `DEV_STATUS.md` 的 `U-49` |
| 第 112…114 项（卡 6 六通道逻辑条）有失败 | `disp/disp_engine.v` 的 `C6_X0/X1/Y0 = 752/1007/512`、`c6_k/c6_band/c6_mid/c6_lvl/c6_stub` 与 `bg_c6` 的插入位置（`bg_sel` 之后、`bg_grid` 之前）、`q_io_state` 的位序 `{limiter_active,dir,w,v,u,z,b,a}` | 记下「没有线 / 六道糊成一片 / 低电平也整条画 / 状态条被盖住 / 某一道与别的道相同」，对照 `DEV_STATUS.md` 的 `U-50` |
| 第 115…117 项（P5/P2 空态）有失败 | `disp/p5_view.v` 与 `disp/p2_badge.v` 的 `wdata` 三目（`sig_bad ? 8'd2 : cur_ch`，码 2 = `-`）、`disp/disp_engine.v` 里两个例化的 `.sig_bad(sig_bad)`、`sig_bad = amp_gone` | 记下「还是显示 0 / 显示 99999 / 显示空白 / 只有一处变 / 恢复后不回数字」，对照 `DEV_STATUS.md` 的 `U-51` |
| 第 118…120 项（面板等效倍率 / AB 边沿率）有失败 | `disp/pnl_calc.v`（恢复余数分频器 12 / 24 拍、拆位 ×1000 = 1024−16−8 与 ×100 = 64+32+4）、`disp/disp_engine.v` 的 `u_pnl_calc` 例化与 `EQ_ROW/EQ_COL/RT_ROW/RT_COL`（行 23 列 41 / 行 25 列 42）、`glyph_page` 与 `pnl_lab_cell` 两处排除窗 | 记下「哪个数错 / 差几位 / 整体错一格 / 出现空白导致错位 / 只有 `-` 不对」，对照 `DEV_STATUS.md` 的 `U-52` |
| 第 121…123 项（卡 6 圈字形 / 次级行）有失败 | `disp/uv_state.v`（行 26 列 46..53 八格、码 `U/V/W = 38/39/40`、`● = 48`、`○ = 183`）、`disp/val_format.v` 的 `CH_DOTF = 6'd48` / `CH_CIRC = 6'd51`、`tools/gen_text_ram.py` 与 `tools/gen_font_rom.py` 的 `VAL_EXTRA` / `LAB_EXTRA`、`disp/disp_engine.v` 的五级写口仲裁 `ul > sc > ph > pc > uv` | 记下「哪个字母缺 / 圈不变 / 圈是实心还是空心 / 整行错一格 / 面板收起后才消失」，对照 `DEV_STATUS.md` 的 `U-53` |
| 第 124…126 项（卡片 3 → P7 / 卡片 6 → P4）有失败 | `disp/enc_top_disp.v` 的 `HIT_CARD_ABZ = 5'd13`、`wire tap_card_cal` / `tap_card_abz`、以及 `page` 那个 always 块里的 `if (tap_card_cal && (page == 3'd0)) page <= 3'd6;` / `if (tap_card_abz && (page == 3'd0)) page <= 3'd3;`；卡片几何在 `disp/hit_test.v`（编号 = `8 + 列号 + 3×行号`） | 记下「点了不翻 / 翻错页 / 面板开着也翻了 / 在 P7 上点同一处也翻了」，对照 `DEV_STATUS.md` 的 `U-54` |
| 第 94…96 项（危险区第二颗按钮「恢复默认」）有失败 | `disp/ui_restore.v`（13 条命令表 / `GAP_CLK` / 17 项比对 / `bad` 的位序）、`disp/enc_top_disp.v` 的 `DZ_HIT_X0/X1` 与 `DZ2_HIT_X0/X1`（= 画框 ±8 px）与 `ui_restore` 例化、`disp/disp_engine.v` 的 `DZ_BTN2_X0/X1` / `DLG_ROW3` / `DLG_ROW4` / `BAD_COL0..2` / `bad_bit_i` / `lab_ch_ovr`、`tools/gen_text_ram.py` 的 P6 两套对话框行（改完必须重跑生成器）；端到端台的第 11 段钉着这条链路 | 记下「按右那颗弹出左那颗的对话框 / 对话框文字串位 / 某项没回默认 / 红 ✖ 落在错的格位（行带号算错）」，对照 `DEV_STATUS.md` 的 `U-43` |
| 第 91…93 项（P6 补齐第五行、项高字面 88）有失败 | `disp/disp_engine.v` 的 `P6_TY0`/`P6_TY1`/`P6_VPH`/`P6_LAB_R0`/`P6_VAL_R0` / `p6_k` / `p6_v` / `p6_lvis` / `p6_vvis` 与两处 RAM 行地址 mux、`tools/gen_text_ram.py` 的 `P6_LAB`/`P6_VAL`（改完必须重跑 `python tools/gen_text_ram.py`）、`disp/p6_view.v` 的 15 字段表与 `K_Q15`；引擎台的第 5 行像素计数与残墨判据钉着这三点 | 记下「五行不等距 / 标题或数值跑到带外 / 第 5 行读数错（进位或符号）/ 旧行残留文字回来了 / 对话框文字被排除吃掉」，对照 `DEV_STATUS.md` 的 `U-42` |
| 第 88…90 项（危险区按钮的按下反馈）有失败 | `disp/disp_engine.v` 的 `dz_btn_in` / `dz_btn_in_edge` / `dz_press` / `dz_keep`，或 `disp/enc_top_disp.v` 的 `dz_prs_lvl` / `dz_latch` / `dz_click`；引擎台第 ⑥ 段与端到端台第 10 节钉着这三点 | 记下「按住没有内框 / 按住就弹窗（旧行为回来了）/ 询问态下按钮被压暗 / 滑出再抬也弹窗」，对照 `DEV_STATUS.md` 的 `U-41` |
| 第 85…87 项（P5 六行状态名改汉字写法）有失败 | `tools/gen_text_ram.py` 的 `P5_LAB` 六行（`U高 V低 W低` …）与 `tools/cn_glyphs.py` 的字库；重跑 `python tools/gen_text_ram.py` 后 `disp/text_ram.v` 的 `p5_lab_ram` 仍应是 84 个非空格 | 记下「哪一行的字不对 / 高或低缺字模 / 字被行带裁掉」，对照 `DEV_STATUS.md` 的 `U-40` |
| 第 82…84 项（P1 口径注记字面口径）有失败 | `tools/gen_text_ram.py` 的 P1 表那两行（`(14, 46, "估算值")` 与 `(23, 26, "本次上电起算")`）与 `tools/cn_glyphs.py` 的字库；重跑 `python tools/gen_text_ram.py` 后 `disp/text_ram.v` 的 `p1_lab_ram` 应为 123 个非空格 | 记下「哪个字不对 / 哪一格是空白 / 缺字模」，对照 `DEV_STATUS.md` 的 `U-39` |
| 第 79…81 项（P4 等效采样注记字面口径）有失败 | `tools/gen_text_ram.py` 的 P4 表那一行（`(27, 6, "按电角度重建128箱等效采样")`）与 `tools/cn_glyphs.py` 的字库；重跑 `python tools/gen_text_ram.py` 后 `disp/text_ram.v` 的 `p4_lab_ram` 应为 67 个非空格 | 记下「哪个字不对 / 哪一格是空白 / 缺字模」，对照 `DEV_STATUS.md` 的 `U-38` |
| 第 76…78 项（P6 危险区几何与命中边界）有失败 | `disp/disp_engine.v` 的 `DZ_Y0` / `DZ_BTN_Y0` / `DZ_BTN_Y1` / 三角两行，或 `disp/enc_top_disp.v` 的 `DZ_HIT_*`（= 画框 ±8 px）与 `tap_dz_clr` 的 `page == 3'd5` 门控 | 记下「横条上沿落在哪一行 / 按钮不在危险区正中 / 框外点得动或框内点不动」，对照 `DEV_STATUS.md` 的 `U-37` |
| 第 73…75 项（P8 自检结果）有失败 | `disp/selftest_lab.v` 的三项判据与组合写口、`disp/disp_engine.v` 的 `p8l_*` 写口 mux（`bv_we` 优先 + `hold`）、`tools/gen_text_ram.py` 的 `P8_LAB` 底栏（格 31..34 标签 + 36/37 占位）、或 `tools/make_cn_glyphs.py` 的 `CN_ORDER` 追加与 `disp/tb_font_rom.v` 的 `NC`/`NCH`（112/163） | 记下「底栏两个字停在哪一组状态 / 标签串位 / 计数与结论互相矛盾」，对照 `DEV_STATUS.md` 的 `U-36` |
| 第 70…72 项（P8 系统信息 / 自检）有失败 | `disp/touch_view.v` 的字段表（`f_row` / `f_col` / `f_wid` = 5/3/3/6/6/6/2/2/2、`f_str()`、`v32` 的 fld3..fld8、`str_ch` 的 `ENCC1` / `FW_MAJ`·`FW_MIN`（当前 V55）/ 型号三分支、`RES_LUT_PCT` / `RES_BRAM_PCT` / `RES_DSP_PCT` —— 后三个必须等于本轮 `impl_util.rpt` 的取整值）、`tools/gen_text_ram.py` 的 `P8_LAB` / `P8_VAL` 新版面，或 `tools/make_cn_glyphs.py` 的 `CN_ORDER` 追加与 `disp/tb_font_rom.v` 的 `NC`/`NCH`（104/155） | 记下「哪一格空 / 标签串位还是值不对 / 屏上固件版本不是最新位流版本 / 资源百分比与 `impl_util.rpt` 差多少」，对照 `DEV_STATUS.md` 的 `U-35`（历史）与 `U-48`（版本号与资源百分比改成单点来源） |
| 第 67…69 项（数字键盘兜底）有失败 | `disp/ui_panel.v` 的键盘状态机（`kp_mode` / `kp_dig` / `kp_nv_ok` / `kp_clear` / `wid_eff`）、`disp/disp_engine.v` 的键盘绘制段与 `pnl_lab_cell` 抑制、`disp/seg7.v` 的七段几何、`disp/enc_top_disp.v` 的 6 根接线，或 `tools/preview_pages.py` 的 `draw_seg7` / `draw_keypad` 同源 | 记下「按钮在不在 / 键位错位还是画不出 / 越界与首位 0 接不接受 / CANCEL 退几层」，对照 `DEV_STATUS.md` 的 `U-34` |
| 第 64…66 项（状态字模第四重：2 Hz 闪烁 + P6 开关）有失败 | `disp/disp_engine.v` 的 `blk_div` / `blk_ph` 相位发生器与 `scbar_blk` 门（15 帧半周期）、`disp/enc_top_disp.v` 的 `scr_blink` 与 `tap_title_btn` 分支、标题带复选框的 `CHK_X0` / `chk_zone` / `chk_edge` / `chk_mark`、`tools/gen_text_ram.py` 的 P6「闪烁」标签（格列 44/45），或 `tools/preview_pages.py` 的复选框同源 | 记下「复选框会不会翻 / 哪张卡不闪 / 关掉后色块还在不在」，对照 `DEV_STATUS.md` 的 `U-33` |
| 第 61…63 项（状态条反转视频）有失败 | `disp/disp_engine.v` 的 `scbar_c0..c5` 矩形与 `with_txt` mux（`scbar_sel` 取 `sc_chip_st` 的哪两位、`scbar_bg` 的默认色）、`disp/stat_chip.v` 的六卡判据表、`C_WARN` / `C_FAULT`（`24'hE08B2D` / `24'hD9453D`），或 `tools/preview_pages.py` 的 `invert_chip_bands()` | 记下「哪张卡错 / 色块没出现还是颜色错 / 白字有没有压上去」，对照 `DEV_STATUS.md` 的 `U-32` |
| 第 58…60 项（状态字模上屏）有失败 | `disp/stat_chip.v` 的六卡判据表与 `chip_st`、`disp/disp_engine.v` 的写口 mux（`p1_waddr` / `p1_we` / 优先权）、`tools/gen_font_rom.py` 的 ●/▲/✖ 字形（码 48/49/50）、`tools/gen_text_ram.py` 的 `P1_LAB` 格行 15/36，或 `disp/disp_engine.v` 的 `glyph_page` 屏蔽名单 | 记下「哪张卡错 / 错成什么词 / 六张卡有没有互相串位」，对照 `DEV_STATUS.md` 的 `U-31` |
| 第 55…57 项（P5 表格 30/188 重排）有失败 | `disp/disp_engine.v` 的 P5 虚拟格网（`P5_TX0/TY0/TX1/TY1`、`P5_COL_W`、`P5_ROW_H`、比较器除法、`p5_vvis`）与行/列分隔线、`disp/p5_view.v` 的写入口 `f_row/f_col` 与条形尺度（`perm * 16'd188 >> 10`）、`tools/gen_text_ram.py` 的 `P5_LAB`、或 `tools/preview_pages.py` 的同源映射 | 记下「行距/列数是多少 / 哪一列串位 / 条形长度对不对 / 其余七页有没有动」，对照 `DEV_STATUS.md` 的 `U-30` |

---

## 附录：首次实测结果（2026-10-15）

本测试单第 1~3 步已全部走通，**故障树 D 结案**。完整读数与判定记在
`docs/DEV_STATUS.md` 的 `### U-7` 一节，这里只留结论：

- 第 1 步 状态灯：状态栏右端上半格（编码器抽头心跳）为橙色 —— 当时未接信号源，属正常。
- 第 2 步 P8 九宫格（手指按住屏幕）：`触摸IC=GT9`、`POINTS=1 / 2`、
  `触点X0=315 / 305`、`触点Y0=386 / 356`、`读次数=53389 / 73635`（持续增长）、
  `产品号=57`、`无应答=0`、`超时=0`。
- 第 3 步 按屏：蓝色十字准星跟随手指，松手约 0.5 s 后消失。
- 页切换：板载 `KEY1`（Y9）可用；`KEY0`（W9）是异步复位。
- 唯一未闭环项：`0X814E` 字节的采样时机（见 `DEV_STATUS.md` 的 `U-7.4`），不阻塞功能。

### 4.43 P8 资源百分比页（v58 已删除，此项仅留档）

v58 删掉 P8（系统信息页）时，`disp/touch_view.v` 的三个 `localparam`
（`RES_LUT_PCT` / `RES_BRAM_PCT` / `RES_DSP_PCT`）与对账工具
`tools/gen_res_pct.py` 一并下线：屏上已经没有"资源百分比"这个说法，
资源数字改看实现报告。

| # | 操作 | 期望 |
|---|---|---|
| 127 | 出完位流后看 `impl_util.rpt` 的 `Slice LUTs` / `Block RAM Tile` / `DSPs` 三行 | 当前 v58：`14,130 (67.93%) / 48.5 (97.00%) / 18 (20.00%)` |
| 128 | 需要复核版面时跑 `python tools/preview_pages.py --out _preview` | 5 页预览里不再有 P8，也不再出现资源百分比 |

**易混点：**

> 1. **旧工具在 `tools/legacy/gen_res_pct.py`**：它默认读 `disp/touch_view.v`，
>    那个文件已经随 P8 一起退役，脚本留着只为历史回溯，不要再跑。
> 2. **屏上不再有"资源快照"**：以前那三个常量参与综合、改完必须重出位流；
>    v58 起资源数字只以 `impl_util.rpt` 与 `deliverables/design_report.md` §9.6 为准。
> 3. **回归日志 `logs/SUMMARY.md` 是构建产物**（`sim/logs/` 与 `disp/logs/` 各一份）：
>    U-55 起已加入 `.gitignore` 且不再跟踪 —— 跑完回归不用再手工 `git checkout --` 还原，
>    提交前也不会莫名多出两个脏文件。
