zhaoyunfengntzx-maker/fpga-smr-encoder/model/cordic_verify_report.txt

cordic_atan2 位精确模型 (Python/numpy)   AW=16 IW=16 NITER=16 ZW=20 IW_INT=19
Latency = 18 clk；1 LSB = 360/2^16 = 0.0054932 deg

==============================================================================
0. ATAN 常量表自检（SPEC §1.5 表 vs round(atan(2^-i)*2^20/2pi)）
==============================================================================
   i     SPEC值    精确值(浮点)    取整差(LSB20)   2^-i 角(deg)
   0    131072     131072.0000       +0.0000   45.0000000
   1     77376      77376.3197       -0.3197   26.5650512
   2     40881      40883.5223       -2.5223   14.0362435
   3     20753      20753.1143       -0.1143   7.1250163
   4     10416      10416.8289       -0.8289   3.5763344
   5      5213       5213.4925       -0.4925   1.7899106
   6      2607       2607.3824       -0.3824   0.8951737
   7      1304       1303.7708       +0.2292   0.4476142
   8       651        651.8953       -0.8953   0.2238105
   9       326        325.9489       +0.0511   0.1119057
  10       163        162.9746       +0.0254   0.0559529
  11        81         81.4873       -0.4873   0.0279765
  12        41         40.7437       +0.2563   0.0139882
  13        20         20.3718       -0.3718   0.0069941
  14        10         10.1859       -0.1859   0.0034971
  15         5          5.0930       -0.0930   0.0017485
  表项取整误差最大 2.5223 LSB20 = 0.1576 LSB16（16 项最坏累计 40.3569 LSB20 = 2.5223 LSB16）
  CORDIC 残余旋转角 atan(2^-16) = 0.000874 deg = 2.546 LSB20 = 0.1592 LSB16

==============================================================================
1. 全圆扫描 4096 点（步长 360/4096 = 0.087890625 deg，A = 32767）
==============================================================================
  [基准 A] 对**连续理想角度**（芯片真实角度误差，含输出 ±0.5LSB 量化）
  err_cont vs ideal angle            max|e| =  1.0000 LSB = 0.005493 deg  @ 0.5273 deg
                                     RMS    =  0.4598 LSB = 0.002526 deg   mean = +0.0942 LSB
  [基准 B] 对**量化后输入矢量**的精确角度（纯 CORDIC + 输出量化）
  err_vec  vs exact vector angle     max|e| =  1.0000 LSB = 0.005493 deg  @ 0.5273 deg
                                     RMS    =  0.4598 LSB = 0.002526 deg   mean = +0.0942 LSB
  [基准 C] 对 16bit 整数化名义角度（tb 整数参考表口径，参考角自身
           带 ±0.5LSB 量化，数值会虚高，只用于 tb 交叉核对）
  err_nom  vs rounded nominal        max|e| =  1.0000 LSB = 0.005493 deg  @ 0.5273 deg
                                     RMS    =  0.4598 LSB = 0.002526 deg   mean = +0.0942 LSB

  内部位宽余量: max|x|=53958 (19bit 有符号上限 262143), max|y|=32767, max|z|=524284 (20bit 上限 524287)

  误差绝对值直方图（基准 A，单位 LSB）：
    [0.00, 0.25) :  3230 点 (78.86%)  ############################################################
    [0.25, 0.50) :     0 点 (0.00%)  
    [0.50, 0.75) :     0 点 (0.00%)  
    [0.75, 1.00) :     0 点 (0.00%)  
    [1.00, 1.25) :   866 点 (21.14%)  ###########################################

==============================================================================
2. 0/90/180/270 度附近密集扫描（每个边界 ±0.5deg，4001 点）
==============================================================================
  boundary    0.0 deg : max|e_cont| = 1.5020 LSB = 0.008251 deg  @ 0.3928 deg   (max|e_vec| = 1.000, max|e_nom| = 2)
  boundary   90.0 deg : max|e_cont| = 1.5020 LSB = 0.008251 deg  @ 90.3928 deg   (max|e_vec| = 1.000, max|e_nom| = 2)
  boundary  180.0 deg : max|e_cont| = 1.5020 LSB = 0.008251 deg  @ 180.3928 deg   (max|e_vec| = 1.000, max|e_nom| = 2)
  boundary  270.0 deg : max|e_cont| = 1.5020 LSB = 0.008251 deg  @ 270.3927 deg   (max|e_vec| = 1.000, max|e_nom| = 2)

==============================================================================
3. 精确象限边界 / 退化输入（x=0, y=0, 极小矢量）
==============================================================================
     0 deg (x=+A, y=0)    -> angle=    0 (  0.0000 deg)  ref=    0  err=   +0 LSB (+0.00000 deg)  mag=32769
    90 deg (x=0 , y=+A)   -> angle=16385 ( 90.0055 deg)  ref=16384  err=   +1 LSB (+0.00549 deg)  mag=32769
   180 deg (x=-A  , y=0)  -> angle=32769 (180.0055 deg)  ref=32768  err=   +1 LSB (+0.00549 deg)  mag=32769
   270 deg (x=0 , y=-A)   -> angle=49152 (270.0000 deg)  ref=49152  err=   +0 LSB (+0.00000 deg)  mag=32769
    45 deg (x=y=+A/sqrt2) -> angle= 8192 ( 45.0000 deg)  ref= 8192  err=   +0 LSB (+0.00000 deg)  mag=32769
   135 deg (x=-,y=+)      -> angle=24576 (135.0000 deg)  ref=24576  err=   +0 LSB (+0.00000 deg)  mag=32769
   225 deg (x=-,y=-)      -> angle=40960 (225.0000 deg)  ref=40960  err=   +0 LSB (+0.00000 deg)  mag=32769
   315 deg (x=+,y=-)      -> angle=57344 (315.0000 deg)  ref=57344  err=   +0 LSB (+0.00000 deg)  mag=32769
   x=0  , y=0   (undefined) -> angle=18182 ( 99.8767 deg)  ref=    0  err=+18182 LSB (+99.87671 deg)  mag=    0
   x=+1 , y=0             -> angle=63738 (350.1233 deg)  ref=    0  err=-1798 LSB (-9.87671 deg)  mag=    0
   x=-1 , y=0             -> angle=34566 (189.8767 deg)  ref=32768  err=+1798 LSB (+9.87671 deg)  mag=    0
   x=0  , y=+1            -> angle=18182 ( 99.8767 deg)  ref=16384  err=+1798 LSB (+9.87671 deg)  mag=    0
   x=0  , y=-1            -> angle=47354 (260.1233 deg)  ref=49152  err=-1798 LSB (-9.87671 deg)  mag=    0
   x=+1 , y=+1            -> angle= 7874 ( 43.2532 deg)  ref= 8192  err= -318 LSB (-1.74683 deg)  mag=    1
   x=-1 , y=-1            -> angle=40642 (223.2532 deg)  ref=40960  err= -318 LSB (-1.74683 deg)  mag=    1
   x=-32768, y=0          -> angle=32768 (180.0000 deg)  ref=32768  err=   +0 LSB (+0.00000 deg)  mag=32770
   x=0  , y=-32768        -> angle=49152 (270.0000 deg)  ref=49152  err=   +0 LSB (+0.00000 deg)  mag=32770

==============================================================================
4. mag 幅值统计（全圆 4096 点）
==============================================================================
  mag  min = 32767  max = 32770  mean = 32768.51   (输入幅值 A = 32767)
  mag 相对**矢量真实模长**的误差: min = -0.00022%  max = +0.00900%  RMS = 0.00498%
  最小二乘增益 = 1.0000464  （理想 1.0；偏差 +0.0046% 来自 MAG_COEF 量化）
  MAG_COEF/2^17 = 0.60733032，1/1.6467602 = 0.60725296，系数误差 +7.737e-05 (满幅 +2.535 LSB)
  mag 相对误差（去掉幅值补偿，直接看 CORDIC 模长一致性）: max +0.00900%

==============================================================================
5. 幅值扫描（同一组角度、不同输入幅值）
==============================================================================
  A =  32767 : max|e_cont| =   1.0000 LSB = 0.005493 deg   RMS =  0.4598 LSB   mag_max = 32770
  A =  30000 : max|e_cont| =   1.0000 LSB = 0.005493 deg   RMS =  0.4408 LSB   mag_max = 30002
  A =  20000 : max|e_cont| =   1.0000 LSB = 0.005493 deg   RMS =  0.5106 LSB   mag_max = 20001
  A =  10000 : max|e_cont| =   3.0000 LSB = 0.016479 deg   RMS =  0.8527 LSB   mag_max = 10000
  A =   4000 : max|e_cont| =   9.0000 LSB = 0.049438 deg   RMS =  3.0627 LSB   mag_max = 3999
  A =   1000 : max|e_cont| =  36.0000 LSB = 0.197754 deg   RMS = 12.0263 LSB   mag_max = 999
  A =    100 : max|e_cont| = 240.0000 LSB = 1.318359 deg   RMS = 78.8850 LSB   mag_max = 100
  A =     10 : max|e_cont| = 2064.0000 LSB = 11.337891 deg   RMS = 738.6141 LSB   mag_max = 9
  A =      1 : max|e_cont| = 7254.0000 LSB = 39.847412 deg   RMS = 3107.0465 LSB   mag_max = 1

==============================================================================
6. 对照：SPEC §1.5 原文折叠公式（x0<=0）与修正折叠公式
==============================================================================
  固定矢量、两种折叠的实测输出角度：
    角度      SPEC原文输出        修正后输出        参考
    30.0    5461 (  29.998)    5461 (  29.998)    5461
    60.0   10923 (  60.002)   10923 (  60.002)   10923
   100.0   63738 ( 350.123)   18204 (  99.998)   18204   <== 原文公式偏差 -20002 LSB (= -109.87 deg)
   135.0   63738 ( 350.123)   24576 ( 135.000)   24576   <== 原文公式偏差 -26374 LSB (= -144.88 deg)
   170.0   63738 ( 350.123)   30948 ( 170.002)   30948   <== 原文公式偏差 -32746 LSB (= -179.88 deg)
   190.0    1798 (   9.877)   34588 ( 189.998)   34588   <== 原文公式偏差 +32746 LSB (= +179.88 deg)
   225.0    1798 (   9.877)   40960 ( 225.000)   40960   <== 原文公式偏差 +26374 LSB (= +144.88 deg)
   260.0    1798 (   9.877)   47332 ( 260.002)   47332   <== 原文公式偏差 +20002 LSB (= +109.87 deg)
   300.0   54613 ( 299.998)   54613 ( 299.998)   54613
   350.0   63716 ( 350.002)   63716 ( 350.002)   63716
  结论：x<0 的两个象限（90..270deg）里，SPEC 原文公式的折叠矢量 x0<=0，
        向量模式 CORDIC 收敛到 +x 轴而非 -x 轴，输出整体偏 180deg。
        本项目采用修正折叠（x0>=0），与 model/golden_model.py 一致。

==============================================================================
7. 结论
==============================================================================
  基准A 全圆 4096 点  max|e| = 1.0000 LSB = 0.005493 deg   RMS = 0.4598 LSB = 0.002526 deg
  基准B 纯 CORDIC     max|e| = 1.0000 LSB = 0.005493 deg
  基准C 整数参考表口径 max|e| = 1 LSB（含参考角 ±0.5LSB 量化，虚高）
  最坏边界密集扫描    max|e| = 1.5020 LSB
  目标：max|e| <= 1 LSB (= 0.0054932 deg)
  实测：max|e| = 1.0000 LSB  ==>  FAIL
  裕量：0.0000 LSB (0.00%)

  误差预算（LSB16，实测值而非纸面估计）：
    输出四舍五入量化          <= 0.5000（AW=16 的固有下限，不可消除）
    ATAN 表取整（SPEC 定值）  ATAN[2] 偏 -2.52 LSB20 = 0.1576 LSB16（最大一项）
    CORDIC 残余旋转 atan(2^-16)  0.1592 LSB16
    x/y 向零截断（SPEC 要求）  含在上面实测数字里，无发散
    输入矢量 16bit 量化        <= 0.1592 LSB16（满幅 0.5/32767 rad）

  为何 1 LSB 是 AW=16 下的真实下限：输出是 16bit 整数，对连续角度的
  四舍五入量化本身就占 ±0.5 LSB；CORDIC 的残余旋转与 ATAN 表取整再各
  贡献 ~0.16 LSB，三者最坏叠加 ~0.82 LSB，实测峰值 1.000 LSB。
  要显著低于 1 LSB 只能提高 AW（输出位数），而不是改 CORDIC 结构。

  TEST FAILED
