zhaoyunfengntzx-maker/fpga-smr-encoder/skill/prompts/P3_testbench_falsification.md

# P3 · 让 AI 先写测试台，再逼它证伪自己的测试台

**一句话**：AI 写测试台的速度远快于它写对的速度；所以第二问永远是
"这个测试台**怎样才能通过但它其实没测**"，并按它自己给出的漏洞清单去注入缺陷。

## 适用场景

- 测试台已经"全绿"，但你不确定它到底测到了什么；
- 仿真跑得异常快（几秒钟就 PASSED）——这是空转的典型征兆；
- 要交作业/参赛，需要一个能经得起"评审随手改一行就抓得到"的自检体系。

**不适用**：DUT 本身还没有可观察输出；或测试依赖真实硬件交互（需上板验证的另算）。

## 怎么用（两轮，缺一不可）

**第一轮**：正常要求它写测试台 + 激励 + 判据。
**第二轮**（关键）：把第一轮的测试台贴回去，要求它做"反方"，列出
"能让这个测试台错误通过的最小改动"，然后**逐个真的去做**，看测试台是否失败。

注入的缺陷必须记下来：数量、期望结果、实测结果。这是报告 §4"负对照"那一节的数据来源。

## 可复制模板

```text
第一轮：
你是验证工程师。为下面的 DUT 写一个自检式测试台（Verilog/SystemVerilog，xsim 可跑）。
【DUT】<<模块名、端口、功能、延迟>>
【判据】<<必须逐点比对，不允许只比"次数/极差/范围">>
要求：
- 有 $finish、有 #<延时> 超时保护、结尾打印 "TEST PASSED (n checks)" 或 "TEST FAILED (n errors)"；
- 激励要覆盖边界（0、最大值、最小值、饱和点）与随机段；
- 每个 DUT 输入都必须被驱动（不许有声明了却从没赋值的信号）；
- 不要用常量驱动使能/复位以外的输入。

第二轮（把上面的测试台原样贴回）：
现在你是这个测试台的反方。请你找出至少 6 种"改坏了 DUT 但测试台仍然打印 PASSED"的情况。
要求：
1) 按"最可能被忽略"排序，每种给出最小改动（精确到行/表达式，例如把 >>> 改成 >>）；
2) 对每种说明：为什么测试台抓不到（覆盖缺失？判据太弱？时序没对齐？）；
3) 给出补救：测试台要加哪一条断言/哪一个激励点才能抓到；改动量多大；
4) 指出你自己的测试台里最不可信的 1 条判据，并给出替代写法。

最后请列出"必须注入验证的缺陷清单"，格式：
| # | 注入方式 | 期望测试台输出 | 若没抓到说明什么 |
```

## 已验证效果（本工程）

- 第一次使用就抓到"空转测试台"：激励寄存器改名后实例化没跟着改，
  仿真 20 分钟后打印 `TEST PASSED`，而 DUT 输入一直是 X。
  `skill/scripts/tb_wiring.py` 是这次事故的产物，对该缺陷定位时间 ~1 秒。
- 全工程注入验证累计发现 **15 处 RTL 缺陷 + 9 处测试台缺陷**；
  典型：UVW 扇区截断导致 50% 的角度点错，原测试台仍全绿（因为只比了"递增"）。
- 子代理分片审计时，同一个"反方"提示词让 6 个子代理在 23 个文件里
  找出 26 处真缺陷（记录 9）。

## 失效条件

- 如果 DUT 有状态且测试台只做单点比对，注入缺陷会"碰巧不触发"，
  这时不能宣布测试台弱——要先补激励覆盖再判；
- 模型的"最小改动"经常改错文件（写成另一个模块），必须逐条真的编译一次；
- 过度注入会让人麻木：每题保留 5–10 条高价值注入即可，其余写成 `pitfalls.md` 条目。

## 来源

记录 1（空转测试台）、记录 47（三条“看起来 PASS 其实没测到”）、记录 49（一条永远为真的断言）、
记录 73（四路只读审计 + 专门"证伪"的验证员）。核心教训：
**AI 的测试台和 AI 的 RTL 出自同一个误解**，必须让它站在对面。
