zhaoyunfengntzx-maker/fpga-smr-encoder/deliverables/figures/fig_verify_chain.png

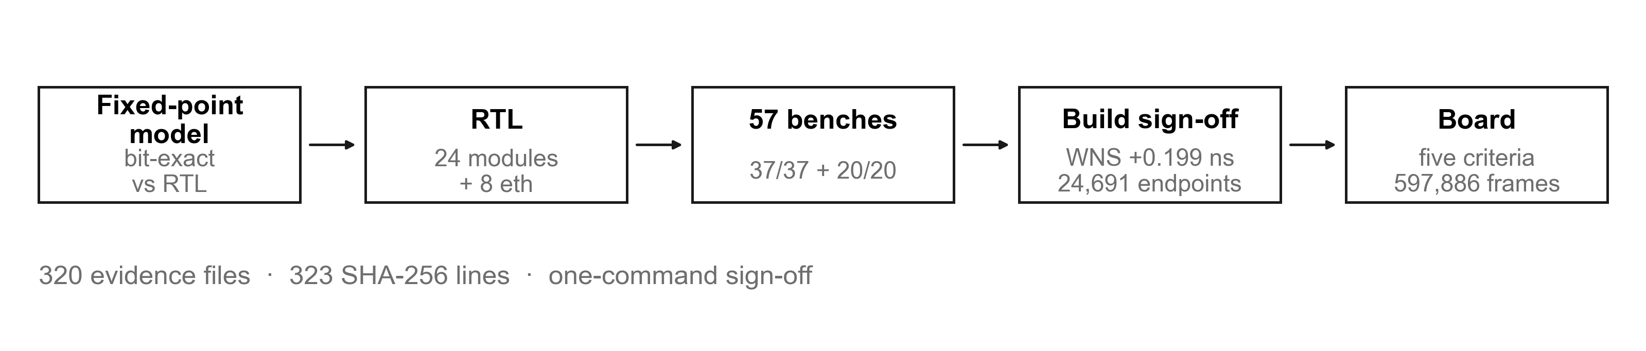
deliverables/figures/fig_verify_chain.png
