zhaoyunfengntzx-maker/fpga-smr-encoder/deliverables/figures/fig_compare.pdf

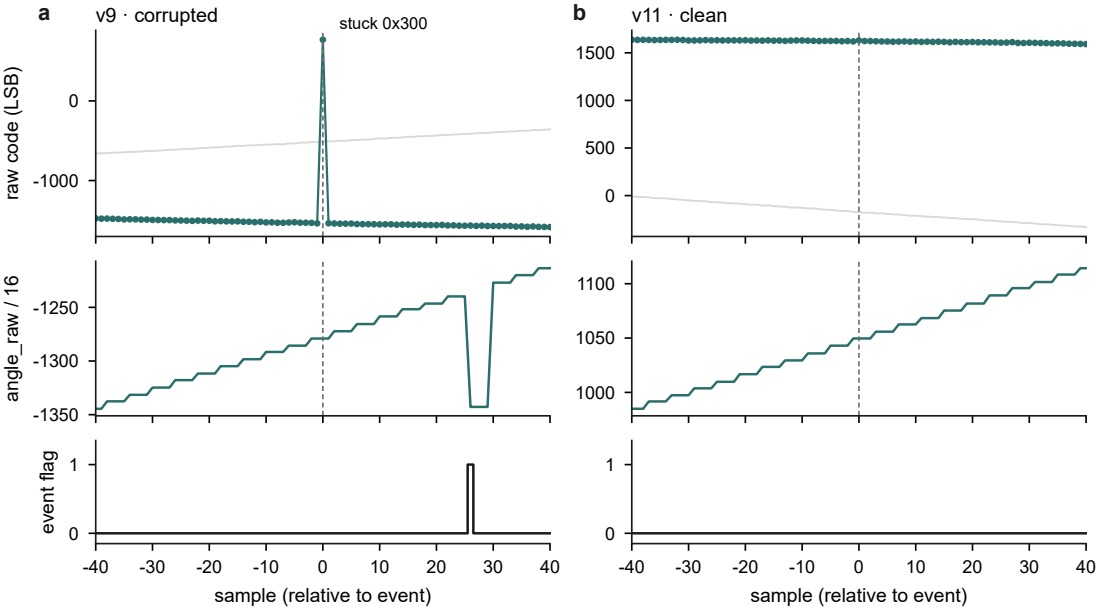
[picture p195: page 1]
stuck 0x300 v9 · corrupted; angle_raw / 16; event flag; v11 · clean

raw code (LSB)

sample (relative to event)
