zhaoyunfengntzx-maker/fpga-smr-encoder/deliverables/figures/fig_cordic.pdf

# (x0, y0) x

a

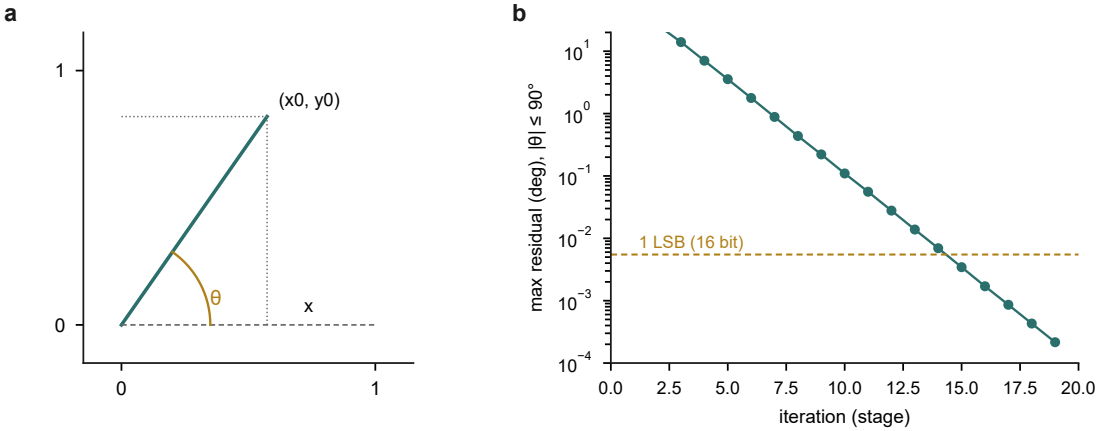
[picture p196: page 1]
iteration (stage); 1 LSB (16 bit)

max residual (deg), |θ| ≤ 90°
