zhaoyunfengntzx-maker/fpga-smr-encoder/deliverables/figures/fig_glitch_time.pdf

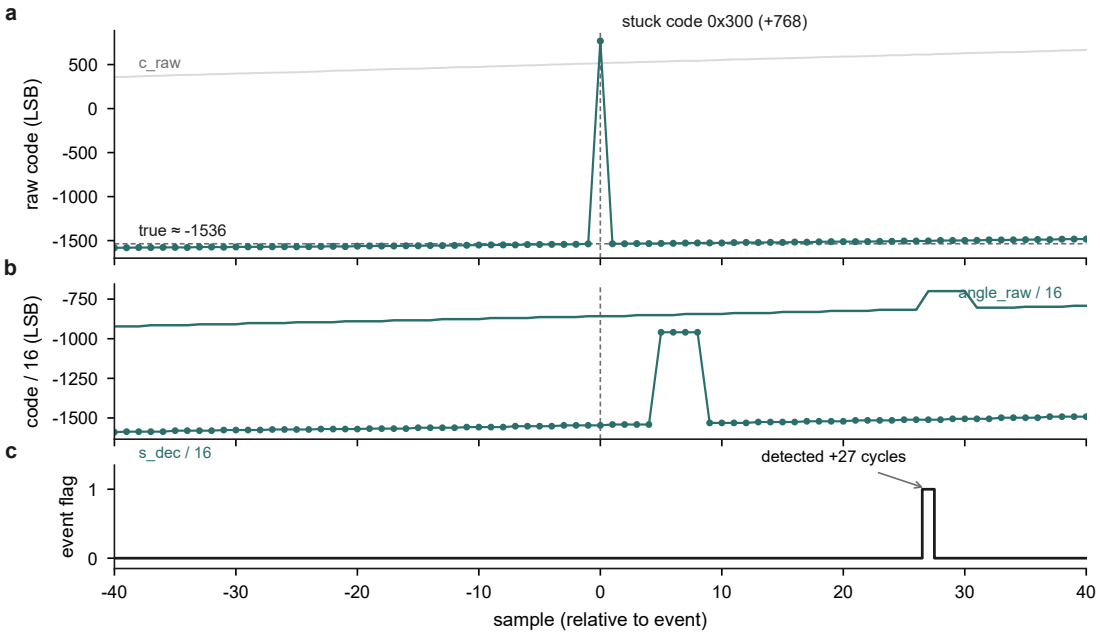
[picture p197: page 1]
stuck code 0x300 (+768); true ≈ -1536; c_raw; code / 16 (LSB); angle_raw / 16; s_dec / 16; event flag; detected +27 cycles

raw code (LSB)

sample (relative to event)
