zhaoyunfengntzx-maker/fpga-smr-encoder/deliverables/figures/fig_lattice.pdf

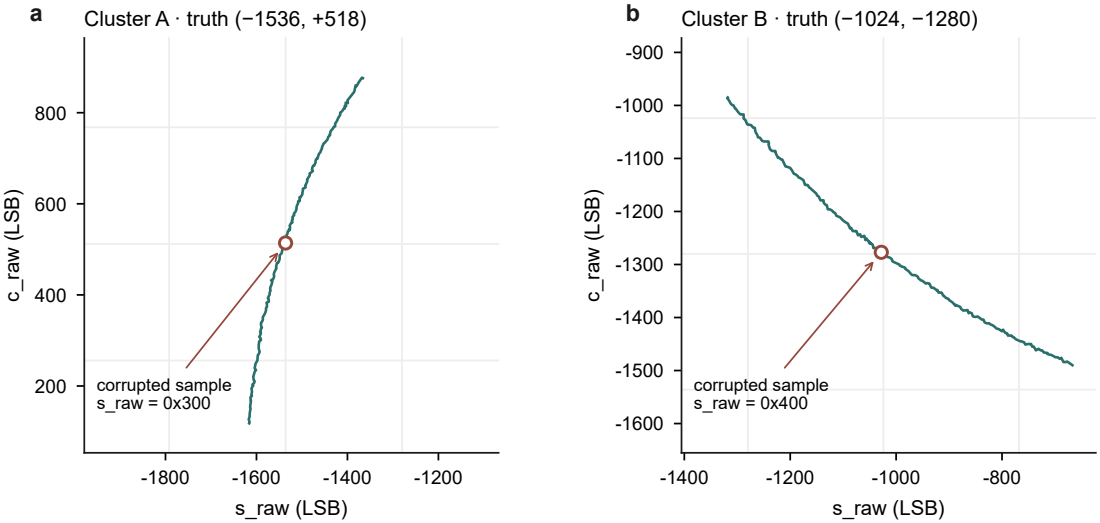
[picture p198: page 1]
s_raw (LSB); c_raw (LSB); corrupted sample s_raw = 0x300; Cluster A · truth (−1536, +518); corrupted sample s_raw = 0x400; Cluster B · truth (−1024, −1280)
