zhaoyunfengntzx-maker/fpga-smr-encoder/deliverables/figures/fig_calibration_summary.pdf

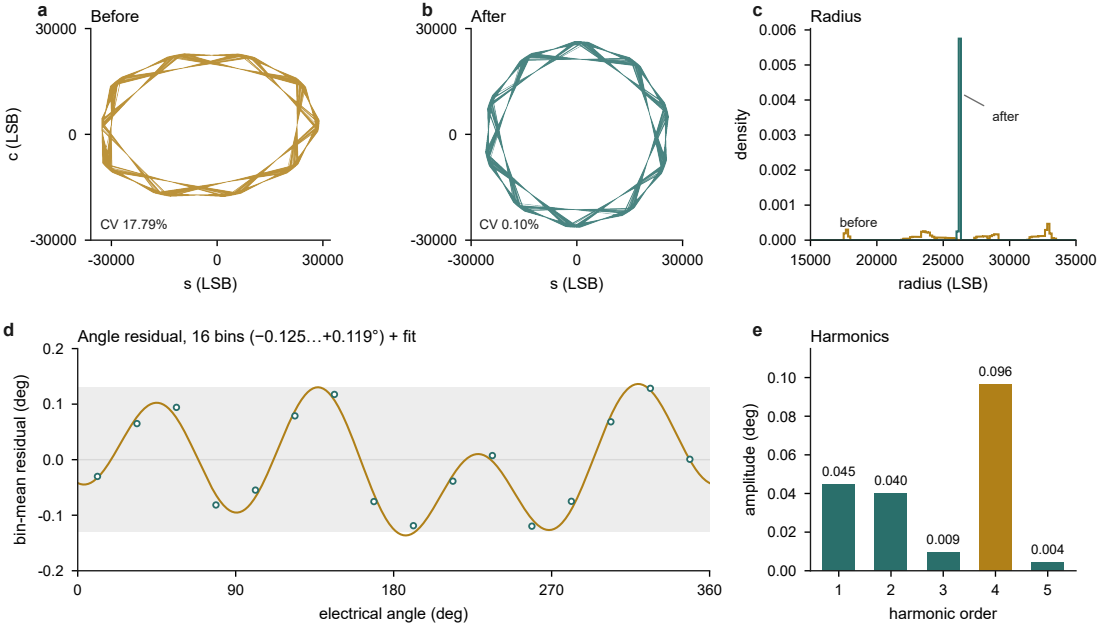
[picture p200: page 1]
s (LSB); c (LSB); Before; After; radius (LSB); density; before; after; Radius; Angle residual, 16 bins (−0.125…+0.119°) + fit; harmonic order; amplitude (deg); Harmonics

bin-mean residual (deg)

electrical angle (deg)
