zhaoyunfengntzx-maker/fpga-smr-encoder/deliverables/figures/fig_abz_timing.pdf

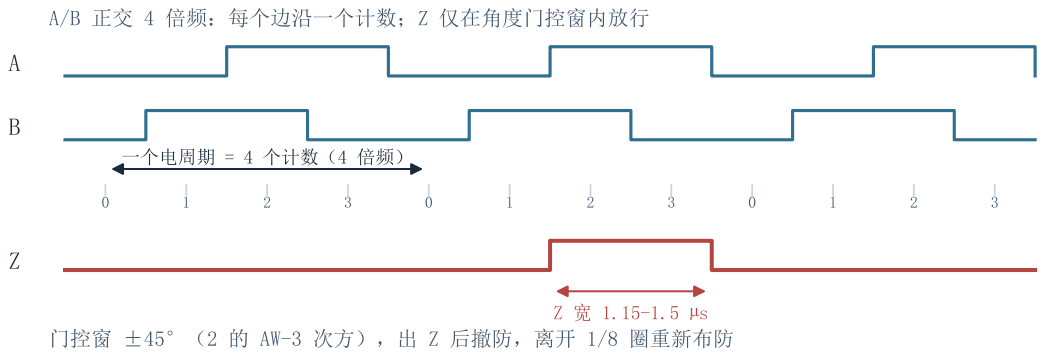
[picture p207: page 1]
