zhaoyunfengntzx-maker/fpga-smr-encoder/deliverables/figures/fig_cordic_stage.pdf

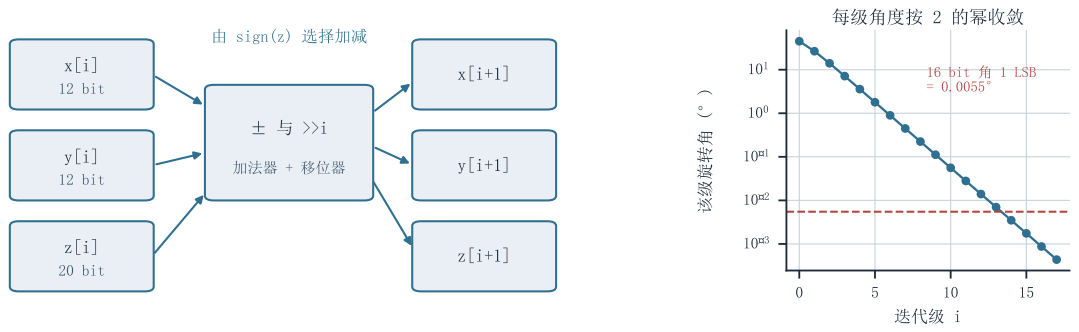
[picture p208: page 1]
12 bit; 20 bit; sign(z); bit; 1 LSB
