zhaoyunfengntzx-maker/fpga-smr-encoder/deliverables/figures/fig_io_topology.pdf

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

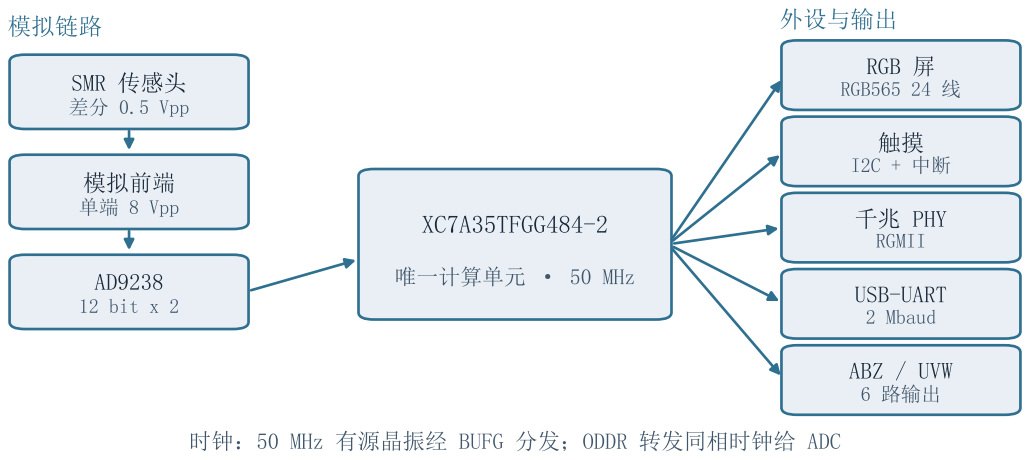
[picture p209: page 1]
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
