zhaoyunfengntzx-maker/fpga-smr-encoder/deliverables/figures/fig_uvw_sectors.pdf

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

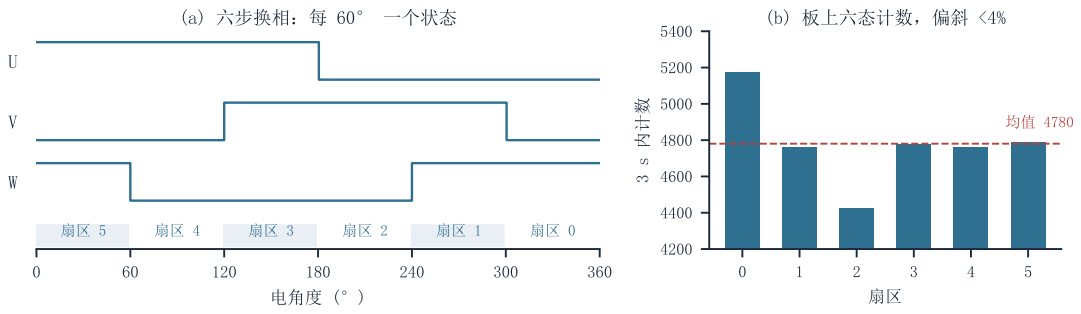
[picture p211: page 1]
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
