zhaoyunfengntzx-maker/fpga-smr-encoder/deliverables/figures/fig_residual.pdf

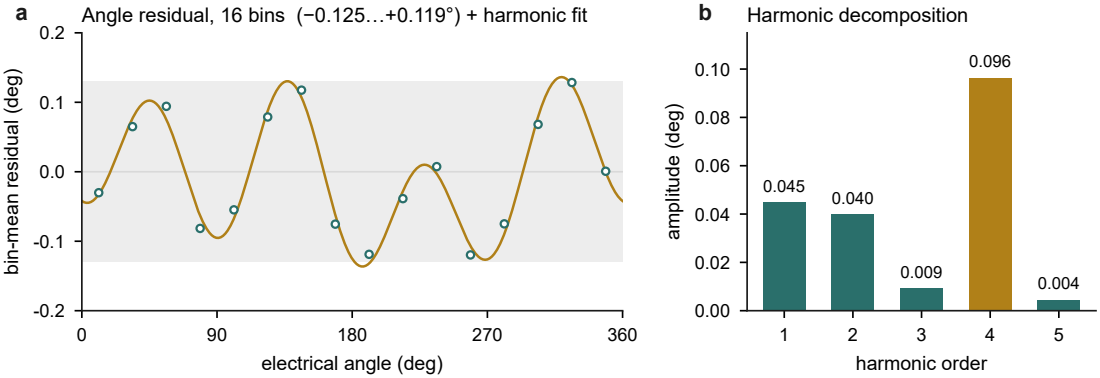
[picture p212: page 1]
harmonic order; amplitude (deg); Harmonic decomposition

bin-mean residual (deg) a Angle residual, 16 bins (−0.125…+0.119°) + harmonic fit

electrical angle (deg)
