zhaoyunfengntzx-maker/fpga-smr-encoder/constr/ddr3_io_135.xdc

# ddr3_io_135.xdc —— 把 MIG 生成的 SSTL15 覆盖成 SSTL135（BANK35 实测 1.35 V）
# 由 _gen_ddr3_io135.py 生成；必须在 MIG 自带 xdc 之后 read_xdc。
# 单端信号用 SSTL135，差分对（dqs/ck）用 DIFF_SSTL135。

set_property IOSTANDARD SSTL135 [get_ports {ddr3_addr[0]}]
set_property IOSTANDARD SSTL135 [get_ports {ddr3_addr[1]}]
set_property IOSTANDARD SSTL135 [get_ports {ddr3_addr[2]}]
set_property IOSTANDARD SSTL135 [get_ports {ddr3_addr[3]}]
set_property IOSTANDARD SSTL135 [get_ports {ddr3_addr[4]}]
set_property IOSTANDARD SSTL135 [get_ports {ddr3_addr[5]}]
set_property IOSTANDARD SSTL135 [get_ports {ddr3_addr[6]}]
set_property IOSTANDARD SSTL135 [get_ports {ddr3_addr[7]}]
set_property IOSTANDARD SSTL135 [get_ports {ddr3_addr[8]}]
set_property IOSTANDARD SSTL135 [get_ports {ddr3_addr[9]}]
set_property IOSTANDARD SSTL135 [get_ports {ddr3_addr[10]}]
set_property IOSTANDARD SSTL135 [get_ports {ddr3_addr[11]}]
set_property IOSTANDARD SSTL135 [get_ports {ddr3_addr[12]}]
set_property IOSTANDARD SSTL135 [get_ports {ddr3_addr[13]}]
set_property IOSTANDARD SSTL135 [get_ports {ddr3_ba[0]}]
set_property IOSTANDARD SSTL135 [get_ports {ddr3_ba[1]}]
set_property IOSTANDARD SSTL135 [get_ports {ddr3_ba[2]}]
set_property IOSTANDARD SSTL135 [get_ports {ddr3_cas_n}]
set_property IOSTANDARD SSTL135 [get_ports {ddr3_ras_n}]
set_property IOSTANDARD SSTL135 [get_ports {ddr3_we_n}]
set_property IOSTANDARD SSTL135 [get_ports {ddr3_cs_n[0]}]
set_property IOSTANDARD SSTL135 [get_ports {ddr3_cke[0]}]
set_property IOSTANDARD SSTL135 [get_ports {ddr3_odt[0]}]
set_property IOSTANDARD DIFF_SSTL135 [get_ports {ddr3_ck_p[0]}]
set_property IOSTANDARD DIFF_SSTL135 [get_ports {ddr3_ck_n[0]}]
set_property IOSTANDARD SSTL135 [get_ports {ddr3_dq[0]}]
set_property IOSTANDARD SSTL135 [get_ports {ddr3_dq[1]}]
set_property IOSTANDARD SSTL135 [get_ports {ddr3_dq[2]}]
set_property IOSTANDARD SSTL135 [get_ports {ddr3_dq[3]}]
set_property IOSTANDARD SSTL135 [get_ports {ddr3_dq[4]}]
set_property IOSTANDARD SSTL135 [get_ports {ddr3_dq[5]}]
set_property IOSTANDARD SSTL135 [get_ports {ddr3_dq[6]}]
set_property IOSTANDARD SSTL135 [get_ports {ddr3_dq[7]}]
set_property IOSTANDARD SSTL135 [get_ports {ddr3_dq[8]}]
set_property IOSTANDARD SSTL135 [get_ports {ddr3_dq[9]}]
set_property IOSTANDARD SSTL135 [get_ports {ddr3_dq[10]}]
set_property IOSTANDARD SSTL135 [get_ports {ddr3_dq[11]}]
set_property IOSTANDARD SSTL135 [get_ports {ddr3_dq[12]}]
set_property IOSTANDARD SSTL135 [get_ports {ddr3_dq[13]}]
set_property IOSTANDARD SSTL135 [get_ports {ddr3_dq[14]}]
set_property IOSTANDARD SSTL135 [get_ports {ddr3_dq[15]}]
set_property IOSTANDARD SSTL135 [get_ports {ddr3_dm[0]}]
set_property IOSTANDARD SSTL135 [get_ports {ddr3_dm[1]}]
set_property IOSTANDARD DIFF_SSTL135 [get_ports {ddr3_dqs_p[0]}]
set_property IOSTANDARD DIFF_SSTL135 [get_ports {ddr3_dqs_n[0]}]
set_property IOSTANDARD DIFF_SSTL135 [get_ports {ddr3_dqs_p[1]}]
set_property IOSTANDARD DIFF_SSTL135 [get_ports {ddr3_dqs_n[1]}]
set_property IOSTANDARD SSTL135 [get_ports {ddr3_reset_n}]

# BANK35 实测 VCCO = 1.35 V，参考电平必须是 VDDQ/2 = 0.675 V。
# MIG 按 1.5 V 器件生成，自带的是 INTERNAL_VREF 0.750（= 1.5 V 的一半），
# 在 1.35 V 上等于偏了 0.075 V（55.6%），读采样点会偏、余量被吃掉。
set_property INTERNAL_VREF 0.675 [get_iobanks 35]
