zhaoyunfengntzx-maker/fpga-smr-encoder/host/abz.py

"""ABZ / UVW 输出「等效采样」分析（纯逻辑：无 Qt、无串口）。

为什么不能按时间轴画 A/B
------------------------
板子每 100 µs 才发一帧遥测（`rtl/uart_scope.v:151 SAMPLE_DIV=5000 @50 MHz`，
正好 10 kHz），帧里给的是六路输出的**电平快照**。而 AB 边沿率 =
`4 × inter ÷ div × f_in`（本板 inter=32、f_in≈20 kHz ⇒ **2.56 MHz**），
比帧率高 256 倍 ⇒ 按时间轴画 A/B 只会看到混叠的噪声/直线，**永远看不到边沿**。
需求 M5 明确要求把这个限制如实标注出来，本模块与卡片⑨ 都照此写明。

能做的是「电角度分箱等效采样」
------------------------------
把每一帧当成一次**以输入电角度为横轴**的采样点：只要输入频率不是帧率的精确整数倍，
相位就会缓慢漂移，逐帧把 0…360° 填满，于是**按角度分箱取均值**就能重建波形：

* 每个箱的均值 = 该角度区间内高电平所占比例（0…1）；
* 全箱均值 = 占空比；
* A 与 B 的上升沿箱位置之差 = 四分之一 AB 周期（90°）；
* `U/V/W` 的六种组合每 60° 电角度轮换一次，分箱计数直接给出六状态数据表。

RTL 依据（本工程 v12 位流）
---------------------------
* `rtl/abz_gen.v:295-298` `edge_idx = (angle * inter) >>> (AW-2) ∈ [0, 4·inter-1]`
* `rtl/abz_gen.v:726-727` `a_out = r_div_idx[1] ^ apol`、
  `b_out = (r_div_idx[1] ^ r_div_idx[0]) ^ bpol`
  ⇒ A/B 各以 4 个边沿步为一个周期（＝ `360°/inter` 输入角度），B 相对 A 移 1 步 ＝ 90°
* `rtl/abz_gen.v:520` Z 脉宽 = `(z_width + 1)` 个边沿步（v9 起；`z_width` = `0x0108[3:0]`）
* `rtl/enc_top.v:643-644` `z_window = (cycle_cnt[5:0] == 0)` ⇒ **每 64 个输入周期一个 Z**
* `rtl/uvw_gen.v:156-161` `eang = (angle × pairs + uvwph·2^(AW-10)) mod 2^AW`
* `rtl/uvw_gen.v:174-177` `sec = (eang × 6) >> AW ∈ 0…5`（每扇区 60° 电角度）
* `rtl/uvw_gen.v:483-495` 扇区 → `{u,v,w}` = `110,010,011,001,101,100`，`uvwdir` 反转扇区序、
  `uvwpol` 三位取反
* `rtl/reg_file.v:559-560` `cfg_inter = {r_inter1[1:0], r_inter0[7:0]}`、`cfg_div = r_inter1[4:2]`
"""

import argparse
import math
import sys

# ---------------------------------------------------------------- 常量与工具

FRAME_HZ = 10000.0            # 板子名义帧率（SAMPLE_DIV=5000 @50 MHz）
AW = 16                       # 角度位宽（2^16 = 一个输入周期）
ANG_MOD = 1 << AW
# 每多少个输入周期出一个 Z 索引：旧磁环位流 POLE_BITS=6 → 64。
# ★ 本机 EI58 位流按 docs/20 §7 应是 POLE_BITS=11 → 每 2048 个周期一个索引，
#   但板上 Z 在 10 kHz 遥测里几乎抓不到（30 s 只有 2 个边沿），无法证实；
#   这一项只影响本页的「Z 速率/占空比预测」，不影响实测曲线，故先留 64。
#   真要改，自检里的期望值也要一起改。
Z_INDEX_PAIRS = 64
BINS_DEFAULT = 1024           # ★ 用户反馈（m15813）：默认分箱从 256 改成 1024
BINS_CHOICES = (64, 128, 256, 512, 1024)
SQ_PER_NEED = 8               # ★ 阶段 5 D 批：一个 A/B 周期至少占这么多箱才看得出方波形状
SQ_GAP = 12                   # ★ 阶段 5 D 批：判决线跨空档的最长距离（超过就断开）


def clean_bins(bins):
    """把分箱数收进 BINS_CHOICES：0/负数/越界都要被夹住。

    ★ 构造函数原来直接 `int(bins)`：bins=0 时 snapshot() 会在 cover/bins 上
    ZeroDivisionError，feed() 会在 n_ab[bi] 上 IndexError（GUI 下拉只给合法值，
    但库的调用方不一定）。
    """
    try:
        b = int(bins)
    except (TypeError, ValueError):
        return BINS_DEFAULT
    if b in BINS_CHOICES:
        return b
    return min(BINS_CHOICES, key=lambda x: abs(x - b))


_clean_bins = clean_bins


# rtl/uvw_gen.v:485-490：扇区 0…5 → {u,v,w}（uvwpol=0、uvwdir=0）
SECTOR_UVW = (0b110, 0b010, 0b011, 0b001, 0b101, 0b100)
LEGAL_STATES = tuple(sorted(SECTOR_UVW))
STATE_NAMES = {
    0b000: "U- V- W-", 0b001: "U- V- W+", 0b010: "U- V+ W-", 0b011: "U- V+ W+",
    0b100: "U+ V- W-", 0b101: "U+ V- W+", 0b110: "U+ V+ W-", 0b111: "U+ V+ W+",
}


def state_of(u, v, w):
    """三路电平 → 3 位状态码（bit2=U、bit1=V、bit0=W）。"""
    return ((int(u) & 1) << 2) | ((int(v) & 1) << 1) | (int(w) & 1)


def state_text(s):
    return STATE_NAMES.get(int(s) & 7, "?")


def z_width_deg(z_width, inter, div=1):
    """Z 脉宽（输入电角度）。

    ★ div 的方向：rtl/abz_gen.v:704 是"每个 idx_exec 递减 r_z_left"，而 idx_exec
    （rtl/abz_gen.v:422，fwd_go|bwd_go）按 rtl/abz_gen.v:41-42、:358 是"每 div 个原始
    边沿步点火一次" ⇒ 脉宽 = (z_width+1) 个 **idx_exec** 拍 = (z_width+1)·div 个原始边沿步，
    即 ∝ div。同一个文件 :72-78 的注释与 docs/01_technical_solution.md:596 写的是 ∝1/div，
    两边矛盾（真机 ILA 量一下才能定案，本板 div=1 时两说一致）。
    host 侧现在统一按 RTL 代码的 ∝div 建模，并与 synth_frames 的建模同源。
    """
    return ((int(z_width) + 1) * int(max(1, int(div))) * 360.0) / (4.0 * max(1, int(inter)))


def z_duty(z_width, inter, div=1, z_index_pairs=Z_INDEX_PAIRS):
    """Z 高电平的**时间**占空比 = (脉宽/输入周期) ÷ 每几个输入周期出一个 Z。"""
    frac = ((int(z_width) + 1) * int(max(1, int(div)))
            / (4.0 * max(1, int(inter))))
    if not z_index_pairs:
        return None
    return frac / float(z_index_pairs)


def frame_phase_locked(f_in, z_index_pairs=Z_INDEX_PAIRS):
    """帧采样相位是否被输入频率"锁死"（f_in 是 FRAME_HZ/z_index_pairs 的整数倍）。

    锁死时帧永远落在 Z 窗（或永远落在窗外），"帧观测占空比"这个折算模型失效：实测
    20000 Hz 时理论/实测差 25.6 倍、15000 Hz 差 34 倍（真踩过，见 docs 自查记录）。
    """
    if not f_in:
        return False
    k = abs(float(f_in)) * z_index_pairs / FRAME_HZ
    return abs(k - round(k)) < 0.02 * max(1.0, k)


def z_duty_frames(z_width, inter, f_in, div=1, z_index_pairs=Z_INDEX_PAIRS):
    """Z 高电平的**帧观测**占空比期望。

    帧是欠采样的：Z 脉冲只占 5/128 圈、每 64 圈才一次，而帧每 `f_in/帧率` 圈才发一次，
    因此“帧里看到 z=1 的比例” = 时间占空比 × (f_in / 帧率)。
    （本板 f_in≈20 kHz ⇒ ×2；实测 0.12% 而不是时间占空比的 0.061%。）

    ⚠ 只在采样相位**非相干**时成立（见 frame_phase_locked）：锁相时这个折算没有意义，
    此时返回时间占空比 × 相位漂移以外的结果会离谱，故调用方应改看 duty_z_theory_time。
    """
    t = z_duty(z_width, inter, div, z_index_pairs)
    if t is None or not f_in:
        return t
    return t * abs(float(f_in)) / FRAME_HZ


def ab_period_deg(inter, div=1):
    """一个 AB 正交周期对应的输入电角度（div 之后每个输出边沿步覆盖 div 个原始步）。"""
    return 360.0 * max(1, int(div)) / max(1, int(inter))


def edge_step_deg(inter, div=1):
    """相邻 AB 边沿之间的输入电角度（等效采样能分辨的最小角度）。"""
    return 360.0 * max(1, int(div)) / (4.0 * max(1, int(inter)))


# ---------------------------------------------------------------- 分析器


class AbzAnalyzer:
    """按输入电角度 / UVW 电角度分箱，累积六路电平的等效采样。"""

    def __init__(self, bins=BINS_DEFAULT, pairs=4, inter=32, div=1, z_width=4,
                 uvwpol=0, uvwdir=0, apol=0, bpol=0, zpol=0):
        self.bins = _clean_bins(bins)
        self.pairs = int(pairs) or 4
        self.inter = int(inter) or 32
        self.div = int(div) or 1
        self.z_width = int(z_width)
        self.uvwpol = int(uvwpol) & 1
        self.uvwdir = int(uvwdir) & 1
        self.apol = int(apol) & 1
        self.bpol = int(bpol) & 1
        self.zpol = int(zpol) & 1
        self.abzen = 1
        self.uwven = 1
        self.f_in = None          # 由界面喂进来，用于把“时间占空比”折算成“帧观测占空比”
        self.reset()

    # ------------------------------------------------------------ 配置
    def configure(self, **kw):
        """改配置；bins / pairs / inter / div 变了都要清空累积。

        ★ 2026-10-17 全面自查修：inter/div 决定"一个 A/B 周期占多少箱"
        （per_bins = bins*div/inter）。改了它，旧累积就与新口径混在一起
        （实测：同一份数据把 inter 从 32 改成 64，A→B 相位从 −90° 变成 −180°，
        还把 muddy/置信度拖坏）。面板的「清空累积」提示写的就是"改 inter/div 后
        会自动清空"，这里必须真的清。
        """
        dirty = False
        for k in ("bins", "pairs"):
            if k in kw and kw[k] is not None and int(kw[k]) != getattr(self, k):
                setattr(self, k, int(kw[k]))
                dirty = True
        for k in ("inter", "div"):
            if k in kw and kw[k] is not None:
                v = int(kw[k])
                # inter=0 在板上等价于 256（host/regs.decode_inter_div），但分析器里
                # 0 会让"每箱跨几个周期/相位换算"变成恒 0 —— 兜住下限（构造里也这么做）
                v = max(2, v) if k == "inter" else max(1, v)
                if v != getattr(self, k):
                    setattr(self, k, v)
                    dirty = True
        for k in ("z_width", "uvwpol", "uvwdir", "apol", "bpol", "zpol"):
            if k in kw and kw[k] is not None:
                setattr(self, k, int(kw[k]))
        if self.bins not in BINS_CHOICES:
            self.bins = min(BINS_CHOICES, key=lambda b: abs(b - self.bins))
            dirty = True
        if dirty:
            self.reset()

    def set_regs(self, regs):
        """从任务读回的寄存器字典里取本卡需要的配置（host/regs.decode_* 的产物）。"""
        if not regs:
            return
        kw = {}
        for key, name in (("inter", "inter"), ("div", "div"), ("pairs", "pairs"),
                          ("zwidth", "z_width")):
            if regs.get(key) is not None:
                kw[name] = regs[key]
        self.configure(**kw)

    def set_output(self, bits):
        """0x0109 的八位（host/regs.decode_output 的产物）。"""
        if not bits:
            return
        self.configure(apol=bits.get("apol", self.apol), bpol=bits.get("bpol", self.bpol),
                       zpol=bits.get("zpol", self.zpol), uvwpol=bits.get("uvwpol", self.uvwpol),
                       uvwdir=bits.get("uvwdir", self.uvwdir))
        self.abzen = int(bits.get("abzen", 1))
        self.uwven = int(bits.get("uwven", 0))

    def set_f_in(self, f_in):
        """输入电频率（Hz），只用于把稀疏脉冲的占空比期望折算成“帧观测口径”。"""
        try:
            self.f_in = abs(float(f_in)) if f_in is not None else None
        except (TypeError, ValueError):
            self.f_in = None

    # ------------------------------------------------------------ 累积
    def reset(self):
        n = self.bins
        self.n_ab = [0] * n
        self.hi_a = [0] * n
        self.hi_b = [0] * n
        self.hi_z = [0] * n
        self.n_uvw = [0] * n
        self.hi_u = [0] * n
        self.hi_v = [0] * n
        self.hi_w = [0] * n
        self.states = [0] * 8
        self.sectors = [0] * 6
        self.frames = 0
        self.clock = 0
        self.t_first = None
        self.t_last = None
        self.z_hits = 0
        self.z_edges = 0
        self._prev_z = None
        self.dir_true = 0
        self.dir_false = 0
        self.illegal = 0

    def feed(self, frames, t_now=None, n_bad=0, snapshot=True):
        """吃进若干帧（tools/uart_scope.parse_stream 的 frame dict）。

        snapshot=False 时只累积、不返回快照（面板自己按重画节奏算，省一次全量计算）；
        默认 True 保持"喂完就能拿到快照"的原语义。
        """
        if not frames:
            return self.snapshot(t_now) if snapshot else None
        bins = self.bins
        shift = ANG_MOD.bit_length() - 1          # 16
        pairs = self.pairs
        for f in frames:
            ang = int(f.get("angle") or 0) & 0xFFFF
            ib = f.get("io_bits") or {}
            st = int(f.get("io_state") or 0)

            def lvl(name, bit):
                v = ib.get(name)
                return int(v) & 1 if v is not None else ((st >> bit) & 1)

            a = lvl("a", 0)
            b = lvl("b", 1)
            z = lvl("z", 2)
            u = lvl("u", 3)
            v = lvl("v", 4)
            w = lvl("w", 5)

            bi = (ang * bins) >> shift
            self.n_ab[bi] += 1
            self.hi_a[bi] += a
            self.hi_b[bi] += b
            self.hi_z[bi] += z

            eang = (ang * pairs) & 0xFFFF
            ui = (eang * bins) >> shift
            self.n_uvw[ui] += 1
            self.hi_u[ui] += u
            self.hi_v[ui] += v
            self.hi_w[ui] += w

            s = state_of(u, v, w)
            self.states[s] += 1
            if s not in LEGAL_STATES:
                self.illegal += 1
            self.sectors[(eang * 6) >> shift] += 1

            if z:
                self.z_hits += 1
                if self._prev_z == 0:
                    self.z_edges += 1
            self._prev_z = z

            d = ib.get("dir")
            if d is None:
                d = (st >> 6) & 1
            if int(d) & 1:
                self.dir_true += 1
            else:
                self.dir_false += 1

            self.frames += 1
        self.clock += len(frames) + max(0, int(n_bad))
        if self.t_first is None:
            self.t_first = t_now
        self.t_last = t_now
        return self.snapshot(t_now) if snapshot else None

    # ------------------------------------------------------------ 汇总
    def _duty(self, hi, n):
        tot = sum(n)
        return (sum(hi) / float(tot)) if tot else None

    def _decide(self, hi, n, bins):
        """把"箱内平均电平"判成 0/1 方波（阶段 5 D 批：消掉被平均出来的阶梯）。

        阈值取 0.5（多数票）；空档只跨 SQ_GAP 个箱继续沿用，再长就断开（没数据的地方
        不画线）。返回的列表元素是 0/1 或 None。
        """
        out = []
        last = None
        gap = 0
        for i in range(bins):
            if n[i]:
                gap = 0
                last = 1 if (hi[i] / float(n[i])) >= 0.5 else 0
            else:
                gap += 1
                if gap > SQ_GAP:
                    last = None
            out.append(last)
        return out

    def _rising(self, hi, n, bins):
        """找上升沿所在箱（环形）：电平从 <0.5 穿到 >=0.5 的那个箱。返回箱号或 None。"""
        def m(i):
            return (hi[i] / float(n[i])) if n[i] else None
        vals = [m(i) for i in range(bins)]
        for i in range(bins):
            if vals[i] is None:
                continue
            j = (i - 1) % bins
            # ★ 上一箱没样本（None）时**不算**跳变：否则"整段没有 AB 跳变"的数据也会被
            #   判出上升沿，相位差被凭空造出来（真踩过：单帧 A=B=0 也报相位差 0.00°）
            if vals[j] is not None and vals[i] >= 0.5 > vals[j]:
                return i
        return None
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
