zhaoyunfengntzx-maker/fpga-smr-encoder/host/alarm.py

r"""输入信号、幅值与告警的纯逻辑（无 Qt、无串口，可离线自检）。

★ 文件名为什么叫 `alarm.py`（原来叫 `signal.py`，2026-10-13 改）：
  模块名叫 `signal` 会**遮蔽标准库 `signal`** —— 源码模式下靠 `app.py` 把 `host/`
  插到 `sys.path[0]` 才碰巧对；而打包成 exe 后 PyInstaller 的 PYZ 里同名模块只能有
  一份，**标准库赢**，于是 exe 启动就崩：
  `panel_alarm.py:66 AttributeError: module 'signal' has no attribute 'ALARM_ROWS'`
  （实测：`host\_exe_work\host_exe\PYZ-00.pyz` 里的 `signal` 是标准库，含
  `valid_signals`、不含 `ALARM_ROWS`）。改名为 `alarm` 后源码与 exe 都不再有这个碰撞。

用途：需求 M4（s_n/c_n 时域波形、李萨如圆、幅值/OTR）与 M7（告警中文+颜色）。

板上口径（依据 RTL / 文档，不是猜的）：
  * `amp_sq = s_n^2 + c_n^2`，Q2.30 无符号；s_n/c_n 是 Q1.15 有符号
    （rtl/amp_monitor.v:5、:107 每拍随乘积寄存器更新、:30 饱和不回绕）
  * 幅值门限 `0x0520-23 AMP_LOW_SQ` 复位值 `0x170A3D71` = (0.60)^2 * 2^30、
    `0x0524-27 AMP_HIGH_SQ` 复位值 `0x5C28F5C3` = (1.20)^2 * 2^30
    （rtl/reg_file.v:315-316；写译码 :399-406、读译码 :510-521 都是小端逐字节）
  * 实测值 `0x0530-33 STAT_AMP_SQ`（rtl/enc_top.v:946 接 amp_monitor 的 amp_sq）
  * 遥测帧的 io_state / io_flags / stat 位义：tools/uart_scope.py:97-102
  * `0x0404 STAT_VAL` / `0x0405 STAT_LATCH`（W1C，写 1 清）位义：
    bit0 oflow(otr) / bit2 laglim / bit3 inclim / bit4 lagfatl / bit5 scamp
    （rtl/enc_top.v:748-757 的 stat_byte；写 0x0405 的 bit0 同时发 1 拍 clr_otr 清 ADC sticky）
  * `0x053A STAT_FLAGS`：bit0 laglim / bit1 amplo / bit2 amphi / bit3 otr /
    bit4 caldone / bit5 calbusy / bit6 crcerr / bit7 biss frame_active
    （rtl/reg_file.v:510-512 附近的读译码与 docs/01_technical_solution.md:635）

★ 读应答的字节约定（实测 + 已验证）：16 位响应 = {寄存器[addr+1], 寄存器[addr]}
  ⇒ 读 `0x0404` 一次就能同时拿到 STAT_VAL（低字节）与 STAT_LATCH（高字节）；
     读 `0x053A` 一次拿到 STAT_FLAGS（低字节）与 `0x053B`（高字节）。
"""

from __future__ import annotations

import math

# ---------------------------------------------------------------- 常量与换算

FS = 32768.0                # Q1.15 的 1.0（满量程）
CLIP_LEVEL = 32760          # |s| 或 |c| 到这儿就算顶到轨（真实满码 32767）

REG_STAT_VAL = 0x0404       # 读它可同时得到 0x0405（高字节）
REG_STAT_LATCH = 0x0405
REG_STAT_FLAGS = 0x053A     # 读它可同时得到 0x053B（高字节）
REG_AMP_LOW_SQ = 0x0520     # 32 位小端：0x0520/0x0521 与 0x0522/0x0523
REG_AMP_HIGH_SQ = 0x0524
REG_STAT_AMP_SQ = 0x0530
# 写 0x0405 = 0x00FF：把所有锁存位清掉（bit0 还发 clr_otr 脉冲）
# ★ 为什么不用更窄的掩码（例如只写实际会被锁存的 b0/b2/b3/b5 = 0x2D）：
#   rtl/reg_file.v:412-413 是**整字节 W1C**，对永不置位的 b1/b4/b6/b7 写 1 无副作用；
#   反过来，若将来 RTL 把 b4（lagfatl，现在 rtl/reg_file.v:248-249 恒接 0）接出来，
#   窄掩码就清不掉它了 ⇒ 写全 1 更稳。审计提出过收窄，这里**决定不收窄**。
LATCH_CLEAR_VALUE = 0x00FF

# 0x0405 / 0x0404 的位（0x0404 = 实时，0x0405 = 锁存）
VAL_BITS = ((0, "oflow", "输出溢出（cor_sat | ADC 过载锁存）"),
            (2, "laglim", "滞后限频已激活"),
            (3, "inclim", "AB 限频 或 UVW 基波超限"),
            (4, "lagfatl", "相位滞后致命（≥180°）"),
            (5, "scamp", "幅值越限（amp_low | amp_high）"))

# 0x053A STAT_FLAGS 的位
FLAG_BITS = ((0, "laglim", "滞后限频"),
             (1, "amplo", "幅值偏低"),
             (2, "amphi", "幅值偏高"),
             (3, "otr", "ADC 过载锁存（sticky）"),
             (4, "caldone", "标定完成"),
             (5, "calbusy", "标定进行中"),
             (6, "crcerr", "BiSS CRC 错误"),
             (7, "biss_active", "BiSS 帧进行中"))


def amp_sq_of(s: int, c: int) -> int:
    """上位机自己算 amp_sq：与板上 amp_monitor 逐位相同（s²+c² 不会饱和）。"""
    return (int(s) * int(s) + int(c) * int(c)) & 0xFFFFFFFF
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
