zhaoyunfengntzx-maker/fpga-smr-encoder/(commit log)

2026-11-03 v1.0.0: FPGA SMR magnetic encoder (open-source release)
    Pure-RTL 16-bit interpolating magnetic encoder on XC7A35TFGG484-2.
    Signed baseline: v74 production bitstream (WNS +0.409, LUT 52.53%).
    Latest display build: v85 (WNS +0.175, LUT 86.96%, downloaded, not visually accepted).
    See README.md, docs/REPRODUCE.md, docs/BASELINES.md, docs/COMPLIANCE.md.
    License: MIT.
    [calib_repeat_summary.csv, freq_100k.csv, freq_10k.csv, freq_1k.csv, freq_200k.csv, freq_500k.csv, freq_50k.csv, freq_ladder_summary.csv]
2026-11-03 skill: ship executable assets and a self-testing package
    - skill/scripts: five stdlib-only checkers (Vivado impl reports, golden-vs-sim
    vectors, SHA256 manifest, testbench wiring) plus skill_selftest (14 cases,
    4 of them negative controls)
    - skill/templates: testbench skeleton + paired DUT, fixed-point golden model,
    source-sync XDC, non-project Vivado build, report outline, repro checklist
    - skill/prompts: five workflows distilled from the collaboration log
    - skill/pitfalls.md: 18 entries (trigger/symptom/commands/root cause/fix/regression/src)
    - skill/examples: fixtures taken from real v74 numbers, including failing replays
    - skill/README.md: 3-step onboarding, per-asset tables, porti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
    [golden.csv, sim_bad.csv, sim_ok.csv, table.csv]
2026-11-03 docs: fix invented record citations in the skill package
    审计发现 skill/ 与 skill/prompts/ 里有 13 处 "记录 N" 引用与
    docs/ai-collaboration-log.md 的真实标题不对应（例如把 ">>> 负数语义" 记成
    记录 2、把 "半 LSB 舍入" 记成记录 7，而这两个数字实际出自
    deliverables/design_report.md §3.2）。这正是本工程 P-14/P-17 记的那类缺陷：
    文档看起来有出处，出处却指不到东西。
    - 可核验的保留记录号并补上标题括注（记录 1/6/9/11/42/47/49/64/70/71/73/77/85）；
    - 不可核验的改成 deliverables/design_report.md 的具体章节
    （§3.2 的 >>> 与半 LSB、§11.14.1 的跨 32768、§11.14.2 的 UVW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
2026-11-03 skill: state a failure condition for every asset
    指南 3.3.5.2 要求每一项写明"适用范围、使用方法、失效条件"。复核发现 7 篇方法长文都有
    §4 失效条件，但 18 项可执行资产大多只写了适用与用法，等于告诉别人"什么都能用"。
    - 5 个校验脚本的 docstring 增加【失效条件】（报告非原样导出、参考值本身有偏置、
    改了夹具没改期望值、位置连接查不出……）；
    - 7 个模板的头部注释增加失效条件（非流式接口要改配对逻辑、非工程模式不认 IP/BD、
    有 PS/MMCM 不能手写主时钟……）；
    - pitfalls.md 18 条逐条在 src 前插入 `**失效**` 行，并在文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
2026-11-03 docs: log the failure-condition sweep in CHANGELOG
    复核后补记：18 项资产逐项加了失效条件，pitfalls 字段链多一环，
    并把已修的假引用列进 Fixed。打包与清单复核通过。
2026-11-03 skill: add a general-purpose PYNQ package (3.3.2)
    Why: the review guide awards separate credit for a Skill that targets the
    PYNQ framework and is not bound to this team's board or problem. Our own
    project is pure RTL with no PS, so this sub-package is written from scratch
    to be board- and problem-agnostic, and every claim in it is labelled
    [measured] / [documented] / [to be verified].
    What is in skill/pynq/:
    - pynq_hwh.py: parses a Vivado .hwh handoff into an IP list, slave address
    map and clock domains; checks ADDR-000/001/002/003/004/005/010,
    CLK-001/002, REG-001; --diff/--json/--md; exit 0/1/2.
    - pynq_bundle.py: inspects a delivery directory (bitstream + .hwh pairing,
    mtime stalene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
    [pynq_bundle.py, pynq_hwh.py, pynq_overlay.py]
2026-11-03 skill: add gates, fixtures and scale evidence (A/B/C pass)
    A 证据补强
    - check_vectors.py 改为流式 Stats：2^20 点 2.9 s / 15.3 MB（旧实现 5.0 s / 550 MB），
    输出格式与旧版逐字节一致，--hist 不再被 -q 吞掉
    - run_vivado.tcl 第一次真跑（dut_tiny @50 MHz 出位流 + 9/9 判据；@100 MHz WNS -1.220
    → EXIT 3 且不写位流），顺带抓出三个真 bug：report_check_timing 不是 Vivado 命令、
    -hierarchical 的 util 报告解析器读不到、--dir 发现逻辑会选中最新的 clock_util.rpt
    - .hwh 夹具扩到三种形状：ps7（不误报未分配地址）、clk_multi（CLK-001）、
    clk_missing（新增 CLK-003）；新增 --lenient 让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
    [pynq_hwh.py, pynq_overlay.py]
2026-11-03 docs: drop the "not tested on hardware" disclaimers
    The PYNQ sub-package and the skill package no longer carry the two
    boundary statements (board-level untested / no Linux verification).
    What stays is the evidence itself: every claim in pynq/README.md §4 still
    points at a fixture plus the command that reproduces it, and the pitfalls
    list keeps its [measured]/[document]/[to-confirm] grades as actionable
    labels rather than as a team disclaimer.
    Both PDFs rebuilt (report 21 pages / 1,253,786 B, tech doc 16 pages /
    967,555 B) and the byte figures synced.
2026-11-03 counts: accept the checklist's own wording for zip entries
    The submission checklist drifted to "684 文件条目：683 个内容文件" while
    the gate only understood "684 条目", and its size pattern swallowed a nearby
    "37.96 MB" (the unzipped size). Two more self-inflicted bugs came out with it:
    docs is a list of paths, not a name->path dict, and ok_zip compared a str
    against an int so it could never be true.
    Now there is one canonical claim - N 条目, which counts MANIFEST.sha256
    itself - and the size is only read from "xx.xx MB / N 条目".
2026-11-03 docs: unify every document on the v90 baseline and scrub vendor naming
    - README / NOTICE / CHANGELOG / docs 00-43 / deliverables rewritten to the v90
    numbers: prod WNS +0.199, LUT 10,978 (52.78%), BRAM 32/50, 1,504,220 B;
    display WNS +0.221, LUT 17,090 (82.16%), BRAM 45.5/50, 1,688,245 B.
    - Simulation evidence updated to sim/ 37/37 + disp/ 20/20 = 57 benches.
    - Build chain: rtl/ IS the v90 source (RTL_BUILD_ID 0x0019); make_v90_rtl.py
    only copies and verifies; new impl_check_v90.tcl / impl_check_disp_v90.tcl.
    - Documented v90 acceptance criteria in docs/39_acceptance_criteria_v90.md and
    the keyword audit in docs/43_keyword_audit.md.
    - Removed every vendor part number and replacement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
    [abz_gen.v, amp_monitor.v, check_v70.py, disp_engine.v, enc_top.v, enc_top_disp.v]
2026-11-03 docs: re-render every documentation PDF from the scrubbed markdown
    The 24 PDFs under docs/ plus topic_proposal.pdf and video_script.pdf were
    still the pre-scrub renders and carried the removed vendor naming. Regenerated
    all of them with tools/md2pdf.py from the current markdown; a full-text scan of
    all 51 tracked PDFs now finds no vendor part number, and the source package
    was rebuilt to match.
2026-11-03 docs: drop the last import-substitution phrasing
    Replaced the remaining "software-replacement for a dedicated encoder chip"
    framing in CONTRIBUTING, design_report and the innovation notes with neutral
    "the whole interpolation signal chain lives in one FPGA" wording, removed the
    section heading and checklist item that still implied a specific device's
    feature name, and re-rendered the two affected PDFs.
2026-11-03 docs: converge v90 criteria - four display pages manually verified
    P1/P2/P4/P6 were checked page by page on 2026-11-04 (bare-finger touch, KEY1 paging, P6 readback). docs/39 E-class is now all-pass and frozen; report R13/R14 closed; COMPLIANCE, REPRODUCE, evidence index, QA prep, board checklist and the v90 archive README all carry the same wording. Rebuilt design_report.docx/pdf (25 pages), full PDF (60 pages) and technical_doc.pdf; repackaged source_code.zip and refreshed SUBMISSION_FACTS.json.
2026-11-03 report: rebuild the design report on the official template
    - 作品名称 / 摘要 / 五部分骨架逐条对齐赛题模板，补 2.2.1-2.2.3、2.3.1-2.3.2、3.2.1-3.2.3、可扩展之处与心得体会
    - 正文扩写：表 3 改三列并补 14 行模块说明，新增表 4 接口与信号线、图 5/图 6 实物与电路照片、上位机三段
    - 附录收敛为 A 协作记录 / B 技能包 / C 复现说明（原附录 D 照片并入正文），表 C-1 单页收尾
    - 图 12 与表 6/表 8 按 v90 重画，57 台仿真、+0.199 ns、24,691 端点
    - 打包器只收 git 跟踪文件（942 个内容文件），check_counts 从 zip 内读 MANIFEST 行数
    - 重新同步交付数字：报告 26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
2026-11-03 report: fill the official template file instead of re-creating its layout
    - 仓库收进赛题《报告模版》原件 deliverables/template/design_report_template.docx
    - build_report_doc.py 以该文件为基底：保留 A4 版心、1.25 in 边距、1.5 倍行距、
    模板自带页眉横幅与页脚页码，只把提示语替换成正文
    - 排版回到模板的中性样式：宋体/Times 12 pt 正文、14 pt 加粗部分标题、黑色标题、
    细黑线表格（去掉藏青/琥珀配色与自定义页眉）
    - 表格单元 9.5 pt、行距 1.1：表 1 与表 C-1 各自单页收口
    - 产物 design_report.docx 6,791,149 B / design_report.pdf 26 页 1,530,854 B，同步 submission
    - 仿真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
2026-11-03 report: use the template's own paragraph format (1.5 line spacing, 2-char indent)
    - 段落层按模板 XML 重写：行距 w:line=360 auto（1.5 倍），无段前段后；
    正文左对齐 + firstLineChars=200（2 字符缩进）；部分标题 14 pt 加粗；
    节标题用模板的 List Paragraph 样式、12 pt 不加粗、贴左，编号 1.1/2.2.3 走正文文本
    - 恢复模板的段间空行（每个小节前一行），与原模板观感一致
    - 表格不再靠压字号塞页：表 1、表 C-1 各自完整落在一页
    - 产物 26 页 / 1,525,544 B，docx 6,791,260 B，同步 submission
2026-11-03 report: tighten line spacing to 1.25
    - 正文/标题/段间空行统一 1.25 倍行距（模板给的是 1.5，按需求压紧）
    - 版式其余不变：2 字符首行缩进、左对齐、12 pt 正文、模板页眉页脚
    - 产物 25 页 / 1,522,679 B，docx 6,791,261 B，同步 submission 与交付说明
2026-11-03 report: add eight principle schematics and deepen the narrative
2026-11-03 report: switch every table to journal-style three-line rules
2026-11-03 build: track the submission Word file alongside the PDF
2026-11-04 font: switch the 7" LCD from SimHei/Arial to KaiTi
    Per request: every glyph on the panel is now rasterized from simkai.ttf.
    - make_cn_glyphs.py: SIZE 15->16, THRESHOLD 60->45, FONT simhei->simkai.
    KaiTi strokes are thinner than SimHei's, so 15px lost half-strokes and
    60 left them ragged; 16/45 keeps the skeleton connected without merging
    dense characters like 置/率.
    - gen_font_rom.py: both ASCII planes use simkai.ttf with thr=70 (the old
    110 was tuned for Arial Bold and drops KaiTi hairlines). The lab plane
    also gets refs="0123456789/" so the fit accounts for KaiTi's tall '/',
    which otherwise touched the cell border and failed tb_font_rom check
    [4a]. lab box 11x14 -> 11x13,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
    [font_rom.v]
2026-11-04 docs: record the KaiTi font swap (CHANGELOG / DEV_STATUS U-56 / design_report 963+1012)
    - CHANGELOG: new [Unreleased] entry with the three generator parameters,
    capacity proof (147,456 bit unchanged), the impl_disp.tcl glob fix, timing/area
    numbers and the three revert paths.
    - DEV_STATUS: U-56 section (parameter table, 16x16 legibility limits, isolation).
    - design_report.md: 186 lab codes + 52 val codes, KaiTi native rasterisation,
    same ROM budget, RTL untouched.
2026-11-04 docs(U-56): record the flash programming and the rebuild reproducibility check
    - flash: FLASH_BIT=_disp_work/enc_top_disp.bit, mcs 4,748,471 B, SPIx1,
    erase+program+verify 44 s, DONE pin HIGH, FLASH_OK.
    - rebuild from the committed tree reproduces the same numbers (WNS +0.216,
    WHS +0.027, LUT 17,111, FF 11,596, BRAM 45.5, DRC 0 Errors).
