zhaoyunfengntzx-maker/fpga-smr-encoder/deliverables/submission/photos/04_board_screen.jpg

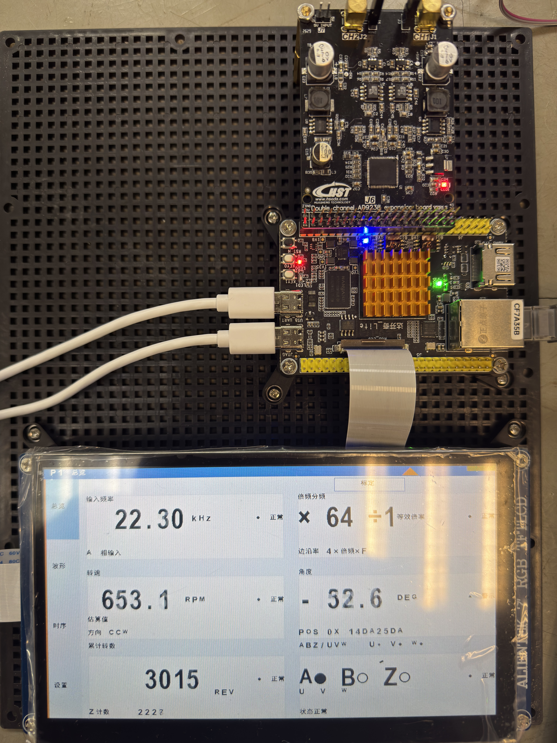
deliverables/submission/photos/04_board_screen.jpg
